skdzicombd/P_252_Documentation/Specifications/Datasheet Submitted to Client/252-0201-EMEL-CL00-0001 CABLE SCHEDULE/CABLE SCHEDULE P-252-J/P-252-J CABLE SCHEDULE 10.11.15.xlsx

Sheet: COVER
 |  |  |  |  |  | CONSORTIUM OF
 |  |  |  |  |  | SINOPEC PETROLEUM ENGINEERING CORPORATION.
 |  |  |  |  |  | AND
 |  |  |  |  |  | ZICOM EQUIPMENT PTE. LTD.
BANGLADESH GAS FIELDS COMPANY LIMITED
 |  |  |  |  |  | 29 Tuas Avenue 3 Singapore 639420 |  |  |  | Tel | : +65 6865 1765
 |  |  |  |  |  | E-mail | : zepl@zicomgroup.com |  |  | Fax | : +65 6865 1764
POWER CABLE SCHEDULE
 |  |  |  |  |  |  |  | Doc. No: | 252-0201-EMEL-CL00-0001
 |  | Job No. |  | : | 252 - J
 |  | Client |  | : | BANGLADESH GAS FIELDS COMPANY LIMITED
 |  | Location |  | : | TITAS GAS FIELD, BRAHMANBARIA, BANGLADESH
 |  | Item No. |  | :
 |  | Description |  | :
 |  | Project Title. |  | : | 2 X 75 MMSCFD GLYCOL DEHYDRATION TYPE GAS PROCESS PLANT
 |  | Year Built |  | : | 2015
A | 2015.10.28 |  |  | ISSUED FOR APPROVAL |  |  |  |  |  | AS | MH | VG
Rev. | Date |  | Page | Description |  |  |  |  |  | Prepared | Checked | Approved

Sheet: Power Cable Schedule
 |  |  |  |  | Power Cable Schedule
USER |  |  | BANGLADESH GAS FIELDS COMPANY LIMITED |  |  |  | DOC NO. : | 252-0201-EMEL-CL00-0001 |  |  |  | Rev : A
LOCATION |  |  | TITAS GAS FIELD, BRAHMANBARIA, BANGLADESH |  |  |  | SERVICE :
PROJECT |  |  | 2 X 75 MMSCFD GLYCOL DEHYDRATION TYPE GAS PROCESS PLANT |  |  |  | TAG NO. : | N/A
JOB NO. |  |  | 252 - J |  |  |  | QUANTITY: | N/A
Sl.No | TAG NO. | DISCRIPTION |  |  | SOURCE | DESTINATION | CABLE SIZE (sqmm) | CABLE LENGTH (Meter) | CABLE VOLTAGE | Power Factor (p.f) | CABLE TYPE | CONDUCTOR | LOAD
1 | G-01 | GENERATOR 01 |  |  | G1 | MCC | 8 (1C X 150mm2) | 220 | 600V | 0.85 | PVC ARMOURED | COPPER | 276 KW
2 | G-02 | GENERATOR 02 |  |  | G2 | MCC | 8 (1C X 150mm2) | 300 | 600V | 0.85 | PVC ARMOURED | COPPER | 276 KW
3 |  | NATIONAL GRID LINE |  |  | GRID LINE | MCC | 4C X 95mm2 | 90 | 600V | 0.85 | PVC ARMOURED | COPPER
4 | P-300A-J | CONDENSATE TRANSFER PUMP |  |  | MCC | P-300A-J | 4C X 4mm2 | 200 | 600V | 0.85 | PVC ARMOURED | COPPER | 11 KW
5 | P-300B-J | CONDENSATE TRANSFER PUMP |  |  | MCC | P-300B-J | 4C X 4mm2 | 200 | 600V | 0.85 | PVC ARMOURED | COPPER
6 | P-300A-J-LCS | CONDENSATE TRANSFER PUMP-LCS |  |  | MCC | P-300A-J-LCS | 12CX1.5mm2 | 200 | 600V | 0.85 | PVC ARMOURED | COPPER
7 | P-300B-J-LCS | CONDENSATE TRANSFER PUMP-LCS |  |  | MCC | P-300B-J-LCS | 12CX1.5mm2 | 200 | 600V | 0.85 | PVC ARMOURED | COPPER
8 | P-200A-J | CONDENSATE RECYCLE PUMP |  |  | MCC | P-200A-J | 4CX 2.5mm2 | 220 | 600V | 0.85 | PVC ARMOURED | COPPER | 1.5 KW
9 | P-200B-J | CONDENSATE RECYCLE PUMP |  |  | MCC | P-200B-J | 4CX 2.5mm2 | 220 | 600V | 0.85 | PVC ARMOURED | COPPER
10 | P-200A-J-LCS | CONDENSATE RECYCLE PUMP-LCS |  |  | MCC | P-200A-J | 12CX1.5mm2 | 220 | 600V | 0.85 | PVC ARMOURED | COPPER
11 | P-200B-J-LCS | CONDENSATE RECYCLE PUMP-LCS |  |  | MCC | P-200B-J | 12CX1.5mm2 | 220 | 600V | 0.85 | PVC ARMOURED | COPPER
12 | AC-100A-J | INLET AIR COOLER |  |  | MCC | AC-100A-J | 4C X10mm2 | 120 | 600V | 0.85 | PVC ARMOURED | COPPER | 15 KW
13 | AC-100B-J | INLET AIR COOLER |  |  | MCC | AC-100B-J | 4C X10mm2 | 120 | 600V | 0.85 | PVC ARMOURED | COPPER
14 | AC-100A-J-LCS | INLET AIR COOLER-LCS |  |  | MCC | AC-100A-J-LCS | 12CX1.5mm2 | 120 | 600V | 0.85 | PVC ARMOURED | COPPER
15 | AC-100B-J-LCS | INLET AIR COOLER-LCS |  |  | MCC | AC-100B-J-LCS | 12CX1.5mm2 | 120 | 600V | 0.85 | PVC ARMOURED | COPPER
16 | E-300-J | OVERHEAD GAS COOLER |  |  | MCC | E-300-J | 4CX 2.5mm2 | 120 | 600V | 0.85 | PVC ARMOURED | COPPER | 3 KW
17 | E-300-J-LCS | OVERHEAD GAS COOLER-LCS |  |  | MCC | E-300-J-LCS | 12CX1.5mm2 | 120 | 600V | 0.85 | PVC ARMOURED | COPPER
18 | P-400-J | KOD PUMP |  |  | MCC | P-400-J | 4CX 2.5mm2 | 320 | 600V | 0.85 | PVC ARMOURED | COPPER | 1.1 KW
19 | P-400-J-LCS | KOD PUMP-LCS |  |  | MCC | P-400-J-LCS | 12CX1.5mm2 | 320 | 600V | 0.85 | PVC ARMOURED | COPPER
20 | P-700-J | DEEP WELL PUMP |  |  | MCC | P-700-J | 4C X 4mm2 | 240 | 600V | 0.85 | PVC ARMOURED | COPPER | 7.5 KW
21 | P-700-J-LCS | DEEP WELL PUMP -LCS |  |  | MCC | P-700-J-LCS | 12CX1.5mm2 | 240 | 600V | 0.85 | PVC ARMOURED | COPPER
22 | P-700-J | PUMP TO CONTROL PANEL(Flat Cable) |  |  | PUMP CONTROL PANEL | PUMP | 2 (3C x 4 mm2) | 500 | 600V | 0.85 | PVC ARMOURED | COPPER
23 | P-800-J | DEEP WELL PUMP |  |  | MCC | P-800-J | 4C X 4mm2 | 240 | 600V | 0.85 | PVC ARMOURED | COPPER | 7.5 KW
24 | P-800-J-LCS | DEEP WELL PUMP -LCS |  |  | MCC | P-800-J-LCS | 12CX1.5mm2 | 240 | 600V | 0.85 | PVC ARMOURED | COPPER
25 | P-800-J | PUMP TO CONTROL PANEL(Flat Cable) |  |  | PUMP CONTROL PANEL | PUMP | 2 (3C x 4 mm2) | 500 | 600V | 0.85 | PVC ARMOURED | COPPER
26 | P-500A-J | ELECTRIC FIRE WATER PUMP |  |  | MCC | P-500A-J | 4C X 185mm2 | 220 | 600V | 0.85 | PVC ARMOURED | COPPER | 134 KW
27 | P-500A-J-LCS | ELECTRIC FIRE WATER PUMP-LCS |  |  | MCC | P-500A-J-LCS | 12CX1.5mm2 | 220 | 600V | 0.85 | PVC ARMOURED | COPPER
28 | P-500B-J | CONTROL PANEL DIESEL FIRE PUMP |  |  | MCC | P-500B-J | 4CX 2.5mm2 | 220 | 600V | 0.85 | PVC ARMOURED | COPPER | 0.5 KW
29 | P-600-J | JOCKEY PUMP CONTROL PANEL |  |  | MCC | P-600-J | 4CX 6mm2 | 220 | 600V | 0.85 | PVC ARMOURED | COPPER | 11 KW
30 | G-1201-P-J | GENERATOR-1 COOLING TOWER PUMP |  |  | MCC | G-1201-P-J | 4CX 4mm2 | 30 | 600V | 0.85 | PVC ARMOURED | COPPER | 5.5 KW
31 | G-1201-P-J-LCS | GENERATOR-1 COOLING TOWER PUMP-LCS |  |  | MCC | G-1201-P-J-LCS | 12CX1.5mm2 | 20 | 600V | 0.85 | PVC ARMOURED | COPPER
32 | G-1201-F-J | GENERATOR-1 COOLING TOWER FAN |  |  | MCC | G-1201-F-J | 4CX 4mm2 | 35 | 600V | 0.85 | PVC ARMOURED | COPPER | 5.5 KW
33 | G-1201-F-J-LCS | GENERATOR-1 COOLING TOWER FAN-LCS |  |  | MCC | G-1201-F-J-LCS | 12CX1.5mm2 | 20 | 600V | 0.85 | PVC ARMOURED | COPPER
34 | G-1202-P-J | GENERATOR-2 COOLING TOWER PUMP |  |  | MCC | G-1202-P-J | 4CX 4mm2 | 30 | 600V | 0.85 | PVC ARMOURED | COPPER | 5.5 KW
35 | G-1202-P-J-LCS | GENERATOR-2 COOLING TOWER PUMP-LCS |  |  | MCC | G-1202-P-J-LCS | 12CX1.5mm2 | 20 | 600V | 0.85 | PVC ARMOURED | COPPER
36 | G-1202-F-J | GENERATOR-2 COOLING TOWER FAN |  |  | MCC | G-1202-F-J | 4CX 4mm2 | 35 | 600V | 0.85 | PVC ARMOURED | COPPER | 5.5 KW
37 | G-1202-F-J-LCS | GENERATOR-2 COOLING TOWER FAN-LCS |  |  | MCC | G-1202-F-J-LCS | 12CX1.5mm2 | 20 | 600V | 0.85 | PVC ARMOURED | COPPER
38 |  | GENERATOR BATTERY CHARGER |  |  | MCC | BATT CHARGER | 3CX 2.5mm2 | 30 | 600V | 0.85 | PVC ARMOURED | COPPER
39 |  | UTILITY POWER OPERATION BUILDING |  |  | MCC | UTILITY POWER OPERATION BUILDING | 4CX 16mm2 | 90 | 600V | 0.85 | PVC ARMOURED | COPPER | 22 KW
40 |  | UTILITY POWER WORKSHOP BUILDING |  |  | MCC | UTILITY POWER WORKSHOP BUILDING | 4CX 6mm2 | 90 | 600V | 0.85 | PVC ARMOURED | COPPER | 10 KW
41 |  | UTILITY POWER GENERATOR BUILDING |  |  | MCC | UTILITY POWER GENERATOR BUILDING | 4CX 10mm2 | 30 | 600V | 0.85 | PVC ARMOURED | COPPER | 15 KW
42 | LCP-0701-J | FLARE & BURN PIT CONTROL PANEL |  |  | MCC | CONTROL PANEL | 4CX 2.5mm2 | 300 | 600V | 0.85 | PVC ARMOURED | COPPER | 3 KW
43 |  | FLARE PANEL |  |  | CONTROL PANEL | FLARE PANEL | 3CX 2.5mm2 | 40 | 600V | 0.85 | PVC ARMOURED | COPPER
44 |  | BURN PIT PANEL |  |  | CONTROL PANEL | BURN PIT PANEL | 3CX 2.5mm2 | 60 | 600V | 0.85 | PVC ARMOURED | COPPER
45 | LDP-1401-J | LIGHTING DISTRIBUTION PANEL |  |  | MCC | LIGHT PANEL | 5CX 10mm2 | 20 | 600V | 0.85 | PVC ARMOURED | COPPER | 15 KW
46 |  | TOWER LIGHT-1 (3 No. 200W light each pole) |  |  | LIGHT PANEL | TOWER LIGHT-1 | 3CX 2.5mm2 | 140 | 600V | 0.85 | PVC ARMOURED | COPPER | 0.6KW
47 |  | TOWER LIGHT-2 (3 No. 200W light each pole) |  |  | LIGHT PANEL | TOWER LIGHT-2 | 3CX 2.5mm2 | 90 | 600V | 0.85 | PVC ARMOURED | COPPER | 0.6KW
48 |  | TOWER LIGHT-3 (3 No. 200W light each pole) |  |  | LIGHT PANEL | TOWER LIGHT-3 | 3CX 2.5mm2 | 30 | 600V | 0.85 | PVC ARMOURED | COPPER | 0.6KW
49 |  | TOWER LIGHT-4 (3 No. 200W light each pole) |  |  | LIGHT PANEL | TOWER LIGHT-4 | 3CX 2.5mm2 | 120 | 600V | 0.85 | PVC ARMOURED | COPPER | 0.6KW
50 |  | TOWER LIGHT-5 (3 No. 200W light each pole) |  |  | LIGHT PANEL | TOWER LIGHT-5 | 3CX 2.5mm2 | 300 | 600V | 0.85 | PVC ARMOURED | COPPER | 0.6KW
51 |  | TOWER LIGHT-6 (3 No. 200W light each pole) |  |  | LIGHT PANEL | TOWER LIGHT-6 | 3CX 2.5mm2 | 260 | 600V | 0.85 | PVC ARMOURED | COPPER | 0.6KW
52 |  | PIPE RACK LIGHT-1 (8 No. 100W light) |  |  | LIGHT PANEL | PIPE RACK LIGHT-1 | 3CX 2.5mm2 | 280 | 600V | 0.85 | PVC ARMOURED | COPPER | 0.8KW
53 |  | PIPE RACK LIGHT-2 (8 No. 100W light) |  |  | LIGHT PANEL | PIPE RACK LIGHT-2 | 3CX 2.5mm2 | 280 | 600V | 0.85 | PVC ARMOURED | COPPER | 0.8KW
54 |  | TRANSFER PUMP SHED LIGHT (36W) |  |  | LIGHT PANEL | TRANSFER PUMP SHED LIGHT | 3CX 2.5mm2 | 240 | 600V | 0.85 | PVC ARMOURED | COPPER | 0.036 KW
55 |  | DELUGE VALVE & FOAM TANK (2 No.36W each light) |  |  | LIGHT PANEL | DELUGE VALVE & FOAM TANK | 3CX 2.5mm2 | 260 | 600V | 0.85 | PVC ARMOURED | COPPER | 0.072 KW
56 |  | TEG TOWER LIGHT (2 No. 100W light) |  |  | PIPE RACK LIGHT-2 | TEG TOWER | 3CX 2.5mm2 | 20 | 600V | 0.85 | PVC ARMOURED | COPPER | 0.2 KW
57 |  | AIR-CRAFT WARNING LIGHT(50W) |  |  | LIGHT PANEL | AIR-CRAFT WARNING LIGHT | 3CX 2.5mm2 | 420 | 600V | 0.85 | PVC ARMOURED | COPPER | 0.05 KW
58 |  | LOADING AREA SHED LIGHT (2 No. 200W each light) |  |  | LIGHT PANEL | LOADING AREA SHED LIGHT | 3CX 2.5mm2 | 70 | 600V | 0.85 | PVC ARMOURED | COPPER | 0.4KW
59 | R-100-J | GLYCOL REBOILER |  |  | MCC | GLYCOL REBOILER | 4CX 2.5mm2 | 140 | 600V | 0.85 | PVC ARMOURED | COPPER | 5 KW
60 | H-100-J | WATER BATH HEATER |  |  | MCC | WBH PANEL | 4CX 2.5mm2 | 140 | 600V | 0.85 | PVC ARMOURED | COPPER | 6 KW
61 | 02-UPS-1201-J | UPS SYSTEM 1 |  |  | MCC | UPS-1 | 3CX 4mm2 | 70 | 600V | 0.85 | PVC ARMOURED | COPPER | 6 KVA
62 | 02-UPS-1202-J | UPS SYSTEM 2 |  |  | MCC | UPS-2 | 3CX 4mm2 | 70 | 600V | 0.85 | PVC ARMOURED | COPPER | 6 KVA
63 | 02-UPS-1201 & 2-J | UPS-1&2-DB |  |  | UPS-1&2 | UPS-1&2-DB | 3CX 4mm2 | 10 | 600V | 0.85 | PVC ARMOURED | COPPER
64 |  | DCS PANEL |  |  | UPS-1&2-DB | DCS PANEL | 3CX 2.5mm2 | 30 | 600V | 0.85 | PVC ARMOURED | COPPER | 0.4KW
65 |  | ENGINEERING STATION |  |  | UPS-1&2-DB | ENG STATION | 3CX 2.5mm2 | 40 | 600V | 0.85 | PVC ARMOURED | COPPER | 0.4KW
66 |  | OPERATOR STATION |  |  | UPS-1&2-DB | OP STATION | 3CX 2.5mm2 | 40 | 600V | 0.85 | PVC ARMOURED | COPPER | 0.4KW
67 |  | MCC I/O RIO-001 |  |  | UPS-1&2-DB | MCC ROOM, | 3CX 2.5mm2 | 70 | 600V | 0.85 | PVC ARMOURED | COPPER | 0.25KW
68 |  | PLANT MIMIC PANEL |  |  | UPS-1&2-DB | PLANT MIMIC BOARD | 3CX 2.5mm2 | 50 | 600V | 0.85 | PVC ARMOURED | COPPER | 0.2KW
69 |  | INTERCOM SYSTEM |  |  | UPS-1&2-DB | INTERCOM SYSTEM | 3CX 2.5mm2 | 50 | 600V | 0.85 | PVC ARMOURED | COPPER | 0.05 KW
70 |  | WBH |  |  | UPS-1&2-DB | WBH | 3CX 2.5mm2 | 40 | 600V | 0.85 | PVC ARMOURED | COPPER | 0.2 KW
71 |  | REBOILER |  |  | UPS-1&2-DB | REBOILER | 3CX 2.5mm2 | 140 | 600V | 0.85 | PVC ARMOURED | COPPER | 0.2 KW
72 |  | FLARE CONTROL PANEL |  |  | UPS-1&2-DB | FLARE CONTROL | 3CX 2.5mm2 | 300 | 600V | 0.85 | PVC ARMOURED | COPPER | 0.2 KW
73 |  | PRINTER |  |  | UPS-1&2-DB | PRINTER | 3CX 2.5mm2 | 50 | 600V | 0.85 | PVC ARMOURED | COPPER | 0.05 KW
74 |  | LASER PRINTER |  |  | UPS-1&2-DB | LASER PRINTER | 3CX 2.5mm2 | 50 | 600V | 0.85 | PVC ARMOURED | COPPER | 0.1 KW
75 |  | UPS-3 |  |  | UPS-1&2-DB | UPS-3 | 3CX 2.5mm2 | 10 | 600V | 0.85 | PVC ARMOURED | COPPER | 1 KVA
76 |  | FLOW COMPUTER |  |  | UPS-1&2-DB | FLOW COMPUTER | 3CX 2.5mm2 | 40 | 600V | 0.85 | PVC ARMOURED | COPPER | 0.052 KW
77 | 02-UPS-1203-J | UPS (FIRE & GAS) |  |  | UPS-2 | UPS-3 | 3CX 2.5mm2 | 10 | 600V | 0.85 | PVC ARMOURED | COPPER | 1 KVA
78 |  | UPS-3-DB |  |  | UPS-3 | UPS-3-DB | 3CX 2.5mm2 | 10 | 600V | 0.85 | PVC ARMOURED | COPPER
79 |  | FIRE PANEL |  |  | UPS-3-DB | FIRE PANEL | 3CX 2.5mm2 | 30 | 600V | 0.85 | PVC ARMOURED | COPPER | 0.1 KW
80 |  | FIRE MIMIC PANEL |  |  | UPS-3-DB | FIRE MIMIC PANEL | 3CX 2.5mm2 | 30 | 600V | 0.85 | PVC ARMOURED | COPPER | 0.05 KW
81 |  | ALARM SYSTEM |  |  | UPS-3-DB | ALARM SYSTEM | 3CX 2.5mm2 | 30 | 600V | 0.85 | PVC ARMOURED | COPPER | 0.2 KW
82 |  | POWER SUPPLY |  |  | UPS-3-DB | POWER SUPPLY | 3CX 2.5mm2 | 30 | 600V | 0.85 | PVC ARMOURED | COPPER | 0.14 KW
83 | 02-UPS-1204-J | UPS (EMERGENCY LIGHTING) |  |  | MCC | UPS-4 | 3CX 2.5mm2 | 60 | 600V | 0.85 | PVC ARMOURED | COPPER | 2 KVA
84 |  | FIRE WATER PUMP SHED LIGHT (2set.72W each light) |  |  | LIGHT PANEL | FIRE WATER PUMP SHED LIGHT | 3CX 2.5mm2 | 160 | 600V | 0.85 | PVC ARMOURED | COPPER | 0.072 KW
85 |  | UPS-4-DB |  |  | UPS-4 | UPS-4-DB | 3CX 2.5mm2 | 10 | 600V | 0.85 | PVC ARMOURED | COPPER
86 |  | CONTROL ROOM |  |  | UPS-4-DB | CONTROL ROOM | 3CX 2.5mm2 | 50 | 600V | 0.85 | PVC ARMOURED | COPPER | 0.4 KW
87 |  | GENERATOR ROOM |  |  | UPS-4-DB | GENERATOR ROOM | 3CX 2.5mm2 | 60 | 600V | 0.85 | PVC ARMOURED | COPPER | 0.24 KW
88 |  | MCC ROOM |  |  | UPS-4-DB | MCC ROOM | 3CX 2.5mm2 | 60 | 600V | 0.85 | PVC ARMOURED | COPPER | 0.16 KW
89 |  | WORKSHOP BUILDING LIGHT |  |  | UPS-4-DB | WORKSHOP BUILDING | 3CX 2.5mm2 | 80 | 600V | 0.85 | PVC ARMOURED | COPPER | 0.24 KW
A | 2015.10.28 |  |  | ISSUED FOR APPROVAL |  |  |  |  |  |  | AS | MH | VG
REV | DATE |  |  | DESCRIPTION |  |  |  |  |  |  | PREPARED | CHECKED | APPROVED
