skdzicombd/P_252_Documentation/Specifications/P252 building fire system/P252 -BOQ.xlsx

P252 Location I & J
SL .No | Description | Quantity | Unit | Unit Price | Total Price
 |  |  |  | (SGD) | (SGD)
 | Fire detection system
1 | Fire Alarm Master Panel | 2 | Set
 | Model:
2 | Intelligent Photoelectric Smoke Detector with Base | 34 | Nos
 | Model:
3 | Addressable Manual Call Point | 14 | Nos
 | Model:
4 | Horn & Strobe (wall mounted) | 22 | Nos
 | Model:
5 | Supervised Output Module : | 6 | Sets
 | Model:
6 | Power Supply | 2 | Sets
 | Model:
7 | Commissioning of the whole system |  | Man day
 | 1 Hochiki And 1 Zicom Engineer
 | App 3 days per panel
 | Service Charges (Optional)
8 | Supervision of cable laying charges | TBA |  | 4000 Taka
9 | Installation of sensors and panels charges |  |  | 3000 Taka
Locally
SL .No | Description | Quantity | Unit | Unit Price | Total Price | Remarks | Brand
 |  |  |  | (BDT) | (BDT)
10 | Flame Retardant Signal Cable for initiating circuit and notification appliance |  | Meter | 23.42 |  | Red & Black | Paradise Cable Ltd
 | 1C X 1.5mm2 |  |  |  |  |  | BYA 1X1.5RM(FR)
11 | Power Cable for Fire & Annunciator Panel |  | Meter | 184.57 |  |  | Paradise Cable Ltd
 | 3CX2.5mm2 (Non-Armored) |  |  |  |  |  | NYY 3X2.5RM
12 | 20A MCB |  | No | 2000.00
13 | Accessories for Cable Laying
14 | 3/4 inch PVC Pipe |  | Meter | 20.00 |  |  | Electric pipe
15 | 3/4 inch hose pipe |  | Meter | 30.00
16 | Socket |  | Nos | 25.00
17 | Elbow |  | Nos | 30.00
18 | Sedel |  | Nos | 12.00
19 | 1” Screw |  | Dozen | 17.00
20 | Royal Plug |  | Packet | 14.00
21 | Transportation Cost
