skdzicombd/P_252_Documentation/Specifications/Documents Submitted To Romel Bhai/Cable P-252 I&J Electrical BOQ.xlsx

Sheet: P-252-I Power Cable
Power Cable BOQ 2 x 75 MMSCFD TEG DEHYDRATION TYPE NATURAL GAS PROCESS PLANT BGFCL
Sl.No | Category | Description of Materials | Quantity | Unit | Updated Length | Spec. | Remarks
24.0 | Power Cable
 |  | 3CX 2.5mm2 | 6260 |  |  | XLPE insulated, Multiwire stranded round conductor, Armoured.IEC Standard.
 |  | 3CX 4mm2 | 570
 |  | 4CX 2.5mm2 | 2630
 |  | 4CX 4mm2 | 600
 |  | 4CX 6mm2 | 1090
 |  | 4CX 10mm2 | 740
 |  | 4CX 16mm2 | 300
 |  | 12CX1.5mm2 | 3530
 |  | 3C x 4 mm2(Flat) | 1100 |  |  |  | BD for deep well pump
 |  | 1C X 150 mm2 | 700
 |  | 4C X 95 mm2 | 100
 |  | 4C x 185 mm2 | 240
 |  | 24C x 1.5 mm2 | 200

Sheet: P-252-J Power Cable
Power Cable BOQ 2 x 75 MMSCFD TEG DEHYDRATION TYPE NATURAL GAS PROCESS PLANT BGFCL
Sl.No | Category | Description of Materials | Quantity | Unit | Updated Length | Spec. | Remarks
24.0 | Power Cable
 |  | 3CX 2.5mm2 | 6100 |  |  | XLPE insulated, Multiwire stranded round conductor, Armoured.IEC Standard.
 |  | 3CX 4mm2 | 250
 |  | 4CX 2.5mm2 | 2330
 |  | 4CX 4mm2 | 840
 |  | 4CX 6mm2 | 970
 |  | 4CX 10mm2 | 410
 |  | 4CX 16mm2 | 220
 |  | 12CX1.5mm2 | 3360
 |  | 3C x 4 mm2(Flat) | 1100 |  |  |  | BD for deep well pump
 |  | 1C X 150 mm2 | 680
 |  | 4C X 95 mm2 | 110
 |  | 4C x 185 mm2 | 290
