skdzicombd/P_252_Documentation/Specifications/Datasheet Submitted to Client/252-0214-EMEL-CS00-0001 GENERATOR SIZING/252-0314-EMEL-CS00-0001 GENERATOR SIZING_LOCATION J.xlsx

Sheet: COVER
 |  |  |  |  |  | CONSORTIUM OF
 |  |  |  |  |  | SINOPEC PETROLEUM ENGINEERING CORPORATION.
 |  |  |  |  |  | AND
 |  |  |  |  |  | ZICOM EQUIPMENT PTE. LTD.
BANGLADESH GAS FIELDS COMPANY LIMITED.
 |  |  |  |  |  | 29 Tuas Avenue 3 Singapore 639420 |  |  |  | Tel | : +65 6865 1765
 |  |  |  |  |  | E-mail | : zepl@zicomgroup.com |  |  | Fax | : +65 6865 1764
ELECTRICAL CALCULATION SHEET
 |  |  |  |  |  |  |  | Doc. No: | 252-07-CCS-001
 |  | Job No. |  | : | 252
 |  | Client |  | : | BANGLADESH GAS FIELDS COMPANY LIMITED
 |  | Location |  | : | TITAS GAS FIELD, BRAHMANBARIA,BANGLADESH
 |  | Item No. |  | : | -
 |  | Description |  | : | ELECTRICAL LOAD CALCULATION
 |  | Project Title. |  | : | 2 x 75 MMSCFD GLYCOL DEHYDRATION TYPE GAS PROCESS PLANT
 |  | Year Built |  | : | 2014
A | 2015.10.28 |  | 2 | ISSUED FOR BIDDING |  |  |  |  |  | AS | MH | VG
Rev. | Date |  | Page | Description of Revision |  |  |  |  |  | Prepared | Checked | Approved

Sheet: Generator Sizing
 |  |  |  |  | GENERATOR SIZING
USER |  |  | BANGLADESH GAS FIELDS COMPANY LIMITED |  |  |  | DOC NO. | 240-07-CCS-001 |  | REV : A
LOCATION |  |  | TITAS GAS FIELD, BRAHMANBARIA, BANGLADESH |  |  |  | SERVICE | LOAD CALCULATION
PROJECT |  |  | 2 x 75 MMSCFD GLYCOL DEHYDRATION TYPE GAS PROCESS PLANT |  |  |  | TAG NO. | N/A
JOB NO. |  |  | 252 | LOCATION J |  |  | QUANTITY | N/A
S/L | EQUIPMENT |  | EQUIPMENT |  | VOLTAGE RATING | DESCRIPTION | QTY | CONNECTED LOAD | OPERATING LOAD | REMARKS
 | TAG No.
 | PLANT STARTER RACK :
1 | P-300A-J |  | CONDENSATE TRANSFER PUMP |  | 400 VAC |  | 1 | 5500 W | 5500 W
2 | P-300B-J |  |  |  | 400 VAC |  | 1 | 5500 W
3 | P-200A-J |  | CONDENSATE RECYCLE PUMP |  | 400 VAC |  | 1 | 1500 W | 1500 W
4 | P-200B-J |  |  |  | 400 VAC |  | 1 | 1500 W
5 | AC-100A-J |  | INLET AIR COOLER |  | 400 VAC |  | 1 | 15000 W | 15000 W
6 | AC-100B-J |  |  |  | 400 VAC |  | 1 | 15000 W
7 | E-300-J |  | OVERHEAD GAS COOLER |  | 400 VAC |  | 1 | 3000 W | 3000 W
8 | P-400-J |  | KOD PUMP |  | 400 VAC |  | 1 | 1100 W | 1100 W
9 | P-700-J |  | DEEP WELL PUMP |  | 400 VAC |  | 1 | 7500 W | 7500 W
10 | P-800-J |  | DEEP WELL PUMP |  | 400 VAC |  | 1 | 7500 W | 7500 W
11 | P-500A-J |  | ELECTRIC FIRE WATER PUMP |  | 400 VAC |  | 1 | 134000 W | 134000 W
12 | P-500B-J |  | CONTROL PANEL DIESEL FIRE PUMP |  | 230 VAC |  | 1 | 500 W | 500 W
13 | P-600-J |  | JOCKEY PUMP CONTROL PANEL |  | 400 VAC |  | 1 | 11000 W | 11000 W
14 | LCP-0701-J |  | FLARE & BURN PIT CONTROL PANEL |  | 230 VAC |  | 1 | 3000 W | 500 W
15 | LDP-1401-J |  | LIGHTING DISTRIBUTION PANEL |  | 400 VAC |  | 1 | 15000 W | 6000 W
16 | R-100-J |  | GLYCOL REBOILER |  | 400 VAC |  | 1 | 5000 W | 5000 W
17 | H-100-J |  | WATER BATH HEATER |  | 400 VAC |  | 1 | 6000 W | 200 W
18 | UPS-1-J |  | UPS SYSTEM-1 |  | 230 VAC |  | 1 | 4800 W | 2500 W
19 | UPS-2-J |  | UPS SYSTEM-2 |  | 230 VAC |  | 1 | 4800 W
20 | UPS-3-J |  | UPS FOR FIRE & GAS SYSTEM |  | 230 VAC |  | 1 | 800 W | 100 W
21 | UPS-4-J |  | UPS FOR EMERGENCY LIGHTING |  | 230 VAC |  | 1 | 1600 W | 1200 W
22 | UPOB-J |  | UTILITY POWER OPERATION BUILDING |  | 400 VAC |  | 1 | 22000 W | 18000 W
23 | UPWB-J |  | UTILITY POWER WORKSHOP BUILDING |  | 400 VAC |  | 1 | 10000 W | 8000 W
24 | UPGB-J |  | UTILITY POWER GENERATOR BUILDING |  | 400 VAC |  | 1 | 15000 W | 12000 W
 |  |  |  |  |  |  |  | Total: | 240100 W
 |  |  |  |  |  |  |  |  | 240.1 kW
 |  | Total Load in Kw= |  |  | 240.1 kW
 |  | Base load =70% of Load= |  |  | 168.07 kW
 |  | Considering 100kW Plus Power Required= |  |  | 268.07 kW
 |  | Next Available Selected Generator Size= |  |  | 276 kW
A | 2015.10.28 |  |  | ISSUED FOR APPROVAL |  |  |  | AS | MH | VG
REV | DATE |  |  | DESCRIPTION OF REVISION |  |  |  | PREPARED | CHECKED | APPROVED
