skdzicombd/P_252_Documentation/Location I/BOQ/P-252-I CABLE SIZING & BOQ 17.11.15.xlsx

Sheet: COVER
 |  |  |  |  |  | CONSORTIUM OF
 |  |  |  |  |  | SINOPEC PETROLEUM ENGINEERING CORPORATION.
 |  |  |  |  |  | AND
 |  |  |  |  |  | ZICOM EQUIPMENT PTE. LTD.
BANGLADESH GAS FIELDS COMPANY LIMITED
 |  |  |  |  |  | 29 Tuas Avenue 3 Singapore 639420 |  |  | Tel | : +65 6865 1765
 |  |  |  |  |  | E-mail | : zepl@zicomgroup.com |  | Fax | : +65 6865 1764
ELECTRICAL CALCULATION SHEET
 |  |  |  |  |  |  |  | Doc. No:
 |  | Job No. |  | : | 252-I
 |  | Client |  | : | BANGLADESH GAS FIELDS COMPANY LIMITED
 |  | Location |  | : | TITAS GAS FIELD, BRAHMANBARIA, BANGLADESH
 |  | Item No. |  | : | -
 |  | Description |  | : | ELECTRICAL LOAD CALCULATION
 |  | Project Title. |  | : | 2 X 75 MMSCFD GLYCOL DEHYDRATION TYPE GAS PROCESS PLANT
 |  | Year Built |  | : | 2015
Rev. | Date |  | Page | Description of Revision |  |  |  |  | Prepared | Checked | Approved

Sheet: Cable Sizing
 |  |  |  |  | CABLE SIZING
USER |  |  | BANGLADESH GAS FIELDS COMPANY LIMITED |  |  |  | DOC NO. |  |  | REV :
LOCATION |  |  | TITAS GAS FIELD, BRAHMANBARIA, BANGLADESH |  |  |  | SERVICE
PROJECT |  |  | 2 X 75 MMSCFD GLYCOL DEHYDRATION TYPE GAS PROCESS PLANT |  |  |  | TAG NO. | N/A
JOB NO. |  |  | 252 | LOCATION: I |  |  | QUANTITY | N/A
Sl.No | TAG NO. | DISCRIPTION |  |  | CABLE SIZE (sqmm) | FROM | TO | CABLE LENGTH (METER) | KW | Cable type | REMARKS
 | G-01 | GENERATOR 01 |  |  | 1C X 150mm2 | G1 | MCC | 240 | 276 KW
 | G-02 | GENERATOR 02 |  |  | 1C X 150mm2 | G2 | MCC | 300 | 276 KW
 | MCC PANEL CONNECTION |  |  |  | 1C X 150mm2 | MCC 1 | MCC 2 | 100
 |  | NATIONAL GRID LINE |  |  | 4C X 95mm2 | GRID LINE | MCC | 90
 | P-300A-I | CONDENSATE TRANSFER PUMP |  |  | 4C X 6mm2 | MCC | P-300A-I | 280 | 11 KW
 | P-300B-I | CONDENSATE TRANSFER PUMP |  |  | 4C X 6mm2 | MCC | P-300B-I | 280
 | P-300A-I-LCS | CONDENSATE TRANSFER PUMP-LCS |  |  | 12CX1.5mm2 | MCC | P-300A-I-LCS | 280
 | P-300B-I-LCS | CONDENSATE TRANSFER PUMP-LCS |  |  | 12CX1.5mm2 | MCC | P-300B-I-LCS | 280
 | P-200A-I | CONDENSATE RECYCLE PUMP |  |  | 4CX 2.5mm2 | MCC | P-200A-I | 250 | 1.5 KW
 | P-200B-I | CONDENSATE RECYCLE PUMP |  |  | 4CX 2.5mm2 | MCC | P-200B-I | 250
 | P-200A-I-LCS | CONDENSATE RECYCLE PUMP-LCS |  |  | 12CX1.5mm2 | MCC | P-200A-I | 250
 | P-200B-I-LCS | CONDENSATE RECYCLE PUMP-LCS |  |  | 12CX1.5mm2 | MCC | P-200B-I | 250
 | AC-100A-I | INLET AIR COOLER |  |  | 4C X10mm2 | MCC | AC-100A-I | 320 | 15 KW
 | AC-100B-I | INLET AIR COOLER |  |  | 4C X10mm2 | MCC | AC-100B-I | 320
 | AC-100A-I-LCS | INLET AIR COOLER-LCS |  |  | 12CX1.5mm2 | MCC | AC-100A-I-LCS | 320
 | AC-100B-I-LCS | INLET AIR COOLER-LCS |  |  | 12CX1.5mm2 | MCC | AC-100B-I-LCS | 320
 | E-300-I | OVERHEAD GAS COOLER |  |  | 4CX 2.5mm2 | MCC | E-300-I | 340 | 3 KW
 | E-300-I-LCS | OVERHEAD GAS COOLER-LCS |  |  | 12CX1.5mm2 | MCC | E-300-I-LCS | 340
 | P-400-I | KOD PUMP |  |  | 4CX 2.5mm2 | MCC | P-400-I | 230 | 1.1 KW
 | P-400-I-LCS | KOD PUMP-LCS |  |  | 12CX1.5mm2 | MCC | P-400-I-LCS | 230
 | P-700-I | DEEP WELL PUMP |  |  | 4C X 4mm2 | MCC | P-700-I | 170 | 7.5 KW
 | P-700-I-LCS | DEEP WELL PUMP -LCS |  |  | 12CX1.5mm2 | MCC | P-700-I-LCS | 170
 | P-700-I | PUMP TO CONTROL PANEL(Flat Cable) |  |  | 2 (3C x 4 mm2) | PUMP CONTROL PANEL | PUMP | 500
 | P-800-I | DEEP WELL PUMP |  |  | 4C X 4mm2 | MCC | P-800-I | 180 | 7.5 KW
 | P-800-I-LCS | DEEP WELL PUMP -LCS |  |  | 12CX1.5mm2 | MCC | P-800-I-LCS | 180
 | P-800-I | PUMP TO CONTROL PANEL(Flat Cable) |  |  | 2 (3C x 4 mm2) | PUMP CONTROL PANEL | PUMP | 500
 | P-500A-I | ELECTRIC FIRE WATER PUMP |  |  | 4C X 185mm2 | MCC | P-500A-I | 210 | 134 KW
 | P-500A-I-LCS | ELECTRIC FIRE WATER PUMP-LCS |  |  | 12CX1.5mm2 | MCC | P-500A-I-LCS | 210
 | P-500B-I | CONTROL PANEL DIESEL FIRE PUMP |  |  | 4CX 2.5mm2 | MCC | P-500B-I | 210 | 0.5 KW
 | P-600-I | JOCKEY PUMP CONTROL PANEL |  |  | 4CX 6mm2 | MCC | P-600-I | 210 | 11 KW
 | G-1201-P-I | GENERATOR-1 COOLING TOWER PUMP |  |  | 4CX 4mm2 | MCC | G-1201-P-I | 50 | 5.5 KW
 | G-1201-P-I-LCS | GENERATOR-1 COOLING TOWER PUMP-LCS |  |  | 12CX1.5mm2 | MCC | G-1201-P-I-LCS | 50
 | G-1201-F-I | GENERATOR-1 COOLING TOWER FAN |  |  | 4CX 4mm2 | MCC | G-1201-F-I | 50 | 5.5 KW
 | G-1201-F-I-LCS | GENERATOR-1 COOLING TOWER FAN-LCS |  |  | 12CX1.5mm2 | MCC | G-1201-F-I-LCS | 50
 | G-1202-P-I | GENERATOR-2 COOLING TOWER PUMP |  |  | 4CX 4mm2 | MCC | G-1202-P-I | 50 | 5.5 KW
 | G-1202-P-I-LCS | GENERATOR-2 COOLING TOWER PUMP-LCS |  |  | 12CX1.5mm2 | MCC | G-1202-P-I-LCS | 50
 | G-1202-F-I | GENERATOR-2 COOLING TOWER FAN |  |  | 4CX 4mm2 | MCC | G-1202-F-I | 50 | 5.5 KW
 | G-1202-F-I-LCS | GENERATOR-2 COOLING TOWER FAN-LCS |  |  | 12CX1.5mm2 | MCC | G-1202-F-I-LCS | 50
 |  | GENERATOR BATTERY CHARGER |  |  | 3CX 2.5mm2 | MCC | BATT CHARGER | 30
 |  | UTILITY POWER OPERATION BULDING |  |  | 4CX 16mm2 | MCC | UTILITY POWER OPERATION BULDING | 250 | 22 KW
 |  | UTILITY POWER WORKSHOP BULDING |  |  | 4CX 6mm2 | MCC | UTILITY POWER WORKSHOP BULDING | 220 | 10KW
 |  | UTILITY POWER GENERATOR BULDING |  |  | 4CX 10mm2 | MCC | UTILITY POWER GENERATOR BULDING | 30 | 15 KW
 | LCP-0701-I | FLARE & BURN PIT CONTROL PANEL |  |  | 4CX 2.5mm2 | MCC | CONTROL PANEL | 200 | 3 KW
 |  | FLARE PANEL |  |  | 3CX 2.5mm2 | CONTROL PANEL | FLARE PANEL | 50
 |  | BURN PIT PANEL |  |  | 3CX 2.5mm2 | CONTROL PANEL | BURN PIT PANEL | 60
 | LDP-1401-I | LIGHTING DISTRIBUTION PANEL |  |  | 4CX 16mm2 | MCC | LIGHT PANEL | 20 | 15 KW
 |  | TOWER LIGHT-1 (3 No. 200W light each pole) |  |  | 3CX 2.5mm2 | LIGHT PANEL | TOWER LIGHT-1 | 340 | 0.6KW
 |  | TOWER LIGHT-2 (3 No. 200W light each pole) |  |  | 3CX 2.5mm2 | LIGHT PANEL | TOWER LIGHT-2 | 290 | 0.6KW
 |  | TOWER LIGHT-3 (3 No. 200W light each pole) |  |  | 3CX 2.5mm2 | LIGHT PANEL | TOWER LIGHT-3 | 250 | 0.6KW
 |  | TOWER LIGHT-4 (3 No. 200W light each pole) |  |  | 3CX 2.5mm2 | LIGHT PANEL | TOWER LIGHT-4 | 190 | 0.6KW
 |  | TOWER LIGHT-5 (3 No. 200W light each pole) |  |  | 3CX 2.5mm2 | LIGHT PANEL | TOWER LIGHT-5 | 230 | 0.6KW
 |  | TOWER LIGHT-6 (3 No. 200W light each pole) |  |  | 3CX 2.5mm2 | LIGHT PANEL | TOWER LIGHT-6 | 70 | 0.6KW
 |  | TOWER LIGHT INTERNAL WIRING |  |  | 3CX 2.5mm2 | LIGHT | TOWER JB | 200
 |  | PIPE RACK LIGHT-1 (8 No. 100W light) |  |  | 3CX 2.5mm2 | LIGHT PANEL | PIPE RACK LIGHT-1 | 280 | 0.8KW
 |  | PIPE RACK LIGHT-2(8 No. 100W light) |  |  | 3CX 2.5mm2 | LIGHT PANEL | PIPE RACK LIGHT-2 | 280 | 0.8KW
 |  | TRANSFER PUMP SHED LIGHT (2 No.36W each light) |  |  | 3CX 2.5mm2 | LIGHT PANEL | TRANSFER PUMP SHED LIGHT | 250 | 72 W
 |  | RECYCLE PUMP SHED LIGHT (2 No.36W each light) |  |  | 3CX 2.5mm2 | LIGHT PANEL | RECYCLE PUMP SHED LIGHT | 220 | 72 W
 |  | TEG TOWER LIGHT (2 No. 100W light) |  |  | 3CX 2.5mm2 | PIPE RACK LIGHT-2 | TEG TOWER | 20 | 200 W
 |  | AIR-CRAFT WARNING LIGHT(50W) |  |  | 3CX 2.5mm2 | LIGHT PANEL | AIR-CRAFT WARNING LIGHT | 260 | 50 W
 |  | LOADING AREA SHED LIGHT (2 No. 200W each light) |  |  | 3CX 2.5mm2 | LIGHT PANEL | LOADING AREA SHED LIGHT | 120 | 0.6KW
 | R-100-I | GLYCOL REBOILER (5kw) |  |  | 4CX 2.5mm2 | MCC | GLYCOL REBOILER | 260 | 5 KW
 | H-100-I | WATER BATH HEATER |  |  | 4CX 2.5mm2 | MCC | WBH PANEL | 250 | 6 KW
 |  | INSTRUMENT CABLE |  |  | 24CX 1.5mm2 | WBH PANEL | WATER BATH HEATER | 180
 |  | INSTRUMENT CABLE |  |  | 12CX 1.5mm2 | WBH PANEL | WATER BATH HEATER | 180
 |  | BLOWER FOR WBH |  |  | 4CX 2.5mm2 | WBH PANEL | WATER BATH HEATER | 400
 | 02-UPS-1201-I | UPS SYSTEM 1 |  |  | 3CX 4mm2 | MCC | UPS-1 | 250 | 6 KVA
 | 02-UPS-1202-I | UPS SYSTEM 2 |  |  | 3CX 4mm2 | MCC | UPS-2 | 250 | 6 KVA
 | 02-UPS-1201 & 2-I | UPS-1&2-DB |  |  | 3CX 4mm2 | UPS-1&2 | UPS-1&2-DB | 20
 |  | DCS PANEL |  |  | 3CX 2.5mm2 | UPS-1&2-DB | DCS PANEL | 50 | 0.4KW
 |  | ENGINEERING STATION |  |  | 3CX 2.5mm2 | UPS-1&2-DB | ENG STATION | 50 | 0.4KW
 |  | OPERATOR STATION |  |  | 3CX 2.5mm2 | UPS-1&2-DB | OP STATION | 50 | 0.4KW
 |  | MCC I/O RIO-001 |  |  | 3CX 2.5mm2 | UPS-1&2-DB | MCC ROOM, | 100 | 0.25KW
 |  | PLANT MIMIC PANEL |  |  | 3CX 2.5mm2 | UPS-1&2-DB | PLANT MIMIC BOARD | 50 | 0.2KW
 |  | INTERCOM SYSTEM |  |  | 3CX 2.5mm2 | UPS-1&2-DB | INTERCOM SYSTEM | 50 | 0.05 KW
 |  | WBH |  |  | 3CX 2.5mm2 | UPS-1&2-DB | WBH | 40 | 0.2 KW
 |  | REBOILER |  |  | 3CX 2.5mm2 | UPS-1&2-DB | REBOILER | 160 | 0.2 KW
 |  | FLARE CONTROL PANEL |  |  | 3CX 2.5mm2 | UPS-1&2-DB | FLARE CONTROL | 370 | 0.2 KW
 |  | PRINTER |  |  | 3CX 2.5mm2 | UPS-1&2-DB | PRINTER | 50 | 0.05 KW
 |  | LASER PRINTER |  |  | 3CX 2.5mm2 | UPS-1&2-DB | LASER PRINTER | 50 | 0.1 KW
 |  | UPS-3 |  |  | 3CX 2.5mm2 | UPS-1&2-DB | UPS-3 | 10 | 1 KVA
 |  | FLOW COMPUTER |  |  | 3CX 2.5mm2 | UPS-1&2-DB | FLOW COMPUTER | 40 | 0.052 KW
 | 02-UPS-1203-J | UPS (FIRE & GAS) |  |  | 3CX 2.5mm2 | UPS-2 | UPS-3 | 10 | 1 KVA
 | 02-UPS-1203-J | UPS-3-DB |  |  | 3CX 2.5mm2 | UPS-3 | UPS-3-DB | 10
 |  | FIRE PANEL |  |  | 3CX 2.5mm2 | UPS-3-DB | FIRE PANEL | 50 | 0.1 KW
 |  | FIRE MIMIC PANEL |  |  | 3CX 2.5mm2 | UPS-3-DB | FIRE MIMIC PANEL | 50 | 0.05 KW
 |  | ALARM SYSTEM |  |  | 3CX 2.5mm2 | UPS-3-DB | ALARM SYSTEM | 50 | 0.2 KW
 |  | POWER SUPPLY |  |  | 3CX 2.5mm2 | UPS-3-DB | POWER SUPPLY | 50 | 0.14 KW
 | 02-UPS-1204-J | UPS (EMERGENCY LIGHTING) |  |  | 3CX 2.5mm2 | MCC | UPS-4 | 180 | 2 KVA
 |  | FIRE WATER PUMP SHED LIGHT (2set.72W each light) |  |  | 3CX 2.5mm2 | LIGHT PANEL | FIRE WATER PUMP SHED LIGHT | 250 | 0.072 KW
 |  | UPS-4-DB |  |  | 3CX 2.5mm2 | UPS-4 | UPS-4-DB | 10
 |  | CONTROL ROOM |  |  | 3CX 2.5mm2 | UPS-4-DB | CONTROL ROOM | 50 | 0.4 KW
 |  | GENERATOR ROOM |  |  | 3CX 2.5mm2 | UPS-4-DB | GEN ROOM | 250 | 0.24 KW
 |  | MCC ROOM |  |  | 3CX 2.5mm2 | UPS-4-DB | MCC ROOM | 250 | 0.16 KW
 |  | WORKSHOP BUILDING LIGHT |  |  | 3CX 2.5mm2 | UPS-4-DB | WORKSHOP BUILD. | 100 | 0.24 KW
 |  | FIRE WATER PUMP SHED |  |  | 3CX 2.5mm2 | UPS-4-DB | FIRE PUMP SHED | 200 | 0.072 KW
 | E-300 | COOLER COOLING FAN MOTOR POWER |  |  | 3C X 2.5mm2 | MCC | E-300 | 340 | 0.25 KW
REV | DATE |  |  | DESCRIPTION OF REVISION |  |  |  | PREPARED | CHECKED | APPROVED

Sheet: Cable length details
 |  |  |  |  | CABLE LENGTH DETAILS
USER |  |  | BANGLADESH GAS FIELDS COMPANY LIMITED |  |  |  | DOC NO. |  |  | REV :
LOCATION |  |  | TITAS GAS FIELD, BRAHMANBARIA, BANGLADESH |  |  |  | SERVICE
PROJECT |  |  | 2 X 75 MMSCFD GLYCOL DEHYDRATION TYPE GAS PROCESS PLANT |  |  |  | TAG NO. | N/A
JOB NO. |  |  | 252 | LOCATION: I |  |  | QUANTITY | N/A
Sl.No | TAG NO. | DISCRIPTION |  |  | CABLE SIZE (sqmm) | FROM | TO | CABLE LENGTH (METER) |  | Cable type | REMARKS
 | G-01 | GENERATOR 01 |  |  | 1C X 150mm2 | G1 | MCC | 240
 | G-02 | GENERATOR 02 |  |  | 1C X 150mm2 | G2 | MCC | 300
 | MCC PANEL CONNECTION |  |  |  | 1C X 150mm2 | MCC 1 | MCC 2 | 100
 |  | TOTAL |  |  | 1C X 150mm2 |  |  | 640
 | GRID | NATIONAL GRID LINE |  |  | 4C X 95mm2 | GRID LINE | MCC | 90
 | AC-100A-I | INLET AIR COOLER |  |  | 4C X10mm2 | MCC | AC-100A-I | 320
 | AC-100B-I | INLET AIR COOLER |  |  | 4C X10mm2 | MCC | AC-100B-I | 320
 |  | UTILITY POWER GENERATOR BUILDING |  |  | 4CX 10mm2 | MCC | UTILITY POWER GENERATOR BULDING | 30
 |  | TOTAL |  |  | 4C X10mm2 |  |  | 670
 |  | UTILITY POWER OPERATION BULDING |  |  | 4CX 16mm2 | MCC | UTILITY POWER OPERATION BULDING | 250
 |  | LIGHTING DISTRIBUTION PANEL |  |  | 4CX 16mm2 | MCC | LIGHT PANEL | 20
 |  | TOTAL |  |  | 4C X 16mm2 |  |  | 270
 | P-300A-I | CONDENSATE TRANSFER PUMP |  |  | 4C X 6mm2 | MCC | P-300A-I | 280
 | P-300B-I | CONDENSATE TRANSFER PUMP |  |  | 4C X 6mm2 | MCC | P-300B-I | 280
 | P-600-I | JOCKEY PUMP CONTROL PANEL |  |  | 4CX 6mm2 | MCC | P-600-I | 210
 |  | UTILITY POWER WORKSHOP BULDING |  |  | 4CX 6mm2 | MCC | UTILITY POWER WORKSHOP BULDING | 220
 |  | TOTAL |  |  | 4C X 6mm2 |  |  | 990
 | P-700-I | DEEP WELL PUMP |  |  | 4C X 4mm2 | MCC | P-700-I | 170
 | G-1201-P-I | GENERATOR-1 COOLING TOWER PUMP |  |  | 4CX 4mm2 | MCC | G-1201-P-I | 50
 | G-1201-F-I | GENERATOR-1 COOLING TOWER FAN |  |  | 4CX 4mm2 | MCC | G-1201-F-I | 50
 | G-1202-P-I | GENERATOR-2 COOLING TOWER PUMP |  |  | 4CX 4mm2 | MCC | G-1202-P-I | 50
 | G-1202-F-I | GENERATOR-2 COOLING TOWER FAN |  |  | 4CX 4mm2 | MCC | G-1202-F-I | 50
 | P-800-I | DEEP WELL PUMP |  |  | 4C X 4mm2 | MCC | P-800-I | 180
 |  | TOTAL |  |  | 4C X 4mm2 |  |  | 550
 | P-200A-I | CONDENSATE RECYCLE PUMP |  |  | 4CX 2.5mm2 | MCC | P-200A-I | 250
 | P-200B-I | CONDENSATE RECYCLE PUMP |  |  | 4CX 2.5mm2 | MCC | P-200B-I | 250
 | E-300-I | OVERHEAD GAS COOLER |  |  | 4CX 2.5mm2 | MCC | E-300-I | 340
 | P-400-I | KOD PUMP |  |  | 4CX 2.5mm2 | MCC | P-400-I | 230
 | P-500B-I | CONTROL PANEL DIESEL FIRE PUMP |  |  | 4CX 2.5mm2 | MCC | P-500B-I | 210
 | LCP-0701-I | FLARE & BURN PIT CONTROL PANEL |  |  | 4CX 2.5mm2 | MCC | CONTROL PANEL | 200
 | R-100-I | GLYCOL REBOILER (5kw) |  |  | 4CX 2.5mm2 | MCC | GLYCOL REBOILER | 260
 | H-100-I | WATER BATH HEATER (6 KW) X 2.5 |  |  | 4CX 2.5mm2 | MCC | WBH PANEL | 250
 |  | BLOWER FOR WBH |  |  | 4CX 2.5mm2 | WBH PANEL | WATER BATH HEATER | 400
 |  | TOTAL |  |  | 4CX 2.5mm2 |  |  | 2390
 | P-300A-I-LCS | CONDENSATE TRANSFER PUMP-LCS |  |  | 12CX1.5mm2 | MCC | P-300A-I-LCS | 280
 | P-300B-I-LCS | CONDENSATE TRANSFER PUMP-LCS |  |  | 12CX1.5mm2 | MCC | P-300B-I-LCS | 280
 | P-200A-I-LCS | CONDENSATE RECYCLE PUMP-LCS |  |  | 12CX1.5mm2 | MCC | P-200A-I | 250
 | P-200B-I-LCS | CONDENSATE RECYCLE PUMP-LCS |  |  | 12CX1.5mm2 | MCC | P-200B-I | 250
 | AC-100A-I-LCS | INLET AIR COOLER-LCS |  |  | 12CX1.5mm2 | MCC | AC-100A-I-LCS | 320
 | AC-100B-I-LCS | INLET AIR COOLER-LCS |  |  | 12CX1.5mm2 | MCC | AC-100B-I-LCS | 320
 | E-300-I-LCS | OVERHEAD GAS COOLER-LCS |  |  | 12CX1.5mm2 | MCC | E-300-I-LCS | 340
 | P-400-I-LCS | KOD PUMP-LCS |  |  | 12CX1.5mm2 | MCC | P-400-I-LCS | 230
 | P-700-I-LCS | DEEP WELL PUMP -LCS |  |  | 12CX1.5mm2 | MCC | P-700-I-LCS | 170
 | P-800-I-LCS | DEEP WELL PUMP -LCS |  |  | 12CX1.5mm2 | MCC | P-800-I-LCS | 180
 | P-500A-I-LCS | ELECTRIC FIRE WATER PUMP-LCS |  |  | 12CX1.5mm2 | MCC | P-500A-I-LCS | 210
 | G-1201-P-I-LCS | GENERATOR-1 COOLING TOWER PUMP-LCS |  |  | 12CX1.5mm2 | MCC | G-1201-P-I-LCS | 50
 | G-1201-F-I-LCS | GENERATOR-1 COOLING TOWER FAN-LCS |  |  | 12CX1.5mm2 | MCC | G-1201-F-I-LCS | 50
 | G-1202-P-I-LCS | GENERATOR-2 COOLING TOWER PUMP-LCS |  |  | 12CX1.5mm2 | MCC | G-1202-P-I-LCS | 50
 | G-1202-F-I-LCS | GENERATOR-2 COOLING TOWER FAN-LCS |  |  | 12CX1.5mm2 | MCC | G-1202-F-I-LCS | 50
 |  | INSTRUMENT CABLE |  |  | 12CX 1.5mm2 | WBH PANEL | WATER BATH HEATER | 180
 |  | TOTAL |  |  | 12C X 1.5mm2 |  |  | 3210
 | P-700-I | PUMP TO CONTROL PANEL(Flat Cable) |  |  | 2 (3C x 4 mm2) | PUMP CONTROL PANEL | PUMP | 500
 | P-800-I | PUMP TO CONTROL PANEL(Flat Cable) |  |  | 2 (3C x 4 mm2) | PUMP CONTROL PANEL | PUMP | 500
 |  | TOTAL |  |  | 2 (3C x 4 mm2) |  |  | 1000
 | 02-UPS-1201-I | UPS SYSTEM 1 |  |  | 3CX 4mm2 | MCC | UPS-1 | 250
 | 02-UPS-1202-I | UPS SYSTEM 2 |  |  | 3CX 4mm2 | MCC | UPS-2 | 250
 | 02-UPS-1201 & 2-I | UPS-1&2-DB |  |  | 3CX 4mm2 | UPS-1&2 | UPS-1&2-DB | 20
 |  | TOTAL |  |  | 3CX 4mm2 |  |  | 520
 |  | E-300 |  |  | 3CX 2.5mm2 | MCC | E-300 | 340
 |  | FLARE PANEL |  |  | 3CX 2.5mm2 | CONTROL PANEL | FLARE PANEL | 50
 |  | BURN PIT PANEL |  |  | 3CX 2.5mm2 | CONTROL PANEL | BURN PIT PANEL | 60
 |  | TOWER LIGHT-1 (3 No. 200W light each pole) |  |  | 3CX 2.5mm2 | LIGHT PANEL | TOWER LIGHT-1 | 340
 |  | TOWER LIGHT-2 (3 No. 200W light each pole) |  |  | 3CX 2.5mm2 | LIGHT PANEL | TOWER LIGHT-2 | 290
 |  | TOWER LIGHT-3 (3 No. 200W light each pole) |  |  | 3CX 2.5mm2 | LIGHT PANEL | TOWER LIGHT-3 | 250
 |  | TOWER LIGHT-4 (3 No. 200W light each pole) |  |  | 3CX 2.5mm2 | LIGHT PANEL | TOWER LIGHT-4 | 190
 |  | TOWER LIGHT-5 (3 No. 200W light each pole) |  |  | 3CX 2.5mm2 | LIGHT PANEL | TOWER LIGHT-5 | 230
 |  | TOWER LIGHT-6 (3 No. 200W light each pole) |  |  | 3CX 2.5mm2 | LIGHT PANEL | TOWER LIGHT-6 | 70
 |  | TOWER LIGHT INTERNAL WIRING |  |  | 3CX 2.5mm2 | LIGHT | TOWER JB | 200
 |  | PIPE RACK LIGHT-1 (8 No. 100W light) |  |  | 3CX 2.5mm2 | LIGHT PANEL | PIPE RACK LIGHT-1 | 280
 |  | PIPE RACK LIGHT-2(8 No. 100W light) |  |  | 3CX 2.5mm2 | LIGHT PANEL | PIPE RACK LIGHT-2 | 280
 |  | TRANSFER PUMP SHED LIGHT (2 No.36W each light) |  |  | 3CX 2.5mm2 | LIGHT PANEL | TRANSFER PUMP SHED LIGHT | 250
 |  | RECYCLE PUMP SHED LIGHT (2 No.36W each light) |  |  | 3CX 2.5mm2 | LIGHT PANEL | RECYCLE PUMP SHED LIGHT | 220
 |  | TEG TOWER LIGHT (2 No. 100W light) |  |  | 3CX 2.5mm2 | PIPE RACK LIGHT-2 | TEG TOWER | 20
 |  | AIR-CRAFT WARNING LIGHT(50W) |  |  | 3CX 2.5mm2 | LIGHT PANEL | AIR-CRAFT WARNING LIGHT | 260
 |  | LOADING AREA SHED LIGHT (3 No. 200W each light) |  |  | 3CX 2.5mm2 | LIGHT PANEL | LOADING AREA SHED LIGHT | 120
 |  | DCS PANEL |  |  | 3CX 2.5mm2 | UPS-1&2-DB | DCS PANEL | 50
 |  | ENGINEERING STATION |  |  | 3CX 2.5mm2 | UPS-1&2-DB | ENG STATION | 50
 |  | OPERATOR STATION |  |  | 3CX 2.5mm2 | UPS-1&2-DB | OP STATION | 50
 |  | MCC I/O RIO-001 |  |  | 3CX 2.5mm2 | UPS-1&2-DB | MCC ROOM, | 100
 |  | PLANT MIMIC PANEL |  |  | 3CX 2.5mm2 | UPS-1&2-DB | PLANT MIMIC BOARD | 50
 |  | INTERCOM SYSTEM |  |  | 3CX 2.5mm2 | UPS-1&2-DB | INTERCOM SYSTEM | 50
 |  | WBH |  |  | 3CX 2.5mm2 | UPS-1&2-DB | WBH | 40
 |  | REBOILER |  |  | 3CX 2.5mm2 | UPS-1&2-DB | REBOILER | 160
 |  | FLARE CONTROL PANEL |  |  | 3CX 2.5mm2 | UPS-1&2-DB | FLARE CONTROL | 370
 |  | PRINTER |  |  | 3CX 2.5mm2 | UPS-1&2-DB | PRINTER | 50
 |  | LASER PRINTER |  |  | 3CX 2.5mm2 | UPS-1&2-DB | LASER PRINTER | 50
 |  | UPS-3 |  |  | 3CX 2.5mm2 | UPS-1&2-DB | UPS-3 | 10
 |  | FLOW COMPUTER |  |  | 3CX 2.5mm2 | UPS-1&2-DB | FLOW COMPUTER | 40
 |  | UPS (FIRE & GAS) |  |  | 3CX 2.5mm2 | UPS-2 | UPS-3 | 10
 |  | UPS-3-DB |  |  | 3CX 2.5mm2 | UPS-3 | UPS-3-DB | 10
 |  | FIRE PANEL |  |  | 3CX 2.5mm2 | UPS-3-DB | FIRE PANEL | 50
 |  | FIRE MIMIC PANEL |  |  | 3CX 2.5mm2 | UPS-3-DB | FIRE MIMIC PANEL | 50
 |  | ALARM SYSTEM |  |  | 3CX 2.5mm2 | UPS-3-DB | ALARM SYSTEM | 50
 |  | POWER SUPPLY |  |  | 3CX 2.5mm2 | UPS-3-DB | POWER SUPPLY | 50
 |  | UPS (EMERGENCY LIGHTING) |  |  | 3CX 2.5mm2 | MCC | UPS-4 | 180
 |  | FIRE WATER PUMP SHED LIGHT (2set.72W each light) |  |  | 3CX 2.5mm2 | LIGHT PANEL | FIRE WATER PUMP SHED LIGHT | 250
 |  | UPS-4-DB |  |  | 3CX 2.5mm2 | UPS-4 | UPS-4-DB | 10
 |  | CONTROL ROOM |  |  | 3CX 2.5mm2 | UPS-4-DB | CONTROL ROOM | 50
 |  | GENERATOR ROOM |  |  | 3CX 2.5mm2 | UPS-4-DB | GEN ROOM | 250
 |  | MCC ROOM |  |  | 3CX 2.5mm2 | UPS-4-DB | MCC ROOM | 250
 |  | WORKSHOP BUILDING LIGHT |  |  | 3CX 2.5mm2 | UPS-4-DB | WORKSHOP BUILD. | 100
 |  | FIRE WATER PUMP SHED |  |  | 3CX 2.5mm2 | UPS-4-DB | FIRE PUMP SHED | 200
 |  | TOTAL |  |  | 3C X 2.5mm2 |  |  | 6030
 | P-500A-I | ELECTRIC FIRE WATER PUMP |  |  | 4C X 185mm2 | MCC | P-500A-I | 210
 |  | TOTAL |  |  | 4C X 185mm2 |  |  | 210
 |  | INSTRUMENT CABLE |  |  | 24CX 1.5mm2 | WBH PANEL | WATER BATH HEATER | 180
REV | DATE |  |  | DESCRIPTION OF REVISION |  |  |  | PREPARED | CHECKED | APPROVED

Sheet: Cable Length Summary
 |  |  |  |  | CABLE LENGTH SUMMARY
USER |  |  | BANGLADESH GAS FIELDS COMPANY LIMITED |  |  |  | DOC NO. |  |  |  |  | REV :
LOCATION |  |  | TITAS GAS FIELD, BRAHMANBARIA, BANGLADESH |  |  |  | SERVICE
PROJECT |  |  | 2 X 75 MMSCFD GLYCOL DEHYDRATION TYPE GAS PROCESS PLANT |  |  |  | TAG NO. | N/A
JOB NO. |  |  | 252 |  |  |  | QUANTITY | N/A
Sl.No | TAG NO. | DISCRIPTION |  |  | CABLE SIZE (sqmm) | FROM | TO | CABLE LENGTH (METER) | AFTER ADD 10% | PO | KW | REMARKS
1 |  | Armoured Power cable |  |  | 3CX 2.5mm2 |  |  | 6030 |  | 6600
2 |  | Armoured Power cable |  |  | 3CX 4mm2 |  |  | 520 |  | 570
3 |  | Armoured Power cable |  |  | 4CX 2.5mm2 |  |  | 2390 |  | 2630
4 |  | Armoured Power cable |  |  | 4CX 4mm2 |  |  | 550 |  | 600
5 |  | Armoured Power cable |  |  | 4CX 6mm2 |  |  | 990 |  | 1090
6 |  | Armoured Power cable |  |  | 4CX 10mm2 |  |  | 670 |  | 740
7 |  | Armoured Power cable |  |  | 4CX 16mm2 |  |  | 270 |  | 300
9 |  | Armoured Power cable |  |  | 12CX1.5mm2 |  |  | 3210 |  | 3530
11 |  | Armoured Power cable |  |  | 3C x 4 mm2(Flat) |  |  | 1000 |  | 1000
12 |  | Armoured Power cable |  |  | 1C X 150 mm2 |  |  | 640 |  | 700
 |  | Armoured Power cable |  |  | 4C X 95 mm2 |  |  | 90 |  | 100 |  | As per plot plan
 |  | Armoured Power cable |  |  | 4C x 185 mm2 |  |  | 210 |  | 240
 |  | Armoured Power cable |  |  | 24C x 1.5 mm2 |  |  | 180 |  | 200
A
REV | DATE |  |  | DESCRIPTION OF REVISION |  |  |  | PREPARED |  |  | CHECKED | APPROVED

Sheet: OLD BOQ
USER |  | BANGLADESH GAS FIELDS COMPANY LIMITED |  |  |  | DOC NO. |  |  | REV :
LOCATION |  | TITAS GAS FIELD, BRAHMANBARIA, BANGLADESH |  |  |  | SERVICE
PROJECT |  | 2 x 75 MMSCFD GLYCOL DEHYDRATION TYPE GAS PROCESS PLANT |  |  |  | TAG NO. | N/A
JOB NO. |  | 252 | I LOCATION |  |  | QUANTITY | N/A
Sl.No | Category | Description of Materials |  |  | Quantity | Unit |  | Remarks
 | Generators | 276KW, 400/230 VAC, 3 phase 4 wire, 50Hz |  |  | 2 | Sets
 |  | 0.8PF, 1500RPM
 |  | Model No: PG345B3
 |  | Complete with all accessories
 |  | Generator Silenscer Pipe,Albo,& Others
 |  | Equipment
 | MCC Room | Incoming Panel | Feeder (Incoming Panel) | Feeder (Incoming Panel) | 1 | No
 |  | MCC Panel | MCC Panel | MCC Panel | 1 | Set
 |  | PFI Panel | PFI Panel | PFI Panel | 1 | No
 |  | Light Distribution Panel | Light Distribution Panel | Light Distribution Panel | 1 | No
 |  | Battery Charger 12 volt & 24 Volt, 20Amp |  |  | 1 | No
 |  | Distribution Panel for Operation Building | Distribution Panel for Operation Building | Distribution Panel for Operation Building | 1 | No |  |  | At Dhaka. (PSI not needed)
 |  | Distribution Panel for Workshop Building | Distribution Panel for Workshop Building | Distribution Panel for Workshop Building | 1 | No |  |  | At Dhaka. (PSI not needed)
 |  | Distribution Panel for generation Building | Distribution Panel for generation Building | Distribution Panel for generation Building | 1 | No |  |  | At Dhaka. (PSI not needed)
 |  | Star Delta motor starter panel for P700 | Star Delta motor starter panel for P700 | Star Delta motor starter panel for P700 | 1 | No |  |  | At Dhaka. (PSI not needed)
 |  | Star Delta motor starter panel for P800 | Star Delta motor starter panel for P800 | Star Delta motor starter panel for P800 | 1 | No |  |  | At Dhaka. (PSI not needed)
 |  | UPS(6kVA) | UPS(6kVA) | UPS(6kVA) | 2 | Nos
 |  | UPS(2kVA) | UPS(2kVA) | UPS(2kVA) | 1 | No
 |  | UPS(1kVA) | UPS(1kVA) | UPS(1kVA) | 1 | No
 |  | UPS Power Distribution Box |  |  | 3 | Nos |  |  | At Dhaka. (PSI not needed)
 |  | Plant Light Poles with fitting fixing accessories. (3 No. 400 W light in Each Pole) | TOWER LIGHT(200W light | TOWER LIGHT(200W light | 6 | Sets
 |  | Pipe Rack Light (100W light) | PIPE RACK LIGHT (100W light) | PIPE RACK LIGHT (100W light) | 15 | Nos
 |  | TEG Tower Light Short Pole Mounted (100W light) | TEG TOWER LIGHT (100W light) | TEG TOWER LIGHT (100W light) | 2 | Nos
 |  | Air-Craft Warning Light for Flare (50W light) | AIR-CRAFT WARNING LIGHT (50W light) | AIR-CRAFT WARNING LIGHT (50W light) | 1 | No
 |  | Shed Light (2 No.18W Each light) Explosion Proof | SHED LIGHT (2 No.36W each light) | SHED LIGHT (2 No.36W each light) | 8 | Nos
 |  | Loading Area Shed Light (200W Each light) Explosion Proof | LOADING AREA SHED LIGHT (200W each light) | LOADING AREA SHED LIGHT (200W each light) | 3 | Nos
 |  | Exit Light |  |  | 18 | Nos
 |  | Surge protection Device Three Phase (Type 1 SPD) | Surge protection Device | Surge protection Device | 2 | Nos
 |  | Surge protection Device Single Phase (Type 1 SPD) | Surge protection Device | Surge protection Device | 3 | Nos
 |  | Cathodic Protection for condensate tank | Cathodic Protection | Cathodic Protection | 1 | lot |  |  | Details BOQ Required
 |  | Cathodic Protection for underground pipe | Cathodic Protection | Cathodic Protection | 1 | lot |  |  | Details BOQ Required
 |  | Water Softener Plant for Cooling Tower | Cathodic Protection | Cathodic Protection |  |  |  |  | Dhaka
 |  | HVAC Distibution Box (For Blower DB) |  |  | 1 | Nos |  |  | At Dhaka. (PSI not needed)
 | LCS | LCS (Local Control Station) | LCS without selector switch | LCS without selector switch | 6 | pcs |  |  | Datasheet needed
 |  | LCS (Local Control Station) with Three Position selector switch. | LCS with selector switch | LCS with selector switch | 9 | pcs |  |  | Datasheet needed
 | Grounding Cable | Bare Grounding Copper Cable (95 sqmm/RM) |  |  | 1317 | meter
 |  | PVC Insulated Cable for Skid inter-connection (16 sqmm/RM) |  |  | 500 | meter
 |  | Solid Copper Rod (8 mm Dia) |  |  | 385 | meter
 |  | Grounding Rod, Each two meter length, Dia. 25mm | Grounding Rod, Each two meter length | Grounding Rod, Each two meter length | 45 | Nos
 | Accessories | 8mm Solid Copper Cable Joint connector | Joint Nut & Bolt 8mm Dia ( Short Length ) | Joint Nut & Bolt 8mm Dia ( Short Length ) | 30 | Nos
 |  | Joint connector (25mm dia to 95sqmm cable) | Joint Nut & Bolt 8mm Dia ( Short Length ) | Joint Nut & Bolt 8mm Dia ( Short Length ) | 45 | Nos
 |  | Copper Nut Bolt with washer L=40mm, OD=12mm, |  |  | 100 | Nos
 |  | Earthing cable termination Busbar with hole(14mm). Busbar Size: L=250mm, W=75mm, T=8mm |  |  | 20 | Nos
 |  | Busbar mounting Isolator with threaded bolt. Size: H=60mm, D1=40mm, M8, A=20mm |  |  | 40 | Nos
 |  | Copper Nut Bolt with washer. Size: L=40mm, OD=10mm, |  |  | 100 | Nos
 |  | 5m Static Grounding Clamp 40mm Jaw Opening. (For Loading Station) | 5m Static Grounding Clamp 40mm Jaw Opening. | 5m Static Grounding Clamp 40mm Jaw Opening. | 2 | Nos |  |  | RS Component
 | Cable Tray | Cable Tray With Cover Size 400(W) X 200(H) for Power Cable (Each 3 meter length) |  |  | 25 | Nos
 |  | Cable Tray With Cover Size 400(W) X 150(H) for Instrumentation Cable (Each 3 meter length) | Cable tray 400x150 | Cable tray 400x150 | 25 | Nos
 |  | Horizontal Elbow 400(W) x 200(H) X 400(W) for Cable Tray Size 400(W) X 200(H) | Cable tray 400x150 | Cable tray 400x150 | 2 | Nos
 |  | Horizontal Elbow 400(W) x 150(H) X 400(W) for Cable Tray Size 400(W) X 150(H) | Cable tray 400x150 | Cable tray 400x150 | 2 | Nos
 |  | Flexible Riser (90deg Vertical Outside bend ) 400(W) x 200(H) X 400(W) for Cable Tray Size 400(W) X 200(H) | Cable tray 400x150 | Cable tray 400x150 | 4 | Nos
 |  | Flexible Riser (90deg Vertical Inside bend) 400(W) x 200(H) X 400(W) for Cable Tray Size 400(W) X 200(H) | Cable tray 400x150 | Cable tray 400x150 | 4 | Nos
 |  | Flexible Riser (90deg Vertical Outside bend ) 400(W) x 150(H) X 400(W) for Cable Tray Size 400(W) X 150(H) | Cable tray 400x150 | Cable tray 400x150 | 4 | Nos
 |  | Flexible Riser (90deg Vertical Inside bend) 400(W) x 150(H) X 400(W) for Cable Tray Size 400(W) X 150(H) | Cable tray 400x150 | Cable tray 400x150 | 4 | Nos
 |  | Equal Tee 400(W) X 400(W) X 400(W) for Cable Tray Size 400(W) X 200(H) | EqualTee 400x400x400 | EqualTee 400x400x400 | 4 | Nos
 |  | Equal Tee 400(W) X 400(W) X 400(W) for Cable Tray Size 400(W) X 150(H) | EqualTee 400x400x400 | EqualTee 400x400x400 | 4 | Nos
 |  | End Cape For Cable Tray Size 400(W) X 200(H) |  |  | 8 | Nos
 |  | End Cape For Cable Tray Size 400(W) X 150(H) |  |  | 8 | Nos
 |  | Cable Tray Joint Plate For Cable Tray Size 400(W) X 200(H) | Cable tray 400x150 | Cable tray 400x150 | 80 | Nos
 |  | Cable Tray Joint Plate For Cable Tray Size 400(W) X 150(H) | Cable tray 400x150 | Cable tray 400x150 | 80 | Nos
 |  | Cable Tray Joint Nut & Bolt With Washer For Cable Tray Size 400(W) X 200(H) | Cable tray 400x150 | Cable tray 400x150 | 800 | Nos
 |  | Cable Tray Joint Nut & Bolt With Washer For Cable Tray Size 400(W) X 150(H) | Cable tray 400x150 | Cable tray 400x150 | 800 | Nos
 |  | Flex Strap Thief Hatch Bonding Kit, Tin Coted, Size 200 mm [L] X 20 mm [W] with 10 mm Hole at Both End | Cable tray 400x150 | Cable tray 400x150 | 100 | Nos
 | GI Pipe | GI Pipe, Size 1'' For Tower Light-1 |  |  | 20 | meter
 |  | GI Pipe, Size 1'' For Tower Light-2 | TOWER LIGHT-2 (3 No. 200W light each pole), Size : 1'' | TOWER LIGHT-2 (3 No. 200W light each pole), Size : 1'' | 20 | meter
 |  | GI Pipe, Size 1'' For Tower Light-3 | TOWER LIGHT-3 (3 No. 200W light each pole), Size : 1'' | TOWER LIGHT-3 (3 No. 200W light each pole), Size : 1'' | 15 | meter
 |  | GI Pipe, Size 1'' For Tower Light-4 | TOWER LIGHT-4 (3 No. 200W light each pole), Size : 1'' | TOWER LIGHT-4 (3 No. 200W light each pole), Size : 1'' | 20 | meter
 |  | GI Pipe, Size 1'' For Tower Light-5 | TOWER LIGHT-5 (3 No. 200W light each pole), Size : 1'' | TOWER LIGHT-5 (3 No. 200W light each pole), Size : 1'' | 20 | meter
 |  | GI Pipe, Size 1'' For Tower Light-6 | TOWER LIGHT-6 (3 No. 200W light each pole), Size : 1'' | TOWER LIGHT-6 (3 No. 200W light each pole), Size : 1'' | 15 | meter
 |  | GI Pipe, Size 1'' For Transfer Pump Shed light | TRANSFER PUMP SHED LIGHT (2 No.36W each light), Size : 1'' | TRANSFER PUMP SHED LIGHT (2 No.36W each light), Size : 1'' | 20 | meter
 |  | GI Pipe, Size 1'' For Recycle Pump Shed light | RECYCLE PUMP SHED LIGHT, Size : 1'' | RECYCLE PUMP SHED LIGHT, Size : 1'' | 20 | meter
 |  | GI Pipe, Size 1'' For Fire Water Pump Shed Light | FIRE WATER PUMP SHED LIGHT (2set.72W each light), Size : 1'' | FIRE WATER PUMP SHED LIGHT (2set.72W each light), Size : 1'' | 20 | meter
 |  | GI Pipe, Size 1'' For TEG Tower Light | TEG TOWER LIGHT (2 No. 100W light), Size : 1'' | TEG TOWER LIGHT (2 No. 100W light), Size : 1'' | 20 | meter
 |  | GI Pipe, Size 1'' For Air-Craft Shed Light | AIR-CRAFT WARNING LIGHT, Size : 1'' | AIR-CRAFT WARNING LIGHT, Size : 1'' | 250 | meter
 |  | GI Pipe, Size 1'' For Loading area Shed Light | LOADING AREA SHED LIGHT (3 No. 200W each light), Size : 1'' | LOADING AREA SHED LIGHT (3 No. 200W each light), Size : 1'' | 60 | meter
 |  | GI Pipe, Size 1'' For Inlet Air Cooler | INLET AIR COOLER, Size : 1'' | INLET AIR COOLER, Size : 1'' | 110 | meter
 |  | GI Pipe, Size 1'' For WBH | WBH, Size : 1'' | WBH, Size : 1'' | 20 | meter
 |  | GI Pipe ,Size 1'' For WBH,(Power) |  |  | 20 | meter
 |  | GI Pipe ,Size 2'' For WBH,(JB) |  |  | 20 | meter
 |  | GI Pipe ,Size 1'' For Regeneration Gas Heater(Power) |  |  | 20 | meter
 |  | GI Pipe ,Size 2'' For Regeneration Gas Heater(JB) |  |  | 20 | meter
 |  | GI Pipe ,Size 1 '' For Flare Panel Power ( 1CP800 To 1CP803 ) |  |  | 180 | meter
 |  | GI Pipe ,Size 1 '' For Flare Panel Power ( 1CP800 To 1CP803 ) |  |  | 180 | meter
 |  | GI Pipe ,Size 1 '' For Burn Pit Panel Power ( 1CP800 To 1CP807 ) |  |  | 160 | meter
 |  | GI Pipe ,Size 1 '' For Thermocouple ( Flare ) |  |  | 180 | meter
 |  | GI Pipe ,Size 1 '' For Thermocouple ( Burn Pit ) |  |  | 160 | meter
 |  | GI Pipe, Size 1-1/2'' For Pipe Rack Light-1 & 2 |  |  | 160 | meter
 |  | GI Pipe ,Size 1-1/2" For F&G, Power Cable Installation |  |  | 200 | meter
 |  | GI Pipe ,Size 2" For F&G Stand |  |  | 180 | meter
 |  | GI Pipe ,Size 2" For Skid To Cable Tray |  |  | 150 | meter
 |  | GI Pipe ,Size 4'' For Loading Arm, National Grid Line,Compressor Station Road Crossing Area |  |  | 100 | meter
 | GI Fittings | GI Elbow ,Size 1'' |  |  | 60 | Nos
 |  | GI Socket ,Size 1'' |  |  | 300 | Nos
 |  | GI Tee ,Size 1'' |  |  | 40 | Nos
 |  | GI Union ,Size 1'' |  |  | 30 | Nos
 |  | GI Reducer ,Size 1'' to 3/4'' |  |  | 20 | Nos
 |  | GI Elbow ,Size 1-1/2'' |  |  | 30 | Nos
 |  | GI Socket ,Size 1-1/2'' |  |  | 30 | Nos
 |  | GI Tee ,Size 1-1/2'' |  |  | 30 | Nos
 |  | GI Union ,Size1-1/2'' |  |  | 30 | Nos
 |  | GI Elbow ,Size 2'' |  |  | 20 | Nos
 |  | GI Socket ,Size 2'' |  |  | 30 | Nos
 |  | GI Tee ,Size 2'' |  |  | 10 | Nos
 |  | GI Union ,Size 2'' |  |  | 10 | Nos
 |  | GI Socket ,Size 4'' |  |  | 8 | Nos
 | Cable Lugs | Insulated Ring lugs 1.5mm2 |  |  | 200 | pcs
 |  | Insulated Ring lugs 2.5mm2 |  |  | 400 | pcs
 |  | Insulated Ring lugs 4mm2 |  |  | 200 | pcs
 |  | Insulated Ring lugs 6mm2 |  |  | 200 | pcs
 |  | Ring lugs 10mm2 ( Nickel Coated ) |  |  | 50 | pcs
 |  | Ring lugs 16mm2 ( Nickel Coated ) |  |  | 50 | pcs
 |  | Ring lugs 95mm2 for National Grid Line ( Nickel Coated ) |  |  | 20 | pcs
 |  | Ring lugs 185mm2 ( Nickel Coated ) |  |  | 20 | pcs
 |  | Ring lugs 150mm2 for Generator( Nickel Coated ) |  |  | 35 | pcs
 |  | Insulated I lugs 1.5 mm2 for others use |  |  | 10000 | pcs
 |  | Insulated I lugs 2 mm2 for others use |  |  | 1000 | pcs
 |  | Insulated I lugs 2.5 mm2 for others use |  |  | 1000 | pcs
 |  | Insulated I lugs 4 mm2 for others use |  |  | 400 | pcs
 |  | Insulated I lugs 6 mm2 for others use |  |  | 400 | pcs
 |  | Insulated Y lugs 1.5 mm2 for others use |  |  | 200 | pcs
 |  | Insulated Y lugs 2.5 mm2 for others use |  |  | 400 | pcs
 |  | Insulated Y lugs 4 mm2 for others use |  |  | 400 | pcs
 |  | Insulated Y lugs 6 mm2 for others use |  |  | 300 | pcs
 | PVC Tape | PVC Tape,size:3/4''(RED) | PVC Tape,size:3/4''(RED) | PVC Tape,size:3/4''(RED) | 100 | pcs
 |  | PVC Tape,size:3/4''(YELLOW) | PVC Tape,size:3/4''(YELLOW) | PVC Tape,size:3/4''(YELLOW) | 100 | pcs
 |  | PVC Tape,size:3/4''(BLUE) | PVC Tape,size:3/4''(BLUE) | PVC Tape,size:3/4''(BLUE) | 100 | pcs
 |  | PVC Tape,size:3/4''(BLACK) | PVC Tape,size:3/4''(BLACK) | PVC Tape,size:3/4''(BLACK) | 100 | pcs
 |  | PIB Tape | PIB Tape | PIB Tape | 20 | pcs
 | Shrink Tube | 1.5 inch Red color | 1.5 inch Red color | 1.5 inch Red color | 5 | meter
 |  | 1.5 inch Yellow color | 1.5 inch Yellow color | 1.5 inch Yellow color | 5 | meter
 |  | 1.5 inch Blue color | 1.5 inch Blue color | 1.5 inch Blue color | 5 | meter
 |  | 1.5 inch Black color | 1.5 inch Black color | 1.5 inch Black color | 5 | meter
 |  | 1 inch Red color | 1 inch Red color | 1 inch Red color | 5 | meter
 |  | 1 inch Yellow color | 1 inch Yellow color | 1 inch Yellow color | 3 | meter
 |  | 1 inch Blue color | 1 inch Blue color | 1 inch Blue color | 3 | meter
 |  | 1 inch Black color | 1 inch Black color | 1 inch Black color | 3 | meter
 |  | 1/2 inch Red color | 1/2 inch Red color | 1/2 inch Red color | 3 | meter
 |  | 1/2 inch Yellow color | 1/2 inch Yellow color | 1/2 inch Yellow color | 3 | meter
 |  | 1/2 inch Blue color | 1/2 inch Blue color | 1/2 inch Blue color | 3 | meter
 |  | 1/2 inch Black color | 1/2 inch Black color | 1/2 inch Black color | 3 | meter
 |  | 3/4 inch Red color | 3/4 inch Red color | 3/4 inch Red color | 3 | meter
 |  | 3/4 inch Yellow color | 3/4 inch Yellow color | 3/4 inch Yellow color | 3 | meter
 |  | 3/4 inch Blue color | 3/4 inch Blue color | 3/4 inch Blue color | 3 | meter
 |  | 3/4 inch Black color | 3/4 inch Black color | 3/4 inch Black color | 3 | meter
 |  | 1/4 inch Red color | 1/4 inch Red color | 1/4 inch Red color | 3 | meter
 |  | 1/4 inch Yellow color | 1/4 inch Yellow color | 1/4 inch Yellow color | 3 | meter
 |  | 1/4 inch Blue color | 1/4 inch Blue color | 1/4 inch Blue color | 3 | meter
 |  | 1/4 inch Black color | 1/4 inch Black color | 1/4 inch Black color | 3 | meter
 |  | Metal Gland for Field Side |  |  |  |  | Gland Model No. | Range
 | Cable Gland | 3/4'' NPT for Generator-1 Cooling Tower Pump (4C X 4mm2), OD:16.8mm |  |  | 1 | pcs | RAD 2 | 15mm to 24mm | Information
 |  | 3/4'' NPT for Generator-1 Cooling Tower Fan (4C X 4mm2), OD:16.8mm |  |  | 1 | pcs | RAD 2 | 15mm to 24mm | Information
 |  | 1'' NPT for Generator-2 Cooling Tower Pump (4C X 16mm2) OD:24.3mm |  |  | 1 | pcs | RAD 3 | 21mm to 31mm | Information
 |  | 1'' NPT for Generator-2 Cooling Tower Fan (4C X 16mm2) OD:24.3mm |  |  | 1 | pcs | RAD 3 | 21mm to 31mm | Information
 |  | 2 1/2'' NPT Control Panel Electric Fire Water Pump(4C X 185mm2), OD:57.2mm |  |  | 1 | pcs | RAD 7 | 51mm to 64mm | Information
 |  | 3/4'' NPT for Condensate Transfer Pump P-300A/B(4C X 6mm2), OD:18.8mm |  |  | 2 | pcs | RAD 2 | 15mm to 24mm | Information
 |  | 3/4'' NPT for Condensate Recycle Pump P-200A/B(4C X 2.5mm2) OD:15.4mm |  |  | 2 | pcs | RAD 2 | 15mm to 24mm | Information
 |  | 1'' NPT for Inlet Air Cooler AC-100A/B(4C X 10mm2), OD:21mm |  |  | 2 | pcs | RAD 2 | 15mm to 24mm | Information
 |  | 3/4'' NPT for Overhead Gas Cooler E-300(4C X 2.5mm2), OD:15.4mm |  |  | 1 | pcs | RAD 2 | 15mm to 24mm | Information
 |  | 3/4'' NPT for KOD Pump P-400(4C X 2.5mm2), OD:15.4mm |  |  | 1 | pcs | RAD 2 | 15mm to 24mm | Information
 |  | 3/4'' NPT for Deep Well Pump P-700 (4C X 4mm2), OD:16.8mm |  |  | 1 | pcs | RAD 2 | 15mm to 24mm | Information
 |  | 3/4'' NPT for Deep Well Pump P-800 (4C X 4mm2), OD:16.8mm |  |  | 1 | pcs | RAD 2 | 15mm to 24mm | Information
 |  | 3/4'' NPT for star-delta starter for P-700 & P-800 (3C X 4mm2), OD:16.8mm |  |  | 8 | pcs | RAD 2 | 15mm to 24mm | Information
 |  | PG Gland for MCC Side
 |  | Incoming Panel (1C X 150mm2) for Generator-1 & 2 |  |  | 20 | Nos |  |  | No Information for PG size
 |  | For National Grid (4C X 95mm2), OD:38.5mm |  |  | 1 | No. |  |  | No Information for PG size
 |  | Outlet for Location Use 100kW(4C X 120mm2), OD:47.1mm |  |  | 1 | No. |  |  | No Information for PG size
 |  | Spare Outlet for a similar future plant 100kW(4C X 120mm2), OD:47.1mm |  |  | 1 | No. |  |  | No Information for PG size
 |  | PG-29 for Spare Outlet-1 (25A)(4C X 6mm2), OD:18.8mm |  |  | 1 | No. |  |  | PG-29 for 18mm to25mm Overall Dia Cable
 |  | PG-36 for Spare Outlet-2 (50A)(4C X 16mm2), OD:24.3mm |  |  | 1 | No. |  |  | PG-36 for 22mm to32mm Overall Dia Cable
 |  | PG-21 for Glycol Reboiler (4C X 2.5mm2), OD:15.4mm |  |  | 1 | No. |  |  | PG-21 for 13mm to18mm Overall Dia Cable
 |  | PG-21 for Water Bath Heater Panel (4C X 2.5mm2), OD:15.4mm |  |  | 1 | No. |  |  | PG-21 for 13mm to18mm Overall Dia Cable
 |  | PG-21 for UPS System-1 (3C X 4mm2), OD:15.8mm |  |  | 1 | No. |  |  | PG-21 for 13mm to18mm Overall Dia Cable
 |  | PG-21 for UPS System-2 (3C X 4mm2), OD:15.8mm |  |  | 1 | No. |  |  | PG-21 for 13mm to18mm Overall Dia Cable
 |  | PG-21 for UPS System-3 (3C X 2.5mm2), OD:14.6mm |  |  | 1 | No. |  |  | PG-21 for 13mm to18mm Overall Dia Cable
 |  | PG-21 for UPS System-4 (3C X 4mm2), OD:15.8mm |  |  | 1 | No. |  |  | PG-21 for 13mm to18mm Overall Dia Cable
 |  | PG-36 for Utility Power Operation Building (4C X 16mm2) OD:24.3mm |  |  | 1 | No. |  |  | PG-36 for 22mm to32mm Overall Dia Cable
 |  | PG-29 for Utility Power Workshop Building (4C X 6mm2), OD:18.8mm |  |  | 1 | No. |  |  | PG-29 for 18mm to25mm Overall Dia Cable
 |  | PG-29 for Utility Power Generator Building (4C X 10mm2), OD:21mm |  |  | 1 | No. |  |  | PG-29 for 18mm to25mm Overall Dia Cable
 |  | PG-21 for Control Panel Diesel Fire Water Pump (4C X 2.5mm2) OD:15.4mm |  |  | 1 | No. |  |  | PG-21 for 13mm to18mm Overall Dia Cable
 |  | PG-29 for Control Panel Jockey Pump (4C X 6mm2) OD:18.8mm |  |  | 1 | No. |  |  | PG-29 for 18mm to25mm Overall Dia Cable
 |  | PG-63 for Control Panel Electric Fire Water Pump (4C X 185mm2), OD:57.2mm |  |  | 1 | No. |  |  | PG-21 for 13mm to18mm Overall Dia Cable
 |  | PG-21 for Generator-1 Cooling Tower Pump (4C X 4mm2), OD:16.8mm |  |  | 1 | No. |  |  | PG-21 for 13mm to18mm Overall Dia Cable
 |  | PG-21 for Generator-1 Cooling Tower Fan (4C X 4mm2), OD:16.8mm |  |  | 1 | No. |  |  | PG-36 for 22mm to32mm Overall Dia Cable
 |  | PG-36 for Generator-2 Cooling Tower Pump (4C X 16mm2) OD:24.3mm |  |  | 1 | No. |  |  | PG-36 for 22mm to32mm Overall Dia Cable
 |  | PG-36 for Generator-2 Cooling Tower Fan (4C X 16mm2) OD:24.3mm |  |  | 1 | No. |  |  | PG-21 for 13mm to18mm Overall Dia Cable
 |  | PG-21 for Flare and Burn Pit Control Panel (4C X 2.5mm2) OD:15.4mm |  |  | 1 | No. |  |  | PG-29 for 18mm to25mm Overall Dia Cable
 |  | PG-29 for Condensate Transfer Pump P-300A/B (4C X 6mm2), OD:18.8mm |  |  | 2 | Nos |  |  | PG-21 for 13mm to18mm Overall Dia Cable
 |  | PG-21 for Condensate Recycle Pump P-200A/B (4C X 2.5mm2) OD:15.4mm |  |  | 2 | Nos |  |  | PG-29 for 18mm to25mm Overall Dia Cable
 |  | PG-29 for Inlet Air Cooler AC-100A/B (4C X 10mm2), OD:21mm |  |  | 2 | Nos |  |  | PG-21 for 13mm to18mm Overall Dia Cable
 |  | PG-21 for Overhead Gas Cooler E-300 (4C X 2.5mm2), OD:15.4mm |  |  | 1 | No. |  |  | PG-21 for 13mm to18mm Overall Dia Cable
 |  | PG-21 for KOD Pump P-400 (4C X 2.5mm2), OD:15.4mm |  |  | 1 | No. |  |  | PG-21 for 13mm to18mm Overall Dia Cable
 |  | PG-21 for Deep Well Pump P-700 (4C X 4mm2), OD:16.8mm |  |  | 1 | No. |  |  | PG-21 for 13mm to18mm Overall Dia Cable
 |  | PG-21 for Deep Well Pump P-800 (4C X 4mm2), OD:16.8mm |  |  | 1 | No. |  |  | PG-29 for 18mm to25mm Overall Dia Cable
 |  | PG-29 for Light Distribution Panel Power (5C X 10mm2) OD:18.8mm |  |  | 1 | No.
 |  | Light Distribution panel
 |  | PG-21 for Tower Light-1,2,3,4,5,6(3C X 2.5mm2), OD:14.6mm |  |  | 6 | Nos |  |  | PG-21 for 13mm to18mm Overall Dia Cable
 |  | PG-21 for Pipe rack Light-1 (3C X 2.5mm2), OD:14.6mm |  |  | 1 | No. |  |  | PG-21 for 13mm to18mm Overall Dia Cable
 |  | PG-21 for Pipe rack Light-2 (3C X 2.5mm2), OD:14.6mm |  |  | 1 | No. |  |  | PG-21 for 13mm to18mm Overall Dia Cable
 |  | PG-21 for Air Craft Warning Light(3C X 2.5mm2), OD:14.6mm |  |  | 1 | No. |  |  | PG-21 for 13mm to18mm Overall Dia Cable
 |  | PG-21 for Loading Arm Shed Light(3C X 2.5mm2), OD:14.6mm |  |  | 1 | No. |  |  | PG-21 for 13mm to18mm Overall Dia Cable
 |  | PG-21 for Transfer Pump Shed Light(3C X 2.5mm2), OD:14.6mm |  |  | 1 | No. |  |  | PG-21 for 13mm to18mm Overall Dia Cable
 |  | PG-21 for Recycle Pump Shed light(3C X 2.5mm2), OD:14.6mm |  |  | 1 | No. |  |  | PG-21 for 13mm to18mm Overall Dia Cable
 |  | PG-21 for Fire Water Pump Shed Light(3C X 2.5mm2), OD:14.6mm |  |  | 1 | No. |  |  | PG-21 for 13mm to18mm Overall Dia Cable
 | Lightning Protection | Lightning Arrestor For Generator Building (Height:1 meter; Dia: 25mm) | Lightning Protection For Generator Building | Lightning Protection For Generator Building | 4 | Nos.
 |  | Lightning Arrestor For Operator Building (Height:1 meter; Dia: 25mm) | Lightning Protection For Control Building | Lightning Protection For Control Building | 4 | Nos.
 |  | Lightning Arrestor For Tank (Height:1 meter; Dia: 25mm) | Lightning Protection For TANK | Lightning Protection For TANK | 2 | Nos
18.0 | Angle Bar | Angle bar (Cable Tray support) 1''x1'' |  |  | 300 | meter |  |  | Thickness 3 mm
18.1 |  | Angle bar (Cable Tray support) 1.5''x1.5'' |  |  | 300 | meter |  |  | Thickness 3 mm
 |  | C-channel for Panel Installation (base) Size: D=100mm, B=50mm, t=5mm, T=7.7mm |  |  | 80 | meter
 | PVC Conduit | PVC Conduit Size 2'' | PVC Conduit Size 2'' | PVC Conduit Size 2'' | 50 | meter |  |  | Bangladesh
 |  | PVC Conduit Size 1.5'' | PVC Conduit Size 1.5'' | PVC Conduit Size 1.5'' | 100 | meter |  |  | Bangladesh
 |  | PVC Conduit Size 3/4'' | PVC Conduit Size 3/4'' | PVC Conduit Size 3/4'' | 50 | meter |  |  | Bangladesh
 |  | PVC Coated Alluminium Flexible Hose pipe 1 inch | Hose pipe | Hose pipe | 50 | meter |  |  | Bangladesh
 |  | PVC Coated Alluminium Flexible Hose pipe 1.5 inch | Hose pipe | Hose pipe | 50 | meter |  |  | Bangladesh
 |  | Fittings for 1 inch PVC Coated Alluminium Flexible Hose pipe 1 inch | Hose pipe | Hose pipe | 1 | lot |  |  | SG
 |  | Fittings for 1 inch PVC Coated Alluminium Flexible Hose pipe 1.5 inch | Hose pipe | Hose pipe | 1 | lot |  |  | SG
 | Royal Bolt | Royal Bolt(6mm) | Royal Bolt(6mm) | Royal Bolt(6mm) | 100 | pcs |  |  | BD
 |  | Royal Bolt(8mm) | Royal Bolt(8mm) | Royal Bolt(8mm) | 100 | pcs |  |  | BD
 |  | Royal Bolt(10mm) | Royal Bolt(10mm) | Royal Bolt(10mm) | 100 | pcs |  |  | BD
 |  | Royal Bolt(12mm) | Royal Bolt(10mm) | Royal Bolt(10mm) | 100 | pcs |  |  | BD
20.2 |  | Royal Bolt(10mm) FOR CABLE TRENCH ANGLE SUPPORT |  |  | 500 | pcs |  |  | BD
 | Cable Tie | Cable Tie , Size 24'' | Cable Tie , Size 12'' | Cable Tie , Size 12'' | 30 | Packet
 |  | Cable Tie , Size 12'' | Cable Tie , Size 12'' | Cable Tie , Size 12'' | 30 | Packet
 |  | Cable Tie , Size 8 '' | Cable Tie , Size 8 '' | Cable Tie , Size 8 '' | 30 | Packet
 |  | Cable Tie , Size 6'' | Cable Tie , Size 6'' | Cable Tie , Size 6'' | 30 | Packet
 | U-Bolt | U-bolt, Size 2'' (As per GI pipe size) | U-bolt, Size 2'' | U-bolt, Size 2'' | 100 | Nos
 |  | U-bolt, Size 1.5'' (As per GI pipe size) | U-bolt, Size 1.5'' | U-bolt, Size 1.5'' | 100 | Nos
 |  | U-bolt, Size 1'' (As per GI pipe size) | U-bolt, Size 1'' | U-bolt, Size 1'' | 50 | Nos
22.1 |  | U-bolt, Size 1.5'' (As per GI pipe size) |  |  | 150 | Nos
22.2 |  | U-bolt, Size 1'' (As per GI pipe size) |  |  | 200 | Nos
 | Cable tagging | Cable tagging & marking |  |  | 1 | lot
 |  | Ferrule 4 mm |  |  | 1 | Roll
 |  | Ferrule 6 mm |  |  | 1 | Roll
 |  | Sampling System |  |  | 1 | Set
 |  | Electric Pole |  |  | 1 | Nos
 |  | Intercom System |  |  | 1 | Nos
 |  | Handset |  |  | 13 | Nos
 | Accessories |  |  |  | 1 | lot
 | Instrumentation
REV | DATE |  | DESCRIPTION OF REVISION |  |  |  | PREPARED | CHECKED | APPROVED

Sheet: NEW BOQ
MASTER BOQ 2 x 75 MMSCFD GLYCOL DEHYDRATION TYPE GAS PROCESS PLANTT BANGLADESH GAS FIELDS COMPANY LIMITED. LOCATION : I
Sl.No | Category | Description of Materials |  |  | Quantity | Unit | PO Issued | Remarks
1 | Generators | 276KW, 400/230 VAC, 3 phase 4 wire, 50Hz |  |  | 2 | Sets
 |  | 0.8PF, 1500RPM
 |  | Model No: PG345B3
 |  | Complete with all accessories & without Radiator
2 | Cooling Towers | Ocean Cooling tower |  |  | 2 | Sets | POL000284-1
 |  | Model YC150H Cells:01, Cooling capacity RT:150
 |  | Heat Rejection: Kcal/hr:585000
3
3.1 | MCC ROOM | Incoming Panel | Feeder (Incoming Panel) | Feeder (Incoming Panel) | 1 | Nos
3.2 |  | MCC Panel | MCC Panel | MCC Panel | 1 | Set
3.3 |  | PFI Panel | PFI Panel | PFI Panel | 1 | Nos
3.4 |  | Light Distribution Panel | Light Distribution Panel | Light Distribution Panel | 1 | Nos
3.5 |  | Battery Charger 12 volt & 24 Volt, 20Amp |  |  | 1 | Nos
3.6 |  | Distribution Panel for Operation Building | Distribution Panel for Operation Building | Distribution Panel for Operation Building | 1 | Nos |  | At Dhaka. (PSI not needed)
3.7 |  | Distribution Panel for Workshop Building | Distribution Panel for Workshop Building | Distribution Panel for Workshop Building | 1 | Nos |  | At Dhaka. (PSI not needed)
3.8 |  | Distribution Panel for generation Building | Distribution Panel for generation Building | Distribution Panel for generation Building | 1 | Nos |  | At Dhaka. (PSI not needed)
3.9 |  | Star Delta motor starter panel for P700 | Star Delta motor starter panel for P700 | Star Delta motor starter panel for P700 | 1 | Nos |  | At Dhaka. (PSI not needed)
3.10 |  | Star Delta motor starter panel for P800 | Star Delta motor starter panel for P800 | Star Delta motor starter panel for P800 | 1 | Nos |  | At Dhaka. (PSI not needed)
 |  | Control Panel Electric Fire Water Pump |  |  | 1 | Nos
 |  | Side Wall Exhaust Fan for Generator Room (Model:WEX-750D6-1.1) |  |  | 3 | Nos
 |  | Exhaust Fan Control Panel |  |  | 1 | Nos
 |  | Electric Pole |  |  | 1 | Nos |  | At Dhaka. (PSI not needed)
4.0 | UPS
4.1 |  | UPS (6kVA) | UPS(6kVA) | UPS(6kVA) | 2 | Nos
4.2 |  | UPS (2kVA) | UPS(2kVA) | UPS(2kVA) | 1 | Nos
4.3 |  | UPS (1kVA) | UPS(1kVA) | UPS(1kVA) | 1 | Nos
5.0 | Area Lighting | UPS Power Distribution Box |  |  | 3 | Nos |  | At Dhaka. (PSI not needed)
5.1 |  | High Mast Light (Circular) Height 15m, with 3 ex-proof sodium vapor lamp | TOWER LIGHT(200W light | TOWER LIGHT(200W light | 3 | Sets
5.2 |  | High Mast Light (Sectoral) Height 15m, with 3 ex-proof sodium vapor lamp |  |  | 3 | Sets
5.3 |  | Pipe Rack Light (100W light) | PIPE RACK LIGHT (100W light) | PIPE RACK LIGHT (100W light) | 16 | Nos
5.4 |  | EXIT Light | TEG TOWER LIGHT (100W light) | TEG TOWER LIGHT (100W light) | 18 | Nos
5.5 |  | Shed Light (2 No.18W each light) explosion proof |  |  | 10 | Nos
5.6 |  | Shed Light for Loading Arm with 200W Sodium Vapor lamp |  |  | 2 | Nos
5.7 |  | Air-Craft Warning Light for flare (50W light) | AIR-CRAFT WARNING LIGHT (50W light) | AIR-CRAFT WARNING LIGHT (50W light) | 1 | Nos
5.8 |  | Shed Light (2 No.36W each light) explosion proof | SHED LIGHT (2 No.36W each light) | SHED LIGHT (2 No.36W each light) | 8 | Nos
5.9 |  | Loading Area Shed Light (200W each light) explosion proof | LOADING AREA SHED LIGHT (200W each light) | LOADING AREA SHED LIGHT (200W each light) | 3 | Nos
6.1 | Cathodic Protection | Cathodic Protection for condensate tank | Cathodic Protection | Cathodic Protection | 1 | lot |  | Details BOQ Required
6.2 |  | Cathodic Protection for underground pipe | Cathodic Protection | Cathodic Protection | 1 | lot |  | Details BOQ Required
7.0 | Generator Installation | Water Softener Plant for Cooling Tower | Cathodic Protection | Cathodic Protection | 1 | Set |  | Dhaka
7.1 |  | Generator Installation materials (List will be provided by Genset Vendor) | Cathodic Protection | Cathodic Protection | 1 | lot |  | Procurment to be done in Dhaka
8.0 | LCS | LCS (Local Control Station) | LCS without selector switch | LCS without selector switch | 6 | pcs
8.1 |  | LCS (Local Control Station) with Three Position selector switch. | LCS with selector switch | LCS with selector switch | 9 | pcs
9.0 | Grounding Systems
9.1 |  | Bare Grounding Copper Cable (95 sqmm/RM) |  |  | 1317 | meter
9.2 |  | PVC Insulated Cable for Skid inter-connection (16 sqmm/RM) |  |  | 500 | meter
9.3 |  | Solid Copper Rod (8 mm Dia) |  |  | 385 | meter
9.4 |  | Grounding Rod, Each two meter length, Dia. 25mm | Grounding Rod, Each two meter length | Grounding Rod, Each two meter length | 45 | Nos
9.5 |  | 8mm Solid Copper Cable Joint connector | Joint Nut & Bolt 8mm Dia ( Short Length ) | Joint Nut & Bolt 8mm Dia ( Short Length ) | 30 | Nos
9.6 |  | Joint connector (25mm dia to 95sqmm cable) | Joint Nut & Bolt 8mm Dia ( Short Length ) | Joint Nut & Bolt 8mm Dia ( Short Length ) | 45 | Nos
9.7 |  | Copper Nut Bolt with washer L=40mm, OD=12mm, |  |  | 100 | Nos
9.8 |  | Earthing cable termination Busbar with hole(14mm). Busbar Size: L=250mm, W=75mm, T=8mm |  |  | 20 | Nos
9.9 |  | Busbar mounting Isolator with threaded bolt. Size: H=60mm, D1=40mm, M8, A=20mm |  |  | 40 | Nos
9.10 |  | Copper Nut Bolt with washer. Size: L=40mm, OD=10mm, |  |  | 100 | Nos
9.11 |  | 5m Static Grounding Clamp 40mm Jaw Opening. (For Loading Station) | 5m Static Grounding Clamp 40mm Jaw Opening. | 5m Static Grounding Clamp 40mm Jaw Opening. | 2 | Nos |  |  | RS Component
10.0 | Cable Tray
10.1 |  | Cable Tray With Cover Size 400 X 200 for Power Cable (Each 3 meter length) |  |  | 25 | Nos
10.2 |  | Cable Tray With Cover Size 400 X 150 for Instrumentation Cable (Each 3 meter length) | Cable tray 400x150 | Cable tray 400x150 | 25 | Nos
10.3 |  | Elbow 90deg for Cable Tray Size 400 X 200 | Cable tray 400x150 | Cable tray 400x150 | 2 | Nos
10.4 |  | Elbow 90 deg for Cable Tray Size 400 X 150 | Cable tray 400x150 | Cable tray 400x150 | 2 | Nos
10.5 |  | Flexible adjustable outside Riser 90 deg for Cable Tray Size 400 X 200 | Cable tray 400x150 | Cable tray 400x150 | 4 | Nos
10.6 |  | Flexible adjustable inside Riser 90 deg for Cable Tray Size 400 X 200 |  |  | 4 | Nos
10.7 |  | Flexible adjustable outside Riser 90 deg for Cable Tray Size 400 X 150 | Cable tray 400x150 | Cable tray 400x150 | 4 | Nos
10.8 |  | Flexible adjustable inside Riser 90 deg for Cable Tray Size 400 X 150 |  |  | 4 | Nos
10.9 |  | Equal Tee for Cable Tray Size 400 X 200 |  |  | 4 | Nos
10.10 |  | Equal Tee for Cable Tray Size 400 X 150 |  |  | 4 | Nos
10.11 |  | Cable Tray Joint Plate For Cable Tray Size 400 X 200 | Cable tray 400x150 | Cable tray 400x150 | 80 | Nos
10.12 |  | Cable Tray Joint Plate For Cable Tray Size 400 X 150 | Cable tray 400x150 | Cable tray 400x150 | 80 | Nos
10.13 |  | Cable Tray Joint Plate For Cable Tray Size 400 X 150 | Cable tray 400x150 | Cable tray 400x150 | 200 | Nos
10.14 |  | Cable Tray Joint Nut & Bolt With Washer For Cable Tray Size 400 X 200 | Cable tray 400x150 | Cable tray 400x150 | 800 | Nos
10.15 |  | Cable Tray Joint Nut & Bolt With Washer For Cable Tray Size 400 X 150 | Cable tray 400x150 | Cable tray 400x150 | 800 | Nos
10.16 |  | Earth ground joint for cable tray |  |  | 100 | Nos
10.17 |  | End cap for 400X200 cable tray |  |  | 8 | Nos
10.18 |  | End cap for 400X150 cable tray |  |  | 8 | Nos
 | GI Pipe | GI Pipe, Size 1'' For Tower Light-1 |  |  | 20 | meter
 |  | GI Pipe, Size 1'' For Tower Light-2 | TOWER LIGHT-2 (3 No. 200W light each pole), Size : 1'' | TOWER LIGHT-2 (3 No. 200W light each pole), Size : 1'' | 20 | meter
 |  | GI Pipe, Size 1'' For Tower Light-3 | TOWER LIGHT-3 (3 No. 200W light each pole), Size : 1'' | TOWER LIGHT-3 (3 No. 200W light each pole), Size : 1'' | 15 | meter
 |  | GI Pipe, Size 1'' For Tower Light-4 | TOWER LIGHT-4 (3 No. 200W light each pole), Size : 1'' | TOWER LIGHT-4 (3 No. 200W light each pole), Size : 1'' | 20 | meter
 |  | GI Pipe, Size 1'' For Tower Light-5 | TOWER LIGHT-5 (3 No. 200W light each pole), Size : 1'' | TOWER LIGHT-5 (3 No. 200W light each pole), Size : 1'' | 20 | meter
 |  | GI Pipe, Size 1'' For Tower Light-6 | TOWER LIGHT-6 (3 No. 200W light each pole), Size : 1'' | TOWER LIGHT-6 (3 No. 200W light each pole), Size : 1'' | 15 | meter
 |  | GI Pipe, Size 1'' For Transfer Pump Shed light | TRANSFER PUMP SHED LIGHT (2 No.36W each light), Size : 1'' | TRANSFER PUMP SHED LIGHT (2 No.36W each light), Size : 1'' | 20 | meter
 |  | GI Pipe, Size 1'' For Recycle Pump Shed light | RECYCLE PUMP SHED LIGHT, Size : 1'' | RECYCLE PUMP SHED LIGHT, Size : 1'' | 20 | meter
 |  | GI Pipe, Size 1'' For Fire Water Pump Shed Light | FIRE WATER PUMP SHED LIGHT (2set.72W each light), Size : 1'' | FIRE WATER PUMP SHED LIGHT (2set.72W each light), Size : 1'' | 20 | meter
 |  | GI Pipe, Size 1'' For TEG Tower Light | TEG TOWER LIGHT (2 No. 100W light), Size : 1'' | TEG TOWER LIGHT (2 No. 100W light), Size : 1'' | 20 | meter
 |  | GI Pipe, Size 1'' For Air-Craft Shed Light | AIR-CRAFT WARNING LIGHT, Size : 1'' | AIR-CRAFT WARNING LIGHT, Size : 1'' | 250 | meter
 |  | GI Pipe, Size 1'' For Loading area Shed Light | LOADING AREA SHED LIGHT (3 No. 200W each light), Size : 1'' | LOADING AREA SHED LIGHT (3 No. 200W each light), Size : 1'' | 60 | meter
 |  | GI Pipe, Size 1'' For Inlet Air Cooler | INLET AIR COOLER, Size : 1'' | INLET AIR COOLER, Size : 1'' | 110 | meter
 |  | GI Pipe, Size 1'' For WBH | WBH, Size : 1'' | WBH, Size : 1'' | 20 | meter
 |  | GI Pipe ,Size 1'' For WBH,(Power) |  |  | 20 | meter
 |  | GI Pipe ,Size 2'' For WBH,(JB) |  |  | 20 | meter
 |  | GI Pipe ,Size 1'' For Regeneration Gas Heater(Power) |  |  | 20 | meter
 |  | GI Pipe ,Size 2'' For Regeneration Gas Heater(JB) |  |  | 20 | meter
 |  | GI Pipe ,Size 1 '' For Flare Panel Power ( 1CP800 To 1CP803 ) |  |  | 180 | meter
 |  | GI Pipe ,Size 1 '' For Flare Panel Power ( 1CP800 To 1CP803 ) |  |  | 180 | meter
 |  | GI Pipe ,Size 1 '' For Burn Pit Panel Power ( 1CP800 To 1CP807 ) |  |  | 160 | meter
 |  | GI Pipe ,Size 1 '' For Thermocouple ( Flare ) |  |  | 180 | meter
 |  | GI Pipe ,Size 1 '' For Thermocouple ( Burn Pit ) |  |  | 160 | meter
 |  | GI Pipe, Size 1-1/2'' For Pipe Rack Light-1 & 2 |  |  | 160 | meter
 |  | GI Pipe ,Size 1-1/2" For F&G, Power Cable Installation |  |  | 200 | meter
 |  | GI Pipe ,Size 2" For F&G Stand |  |  | 180 | meter
 |  | GI Pipe ,Size 2" For Skid To Cable Tray |  |  | 150 | meter
 |  | GI Pipe ,Size 4'' For Loading Arm, National Grid Line,Compressor Station Road Crossing Area |  |  | 100 | meter
 | GI Fittings | GI Elbow ,Size 1'' |  |  | 80 | Nos
 |  | GI Socket ,Size 1'' |  |  | 300 | Nos
 |  | GI Tee ,Size 1'' |  |  | 40 | Nos
 |  | GI Union ,Size 1'' |  |  | 30 | Nos
 |  | GI Reducer ,Size 1'' to 3/4'' |  |  | 20 | Nos
 |  | GI Elbow ,Size 1-1/2'' |  |  | 30 | Nos
 |  | GI Socket ,Size 1-1/2'' |  |  | 30 | Nos
 |  | GI Tee ,Size 1-1/2'' |  |  | 30 | Nos
 |  | GI Union ,Size1-1/2'' |  |  | 30 | Nos
 |  | GI Elbow ,Size 2'' |  |  | 20 | Nos
 |  | GI Socket ,Size 2'' |  |  | 30 | Nos
 |  | GI Tee ,Size 2'' |  |  | 10 | Nos
 |  | GI Union ,Size 2'' |  |  | 10 | Nos
 |  | GI Socket ,Size 4'' |  |  | 8 | Nos
 | Cable Lugs | Insulated Ring lugs 1.5mm2 |  |  | 200 | pcs
 |  | Insulated Ring lugs 2.5mm2 |  |  | 400 | pcs
 |  | Insulated Ring lugs 4mm2 |  |  | 200 | pcs
 |  | Insulated Ring lugs 6mm2 |  |  | 200 | pcs
 |  | Ring lugs 10mm2 ( Nickel Coated ) |  |  | 50 | pcs
 |  | Ring lugs 16mm2 ( Nickel Coated ) |  |  | 50 | pcs
 |  | Ring lugs 95mm2 for National Grid Line ( Nickel Coated ) |  |  | 20 | pcs
 |  | Ring lugs 185mm2 ( Nickel Coated ) |  |  | 20 | pcs
 |  | Ring lugs 150mm2 for Generator( Nickel Coated ) |  |  | 35 | pcs
 |  | Insulated I lugs 1.5 mm2 for others use |  |  | 10000 | pcs
 |  | Insulated I lugs 2 mm2 for others use |  |  | 1000 | pcs
 |  | Insulated I lugs 2.5 mm2 for others use |  |  | 1000 | pcs
 |  | Insulated I lugs 4 mm2 for others use |  |  | 400 | pcs
 |  | Insulated I lugs 6 mm2 for others use |  |  | 400 | pcs
 |  | Insulated Y lugs 1.5 mm2 for others use |  |  | 200 | pcs
 |  | Insulated Y lugs 2.5 mm2 for others use |  |  | 400 | pcs
 |  | Insulated Y lugs 4 mm2 for others use |  |  | 400 | pcs
 |  | Insulated Y lugs 6 mm2 for others use |  |  | 300 | pcs
 | Cable Lugs | Insulated Ring lugs 1.5mm2 |  |  | 200 | pcs
 |  | Insulated Ring lugs 2.5mm2 |  |  | 400 | pcs
 |  | Insulated Ring lugs 4mm2 |  |  | 200 | pcs
 |  | Insulated Ring lugs 6mm2 |  |  | 200 | pcs
 |  | Ring lugs 10mm2 ( Nickel Coated ) |  |  | 50 | pcs
 |  | Ring lugs 16mm2 ( Nickel Coated ) |  |  | 50 | pcs
 |  | Ring lugs 95mm2 for National Grid Line ( Nickel Coated ) |  |  | 20 | pcs
 |  | Ring lugs 185mm2 ( Nickel Coated ) |  |  | 20 | pcs
 |  | Ring lugs 150mm2 for Generator( Nickel Coated ) |  |  | 35 | pcs
 |  | Insulated I lugs 1.5 mm2 for others use |  |  | 10000 | pcs
 |  | Insulated I lugs 2 mm2 for others use |  |  | 1000 | pcs
 |  | Insulated I lugs 2.5 mm2 for others use |  |  | 1000 | pcs
 |  | Insulated I lugs 4 mm2 for others use |  |  | 400 | pcs
 |  | Insulated I lugs 6 mm2 for others use |  |  | 400 | pcs
 |  | Insulated Y lugs 1.5 mm2 for others use |  |  | 200 | pcs
 |  | Insulated Y lugs 2.5 mm2 for others use |  |  | 400 | pcs
 |  | Insulated Y lugs 4 mm2 for others use |  |  | 400 | pcs
 |  | Insulated Y lugs 6 mm2 for others use |  |  | 300 | pcs
14.0
14.1 | PVC Tape | PVC Tape,size:3/4''(RED) | PVC Tape,size:3/4''(RED) | PVC Tape,size:3/4''(RED) | 150 | pcs
14.2 |  | PVC Tape,size:3/4''(YELLOW) | PVC Tape,size:3/4''(YELLOW) | PVC Tape,size:3/4''(YELLOW) | 150 | pcs
14.3 |  | PVC Tape,size:3/4''(BLUE) | PVC Tape,size:3/4''(BLUE) | PVC Tape,size:3/4''(BLUE) | 150 | pcs
14.4 |  | PVC Tape,size:3/4''(BLACK) | PVC Tape,size:3/4''(BLACK) | PVC Tape,size:3/4''(BLACK) | 150 | pcs
14.5 |  | PIB Tape | PIB Tape | PIB Tape | 30 | pcs
15.0
15.1 | Shrink Tube | 1.5 inch Red color | 1.5 inch Red color | 1.5 inch Red color | 5 | meter
15.2 |  | 1.5 inch Yellow color | 1.5 inch Yellow color | 1.5 inch Yellow color | 5 | meter
15.3 |  | 1.5 inch Blue color | 1.5 inch Blue color | 1.5 inch Blue color | 5 | meter
15.4 |  | 1.5 inch Black color | 1.5 inch Black color | 1.5 inch Black color | 5 | meter
15.5 |  | 1 inch Red color | 1 inch Red color | 1 inch Red color | 5 | meter
15.6 |  | 1 inch Yellow color | 1 inch Yellow color | 1 inch Yellow color | 3 | meter
15.7 |  | 1 inch Blue color | 1 inch Blue color | 1 inch Blue color | 3 | meter
15.8 |  | 1 inch Black color | 1 inch Black color | 1 inch Black color | 3 | meter
15.9 |  | 1/2 inch Red color | 1/2 inch Red color | 1/2 inch Red color | 3 | meter
15.10 |  | 1/2 inch Yellow color | 1/2 inch Yellow color | 1/2 inch Yellow color | 3 | meter
15.11 |  | 1/2 inch Blue color | 1/2 inch Blue color | 1/2 inch Blue color | 3 | meter
15.12 |  | 1/2 inch Black color | 1/2 inch Black color | 1/2 inch Black color | 3 | meter
15.13 |  | 3/4 inch Red color | 3/4 inch Red color | 3/4 inch Red color | 3 | meter
15.14 |  | 3/4 inch Yellow color | 3/4 inch Yellow color | 3/4 inch Yellow color | 3 | meter
15.15 |  | 3/4 inch Blue color | 3/4 inch Blue color | 3/4 inch Blue color | 3 | meter
15.16 |  | 3/4 inch Black color | 3/4 inch Black color | 3/4 inch Black color | 3 | meter
15.17 |  | 1/4 inch Red color | 1/4 inch Red color | 1/4 inch Red color | 3 | meter
15.18 |  | 1/4 inch Yellow color | 1/4 inch Yellow color | 1/4 inch Yellow color | 3 | meter
15.19 |  | 1/4 inch Blue color | 1/4 inch Blue color | 1/4 inch Blue color | 3 | meter
15.20 |  | 1/4 inch Black color | 1/4 inch Black color | 1/4 inch Black color | 3 | meter
16.0 |  | Metal Gland for Field Side |  |  |  |  |  | Range | Gland Model No.
16.1 | Cable Gland | 3/4'' NPT for Generator-1 Cooling Tower Pump (4C X 4mm2), OD:16.8mm |  |  | 1 | pcs | Actual Cable OD required | 15mm to 24mm | RAD 2
16.2 |  | 3/4'' NPT for Generator-1 Cooling Tower Fan (4C X 4mm2), OD:16.8mm |  |  | 1 | pcs |  | 15mm to 24mm | RAD 2
16.3 |  | 1'' NPT for Generator-2 Cooling Tower Pump (4C X 16mm2) OD:24.3mm |  |  | 1 | pcs |  | 21mm to 31mm | RAD 3
16.4 |  | 1'' NPT for Generator-2 Cooling Tower Fan (4C X 16mm2) OD:24.3mm |  |  | 1 | pcs |  | 21mm to 31mm | RAD 3
16.5 |  | 2 1/2'' NPT Control Panel Electric Fire Water Pump(4C X 185mm2), OD:57.2mm |  |  | 1 | pcs |  | 51mm to 64mm | RAD 7
16.6 |  | 3/4'' NPT for Condensate Transfer Pump P-300A/B(4C X 6mm2), OD:18.8mm |  |  | 2 | pcs |  | 15mm to 24mm | RAD 2
16.7 |  | 3/4'' NPT for Condensate Recycle Pump P-200A/B(4C X 2.5mm2) OD:15.4mm |  |  | 2 | pcs |  | 15mm to 24mm | RAD 2
16.8 |  | 1'' NPT for Inlet Air Cooler AC-100A/B(4C X 10mm2), OD:21mm |  |  | 2 | pcs |  | 15mm to 24mm | RAD 2
16.9 |  | 3/4'' NPT for Overhead Gas Cooler E-300(4C X 2.5mm2), OD:15.4mm |  |  | 1 | pcs |  | 15mm to 24mm | RAD 2
16.10 |  | 3/4'' NPT for KOD Pump P-400(4C X 2.5mm2), OD:15.4mm |  |  | 1 | pcs |  | 15mm to 24mm | RAD 2
16.11 |  | 3/4'' NPT for Deep Well Pump P-700(4C X 4mm2), OD:16.8mm |  |  | 1 | pcs |  | 15mm to 24mm | RAD 2
16.12 |  | 3/4'' NPT for Deep Well Pump P-800(4C X 4mm2), OD:16.8mm |  |  | 1 | pcs |  | 15mm to 24mm | RAD 2
16.13 |  | 3/4'' NPT for star-delta starter for P-700 & P-800 (3C X 4mm2), OD:16.8mm |  |  | 8 | pcs |  | 15mm to 24mm | RAD 2
17.0 |  | PG Gland for MCC Side
17.1 |  | Incoming Panel (1C X 150mm2) for Generator-1 & 2 |  |  | 20 | Nos |  |  | No Information for PG size
17.2 |  | For National Grid (4C X 95mm2), OD:38.5mm |  |  | 1 | No. |  |  | No Information for PG size
17.3 |  | Outlet for Location Use 100kW(4C X 120mm2), OD:47.1mm |  |  | 1 | No. |  |  | No Information for PG size
17.4 |  | Spare Outlet for a similar future plant 100kW(4C X 120mm2), OD:47.1mm |  |  | 1 | No. |  |  | No Information for PG size
17.5 |  | PG-29 for Spare Outlet-1 (25A)(4C X 6mm2), OD:18.8mm |  |  | 1 | No. |  |  | PG-29 for 18mm to25mm Overall Dia Cable
17.6 |  | PG-36 for Spare Outlet-2 (50A)(4C X 16mm2), OD:24.3mm |  |  | 1 | No. |  |  | PG-36 for 22mm to32mm Overall Dia Cable
17.7 |  | PG-21 for Glycol Reboiler (4C X 2.5mm2), OD:15.4mm |  |  | 1 | No. |  |  | PG-21 for 13mm to18mm Overall Dia Cable
17.8 |  | PG-21 for Water Bath Heater Panel (4C X 2.5mm2), OD:15.4mm |  |  | 1 | No. |  |  | PG-21 for 13mm to18mm Overall Dia Cable
17.9 |  | PG-21 for UPS System-1 (3C X 4mm2), OD:15.8mm |  |  | 1 | No. |  |  | PG-21 for 13mm to18mm Overall Dia Cable
17.10 |  | PG-21 for UPS System-2 (3C X 4mm2), OD:15.8mm |  |  | 1 | No. |  |  | PG-21 for 13mm to18mm Overall Dia Cable
17.11 |  | PG-21 for UPS System-3 (3C X 2.5mm2), OD:14.6mm |  |  | 1 | No. |  |  | PG-21 for 13mm to18mm Overall Dia Cable
17.12 |  | PG-21 for UPS System-4 (3C X 4mm2), OD:15.8mm |  |  | 1 | No. |  |  | PG-21 for 13mm to18mm Overall Dia Cable
17.13 |  | PG-36 for Utility Power Operation Building(4C X 16mm2) OD:24.3mm |  |  | 1 | No. |  |  | PG-36 for 22mm to32mm Overall Dia Cable
17.14 |  | PG-29 for Utility Power Workshop Building(4C X 6mm2), OD:18.8mm |  |  | 1 | No. |  |  | PG-29 for 18mm to25mm Overall Dia Cable
17.15 |  | PG-29 for Utility Power Generator Building(4C X 10mm2), OD:21mm |  |  | 1 | No. |  |  | PG-29 for 18mm to25mm Overall Dia Cable
17.16 |  | PG-21 for Control Panel Diesel Fire Water Pump(4C X 2.5mm2) OD:15.4mm |  |  | 1 | No. |  |  | PG-21 for 13mm to18mm Overall Dia Cable
17.17 |  | PG-29 for Control Panel Jockey Pump(4C X 6mm2) OD:18.8mm |  |  | 1 | No. |  |  | PG-29 for 18mm to25mm Overall Dia Cable
17.18 |  | PG-63 for Control Panel Electric Fire Water Pump(4C X 185mm2), OD:57.2mm |  |  | 1 | No.
17.19 |  | PG-21 for Generator-1 Cooling Tower Pump (4C X 4mm2), OD:16.8mm |  |  | 1 | No. |  |  | PG-21 for 13mm to18mm Overall Dia Cable
17.20 |  | PG-21 for Generator-1 Cooling Tower Fan (4C X 4mm2), OD:16.8mm |  |  | 1 | No. |  |  | PG-21 for 13mm to18mm Overall Dia Cable
17.21 |  | PG-36 for Generator-2 Cooling Tower Pump (4C X 16mm2) OD:24.3mm |  |  | 1 | No. |  |  | PG-36 for 22mm to32mm Overall Dia Cable
17.22 |  | PG-36 for Generator-2 Cooling Tower Fan (4C X 16mm2) OD:24.3mm |  |  | 1 | No. |  |  | PG-36 for 22mm to32mm Overall Dia Cable
17.23 |  | PG-21 for Flare and Burn Pit Control Panel(4C X 2.5mm2) OD:15.4mm |  |  | 1 | No. |  |  | PG-21 for 13mm to18mm Overall Dia Cable
17.24 |  | PG-29 for Condensate Transfer Pump P-300A/B(4C X 6mm2), OD:18.8mm |  |  | 2 | Nos |  |  | PG-29 for 18mm to25mm Overall Dia Cable
17.25 |  | PG-21 for Condensate Recycle Pump P-200A/B(4C X 2.5mm2) OD:15.4mm |  |  | 2 | Nos |  |  | PG-21 for 13mm to18mm Overall Dia Cable
17.26 |  | PG-29 for Inlet Air Cooler AC-100A/B(4C X 10mm2), OD:21mm |  |  | 2 | Nos |  |  | PG-29 for 18mm to25mm Overall Dia Cable
17.27 |  | PG-21 for Overhead Gas Cooler E-300(4C X 2.5mm2), OD:15.4mm |  |  | 1 | No. |  |  | PG-21 for 13mm to18mm Overall Dia Cable
17.28 |  | PG-21 for KOD Pump P-400(4C X 2.5mm2), OD:15.4mm |  |  | 1 | No. |  |  | PG-21 for 13mm to18mm Overall Dia Cable
17.29 |  | PG-21 for Deep Well Pump P-700(4C X 4mm2), OD:16.8mm |  |  | 1 | No. |  |  | PG-21 for 13mm to18mm Overall Dia Cable
17.30 |  | PG-21 for Deep Well Pump P-800(4C X 4mm2), OD:16.8mm |  |  | 1 | No. |  |  | PG-21 for 13mm to18mm Overall Dia Cable
17.31 |  | PG-29 for Light Distribution Panel Power(5C X 10mm2) OD:18.8mm |  |  | 1 | No. |  |  | PG-29 for 18mm to25mm Overall Dia Cable
18.0 |  | Light Distribution panel |  |  |  | No.
18.1 |  | PG-21 for Tower Light-1,2,3,4,5,6(3C X 2.5mm2), OD:14.6mm |  |  | 6 | Nos |  |  | PG-21 for 13mm to18mm Overall Dia Cable
18.2 |  | PG-21 for Pipe rack Light-1 (3C X 2.5mm2), OD:14.6mm |  |  | 1 | No. |  |  | PG-21 for 13mm to18mm Overall Dia Cable
18.3 |  | PG-21 for Pipe rack Light-2 (3C X 2.5mm2), OD:14.6mm |  |  | 1 | No. |  |  | PG-21 for 13mm to18mm Overall Dia Cable
18.4 |  | PG-21 for Air Craft Warning Light(3C X 2.5mm2), OD:14.6mm |  |  | 1 | No. |  |  | PG-21 for 13mm to18mm Overall Dia Cable
18.5 |  | PG-21 for Loading Arm Shed Light(3C X 2.5mm2), OD:14.6mm |  |  | 1 | No. |  |  | PG-21 for 13mm to18mm Overall Dia Cable
18.6 |  | PG-21 for Transfer Pump Shed Light(3C X 2.5mm2), OD:14.6mm |  |  | 1 | No. |  |  | PG-21 for 13mm to18mm Overall Dia Cable
18.7 |  | PG-21 for Recycle Pump Shed light(3C X 2.5mm2), OD:14.6mm |  |  | 1 | No. |  |  | PG-21 for 13mm to18mm Overall Dia Cable
18.8 |  | PG-21 for Fire Water Pump Shed Light(3C X 2.5mm2), OD:14.6mm |  |  | 1 | No. |  |  | PG-21 for 13mm to18mm Overall Dia Cable
19.0
19.1 | Lightning Protection | Lightning Arrestor For Generator Building (Height:1 meter; Dia: 25mm) | Lightning Protection For Generator Building | Lightning Protection For Generator Building | 4 | Nos.
19.2 |  | Lightning Arrestor For Operator Building (Height:1 meter; Dia: 25mm) | Lightning Protection For Control Building | Lightning Protection For Control Building | 4 | Nos.
19.3 |  | Lightning Arrestor For Tank (Height:1 meter; Dia: 25mm) | Lightning Protection For TANK | Lightning Protection For TANK | 2 | Nos
20.0
20.1 | Angle Bar | Angle bar (Cable Support) 1''x1'' |  |  | 150 | meter |  |  | Thickness 3 mm
20.2 |  | Angle bar (Cable Support) 1.5''x1.5'' |  |  | 250 | meter |  |  | Thickness 3 mm
21.0 |  | Angle bar (Generator Silenser Support) 2'' x 2'' |  |  | 160 | meter |  |  | Thickness 3 mm
 |  | C-channel for Panel Installation (base) Size: D=100mm, B=50mm, t=5mm, T=7.7mm |  |  | 100 | meter
21.1 | PVC Conduit | PVC Conduit Size 2'' |  |  | 50 | meter |  |  | Dhaka
21.2 |  | PVC Conduit Size 1.5'' | PVC Conduit Size 1.5'' | PVC Conduit Size 1.5'' | 100 | meter |  |  | Dhaka
21.3 |  | PVC Conduit Size 3/4'' | PVC Conduit Size 3/4'' | PVC Conduit Size 3/4'' | 50 | meter |  |  | Dhaka
21.4 |  | PVC Coted Alluminium Flexible Hose pipe 1 Inch | Hose pipe | Hose pipe | 100 | meter
 |  | PVC Coted Alluminium Flexible Hose pipe 1.5 inch | Hose pipe | Hose pipe | 100 | meter
 |  | Fittings for 1 Inch PVC Coted Alluminium Flexible Hose pipe | Hose pipe | Hose pipe | 1 | lot
 |  | Fittings for 1.5 Inch PVC Coted Alluminium Flexible Hose pipe | Hose pipe | Hose pipe | 1 | lot
22.0
22.1 | Royal Bolt | Royal Bolt(6mm) | Royal Bolt(6mm) | Royal Bolt(6mm) | 100 | pcs |  |  | Dhaka
22.2 |  | Royal Bolt(8mm) | Royal Bolt(8mm) | Royal Bolt(8mm) | 100 | pcs |  |  | Dhaka
22.3 |  | Royal Bolt(10mm) | Royal Bolt(10mm) | Royal Bolt(10mm) | 100 | pcs |  |  | Dhaka
22.4 |  | Royal Bolt(12mm) FOR CABLE TRENCH ANGLE SUPPORT |  |  | 400 | pcs |  |  | Dhaka
23.0
23.1 | Cable Tie | Cable Tie , Size 24'' |  |  | 50 | Packet
23.2 |  | Cable Tie , Size 12'' |  |  | 100 | Packet
23.3 |  | Cable Tie , Size 8 '' |  |  | 100 | Packet
23.4 |  | Cable Tie , Size 6'' |  |  | 50 | Packet
24.0
24.1 | U-Bolt | U-bolt, Size 2'' (As per GI pipe size) |  |  | 100 | Nos
24.2 |  | U-bolt, Size 1.5'' (As per GI pipe size) |  |  | 100 | Nos
24.3 |  | U-bolt, Size 1'' (As per GI pipe size) |  |  | 650 | Nos
 |  | U-bolt, Size 3/4'' (As per GI pipe size) |  |  | 150 | Nos
25.0
25.1 | Cable tagging | Cable tagging & marking |  |  | 1 | lot
25.2 |  | Ferrule 4 mm |  |  | 1 | lot
25.3 |  | Ferrule 6 mm |  |  | 1 | lot
 | Power Cable | 3CX 2.5mm2 |  |  | 6600 | meter
 |  | 3CX 4mm2 |  |  | 570 | meter
 |  | 4CX 2.5mm2 |  |  | 2630 | meter
 |  | 4CX 4mm2 |  |  | 600 | meter
 |  | 4CX 6mm2 |  |  | 1090 | meter
 |  | 4CX 10mm2 |  |  | 740 | meter
 |  | 4CX 16mm2 |  |  | 300 | meter
 |  | 12CX1.5mm2 |  |  | 3530 | meter
 |  | 3C x 4 mm2(Flat) |  |  | 1000 | meter |  |  | Dhaka
 |  | 1C X 150 mm2 |  |  | 700 | meter
 |  | 4C X 95 mm2 |  |  | 100 | meter
 |  | 4C x 185 mm2 |  |  | 240 | meter
 |  | 24C x 1.5 mm2 |  |  | 200 | meter
26.0 | Field Fire & Gas Equipment
26.1 |  | IR Combustible Gas Detector (Model: IR4000S) |  |  | 11 | Nos
26.2 |  | 316 SS 2" Pipe Moutning Bracket |  |  | 8 | Nos
26.3 |  | UV/IR Flame Detector (Model No: FL3100H) |  |  | 9 | Nos
26.4 |  | 316 SS 2" Pipe Moutning Bracket |  |  | 9 | Nos
26.5 |  | Manual Alarm Call Point (Model No: BGE) |  |  | 6 | Nos
26.6 |  | 2" Pipe Moutning Bracker |  |  | 6 | Nos
26.7 |  | Beacon & Horn (Model No: DB3BDGD048T1BNR) |  |  | 4 | Nos
26.8 |  | 2" Pipe mounting bracket |  |  | 4 | Nos
26.9 |  | ESD Push Button (Model: PBE) |  |  | 2 | Nos
26.10 |  | 2" pipe mounting bracket |  |  | 2 | Nos
27.0 | Building Fire & Gas Equipment
27.1 |  | Adressable Fire Alarm Master Panel |  |  | 1 | Set
27.2 |  | Model: LD128E(Q)I64C
27.3 |  | Addressable Photoelectric Smoke Detector with Base (Model: LD300EN/A) |  |  | 20 | Nos
27.4 |  | Intelligent Heat Detector with Base (Model: LD3300EN) |  |  | 11 | Nos
27.5 |  | Addressable Manual Call Point (Model: LD2000EN) |  |  | 6 | Nos
27.6 |  | Horn & Strobe (Model No: LD8402) |  |  | 7 | Nos
27.7 |  | Supervisory Output Module (Model: LD6800EC-1) |  |  | 4 | Nos
27.8 |  | Power Supply (Model No: LD5801E) |  |  | 1 | Nos
27.9 |  | Battery (38Ah12V) |  |  | 2 | Nos
27.10 |  | Alarm Annunciator Panel (LD128E) |  |  | 1 | Nos
27.11 |  | Standard Cabinet (LD5900EL) |  |  | 1 | Nos
27.12 |  | Bus Device Programmer (LD128EN-100) |  |  | 1 | Nos
27.13 |  | Communication Conversion Card (LD6907EN) |  |  | 1 | Nos
27.14 |  | CRT Software |  |  | 1 | Nos
28.0
28.1 |  | Moisture Transmitter (Hygrpro 11R) |  |  | 1 | No
28.2 |  | Sample Cell 2830 |  |  | 1 | No
29.0 | Instrument Panels
29.1 |  | Process Mimic Panel |  |  | 1 | No
29.2 |  | F&G Mimic Panel |  |  | 1 | No
29.3 |  | ESD Hard Wire Console |  |  | 1 | No
29.4 |  | DCS Main Control Panel |  |  | 1 | No
29.5 |  | Control Panel for ESD and F&G |  |  | 1 | No
29.6 |  | Remote IO Control Panel at MCC Room |  |  | 1 | No
 |  | Engineering Station,Operator Station |  |  | 2 | Nos
 |  | Dextop Monitor |  |  | 4 | Nos
 |  | Color Laser Jet Printer |  |  | 1 | Nos
 |  | Dot Printer |  |  | 1 | Nos
 |  | Flow Computer |  |  | 1 | Nos
30.0 | Instrument Junction Boxes as per 252-I JB_14122015
30.1 |  | PCS Marshilling Junction Box |  |  | 5 | sets
30.2 |  | Tag Number: JB-01I, JB-02I, JB-03I, JB-04I, JB-05I
30.3 |  | ESD Junction Box |  |  | 2 | Sets
30.4 |  | Tag Number: JB-06I, JB-07I,
30.5 |  | F&G Junction Box |  |  | 5 | Sets
30.6 |  | Tag Number: JB-08I, JB-09I, JB-10I, JB-11I, JB-12I
30.7 |  | Flow Computer Junction Box |  |  | 1 | Set
30.8 |  | Tag Number : JB-013I
 | Telecommunication System
 |  | PABX |  |  | 1 | Nos
 |  | Master Dextop Telephone Hand Set |  |  | 1 | Nos
 |  | Dextop Telephone Hand Set |  |  | 12 | Nos
 |  | Walki-Talki |  |  | 8 | Nos
 | 4 Way Small JB | For Control valve, ZSC , ZSO signal |  |  | 25 | Sets
 | 3 Way Small JB | Others |  |  | 20 | Sets
 | Various Metal Glands |  |  |  | 1 | lot |  | Information
 | Various Metal Blinds |  |  |  | 1 | lot |  | Information
 | Instrument Cable | 18X2X1.5mm2 |  |  | 1450 | Meter
 |  | 10X2X1.5mm2 |  |  | 1030 | Meter
 |  | 5X2X1.5mm2 |  |  | 490 | Meter
 |  | 2X2X1.5mm2 |  |  | 720 | Meter
 |  | 1X2X1.5mm2 |  |  | 2820 | Meter
 | Instrument Cable For FGS System | 18X2X1.5mm2 |  |  | 680 | Meter
 |  | 10X2X1.5mm2 |  |  | 610 | Meter
 |  | 5X2X1.5mm2 |  |  | 500 | Meter
 |  | 1X2X1.5mm2 |  |  | 730 | Meter
 |  | 2X2X1.5mm2 |  |  | 160 | Meter
 | Fire Retardant Cable For FGS System | 4X2X1.5mm2 |  |  | 150 | Meter
 |  | 3X2X1.5mm2 |  |  | 810 | Meter
 |  | 1X3X1.5mm2 |  |  | 240 | Meter
 |  | 1X2X1.5mm2 |  |  | 450 | Meter
 | Optical Fiber Cable For REMOTE IO | OPTICAL FIBER CABLE |  |  | 350 | Meter
 | Ethernet cable | CAT - 6 |  |  | 400 | Meter
 | Telephone Cable | 4X2X1.5mm2 |  |  | 300 | Meter
 | Telephone Cable | 1X2X1.5mm2 |  |  | 300 | Meter
 |  | K- TypeThermo couple Cable |  |  | 520 | Meter
