skdzicombd/P_252_Documentation/Location J/BOQ/P-252-J CABLE SIZING & BOQ 17.11.15.xlsx

Sheet: COVER
 |  |  |  |  |  | CONSORTIUM OF
 |  |  |  |  |  | SINOPEC PETROLEUM ENGINEERING CORPORATION.
 |  |  |  |  |  | AND
 |  |  |  |  |  | ZICOM EQUIPMENT PTE. LTD.
BANGLADESH GAS FIELDS COMPANY LIMITED
 |  |  |  |  |  | 29 Tuas Avenue 3 Singapore 639420 |  |  | Tel | : +65 6865 1765
 |  |  |  |  |  | E-mail | : zepl@zicomgroup.com |  | Fax | : +65 6865 1764
ELECTRICAL CALCULATION SHEET
 |  |  |  |  |  |  |  | Doc. No:
 |  | Job No. |  | : | 252-J
 |  | Client |  | : | BANGLADESH GAS FIELDS COMPANY LIMITED
 |  | Location |  | : | TITAS GAS FIELD, BRAHMANBARIA, BANGLADESH
 |  | Item No. |  | : | -
 |  | Description |  | : | ELECTRICAL LOAD CALCULATION
 |  | Project Title. |  | : | 2 X 75 MMSCFD GLYCOL DEHYDRATION TYPE GAS PROCESS PLANT
 |  | Year Built |  | : | 2015
Rev. | Date |  | Page | Description of Revision |  |  |  |  | Prepared | Checked | Approved

Sheet: Cable Sizing
 |  |  |  |  | CABLE SIZING
USER |  |  | BANGLADESH GAS FIELDS COMPANY LIMITED |  |  |  | DOC NO. |  |  | REV :
LOCATION |  |  | TITAS GAS FIELD, BRAHMANBARIA, BANGLADESH |  |  |  | SERVICE
PROJECT |  |  | 2 X 75 MMSCFD GLYCOL DEHYDRATION TYPE GAS PROCESS PLANT |  |  |  | TAG NO. | N/A
JOB NO. |  |  | 252 | LOCATION: J |  |  | QUANTITY | N/A
Sl.No | TAG NO. | DISCRIPTION |  |  | CABLE SIZE (sqmm) | FROM | TO | CABLE LENGTH (METER) | KW | Cable type | REMARKS
 | G-01 | GENERATOR 01 |  |  | 1C X 150mm2 | G1 | MCC | 220 | 276 KW |  | 220
 | G-02 | GENERATOR 02 |  |  | 1C X 150mm2 | G2 | MCC | 300 | 276 KW |  | 300
 | MCC PANEL CONNECTION |  |  |  | 1C X 150mm2 | MCC 1 | MCC 2 | 100
 |  | NATIONAL GRID LINE |  |  | 4C X 95mm2 | GRID LINE | MCC | 90 |  |  | 130
 | P-300A-J | CONDENSATE TRANSFER PUMP |  |  | 4C X 6mm2 | MCC | P-300A-J | 250 | 11 KW |  | 200
 | P-300B-J | CONDENSATE TRANSFER PUMP |  |  | 4C X 6mm2 | MCC | P-300B-J | 250 |  |  | 200
 | P-300A-J-LCS | CONDENSATE TRANSFER PUMP-LCS |  |  | 12CX1.5mm2 | MCC | P-300A-J-LCS | 250 |  |  | 200
 | P-300B-J-LCS | CONDENSATE TRANSFER PUMP-LCS |  |  | 12CX1.5mm2 | MCC | P-300B-J-LCS | 250 |  |  | 200
 | P-200A-J | CONDENSATE RECYCLE PUMP |  |  | 4CX 2.5mm2 | MCC | P-200A-J | 260 | 1.5 KW |  | 220
 | P-200B-J | CONDENSATE RECYCLE PUMP |  |  | 4CX 2.5mm2 | MCC | P-200B-J | 260 |  |  | 220
 | P-200A-J-LCS | CONDENSATE RECYCLE PUMP-LCS |  |  | 12CX1.5mm2 | MCC | P-200A-J | 260 |  |  | 220
 | P-200B-J-LCS | CONDENSATE RECYCLE PUMP-LCS |  |  | 12CX1.5mm2 | MCC | P-200B-J | 260 |  |  | 220
 | AC-100A-J | INLET AIR COOLER |  |  | 4C X10mm2 | MCC | AC-100A-J | 170 | 15 KW |  | 120
 | AC-100B-J | INLET AIR COOLER |  |  | 4C X10mm2 | MCC | AC-100B-J | 170 |  |  | 120
 | AC-100A-J-LCS | INLET AIR COOLER-LCS |  |  | 12CX1.5mm2 | MCC | AC-100A-J-LCS | 170 |  |  | 120
 | AC-100B-J-LCS | INLET AIR COOLER-LCS |  |  | 12CX1.5mm2 | MCC | AC-100B-J-LCS | 170 |  |  | 120
 | E-300-J | OVERHEAD GAS COOLER |  |  | 4CX 2.5mm2 | MCC | E-300-J | 150 | 3 KW |  | 120
 | E-300-J-LCS | OVERHEAD GAS COOLER-LCS |  |  | 12CX1.5mm2 | MCC | E-300-J-LCS | 150 |  |  | 120
 | P-400-J | KOD PUMP |  |  | 4CX 2.5mm2 | MCC | P-400-J | 370 | 1.1 KW |  | 320
 | P-400-J-LCS | KOD PUMP-LCS |  |  | 12CX1.5mm2 | MCC | P-400-J-LCS | 370 |  |  | 320
 | P-700-J | DEEP WELL PUMP |  |  | 4C X 4mm2 | MCC | P-700-J | 260 | 7.5 KW |  | 240
 | P-700-J-LCS | DEEP WELL PUMP -LCS |  |  | 12CX1.5mm2 | MCC | P-700-J-LCS | 260 |  |  | 240
 | P-700-J | PUMP TO CONTROL PANEL(Flat Cable) |  |  | 2 (3C x 4 mm2) | PUMP CONTROL PANEL | PUMP | 500 |  |  | 500
 | P-800-J | DEEP WELL PUMP |  |  | 4C X 4mm2 | MCC | P-800-J | 300 | 7.5 KW |  | 240
 | P-800-J-LCS | DEEP WELL PUMP -LCS |  |  | 12CX1.5mm2 | MCC | P-800-J-LCS | 300 |  |  | 240
 | P-800-J | PUMP TO CONTROL PANEL(Flat Cable) |  |  | 2 (3C x 4 mm2) | PUMP CONTROL PANEL | PUMP | 500 |  |  | 500
 | P-500A-J | ELECTRIC FIRE WATER PUMP |  |  | 4C X 185mm2 | MCC | P-500A-J | 260 | 134 KW |  | 220
 | P-500A-J-LCS | ELECTRIC FIRE WATER PUMP-LCS |  |  | 12CX1.5mm2 | MCC | P-500A-J-LCS | 260 |  |  | 220
 | P-500B-J | CONTROL PANEL DIESEL FIRE PUMP |  |  | 4CX 2.5mm2 | MCC | P-500B-J | 260 | 0.5 KW |  | 220
 | P-600-J | JOCKEY PUMP CONTROL PANEL |  |  | 4CX 6mm2 | MCC | P-600-J | 260 | 11 KW |  | 220
 | G-1201-P-J | GENERATOR-1 COOLING TOWER PUMP |  |  | 4CX 4mm2 | MCC | G-1201-P-J | 50 | 5.5 KW |  | 30
 | G-1201-P-J-LCS | GENERATOR-1 COOLING TOWER PUMP-LCS |  |  | 12CX1.5mm2 | MCC | G-1201-P-J-LCS | 50 |  |  | 20
 | G-1201-F-J | GENERATOR-1 COOLING TOWER FAN |  |  | 4CX 4mm2 | MCC | G-1201-F-J | 50 | 5.5 KW |  | 35
 | G-1201-F-J-LCS | GENERATOR-1 COOLING TOWER FAN-LCS |  |  | 12CX1.5mm2 | MCC | G-1201-F-J-LCS | 50 |  |  | 20
 | G-1202-P-J | GENERATOR-2 COOLING TOWER PUMP |  |  | 4CX 4mm2 | MCC | G-1202-P-J | 50 | 5.5 KW |  | 30
 | G-1202-P-J-LCS | GENERATOR-2 COOLING TOWER PUMP-LCS |  |  | 12CX1.5mm2 | MCC | G-1202-P-J-LCS | 50 |  |  | 20
 | G-1202-F-J | GENERATOR-2 COOLING TOWER FAN |  |  | 4CX 4mm2 | MCC | G-1202-F-J | 50 | 5.5 KW |  | 35
 | G-1202-F-J-LCS | GENERATOR-2 COOLING TOWER FAN-LCS |  |  | 12CX1.5mm2 | MCC | G-1202-F-J-LCS | 50 |  |  | 20
 |  | GENERATOR BATTERY CHARGER |  |  | 3CX 2.5mm2 | MCC | BATT CHARGER | 30 |  |  | 30
 |  | UTILITY POWER OPERATION BUILDING |  |  | 4CX 16mm2 | MCC | UTILITY POWER OPERATION BUILDING | 160 | 22 KW |  | 90
 |  | UTILITY POWER WORKSHOP BUILDING |  |  | 4CX 6mm2 | MCC | UTILITY POWER WORKSHOP BUILDING | 120 | 10KW |  | 90
 |  | UTILITY POWER GENERATOR BUILDING |  |  | 4CX 10mm2 | MCC | UTILITY POWER GENERATOR BUILDING | 30 | 15 KW |  | 30
 | LCP-0701-J | FLARE & BURN PIT CONTROL PANEL |  |  | 4CX 2.5mm2 | MCC | CONTROL PANEL | 330 | 3 KW |  | 300
 |  | FLARE PANEL |  |  | 3CX 2.5mm2 | CONTROL PANEL | FLARE PANEL | 50 |  |  | 40
 |  | BURN PIT PANEL |  |  | 3CX 2.5mm2 | CONTROL PANEL | BURN PIT PANEL | 80 |  |  | 60
 | LDP-1401-J | LIGHTING DISTRIBUTION PANEL |  |  | 4CX 16mm2 | MCC | LIGHT PANEL | 20 | 15 KW |  | 20
 |  | TOWER LIGHT-1 (3 No. 200W light each pole) |  |  | 3CX 2.5mm2 | LIGHT PANEL | TOWER LIGHT-1 | 160 | 0.6KW |  | 140
 |  | TOWER LIGHT-2 (3 No. 200W light each pole) |  |  | 3CX 2.5mm2 | LIGHT PANEL | TOWER LIGHT-2 | 120 | 0.6KW |  | 90
 |  | TOWER LIGHT-3 (3 No. 200W light each pole) |  |  | 3CX 2.5mm2 | LIGHT PANEL | TOWER LIGHT-3 | 50 | 0.6KW |  | 30
 |  | TOWER LIGHT-4 (3 No. 200W light each pole) |  |  | 3CX 2.5mm2 | LIGHT PANEL | TOWER LIGHT-4 | 140 | 0.6KW |  | 120
 |  | TOWER LIGHT-5 (3 No. 200W light each pole) |  |  | 3CX 2.5mm2 | LIGHT PANEL | TOWER LIGHT-5 | 320 | 0.6KW |  | 300
 |  | TOWER LIGHT-6 (3 No. 200W light each pole) |  |  | 3CX 2.5mm2 | LIGHT PANEL | TOWER LIGHT-6 | 280 | 0.6KW |  | 260
 |  | TOWER LIGHT INTERNAL WIRING |  |  | 3CX 2.5mm2 | LIGHT | TOWER JB | 360 |  |  | 350
 |  | PIPE RACK LIGHT-1 (8 No. 100W light) |  |  | 3CX 2.5mm2 | LIGHT PANEL | PIPE RACK LIGHT-1 | 280 | 0.8KW |  | 280
 |  | PIPE RACK LIGHT-2 (8 No. 100W light) |  |  | 3CX 2.5mm2 | LIGHT PANEL | PIPE RACK LIGHT-2 | 280 | 0.8KW |  | 280
 |  | TRANSFER PUMP SHED LIGHT (2 No.36W each light) |  |  | 3CX 2.5mm2 | LIGHT PANEL | TRANSFER PUMP SHED LIGHT | 240 | 0.072KW |  | 240
 |  | RECYCLE PUMP SHED LIGHT (2 No.36W each light) |  |  | 3CX 2.5mm2 | LIGHT PANEL | RECYCLE PUMP SHED LIGHT | 270 | 36 W |  | 220
 |  | DELUGE VALVE & FOAM TANK SHED LIGHT (2 No.36W each light) |  |  | 3CX 2.5mm2 | LIGHT PANEL | FIRE WATER PUMP SHED LIGHT | 260 | 0.072KW |  | 260
 |  | FIRE WATER PUMP SHED LIGHT (2set.72W each light) |  |  | 3CX 2.5mm2 | LIGHT PANEL | FIRE WATER PUMP SHED LIGHT | 250 | 0.072KW |  | 160
 |  | TEG TOWER LIGHT (2 No. 100W light) |  |  | 3CX 2.5mm2 | PIPE RACK LIGHT-2 | TEG TOWER | 50 | 200 W |  | 30
 |  | AIR-CRAFT WARNING LIGHT(50W) |  |  | 3CX 2.5mm2 | LIGHT PANEL | AIR-CRAFT WARNING LIGHT | 420 | 50 W |  | 420
 |  | LOADING AREA SHED LIGHT (2 No. 200W each light) |  |  | 3CX 2.5mm2 | LIGHT PANEL | LOADING AREA SHED LIGHT | 80 | 0.4KW |  | 70
 | R-100-J | GLYCOL REBOILER (5kw) |  |  | 4CX 2.5mm2 | MCC | GLYCOL REBOILER | 160 | 5 KW |  | 140
 | H-100-J | WATER BATH HEATER (6 KW) X 2.5 |  |  | 4CX 2.5mm2 | MCC | WBH PANEL | 160 | 6 KW |  | 140
 |  | INSTRUMENT CABLE 24 CORE X 1.5 |  |  | 24CX 1.5mm2 | WBH PANEL | WATER BATH HEATER | 200
 |  | INSTRUMENT CABLE 12 CORE 1.5 |  |  | 12CX 1.5mm2 | WBH PANEL | WATER BATH HEATER | 160
 |  | BLOWER FOR WBH 4 x 2.5 |  |  | 4CX 2.5mm2 | WBH PANEL | WATER BATH HEATER | 160 |  |  | 140
 | 02-UPS-1201-J | UPS SYSTEM 1 |  |  | 3CX 4mm2 | MCC | UPS-1 | 100 | 6 KVA |  | 70
 | 02-UPS-1202-J | UPS SYSTEM 2 |  |  | 3CX 4mm2 | MCC | UPS-2 | 100 | 6 KVA |  | 70
 | 02-UPS-1201 & 2-J | UPS-1&2-DB |  |  | 3CX 4mm2 | UPS-1&2 | UPS-1&2-DB | 20 |  |  | 10
 |  | DCS PANEL |  |  | 3CX 2.5mm2 | UPS-1&2-DB | DCS PANEL | 50 | 0.4KW |  | 30
 |  | ENGINEERING STATION |  |  | 3CX 2.5mm2 | UPS-1&2-DB | ENG STATION | 50 | 0.4KW |  | 40
 |  | OPERATOR STATION |  |  | 3CX 2.5mm2 | UPS-1&2-DB | OP STATION | 50 | 0.4KW |  | 40
 |  | MCC I/O RIO-001 |  |  | 3CX 2.5mm2 | UPS-1&2-DB | MCC ROOM, | 100 | 0.25KW |  | 70
 |  | PLANT MIMIC PANEL |  |  | 3CX 2.5mm2 | UPS-1&2-DB | PLANT MIMIC BOARD | 50 | 0.2KW |  | 50
 |  | INTERCOM SYSTEM |  |  | 3CX 2.5mm2 | UPS-1&2-DB | INTERCOM SYSTEM | 50 | 0.05 KW |  | 50
 |  | WBH |  |  | 3CX 2.5mm2 | UPS-1&2-DB | WBH | 40 | 0.2 KW |  | 40
 |  | REBOILER |  |  | 3CX 2.5mm2 | UPS-1&2-DB | REBOILER | 140 | 0.2 KW |  | 140
 |  | FLARE CONTROL PANEL |  |  | 3CX 2.5mm2 | UPS-1&2-DB | FLARE CONTROL | 370 | 0.2 KW |  | 300
 |  | PRINTER |  |  | 3CX 2.5mm2 | UPS-1&2-DB | PRINTER | 50 | 0.05 KW |  | 50
 |  | LASER PRINTER |  |  | 3CX 2.5mm2 | UPS-1&2-DB | LASER PRINTER | 50 | 0.1 KW |  | 50
 |  | UPS-3 |  |  | 3CX 2.5mm2 | UPS-1&2-DB | UPS-3 | 10 | 1 KVA |  | 10
 |  | FLOW COMPUTER |  |  | 3CX 2.5mm2 | UPS-1&2-DB | FLOW COMPUTER | 40 | 0.052 KW |  | 40
 | 02-UPS-1203-J | UPS (FIRE & GAS) |  |  | 3CX 2.5mm2 | UPS-2 | UPS-3 | 10 | 1 KVA |  | 10
 | 02-UPS-1203-J | UPS-3-DB |  |  | 3CX 2.5mm2 | UPS-3 | UPS-3-DB | 10 |  |  | 10
 |  | FIRE PANEL |  |  | 3CX 2.5mm2 | UPS-3-DB | FIRE PANEL | 50 | 0.1 KW |  | 30
 |  | FIRE MIMIC PANEL |  |  | 3CX 2.5mm2 | UPS-3-DB | FIRE MIMIC PANEL | 50 | 0.05 KW |  | 30
 |  | ALARM SYSTEM |  |  | 3CX 2.5mm2 | UPS-3-DB | ALARM SYSTEM | 50 | 0.2 KW |  | 30
 |  | POWER SUPPLY |  |  | 3CX 2.5mm2 | UPS-3-DB | POWER SUPPLY | 50 | 0.14 KW |  | 30
 | 02-UPS-1204-J | UPS (EMERGENCY LIGHTING) |  |  | 3CX 2.5mm2 | MCC | UPS-4 | 180 | 2 KVA |  | 60
 |  | UPS-4-DB |  |  | 3CX 2.5mm2 | UPS-4 | UPS-4-DB | 10 |  |  | 10
 |  | CONTROL ROOM |  |  | 3CX 2.5mm2 | UPS-4-DB | CONTROL ROOM | 50 | 0.4 KW |  | 50
 |  | GENERATOR ROOM |  |  | 3CX 2.5mm2 | UPS-4-DB | GEN ROOM | 50 | 0.24 KW |  | 60
 |  | MCC ROOM |  |  | 3CX 2.5mm2 | UPS-4-DB | MCC ROOM | 50 | 0.16 KW |  | 60
 |  | WORKSHOP BUILDING LIGHT |  |  | 3CX 2.5mm2 | UPS-4-DB | WORKSHOP BUILD. | 50 | 0.24 KW |  | 80
 |  | FIRE WATER PUMP SHED |  |  | 3CX 2.5mm2 | UPS-4-DB | FIRE PUMP SHED | 200 | 0.072 KW |  | 200
 | E-300 | COOLER COOLING FAN MOTOR POWER |  |  | 3C X 2.5mm2 | MCC | E-300 | 150 | 0.25 KW
REV | DATE |  |  | DESCRIPTION OF REVISION |  |  |  | PREPARED | CHECKED | APPROVED

Sheet: Cable length details
 |  |  |  |  | CABLE LENGTH DETAILS
USER |  |  | BANGLADESH GAS FIELDS COMPANY LIMITED |  |  |  | DOC NO. |  |  | REV :
LOCATION |  |  | TITAS GAS FIELD, BRAHMANBARIA, BANGLADESH |  |  |  | SERVICE
PROJECT |  |  | 2 X 75 MMSCFD GLYCOL DEHYDRATION TYPE GAS PROCESS PLANT |  |  |  | TAG NO. | N/A
JOB NO. |  |  | 252 | LOCATION: J |  |  | QUANTITY | N/A
Sl.No | TAG NO. | DISCRIPTION |  |  | CABLE SIZE (sqmm) | FROM | TO | CABLE LENGTH (METER) |  | Cable type | REMARKS
 | G-01 | GENERATOR 01 |  |  | 1C X 150mm2 | G1 | MCC | 220
 | G-02 | GENERATOR 02 |  |  | 1C X 150mm2 | G2 | MCC | 300
 | MCC PANEL CONNECTION |  |  |  | 1C X 150mm2 | MCC 1 | MCC 2 | 100
 |  | TOTAL |  |  | 1C X 150mm2 |  |  | 620
 | GRID | NATIONAL GRID LINE |  |  | 4C X 95mm2 | GRID LINE | MCC | 90
 | AC-100A-I | INLET AIR COOLER |  |  | 4C X10mm2 | MCC | AC-100A-I | 170
 | AC-100B-I | INLET AIR COOLER |  |  | 4C X10mm2 | MCC | AC-100B-I | 170
 |  | UTILITY POWER GENERATOR BUILDING |  |  | 4CX 10mm2 | MCC | UTILITY POWER GENERATOR BULDING | 30
 |  | TOTAL |  |  | 4C X10mm2 |  |  | 370
 |  | UTILITY POWER OPERATION BULDING |  |  | 4CX 16mm2 | MCC | UTILITY POWER OPERATION BULDING | 160
 |  | LIGHTING DISTRIBUTION PANEL |  |  | 4CX 16mm2 | MCC | LIGHT PANEL | 20
 |  | TOTAL |  |  | 4C X 16mm2 |  |  | 180
 | P-300A-I | CONDENSATE TRANSFER PUMP |  |  | 4C X 6mm2 | MCC | P-300A-I | 250
 | P-300B-I | CONDENSATE TRANSFER PUMP |  |  | 4C X 6mm2 | MCC | P-300B-I | 250
 | P-600-I | JOCKEY PUMP CONTROL PANEL |  |  | 4CX 6mm2 | MCC | P-600-I | 260
 |  | UTILITY POWER WORKSHOP BULDING |  |  | 4CX 6mm2 | MCC | UTILITY POWER WORKSHOP BULDING | 120
 |  | TOTAL |  |  | 4C X 6mm2 |  |  | 880
 | P-700-I | DEEP WELL PUMP |  |  | 4C X 4mm2 | MCC | P-700-I | 260
 | G-1201-P-I | GENERATOR-1 COOLING TOWER PUMP |  |  | 4CX 4mm2 | MCC | G-1201-P-I | 50
 | G-1201-F-I | GENERATOR-1 COOLING TOWER FAN |  |  | 4CX 4mm2 | MCC | G-1201-F-I | 50
 | G-1202-P-I | GENERATOR-2 COOLING TOWER PUMP |  |  | 4CX 4mm2 | MCC | G-1202-P-I | 50
 | G-1202-F-I | GENERATOR-2 COOLING TOWER FAN |  |  | 4CX 4mm2 | MCC | G-1202-F-I | 50
 | P-800-I | DEEP WELL PUMP |  |  | 4C X 4mm2 | MCC | P-800-I | 300
 |  | TOTAL |  |  | 4C X 4mm2 |  |  | 760
 | P-200A-I | CONDENSATE RECYCLE PUMP |  |  | 4CX 2.5mm2 | MCC | P-200A-I | 260
 | P-200B-I | CONDENSATE RECYCLE PUMP |  |  | 4CX 2.5mm2 | MCC | P-200B-I | 260
 | E-300-I | OVERHEAD GAS COOLER |  |  | 4CX 2.5mm2 | MCC | E-300-I | 150
 | P-400-I | KOD PUMP |  |  | 4CX 2.5mm2 | MCC | P-400-I | 370
 | P-500B-I | CONTROL PANEL DIESEL FIRE PUMP |  |  | 4CX 2.5mm2 | MCC | P-500B-I | 260
 | LCP-0701-I | FLARE & BURN PIT CONTROL PANEL |  |  | 4CX 2.5mm2 | MCC | CONTROL PANEL | 330
 | R-100-I | GLYCOL REBOILER (5kw) |  |  | 4CX 2.5mm2 | MCC | GLYCOL REBOILER | 160
 | H-100-I | WATER BATH HEATER (6 KW) X 2.5 |  |  | 4CX 2.5mm2 | MCC | WBH PANEL | 160
 |  | BLOWER FOR WBH |  |  | 4CX 2.5mm2 | WBH PANEL | WATER BATH HEATER | 160
 |  | TOTAL |  |  | 4CX 2.5mm2 |  |  | 2110
 | P-300A-I-LCS | CONDENSATE TRANSFER PUMP-LCS |  |  | 12CX1.5mm2 | MCC | P-300A-I-LCS | 250
 | P-300B-I-LCS | CONDENSATE TRANSFER PUMP-LCS |  |  | 12CX1.5mm2 | MCC | P-300B-I-LCS | 250
 | P-200A-I-LCS | CONDENSATE RECYCLE PUMP-LCS |  |  | 12CX1.5mm2 | MCC | P-200A-I | 260
 | P-200B-I-LCS | CONDENSATE RECYCLE PUMP-LCS |  |  | 12CX1.5mm2 | MCC | P-200B-I | 260
 | AC-100A-I-LCS | INLET AIR COOLER-LCS |  |  | 12CX1.5mm2 | MCC | AC-100A-I-LCS | 170
 | AC-100B-I-LCS | INLET AIR COOLER-LCS |  |  | 12CX1.5mm2 | MCC | AC-100B-I-LCS | 170
 | E-300-I-LCS | OVERHEAD GAS COOLER-LCS |  |  | 12CX1.5mm2 | MCC | E-300-I-LCS | 150
 | P-400-I-LCS | KOD PUMP-LCS |  |  | 12CX1.5mm2 | MCC | P-400-I-LCS | 370
 | P-700-I-LCS | DEEP WELL PUMP -LCS |  |  | 12CX1.5mm2 | MCC | P-700-I-LCS | 260
 | P-800-I-LCS | DEEP WELL PUMP -LCS |  |  | 12CX1.5mm2 | MCC | P-800-I-LCS | 300
 | P-500A-I-LCS | ELECTRIC FIRE WATER PUMP-LCS |  |  | 12CX1.5mm2 | MCC | P-500A-I-LCS | 260
 | G-1201-P-I-LCS | GENERATOR-1 COOLING TOWER PUMP-LCS |  |  | 12CX1.5mm2 | MCC | G-1201-P-I-LCS | 50
 | G-1201-F-I-LCS | GENERATOR-1 COOLING TOWER FAN-LCS |  |  | 12CX1.5mm2 | MCC | G-1201-F-I-LCS | 50
 | G-1202-P-I-LCS | GENERATOR-2 COOLING TOWER PUMP-LCS |  |  | 12CX1.5mm2 | MCC | G-1202-P-I-LCS | 50
 | G-1202-F-I-LCS | GENERATOR-2 COOLING TOWER FAN-LCS |  |  | 12CX1.5mm2 | MCC | G-1202-F-I-LCS | 50
 |  | INSTRUMENT CABLE 12 CORE 1.5 |  |  | 12CX 1.5mm2 | WBH PANEL | WATER BATH HEATER | 160
 |  | TOTAL |  |  | 12C X 1.5mm2 |  |  | 3060
 | P-700-I | PUMP TO CONTROL PANEL(Flat Cable) |  |  | 2 (3C x 4 mm2) | PUMP CONTROL PANEL | PUMP | 500
 | P-800-I | PUMP TO CONTROL PANEL(Flat Cable) |  |  | 2 (3C x 4 mm2) | PUMP CONTROL PANEL | PUMP | 500
 |  | TOTAL |  |  | 2 (3C x 4 mm2) |  |  | 1000
 | 02-UPS-1201-I | UPS SYSTEM 1 |  |  | 3CX 4mm2 | MCC | UPS-1 | 100
 | 02-UPS-1202-I | UPS SYSTEM 2 |  |  | 3CX 4mm2 | MCC | UPS-2 | 100
 | 02-UPS-1201 & 2-I | UPS-1&2-DB |  |  | 3CX 4mm2 | UPS-1&2 | UPS-1&2-DB | 20
 |  | TOTAL |  |  | 3CX 4mm2 |  |  | 220
 |  | E-300 |  |  | 3CX 2.5mm2 | MCC | E-300 | 150
 |  | FLARE PANEL |  |  | 3CX 2.5mm2 | CONTROL PANEL | FLARE PANEL | 50
 |  | BURN PIT PANEL |  |  | 3CX 2.5mm2 | CONTROL PANEL | BURN PIT PANEL | 80
 |  | TOWER LIGHT-1 (3 No. 200W light each pole) |  |  | 3CX 2.5mm2 | LIGHT PANEL | TOWER LIGHT-1 | 160
 |  | TOWER LIGHT-2 (3 No. 200W light each pole) |  |  | 3CX 2.5mm2 | LIGHT PANEL | TOWER LIGHT-2 | 120
 |  | TOWER LIGHT-3 (3 No. 200W light each pole) |  |  | 3CX 2.5mm2 | LIGHT PANEL | TOWER LIGHT-3 | 50
 |  | TOWER LIGHT-4 (3 No. 200W light each pole) |  |  | 3CX 2.5mm2 | LIGHT PANEL | TOWER LIGHT-4 | 140
 |  | TOWER LIGHT-5 (3 No. 200W light each pole) |  |  | 3CX 2.5mm2 | LIGHT PANEL | TOWER LIGHT-5 | 320
 |  | TOWER LIGHT-6 (3 No. 200W light each pole) |  |  | 3CX 2.5mm2 | LIGHT PANEL | TOWER LIGHT-6 | 280
 |  | TOWER LIGHT INTERNAL WIRING |  |  | 3CX 2.5mm2 | LIGHT | TOWER JB | 360
 |  | PIPE RACK LIGHT-1 (8 No. 100W light) |  |  | 3CX 2.5mm2 | LIGHT PANEL | PIPE RACK LIGHT-1 | 280
 |  | PIPE RACK LIGHT-2(8 No. 100W light) |  |  | 3CX 2.5mm2 | LIGHT PANEL | PIPE RACK LIGHT-2 | 280
 |  | TRANSFER PUMP SHED LIGHT (2 No.36W each light) |  |  | 3CX 2.5mm2 | LIGHT PANEL | TRANSFER PUMP SHED LIGHT | 240
 |  | RECYCLE PUMP SHED LIGHT (2 No.36W each light) |  |  | 3CX 2.5mm2 | LIGHT PANEL | RECYCLE PUMP SHED LIGHT | 270
 |  | FIRE WATER PUMP SHED LIGHT (2set.72W each light) |  |  | 3CX 2.5mm2 | LIGHT PANEL | FIRE WATER PUMP SHED LIGHT | 250
 |  | DELUGE VALVE & FOAM TANK (2 No.36W each light) |  |  | 3CX 2.5mm2 | LIGHT PANEL | FIRE WATER PUMP SHED LIGHT | 260
 |  | TEG TOWER LIGHT (2 No. 100W light) |  |  | 3CX 2.5mm2 | PIPE RACK LIGHT-2 | TEG TOWER | 50
 |  | AIR-CRAFT WARNING LIGHT(50W) |  |  | 3CX 2.5mm2 | LIGHT PANEL | AIR-CRAFT WARNING LIGHT | 420
 |  | LOADING AREA SHED LIGHT (3 No. 200W each light) |  |  | 3CX 2.5mm2 | LIGHT PANEL | LOADING AREA SHED LIGHT | 80
 |  | DCS PANEL |  |  | 3CX 2.5mm2 | UPS-1&2-DB | DCS PANEL | 50
 |  | ENGINEERING STATION |  |  | 3CX 2.5mm2 | UPS-1&2-DB | ENG STATION | 50
 |  | OPERATOR STATION |  |  | 3CX 2.5mm2 | UPS-1&2-DB | OP STATION | 50
 |  | MCC I/O RIO-001 |  |  | 3CX 2.5mm2 | UPS-1&2-DB | MCC ROOM, | 100
 |  | PLANT MIMIC PANEL |  |  | 3CX 2.5mm2 | UPS-1&2-DB | PLANT MIMIC BOARD | 50
 |  | INTERCOM SYSTEM |  |  | 3CX 2.5mm2 | UPS-1&2-DB | INTERCOM SYSTEM | 50
 |  | WBH |  |  | 3CX 2.5mm2 | UPS-1&2-DB | WBH | 40
 |  | REBOILER |  |  | 3CX 2.5mm2 | UPS-1&2-DB | REBOILER | 140
 |  | FLARE CONTROL PANEL |  |  | 3CX 2.5mm2 | UPS-1&2-DB | FLARE CONTROL | 370
 |  | PRINTER |  |  | 3CX 2.5mm2 | UPS-1&2-DB | PRINTER | 50
 |  | LASER PRINTER |  |  | 3CX 2.5mm2 | UPS-1&2-DB | LASER PRINTER | 50
 |  | UPS-3 |  |  | 3CX 2.5mm2 | UPS-1&2-DB | UPS-3 | 10
 |  | FLOW COMPUTER |  |  | 3CX 2.5mm2 | UPS-1&2-DB | FLOW COMPUTER | 40
 |  | UPS (FIRE & GAS) |  |  | 3CX 2.5mm2 | UPS-2 | UPS-3 | 10
 |  | UPS-3-DB |  |  | 3CX 2.5mm2 | UPS-3 | UPS-3-DB | 10
 |  | FIRE PANEL |  |  | 3CX 2.5mm2 | UPS-3-DB | FIRE PANEL | 50
 |  | FIRE MIMIC PANEL |  |  | 3CX 2.5mm2 | UPS-3-DB | FIRE MIMIC PANEL | 50
 |  | ALARM SYSTEM |  |  | 3CX 2.5mm2 | UPS-3-DB | ALARM SYSTEM | 50
 |  | POWER SUPPLY |  |  | 3CX 2.5mm2 | UPS-3-DB | POWER SUPPLY | 50
 |  | UPS (EMERGENCY LIGHTING) |  |  | 3CX 2.5mm2 | MCC | UPS-4 | 180
 |  | UPS-4-DB |  |  | 3CX 2.5mm2 | UPS-4 | UPS-4-DB | 10
 |  | CONTROL ROOM |  |  | 3CX 2.5mm2 | UPS-4-DB | CONTROL ROOM | 50
 |  | GENERATOR ROOM |  |  | 3CX 2.5mm2 | UPS-4-DB | GEN ROOM | 50
 |  | MCC ROOM |  |  | 3CX 2.5mm2 | UPS-4-DB | MCC ROOM | 50
 |  | WORKSHOP BUILDING LIGHT |  |  | 3CX 2.5mm2 | UPS-4-DB | WORKSHOP BUILD. | 50
 |  | FIRE WATER PUMP SHED |  |  | 3CX 2.5mm2 | UPS-4-DB | FIRE PUMP SHED | 200
 |  | TOTAL |  |  | 3C X 2.5mm2 |  |  | 5700
 | P-500A-I | ELECTRIC FIRE WATER PUMP |  |  | 4C X 185mm2 | MCC | P-500A-I | 260
 |  | TOTAL |  |  | 4C X 185mm2 |  |  | 260
 |  | INSTRUMENT CABLE 24 CORE X 1.5 |  |  | 24CX 1.5mm2 | WBH PANEL | WATER BATH HEATER | 200
REV | DATE |  |  | DESCRIPTION OF REVISION |  |  |  | PREPARED | CHECKED | APPROVED

Sheet: Cable Length Summary
 |  |  |  |  | CABLE LENGTH SUMMARY
USER |  |  | BANGLADESH GAS FIELDS COMPANY LIMITED |  |  |  | DOC NO. |  |  |  | REV :
LOCATION |  |  | TITAS GAS FIELD, BRAHMANBARIA, BANGLADESH |  |  |  | SERVICE
PROJECT |  |  | 2 X 75 MMSCFD GLYCOL DEHYDRATION TYPE GAS PROCESS PLANT |  |  |  | TAG NO. | N/A
JOB NO. |  |  | 252 | LOCATION: J |  |  | QUANTITY | N/A
Sl.No | TAG NO. | DISCRIPTION |  |  | CABLE SIZE (sqmm) | FROM | TO | CABLE LENGTH (METER) | PO | KW | REMARKS
1 |  | Armoured Power cable |  |  | 3CX 2.5mm2 |  |  | 5700 | 6250
2 |  | Armoured Power cable |  |  | 3CX 4mm2 |  |  | 220 | 250
3 |  | Armoured Power cable |  |  | 4CX 2.5mm2 |  |  | 2110 | 2330
4 |  | Armoured Power cable |  |  | 4CX 4mm2 |  |  | 760 | 840
5 |  | Armoured Power cable |  |  | 4CX 6mm2 |  |  | 880 | 970
6 |  | Armoured Power cable |  |  | 4CX 10mm2 |  |  | 370 | 410
7 |  | Armoured Power cable |  |  | 4CX 16mm2 |  |  | 180 | 220
9 |  | Armoured Power cable |  |  | 12CX1.5mm2 |  |  | 3060 | 3360
11 |  | Armoured Power cable |  |  | 3C x 4 mm2(Flat) |  |  | 1000 | 1000
12 |  | Armoured Power cable |  |  | 1C X 150 mm2 |  |  | 620 | 680
 |  | Armoured Power cable |  |  | 4C X 95 mm2 |  |  | 90 | 110 |  | As per plot plan
 |  | Armoured Power cable |  |  | 4C x 185 mm2 |  |  | 260 | 290
 |  | Armoured Power cable |  |  | 24C x 1.5 mm2 |  |  | 200 | 160
REV | DATE |  |  | DESCRIPTION OF REVISION |  |  |  | PREPARED |  | CHECKED | APPROVED

Sheet: OLD BOQ
USER |  | BANGLADESH GAS FIELDS COMPANY LIMITED |  |  |  | DOC NO. |  |  | REV :
LOCATION |  | TITAS GAS FIELD, BRAHMANBARIA, BANGLADESH |  |  |  | SERVICE
PROJECT |  | 2 x 75 MMSCFD GLYCOL DEHYDRATION TYPE GAS PROCESS PLANT |  |  |  | TAG NO. | N/A
JOB NO. |  | 252 | J LOCATION |  |  | QUANTITY | N/A
Sl.No | Category | Description of Materials |  |  | Quantity | Unit |  | Remarks
 |  | Equipment
 | MCC Room | Incoming Panel | Feeder (Incoming Panel) | Feeder (Incoming Panel) | 1 | No
 |  | MCC Panel | MCC Panel | MCC Panel | 1 | Set
 |  | PFI Panel | PFI Panel | PFI Panel | 1 | No
 |  | Light Distribution Panel | Light Distribution Panel | Light Distribution Panel | 1 | No
 |  | Battery Charger 12 volt & 24 Volt, 20Amp |  |  | 1 | No
 |  | Distribution Panel for Operation Building | Distribution Panel for Operation Building | Distribution Panel for Operation Building | 1 | No |  |  | At Dhaka. (PSI not needed)
 |  | Distribution Panel for Workshop Building | Distribution Panel for Workshop Building | Distribution Panel for Workshop Building | 1 | No |  |  | At Dhaka. (PSI not needed)
 |  | Distribution Panel for generation Building | Distribution Panel for generation Building | Distribution Panel for generation Building | 1 | No |  |  | At Dhaka. (PSI not needed)
 |  | Star Delta motor starter panel for P700 | Star Delta motor starter panel for P700 | Star Delta motor starter panel for P700 | 1 | No |  |  | At Dhaka. (PSI not needed)
 |  | Star Delta motor starter panel for P800 | Star Delta motor starter panel for P800 | Star Delta motor starter panel for P800 | 1 | No |  |  | At Dhaka. (PSI not needed)
 |  | UPS(6kVA) | UPS(6kVA) | UPS(6kVA) | 2 | Nos
 |  | UPS(2kVA) | UPS(2kVA) | UPS(2kVA) | 1 | No
 |  | UPS(1kVA) | UPS(1kVA) | UPS(1kVA) | 1 | No
 |  | UPS Power Distribution Box |  |  | 3 | Nos |  |  | Newly Added
 |  | Plant Light Poles with fitting fixing accessories. (3 No. 200 W light in each pole) | TOWER LIGHT(200W light | TOWER LIGHT(200W light | 6 | Sets
 |  | Pipe Rack Light (100W light) | PIPE RACK LIGHT (100W light) | PIPE RACK LIGHT (100W light) | 15 | Nos
 |  | Deluge Valve & Foam Tank(36W) |  |  | 2 | Nos
 |  | TEG Tower Light (100W light) | TEG TOWER LIGHT (100W light) | TEG TOWER LIGHT (100W light) | 2 | Nos
 |  | Air-Craft Warning Light for Flare (50W light) | AIR-CRAFT WARNING LIGHT (50W light) | AIR-CRAFT WARNING LIGHT (50W light) | 1 | No
 |  | Shed Light (2 No.18W each light) Explosion Proof | SHED LIGHT (2 No.36W each light) | SHED LIGHT (2 No.36W each light) | 8 | Nos
 |  | Loading Area Shed Light (200W each light) Pxplosion proof | LOADING AREA SHED LIGHT (200W each light) | LOADING AREA SHED LIGHT (200W each light) | 2 | Nos
 |  | Surge Protection Device Three Phase (Type 1 SPD) | Surge protection Device | Surge protection Device | 2 | Nos
 |  | Surge Protection Device Single Phase (Type 1 SPD) | Surge protection Device | Surge protection Device | 3 | Nos
 |  | Cathodic Protection for Condensate Tank | Cathodic Protection | Cathodic Protection | 1 | lot |  |  | Details BOQ Required
 |  | Cathodic Protection for Underground Pipe | Cathodic Protection | Cathodic Protection | 1 | lot |  |  | Details BOQ Required
 |  | Water Softener Plant for Cooling Tower
 | LCS | LCS (Local Control Station) | LCS without selector switch | LCS without selector switch | 6 | pcs |  |  | Datasheet needed
 |  | LCS (Local Control Station) with Three Position Selector Switch. | LCS with selector switch | LCS with selector switch | 9 | pcs |  |  | Datasheet needed
 | Grounding Systems | Grounding Cable for Generator 1 ,Size 95 sqmm, RM ( two boring ) | Grounding Cable for Generator 1 ,Size 95 RM ( two boring ) | Grounding Cable for Generator 1 ,Size 95 RM ( two boring ) | 133 | meter
 |  | Grounding Cable for Generator 2 ,Size 95 sqmm, RM ( two boring ) | Grounding Cable for Generator 2 ,Size 95 RM ( two boring ) | Grounding Cable for Generator 2 ,Size 95 RM ( two boring ) | 133 | meter
 |  | Grounding Cable for MCC Room Size 95 sqmm, RM ( two boring ) | Grounding Cable for MCC Room Size 95 RM ( two boring ) | Grounding Cable for MCC Room Size 95 RM ( two boring ) | 133 | meter
 |  | Grounding Cable for Control Panel Size 95 sqmm, RM ( two boring ) | Grounding Cable for Control Panel Size 95 RM ( two boring ) | Grounding Cable for Control Panel Size 95 RM ( two boring ) | 133 | meter
 |  | Grounding Cable for Workshop Building Size 95 sqmm, RM ( One boring ) | Grounding Cable for Workshop Building Size 95 RM ( One boring ) | Grounding Cable for Workshop Building Size 95 RM ( One boring ) | 66 | meter
 |  | Grounding Cable for Flare Stack Size 95 sqmm RM ( Two boring ) | Grounding Cable for Flare Stack Size 95 RM ( Two boring ) | Grounding Cable for Flare Stack Size 95 RM ( Two boring ) | 133 | meter
 |  | Grounding Cable for Loading Station Size 95 sqmm, RM ( Two boring ) | Grounding Cable for Loading Station Size 95 RM ( Two boring ) | Grounding Cable for Loading Station Size 95 RM ( Two boring ) | 133 | meter
 |  | Grounding Cable for Tank Size 95 sqmm, RM ( Two boring ) | Grounding Cable for Tank Size 95 RM ( Two boring ) | Grounding Cable for Tank Size 95 RM ( Two boring ) | 133 | meter
 |  | Grounding Cable for Condenset Pump Size 95 sqmm, RM ( One boring ) | Grounding Cable for Condenset Pump Size 95 RM ( One boring ) | Grounding Cable for Condenset Pump Size 95 RM ( One boring ) | 10 | meter
 |  | Grounding Cable for Fire Water Pump Sheed Size 95 sqmm, RM ( One boring ) | Grounding Cable for Fire Water Pump Sheed Size 95 RM ( One boring ) | Grounding Cable for Fire Water Pump Sheed Size 95 RM ( One boring ) | 10 | meter
 |  | Skid inter-connection Cable, PVC Insulated Cable Size 16 sqmm, RM | Skid inter-connection Cable, PVC Insulated Cable Size 16 RM | Skid inter-connection Cable, PVC Insulated Cable Size 16 RM | 500 | meter
 |  | Grounding Cable for lightning protection Size 95 sqmm, RM ( Ten boring ) | Grounding Cable for Fire Water Pump Sheed Size 95 RM ( One boring ) | Grounding Cable for Fire Water Pump Sheed Size 95 RM ( One boring ) | 240 | meter
 |  | Solid Copper Rod (8mm Dia) for MCC & Generator Building Top | Solid Copper Rod (8mm Dia) for MCC & Generator Building Top | Solid Copper Rod (8mm Dia) for MCC & Generator Building Top | 50 | meter
 |  | Solid Copper Rod (8mm Dia) for Control Building Top | Solid Copper Rod (8mm Dia) for Control Building Top | Solid Copper Rod (8mm Dia) for Control Building Top | 50 | meter
 |  | Solid Copper Rod (8mm Dia) for Work Shoop Building Top | Solid Copper Rod (8mm Dia) for Work Shoop Building Top | Solid Copper Rod (8mm Dia) for Work Shoop Building Top | 50 | meter
 |  | Solid Copper Rod (8mm Dia) for Transfer Pump Shed Top | Solid Copper Rod (8mm Dia) for Transfer Pump Shed Top | Solid Copper Rod (8mm Dia) for Transfer Pump Shed Top | 15 | meter
 |  | Solid Copper Rod (8mm Dia) for Recycle Pump Shed Top | Solid Copper Rod (8mm Dia) for Recycle Pump Shed Top | Solid Copper Rod (8mm Dia) for Recycle Pump Shed Top | 40 | meter
 |  | Solid Copper Rod (8mm Dia) for Fire Water Pump Shed Top | Solid Copper Rod (8mm Dia) for Fire Water Pump Shed Top | Solid Copper Rod (8mm Dia) for Fire Water Pump Shed Top | 50 | meter
 |  | Solid Copper Rod (8mm Dia) for Loading Area Shed Top | Solid Copper Rod (8mm Dia) for Loading Area Shed Top | Solid Copper Rod (8mm Dia) for Loading Area Shed Top | 50 | meter
 |  | Grounding Rod, Each two meter length, Dia. 25mm | Grounding Rod, Each two meter length | Grounding Rod, Each two meter length | 45 | Nos
 |  | 5m Static Grounding Clamp 40mm Jaw Opening. (For Loading Station) | 5m Static Grounding Clamp 40mm Jaw Opening. | 5m Static Grounding Clamp 40mm Jaw Opening. | 2 | Nos |  |  | RS Component
 |  | Joint connector (25mm dia to 95sqmm cable) | Joint Nut & Bolt 8mm Dia ( Short Length ) | Joint Nut & Bolt 8mm Dia ( Short Length ) | 45 | Nos
 |  | Copper Nut Bolt With Washer |  |  | 100 | Nos
 | Cable Tray | Cable Tray With Cover Size 400 X 200 for Power Cable (Each 3 meter length) |  |  | 65 | Nos
 |  | Cable Tray With Cover Size 400 X 150 for Instrumentation Cable (Each 3 meter length) | Cable tray 400x150 | Cable tray 400x150 | 20 | Nos
 |  | Elbow 400 x 200 X 400 for Cable Tray Size 400 X 200 | Cable tray 400x150 | Cable tray 400x150 | 8 | Nos
 |  | Elbow 400 x 150 X 400 for Cable Tray Size 400 X 150 | Cable tray 400x150 | Cable tray 400x150 | 8 | Nos
 |  | Flexible Riser 400 x 200 X 400 for Cable Tray Size 400 X 200 | Cable tray 400x150 | Cable tray 400x150 | 4 | Nos |  |  | 90deg Vertical Outside bend
 |  | Flexible Riser 400 x 200 X 400 for Cable Tray Size 400 X 200 | Cable tray 400x150 | Cable tray 400x150 | 4 | Nos |  |  | 90deg Vertical Inside bend
 |  | Flexible Riser 400 x 150 X 400 for Cable Tray Size 400 X 150 | Cable tray 400x150 | Cable tray 400x150 | 4 | Nos |  |  | 90deg Vertical Outside bend
 |  | Flexible Riser 400 x 150 X 400 for Cable Tray Size 400 X 150 | Cable tray 400x150 | Cable tray 400x150 | 4 | Nos |  |  | 90deg Vertical Inside bend
 |  | Equal Tee 400 X 400 X 400 for Cable Tray Size 400 X 200 | EqualTee 400x400x400 | EqualTee 400x400x400 | 8 | Nos
 |  | Equal Tee 400 X 400 X 400 for Cable Tray Size 400 X 150 | EqualTee 400x400x400 | EqualTee 400x400x400 | 8 | Nos
 |  | Cable Tray Joint Plate For Cable Tray Size 400 X 200 | Cable tray 400x150 | Cable tray 400x150 | 150 | Nos
 |  | Cable Tray Joint Plate For Cable Tray Size 400 X 150 | Cable tray 400x150 | Cable tray 400x150 | 60 | Nos
 |  | Cable Tray Joint Nut & Bolt With Washer For Cable Tray Size 400 X 200 | Cable tray 400x150 | Cable tray 400x150 | 1400 | Nos
 |  | Cable Tray Joint Nut & Bolt With Washer For Cable Tray Size 400 X 150 | Cable tray 400x150 | Cable tray 400x150 | 600 | Nos
 |  | Flex Strap Thief Hatch Bonding Kit, Tin Coted, Size 200 mm [L] X 20 mm [W] with 10 mm Hole at Both End | Cable tray 400x150 | Cable tray 400x150 | 200 | Nos
 | GI Pipe | GI Pipe ,Size 1'' For Tower Light-1 |  |  | 20 | meter
 |  | GI Pipe ,Size 1'' For Tower Light-5 |  |  | 20 | meter
 |  | GI Pipe ,Size 1'' For Tower Light-6 |  |  | 15 | meter
 |  | GI Pipe ,Size 2'' For Pipe Rack Light-1 & 2 | PIPE RACK LIGHT-1 (15 No. 100W light), Size : 1'' | PIPE RACK LIGHT-1 (15 No. 100W light), Size : 1'' | 200 | meter
 |  | GI Pipe ,Size 1'' For Transfer Pump shed light | TRANSFER PUMP SHED LIGHT (2 No.36W each light), Size : 1'' | TRANSFER PUMP SHED LIGHT (2 No.36W each light), Size : 1'' | 20 | meter
 |  | GI Pipe ,Size 1'' For Recycle Pump Shed light, | RECYCLE PUMP SHED LIGHT, Size : 1'' | RECYCLE PUMP SHED LIGHT, Size : 1'' | 20 | meter
 |  | GI Pipe ,Size 1'' For Fire Water Pump Shed Light | FIRE WATER PUMP SHED LIGHT (2set.72W each light), Size : 1'' | FIRE WATER PUMP SHED LIGHT (2set.72W each light), Size : 1'' | 20 | meter
 |  | GI Pipe ,Size 1'' For TEG Tower Light | TEG TOWER LIGHT (2 No. 100W light), Size : 1'' | TEG TOWER LIGHT (2 No. 100W light), Size : 1'' | 20 | meter
 |  | GI Pipe ,Size 1'' For Loading Area Shed Light |  |  | 250 | meter
 |  | GI Pipe ,Size 1'' For Inlet Air Cooler | INLET AIR COOLER, Size : 1'' | INLET AIR COOLER, Size : 1'' | 110 | meter
 |  | GI Pipe ,Size 1'' For WBH,(Power) |  |  | 20 | meter
 |  | GI Pipe ,Size 2'' For WBH,(JB) |  |  | 30 | meter
 |  | GI Pipe ,Size 1'' For Regeneration Gas Heater(Power) |  |  | 60 | meter
 |  | GI Pipe ,Size 2'' For Regeneration Gas Heater(JB) |  |  | 30 | meter
 | GI fittings | GI Elbow ,Size 2'' | GI elbow ,Size 1'' | GI elbow ,Size 1'' | 50 | Nos
 |  | GI Union ,Size 2'' | GI union ,Size 1'' | GI union ,Size 1'' | 30 | Nos
 |  | GI Tee, Size 2'' | GI tee, Size 1'' | GI tee, Size 1'' | 30 | Nos
 |  | GI Socket, Size 2'' | GI Socket, Size 1'' | GI Socket, Size 1'' | 30 | Nos
 |  | GI Elbow ,Size 1'' | GI elbow ,Size 1'' | GI elbow ,Size 1'' | 70 | Nos
 |  | GI Union ,Size 1'' | GI union ,Size 1'' | GI union ,Size 1'' | 30 | Nos
 |  | GI Tee, Size 1'' | GI tee, Size 1'' | GI tee, Size 1'' | 80 | Nos
 |  | GI Socket, Size 1'' | GI Socket, Size 1'' | GI Socket, Size 1'' | 30 | Nos
 | Cable Lugs | Ring lugs 2.5mm2 | Ring lugs 2.5mm2 | Ring lugs 2.5mm2 | 480 | pcs
 |  | Ring lugs 4mm2 | Ring lugs 4mm2 | Ring lugs 4mm2 | 200 | pcs
 |  | Ring lugs 6mm2 | Ring lugs 6mm2 | Ring lugs 6mm2 | 65 | pcs
 |  | Ring lugs 10mm2 | Ring lugs 10mm2 | Ring lugs 10mm2 | 110 | pcs
 |  | Ring lugs 16mm2 | Ring lugs 16mm2 | Ring lugs 16mm2 | 150 | pcs
 |  | Ring lugs 1.5mm2 | Ring lugs 1.5mm2 for LCS | Ring lugs 1.5mm2 for LCS | 200 | pcs
 |  | Ring lugs 150mm2 for Generator 1 & 2 | Ring lugs 150mm2 for Generator | Ring lugs 150mm2 for Generator | 50 | pcs
 |  | Ring lugs 300mm2 for National Grid Line | Ring lugs 300mm2 for National Grid Line | Ring lugs 300mm2 for National Grid Line | 12 | pcs
 |  | I lugs 1.5 mm2 for others use | I lugs 1.5 mm2 for others use | I lugs 1.5 mm2 for others use | 500 | pcs
 |  | I lugs 2 mm2 for others use | I lugs 2 mm2 for others use | I lugs 2 mm2 for others use | 300 | pcs
 |  | I lugs 2.5 mm2 for others use | I lugs 2.5 mm2 for others use | I lugs 2.5 mm2 for others use | 300 | pcs
 |  | I lugs 4 mm2 for others use | I lugs 4 mm2 for others use | I lugs 4 mm2 for others use | 100 | pcs
 |  | I lugs 6 mm2 for others use | I lugs 6 mm2 for others use | I lugs 6 mm2 for others use | 300 | pcs
 |  | Y lugs 2.5 mm2 for others use | Y lugs 2.5 mm2 for others use | Y lugs 2.5 mm2 for others use | 300 | pcs
 |  | Y lugs 4 mm2 for others use | Y lugs 4 mm2 for others use | Y lugs 4 mm2 for others use | 200 | pcs
 |  | Y lugs 6 mm2 for others use | Y lugs 6 mm2 for others use | Y lugs 6 mm2 for others use | 200 | pcs
 | PVC Tape | PVC Tape,size:3/4''(RED) | PVC Tape,size:3/4''(RED) | PVC Tape,size:3/4''(RED) | 100 | pcs
 |  | PVC Tape,size:3/4''(YELLOW) | PVC Tape,size:3/4''(YELLOW) | PVC Tape,size:3/4''(YELLOW) | 100 | pcs
 |  | PVC Tape,size:3/4''(BLUE) | PVC Tape,size:3/4''(BLUE) | PVC Tape,size:3/4''(BLUE) | 100 | pcs
 |  | PVC Tape,size:3/4''(BLACK) | PVC Tape,size:3/4''(BLACK) | PVC Tape,size:3/4''(BLACK) | 100 | pcs
 |  | PIB Tape | PIB Tape | PIB Tape | 20 | pcs
 | Shrink Tube | 1.5 inch Red color | 1.5 inch Red color | 1.5 inch Red color | 5 | meter
 |  | 1.5 inch Yellow color | 1.5 inch Yellow color | 1.5 inch Yellow color | 5 | meter
 |  | 1.5 inch Blue color | 1.5 inch Blue color | 1.5 inch Blue color | 5 | meter
 |  | 1.5 inch Black color | 1.5 inch Black color | 1.5 inch Black color | 5 | meter
 |  | 1 inch Red color | 1 inch Red color | 1 inch Red color | 5 | meter
 |  | 1 inch Yellow color | 1 inch Yellow color | 1 inch Yellow color | 3 | meter
 |  | 1 inch Blue color | 1 inch Blue color | 1 inch Blue color | 3 | meter
 |  | 1 inch Black color | 1 inch Black color | 1 inch Black color | 3 | meter
 |  | 1/2 inch Red color | 1/2 inch Red color | 1/2 inch Red color | 3 | meter
 |  | 1/2 inch Yellow color | 1/2 inch Yellow color | 1/2 inch Yellow color | 3 | meter
 |  | 1/2 inch Blue color | 1/2 inch Blue color | 1/2 inch Blue color | 3 | meter
 |  | 1/2 inch Black color | 1/2 inch Black color | 1/2 inch Black color | 3 | meter
 |  | 3/4 inch Red color | 3/4 inch Red color | 3/4 inch Red color | 3 | meter
 |  | 3/4 inch Yellow color | 3/4 inch Yellow color | 3/4 inch Yellow color | 3 | meter
 |  | 3/4 inch Blue color | 3/4 inch Blue color | 3/4 inch Blue color | 3 | meter
 |  | 3/4 inch Black color | 3/4 inch Black color | 3/4 inch Black color | 3 | meter
 |  | 1/4 inch Red color | 1/4 inch Red color | 1/4 inch Red color | 3 | meter
 |  | 1/4 inch Yellow color | 1/4 inch Yellow color | 1/4 inch Yellow color | 3 | meter
 |  | 1/4 inch Blue color | 1/4 inch Blue color | 1/4 inch Blue color | 3 | meter
 |  | 1/4 inch Black color | 1/4 inch Black color | 1/4 inch Black color | 3 | meter
 |  | Metal Gland for Field Side |  |  |  |  | Gland Model No. | Range
 | Cable Gland | 3/4'' NPT for Generator-1 Cooling Tower Pump (4C X 4mm2), OD:16.8mm |  |  | 1 | pcs | RAD 2 | 15mm to 24mm | Information
 |  | 3/4'' NPT for Generator-1 Cooling Tower Fan (4C X 4mm2), OD:16.8mm |  |  | 1 | pcs | RAD 2 | 15mm to 24mm | Information
 |  | 1'' NPT for Generator-2 Cooling Tower Pump (4C X 16mm2) OD:24.3mm |  |  | 1 | pcs | RAD 3 | 21mm to 31mm | Information
 |  | 1'' NPT for Generator-2 Cooling Tower Fan (4C X 16mm2) OD:24.3mm |  |  | 1 | pcs | RAD 3 | 21mm to 31mm | Information
 |  | 2 1/2'' NPT Control Panel Electric Fire Water Pump(4C X 185mm2), OD:57.2mm |  |  | 1 | pcs | RAD 7 | 51mm to 64mm | Information
 |  | 3/4'' NPT for Condensate Transfer Pump P-300A/B(4C X 6mm2), OD:18.8mm |  |  | 2 | pcs | RAD 2 | 15mm to 24mm | Information
 |  | 3/4'' NPT for Condensate Recycle Pump P-200A/B(4C X 2.5mm2) OD:15.4mm |  |  | 2 | pcs | RAD 2 | 15mm to 24mm | Information
 |  | 3/4'' NPT for Inlet Air Cooler AC-100A/B(4C X 10mm2), OD:21mm |  |  | 2 | pcs | RAD 2 | 15mm to 24mm | Information
 |  | 3/4'' NPT for Overhead Gas Cooler E-300(4C X 2.5mm2), OD:15.4mm |  |  | 1 | pcs | RAD 2 | 15mm to 24mm | Information
 |  | 3/4'' NPT for KOD Pump P-400(4C X 2.5mm2), OD:15.4mm |  |  | 1 | pcs | RAD 2 | 15mm to 24mm | Information
 |  | 3/4'' NPT for Deep Well Pump P-700(4C X 4mm2), OD:16.8mm |  |  | 1 | pcs | RAD 2 | 15mm to 24mm | Information
 |  | 3/4'' NPT for Deep Well Pump P-800(4C X 4mm2), OD:16.8mm |  |  | 1 | pcs | RAD 2 | 15mm to 24mm | Information
 |  | 3/4'' NPT for star-delta starter for P-700 & P-800 (3C X 4mm2), OD:16.8mm |  |  | 8 | pcs | RAD 2 | 15mm to 24mm
 |  | PG Gland for MCC Side
 |  | Incoming Panel (1C X 150mm2) for Generator-1 & 2 |  |  | 20 | Nos |  |  | No Information for PG size
 |  | For National Grid (4C X 300mm2), OD:70.4mm |  |  | 4 | Nos. |  |  | No Information for PG size
 |  | Outlet for Location Use 100kW(4C X 120mm2), OD:47.1mm |  |  | 1 | No. |  |  | No Information for PG size
 |  | Spare Outlet for a similar future plant 100kW(4C X 120mm2), OD:47.1mm |  |  | 1 | No. |  |  | No Information for PG size
 |  | PG-29 for Spare Outlet-1 (25A)(4C X 6mm2), OD:18.8mm |  |  | 1 | No. |  |  | PG-29 for 18mm to25mm Overall Dia Cable
 |  | PG-36 for Spare Outlet-2 (50A)(4C X 16mm2), OD:24.3mm |  |  | 1 | No. |  |  | PG-36 for 22mm to32mm Overall Dia Cable
 |  | PG-21 for Glycol Reboiler (4C X 2.5mm2), OD:15.4mm |  |  | 1 | No. |  |  | PG-21 for 13mm to18mm Overall Dia Cable
 |  | PG-21 for Water Bath Heater Panel (4C X 2.5mm2), OD:15.4mm |  |  | 1 | No. |  |  | PG-21 for 13mm to18mm Overall Dia Cable
 |  | PG-21 for UPS System-1 (3C X 4mm2), OD:15.8mm |  |  | 1 | No. |  |  | PG-21 for 13mm to18mm Overall Dia Cable
 |  | PG-21 for UPS System-2 (3C X 4mm2), OD:15.8mm |  |  | 1 | No. |  |  | PG-21 for 13mm to18mm Overall Dia Cable
 |  | PG-21 for UPS System-3 (3C X 2.5mm2), OD:14.6mm |  |  | 1 | No. |  |  | PG-21 for 13mm to18mm Overall Dia Cable
 |  | PG-21 for UPS System-4 (3C X 4mm2), OD:15.8mm |  |  | 1 | No. |  |  | PG-21 for 13mm to18mm Overall Dia Cable
 |  | PG-36 for Utility Power Operation Building(4C X 16mm2) OD:24.3mm |  |  | 1 | No. |  |  | PG-36 for 22mm to32mm Overall Dia Cable
 |  | PG-29 for Utility Power Workshop Building(4C X 6mm2), OD:18.8mm |  |  | 1 | No. |  |  | PG-29 for 18mm to25mm Overall Dia Cable
 |  | PG-29 for Utility Power Generator Building(4C X 10mm2), OD:21mm |  |  | 1 | No. |  |  | PG-29 for 18mm to25mm Overall Dia Cable
 |  | PG-21 for Control Panel Diesel Fire Water Pump(4C X 2.5mm2) OD:15.4mm |  |  | 1 | No. |  |  | PG-21 for 13mm to18mm Overall Dia Cable
 |  | PG-29 for Control Panel Jockey Pump(4C X 6mm2) OD:18.8mm |  |  | 1 | No. |  |  | PG-29 for 18mm to25mm Overall Dia Cable
 |  | PG-63 for Control Panel Electric Fire Water Pump(4C X 185mm2), OD:57.2mm |  |  | 1 | No.
 |  | PG-21 for Generator-1 Cooling Tower Pump (4C X 4mm2), OD:16.8mm |  |  | 1 | No. |  |  | PG-21 for 13mm to18mm Overall Dia Cable
 |  | PG-21 for Generator-1 Cooling Tower Fan (4C X 4mm2), OD:16.8mm |  |  | 1 | No. |  |  | PG-21 for 13mm to18mm Overall Dia Cable
 |  | PG-36 for Generator-2 Cooling Tower Pump (4C X 16mm2) OD:24.3mm |  |  | 1 | No. |  |  | PG-36 for 22mm to32mm Overall Dia Cable
 |  | PG-36 for Generator-2 Cooling Tower Fan (4C X 16mm2) OD:24.3mm |  |  | 1 | No. |  |  | PG-36 for 22mm to32mm Overall Dia Cable
 |  | PG-21 for Flare and Burn Pit Control Panel(4C X 2.5mm2) OD:15.4mm |  |  | 1 | No. |  |  | PG-21 for 13mm to18mm Overall Dia Cable
 |  | PG-29 for Condensate Transfer Pump P-300A/B(4C X 6mm2), OD:18.8mm |  |  | 2 | Nos |  |  | PG-29 for 18mm to25mm Overall Dia Cable
 |  | PG-21 for Condensate Recycle Pump P-200A/B(4C X 2.5mm2) OD:15.4mm |  |  | 2 | Nos |  |  | PG-21 for 13mm to18mm Overall Dia Cable
 |  | PG-29 for Inlet Air Cooler AC-100A/B(4C X 10mm2), OD:21mm |  |  | 2 | Nos |  |  | PG-29 for 18mm to25mm Overall Dia Cable
 |  | PG-21 for Overhead Gas Cooler E-300(4C X 2.5mm2), OD:15.4mm |  |  | 1 | No. |  |  | PG-21 for 13mm to18mm Overall Dia Cable
 |  | PG-21 for KOD Pump P-400(4C X 2.5mm2), OD:15.4mm |  |  | 1 | No. |  |  | PG-21 for 13mm to18mm Overall Dia Cable
 |  | PG-21 for Deep Well Pump P-700(4C X 4mm2), OD:16.8mm |  |  | 1 | No. |  |  | PG-21 for 13mm to18mm Overall Dia Cable
 |  | PG-21 for Deep Well Pump P-800(4C X 4mm2), OD:16.8mm |  |  | 1 | No. |  |  | PG-21 for 13mm to18mm Overall Dia Cable
 |  | PG-29 for Light Distribution Panel Power(5C X 10mm2) OD:18.8mm |  |  | 1 | No. |  |  | PG-29 for 18mm to25mm Overall Dia Cable
 |  | Light Distribution panel
 |  | PG-21 for Tower Light-1,2,3,4,5,6(3C X 2.5mm2), OD:14.6mm |  |  | 6 | Nos |  |  | PG-21 for 13mm to18mm Overall Dia Cable
 |  | PG-21 for Pipe rack Light-1 (3C X 2.5mm2), OD:14.6mm |  |  | 1 | No. |  |  | PG-21 for 13mm to18mm Overall Dia Cable
 |  | PG-21 for Pipe rack Light-2 (3C X 2.5mm2), OD:14.6mm |  |  | 1 | No. |  |  | PG-21 for 13mm to18mm Overall Dia Cable
 |  | PG-21 for Air Craft Warning Light(3C X 2.5mm2), OD:14.6mm |  |  | 1 | No. |  |  | PG-21 for 13mm to18mm Overall Dia Cable
 |  | PG-21 for Loading Arm Shed Light(3C X 2.5mm2), OD:14.6mm |  |  | 1 | No. |  |  | PG-21 for 13mm to18mm Overall Dia Cable
 |  | PG-21 for Transfer Pump Shed Light(3C X 2.5mm2), OD:14.6mm |  |  | 1 | No. |  |  | PG-21 for 13mm to18mm Overall Dia Cable
 |  | PG-21 for Recycle Pump Shed light(3C X 2.5mm2), OD:14.6mm |  |  | 1 | No. |  |  | PG-21 for 13mm to18mm Overall Dia Cable
 |  | PG-21 for Fire Water Pump Shed Light(3C X 2.5mm2), OD:14.6mm |  |  | 1 | No. |  |  | PG-21 for 13mm to18mm Overall Dia Cable
 | Lightning Protection | Lightning Arrestor For Generator Building 1 meter each | Lightning Protection For Generator Building | Lightning Protection For Generator Building | 4 | Nos.
 |  | Lightning Arrestor For Operator Building 1 meter each | Lightning Protection For Control Building | Lightning Protection For Control Building | 4 | Nos.
 |  | Lightning Arrestor For TANK 1 meter each | Lightning Protection For TANK | Lightning Protection For TANK | 2 | Nos
 | Angle Bar | Angle bar (Cable Tray support) 1''x1'' | Angle bar (Cable Tray support) 1''x1'' | Angle bar (Cable Tray support) 1''x1'' | 150 | meter |  |  | Thickness 3 mm
 |  | Angle bar (Cable Tray support) 1.5''x1.5'' | Angle bar (Cable Tray support) 1.5''x1.5'' | Angle bar (Cable Tray support) 1.5''x1.5'' | 200 | meter |  |  | Thickness 3 mm
 | PVC Conduit | PVC Conduit Size 2'' | PVC Conduit Size 2'' | PVC Conduit Size 2'' | 50 | meter |  |  | Bangladesh
 |  | PVC Conduit Size 1.5'' | PVC Conduit Size 1.5'' | PVC Conduit Size 1.5'' | 100 | meter |  |  | Bangladesh
 |  | PVC Conduit Size 3/4'' | PVC Conduit Size 3/4'' | PVC Conduit Size 3/4'' | 50 | meter |  |  | Bangladesh
 |  | PVC Coted Alluminium Flexible Hose pipe 1 Inch | Hose pipe | Hose pipe | 50 | meter |  |  | Bangladesh
 |  | PVC Coted Alluminium Flexible Hose pipe 1.5 inch | Hose pipe | Hose pipe | 50 | meter
 |  | Fittings for 1 Inch PVC Coted Alluminium Flexible Hose pipe | Hose pipe | Hose pipe | 1 | lot
 |  | Fittings for 1.5 Inch PVC Coted Alluminium Flexible Hose pipe | Hose pipe | Hose pipe | 1 | lot
 | Royal Bolt | Royal Bolt(6mm) | Royal Bolt(6mm) | Royal Bolt(6mm) | 100 | pcs |  |  | BD
 |  | Royal Bolt(8mm) | Royal Bolt(8mm) | Royal Bolt(8mm) | 100 | pcs |  |  | BD
 |  | Royal Bolt(10mm) | Royal Bolt(10mm) | Royal Bolt(10mm) | 100 | pcs |  |  | BD
 |  | Royal Bolt(12mm) | Royal Bolt(10mm) | Royal Bolt(10mm) | 100 | pcs |  |  | BD
 | Cable Tie | Cable Tie , Size 24'' | Cable Tie , Size 12'' | Cable Tie , Size 12'' | 30 | Packet
 |  | Cable Tie , Size 12'' | Cable Tie , Size 12'' | Cable Tie , Size 12'' | 30 | Packet
 |  | Cable Tie , Size 8 '' | Cable Tie , Size 8 '' | Cable Tie , Size 8 '' | 30 | Packet
 |  | Cable Tie , Size 6'' | Cable Tie , Size 6'' | Cable Tie , Size 6'' | 30 | Packet
 | U-Bolt | U-bolt, Size 2'' (As per GI pipe size) |  |  | 100 | Nos
 |  | U-bolt, Size 1.5'' (As per GI pipe size) |  |  | 100 | Nos
 |  | U-bolt, Size 1'' (As per GI pipe size) |  |  | 50 | Nos
 | Cable tagging | Cable Tagging & Marking |  |  | 1 | lot
 |  | Ferrule 4 mm |  |  | 1 | Roll
 |  | Ferrule 6 mm |  |  | 1 | Roll
 | Accessories |  |  |  | 1 | lot
REV | DATE |  | DESCRIPTION OF REVISION |  |  |  | PREPARED | CHECKED | APPROVED

Sheet: NEW BOQ
MASTER BOQ 2 x 75 MMSCFD GLYCOL DEHYDRATION TYPE GAS PROCESS PLANTT BANGLADESH GAS FIELDS COMPANY LIMITED. LOCATION : J
Sl.No | Category | Description of Materials |  |  | Quantity | Unit | PO Issued | Remarks
1 | Generators | 276KW, 400/230 VAC, 3 phase 4 wire, 50Hz |  |  | 2 | Sets
 |  | 0.8PF, 1500RPM
 |  | Model No: PG345B3
 |  | Complete with all accessories & without Radiator
2 | Cooling Towers | Ocean Cooling tower |  |  | 2 | Sets | POL000284-1
 |  | Model YC150H Cells:01, Cooling capacity RT:150
 |  | Heat Rejection: Kcal/hr:585000
3
3.1 | MCC ROOM | Incoming Panel | Feeder (Incoming Panel) | Feeder (Incoming Panel) | 1 | Nos
3.2 |  | MCC Panel | MCC Panel | MCC Panel | 1 | Set
3.3 |  | PFI Panel | PFI Panel | PFI Panel | 1 | Nos
3.4 |  | Light Distribution Panel | Light Distribution Panel | Light Distribution Panel | 1 | Nos
3.5 |  | Battery Charger 12 volt & 24 Volt, 20Amp |  |  | 1 | Nos
3.6 |  | Distribution Panel for Operation Building | Distribution Panel for Operation Building | Distribution Panel for Operation Building | 1 | Nos |  | At Dhaka. (PSI not needed)
3.7 |  | Distribution Panel for Workshop Building | Distribution Panel for Workshop Building | Distribution Panel for Workshop Building | 1 | Nos |  | At Dhaka. (PSI not needed)
3.8 |  | Distribution Panel for generation Building | Distribution Panel for generation Building | Distribution Panel for generation Building | 1 | Nos |  | At Dhaka. (PSI not needed)
3.9 |  | Star Delta motor starter panel for P700 | Star Delta motor starter panel for P700 | Star Delta motor starter panel for P700 | 1 | Nos |  | At Dhaka. (PSI not needed)
3.10 |  | Star Delta motor starter panel for P800 | Star Delta motor starter panel for P800 | Star Delta motor starter panel for P800 | 1 | Nos |  | At Dhaka. (PSI not needed)
 |  | Control Panel Electric Fire Water Pump |  |  | 1 | Nos
 |  | Side Wall Exhaust Fan for Generator Room (Model:WEX-750D6-1.1) |  |  | 3 | Nos
 |  | Control Panel for Generator Exhaust Fan (Generator Room) |  |  | 1 | Nos
 |  | Electric Pole |  |  | 2 | Nos |  | At Dhaka. (PSI not needed)
4.0 | UPS
4.1 |  | UPS (6kVA) | UPS(6kVA) | UPS(6kVA) | 2 | Nos
4.2 |  | UPS (2kVA) | UPS(2kVA) | UPS(2kVA) | 1 | Nos
4.3 |  | UPS (1kVA) | UPS(1kVA) | UPS(1kVA) | 1 | Nos
5.0 | Area Lighting | UPS Power Distribution Box |  |  | 3 | Nos |  | At Dhaka. (PSI not needed)
5.1 |  | High Mast Light (Circular) Height 15m, with 3 ex-proof sodium vapor lamp 400W each | TOWER LIGHT(200W light | TOWER LIGHT(200W light | 5 | Sets
5.2 |  | High Mast Light (Sectoral) Height 15m, with 3 ex-proof sodium vapor lamp 400W each |  |  | 1 | Sets
5.3 |  | Pipe Rack Light (100W light) | PIPE RACK LIGHT (100W light) | PIPE RACK LIGHT (100W light) | 16 | Nos
5.4 |  | EXIT Light | TEG TOWER LIGHT (100W light) | TEG TOWER LIGHT (100W light) | 18 | Nos
5.5 |  | Shed Light (2 No.28W each light) explosion proof (T5 Fluorescent Light) |  |  | 10 | Nos
5.6 |  | Shed Light for Loading Arm with 200W Sodium Vapor lamp |  |  | 2 | Nos
5.7 |  | Air-Craft Warning Light for flare (50W light) | AIR-CRAFT WARNING LIGHT (50W light) | AIR-CRAFT WARNING LIGHT (50W light) | 1 | Nos
5.8 |  | Shed Light (2 No.36W each light) explosion proof | SHED LIGHT (2 No.36W each light) | SHED LIGHT (2 No.36W each light) | 8 | Nos
5.9 |  | Loading Area Shed Light (200W each light) explosion proof | LOADING AREA SHED LIGHT (200W each light) | LOADING AREA SHED LIGHT (200W each light) | 3 | Nos
 | Cathodic Protection | As per material list provided by SPE Doc No. 252-0201-EMCC-BM00-0003
6.1 |  | Cathodic Protection for condensate tank | Cathodic Protection | Cathodic Protection | 1 | lot |  | Details BOQ Required
6.2 |  | Cathodic Protection for underground pipe | Cathodic Protection | Cathodic Protection | 1 | lot |  | Details BOQ Required
7.0 | Generator Installation | Water Softener Plant for Cooling Tower | Cathodic Protection | Cathodic Protection | 1 | Set |  | Dhaka
7.1 |  | Generator Installation materials (As per list provided by Genset Vendor) | Cathodic Protection | Cathodic Protection | 1 | lot |  | Procurment to be done in Dhaka
8.0 | LCS | LCS (Local Control Station) | LCS without selector switch | LCS without selector switch | 6 | pcs
8.1 |  | LCS (Local Control Station) with Three Position selector switch. | LCS with selector switch | LCS with selector switch | 9 | pcs
9.0
9.1 | Grounding Systems | Bare Grounding Copper Cable (95 sqmm/RM) |  |  | 1317 | meter
9.2 |  | PVC Insulated Cable for Skid inter-connection (16 sqmm/RM) |  |  | 500 | meter
9.3 |  | Solid Copper Rod (8 mm Dia) |  |  | 385 | meter
9.4 |  | Grounding Rod, Each two meter length, Dia. 25mm | Grounding Rod, Each two meter length | Grounding Rod, Each two meter length | 45 | Nos
9.5 |  | 8mm Solid Copper Cable Joint connector | Joint Nut & Bolt 8mm Dia ( Short Length ) | Joint Nut & Bolt 8mm Dia ( Short Length ) | 30 | Nos
9.6 |  | Joint connector (25mm dia to 95sqmm cable) | Joint Nut & Bolt 8mm Dia ( Short Length ) | Joint Nut & Bolt 8mm Dia ( Short Length ) | 45 | Nos
9.7 |  | Copper Nut Bolt with washer L=40mm, OD=12mm, |  |  | 100 | Nos
9.8 |  | Earthing cable termination Busbar with hole(14mm). Busbar Size: L=250mm, W=75mm, T=8mm |  |  | 20 | Nos
9.9 |  | Busbar mounting Isolator with threaded bolt. Size: H=60mm, D1=40mm, M8, A=20mm |  |  | 40 | Nos
9.10 |  | Copper Nut Bolt with washer. Size: L=40mm, OD=10mm, |  |  | 100 | Nos
9.11 |  | 5m Static Grounding Clamp 40mm Jaw Opening. (For Loading Station) | 5m Static Grounding Clamp 40mm Jaw Opening. | 5m Static Grounding Clamp 40mm Jaw Opening. | 2 | Nos |  |  | RS Component
10.0
10.1 | Cable Tray | Cable Tray With Cover Size 400(W) X 200(H) for Power Cable (Each 3 meter length) |  |  | 65 | Nos
10.2 |  | Cable Tray With Cover Size 400(W) X 150(H) for Instrumentation Cable (Each 3 meter length) | Cable tray 400x150 | Cable tray 400x150 | 20 | Nos
10.3 |  | Horizontal Elbow 400(W) x 200 X 400(W) for Cable Tray Size 400(W) X 200(H) | Cable tray 400x150 | Cable tray 400x150 | 8 | Nos
10.4 |  | Horizontal Elbow 400(W) x 150 X 400(W) for Cable Tray Size 400(W) X 150(H) | Cable tray 400x150 | Cable tray 400x150 | 8 | Nos
10.5 |  | Flexible Riser (90deg Vertical Outside bend) 400(W) x 200 X 400(W) for Cable Tray Size 400(W) X 200(H) | Cable tray 400x150 | Cable tray 400x150 | 4 | Nos
10.6 |  | Flexible Riser (90deg Vertical Inside bend) 400(W) x 200 X 400(W) for Cable Tray Size 400(W) X 200(H) | Cable tray 400x150 | Cable tray 400x150 | 4 | Nos
10.7 |  | Flexible Riser (90deg Vertical Outside bend) 400(W) x 150 X 400(W) for Cable Tray Size 400(W) X 150(H) | Cable tray 400x150 | Cable tray 400x150 | 4 | Nos
10.8 |  | Flexible Riser (90deg Vertical Inside bend) 400(W) x 150 X 400(W) for Cable Tray Size 400(W) X 150(H) | Cable tray 400x150 | Cable tray 400x150 | 4 | Nos
10.9 |  | Equal Tee 400(W) X 400(W) X 400(W) for Cable Tray Size 400(W) X 200(H) | EqualTee 400x400x400 | EqualTee 400x400x400 | 8 | Nos
10.10 |  | Equal Tee 400(W) X 400(W) X 400(W) for Cable Tray Size 400 X 150(H) | EqualTee 400x400x400 | EqualTee 400x400x400 | 8 | Nos
10.11 |  | End Cape For Cable Tray Size 400(W) X 200(H) |  |  | 8 | Nos
10.12 |  | End Cape For Cable Tray Size 400(W) X 150(H) |  |  | 8 | Nos
10.13 |  | Cable Tray Joint Plate For Cable Tray Size 400(W) X 200(H) | Cable tray 400x150 | Cable tray 400x150 | 150 | Nos
10.14 |  | Cable Tray Joint Plate For Cable Tray Size 400(W) X 150(H) | Cable tray 400x150 | Cable tray 400x150 | 60 | Nos
10.15 |  | Cable Tray Joint Nut & Bolt With Washer For Cable Tray Size 400(W) X 200(H) | Cable tray 400x150 | Cable tray 400x150 | 1400 | Nos
10.16 |  | Cable Tray Joint Nut & Bolt With Washer For Cable Tray Size 400(W) X 150(H) | Cable tray 400x150 | Cable tray 400x150 | 800 | Nos
10.17 |  | Flex Strap Thief Hatch Bonding Kit, Tin Coted, Size 200 mm [L] X 20 mm [W] with 10 mm Hole at Both End | Cable tray 400x150 | Cable tray 400x150 | 100 | Nos
10.18
 | GI Pipe | GI Pipe, Size 1'' For Tower Light-1 |  |  | 20 | meter
 |  | GI Pipe, Size 1'' For Tower Light-2 | TOWER LIGHT-2 (3 No. 200W light each pole), Size : 1'' | TOWER LIGHT-2 (3 No. 200W light each pole), Size : 1'' | 20 | meter
 |  | GI Pipe, Size 1'' For Tower Light-3 | TOWER LIGHT-3 (3 No. 200W light each pole), Size : 1'' | TOWER LIGHT-3 (3 No. 200W light each pole), Size : 1'' | 15 | meter
 |  | GI Pipe, Size 1'' For Tower Light-4 | TOWER LIGHT-4 (3 No. 200W light each pole), Size : 1'' | TOWER LIGHT-4 (3 No. 200W light each pole), Size : 1'' | 20 | meter
 |  | GI Pipe, Size 1'' For Tower Light-5 | TOWER LIGHT-5 (3 No. 200W light each pole), Size : 1'' | TOWER LIGHT-5 (3 No. 200W light each pole), Size : 1'' | 20 | meter
 |  | GI Pipe, Size 1'' For Tower Light-6 | TOWER LIGHT-6 (3 No. 200W light each pole), Size : 1'' | TOWER LIGHT-6 (3 No. 200W light each pole), Size : 1'' | 15 | meter
 |  | GI Pipe, Size 1'' For Transfer Pump Shed light | TRANSFER PUMP SHED LIGHT (2 No.36W each light), Size : 1'' | TRANSFER PUMP SHED LIGHT (2 No.36W each light), Size : 1'' | 20 | meter
 |  | GI Pipe, Size 1'' For Recycle Pump Shed light | RECYCLE PUMP SHED LIGHT, Size : 1'' | RECYCLE PUMP SHED LIGHT, Size : 1'' | 20 | meter
 |  | GI Pipe, Size 1'' For Fire Water Pump Shed Light | FIRE WATER PUMP SHED LIGHT (2set.72W each light), Size : 1'' | FIRE WATER PUMP SHED LIGHT (2set.72W each light), Size : 1'' | 20 | meter
 |  | GI Pipe, Size 1'' For TEG Tower Light | TEG TOWER LIGHT (2 No. 100W light), Size : 1'' | TEG TOWER LIGHT (2 No. 100W light), Size : 1'' | 20 | meter
 |  | GI Pipe, Size 1'' For Air-Craft Light | AIR-CRAFT WARNING LIGHT, Size : 1'' | AIR-CRAFT WARNING LIGHT, Size : 1'' | 250 | meter
 |  | GI Pipe, Size 1'' For Loading area Shed Light | LOADING AREA SHED LIGHT (3 No. 200W each light), Size : 1'' | LOADING AREA SHED LIGHT (3 No. 200W each light), Size : 1'' | 60 | meter
 |  | GI Pipe, Size 1'' For Inlet Air Cooler | INLET AIR COOLER, Size : 1'' | INLET AIR COOLER, Size : 1'' | 110 | meter
 |  | GI Pipe, Size 1'' For WBH | WBH, Size : 1'' | WBH, Size : 1'' | 20 | meter
 |  | GI Pipe ,Size 1'' For WBH,(Power) |  |  | 20 | meter
 |  | GI Pipe ,Size 2'' For WBH,(JB) |  |  | 20 | meter
 |  | GI Pipe ,Size 1'' For Regeneration Gas Heater(Power) |  |  | 20 | meter
 |  | GI Pipe ,Size 2'' For Regeneration Gas Heater(JB) |  |  | 20 | meter
 |  | GI Pipe ,Size 3/4 '' For Building Fire Detection System |  |  | 200 | meter
 |  | GI Pipe ,Size 1 '' For Flare Panel Power ( 1CP800 To 1CP803 ) |  |  | 200 | meter
 |  | GI Pipe ,Size 1 '' For Flare Panel Power ( 1CP800 To 1CP803 ) |  |  | 200 | meter
 |  | GI Pipe ,Size 1 '' For Burn Pit Panel Power ( 1CP800 To 1CP807 ) |  |  | 250 | meter
 |  | GI Pipe ,Size 1 '' For Thermocouple ( Flare ) |  |  | 200 | meter
 |  | GI Pipe ,Size 1 '' For Thermocouple ( Burn Pit ) |  |  | 250 | meter
 |  | GI Pipe, Size 1-1/2'' For Pipe Rack Light-1 & 2 |  |  | 160 | meter
 |  | GI Pipe ,Size 1-1/2" For F&G, Power Cable Installation |  |  | 200 | meter
 |  | GI Pipe ,Size 2" For F&G Stand |  |  | 180 | meter
 |  | GI Pipe ,Size 2" For Skid To Cable Tray |  |  | 150 | meter
 |  | GI Pipe ,Size 4'' For Loading Arm, National Grid Line,Compressor Station Road Crossing Area |  |  | 100 | meter
 | GI Fittings | GI Socket ,Size 3/4 '' |  |  | 100 | Nos
 |  | GI Elbow ,Size 3/4 '' |  |  | 60 | Nos
 |  | GI Union ,Size 3/4 '' |  |  | 30 | Nos
 |  | GI Pipe Mounting Clamp ,Size 3/4 '' |  |  | 700 | Nos
 |  | GI Elbow ,Size 1'' |  |  | 80 | Nos
 |  | GI Socket ,Size 1'' |  |  | 350 | Nos
 |  | GI Tee ,Size 1'' |  |  | 40 | Nos
 |  | GI Union ,Size 1'' |  |  | 30 | Nos
 |  | GI Reducer ,Size 1'' to 3/4'' |  |  | 20 | Nos
 |  | GI Elbow ,Size 1-1/2'' |  |  | 30 | Nos
 |  | GI Socket ,Size 1-1/2'' |  |  | 30 | Nos
 |  | GI Tee ,Size 1-1/2'' |  |  | 30 | Nos
 |  | GI Union ,Size1-1/2'' |  |  | 30 | Nos
 |  | GI Elbow ,Size 2'' |  |  | 20 | Nos
 |  | GI Socket ,Size 2'' |  |  | 30 | Nos
 |  | GI Tee ,Size 2'' |  |  | 10 | Nos
 |  | GI Union ,Size 2'' |  |  | 10 | Nos
 |  | GI Socket ,Size 4'' |  |  | 8 | Nos
 | Cable Lugs | Insulated Ring lugs 1.5mm2 |  |  | 200 | pcs
 |  | Insulated Ring lugs 2.5mm2 |  |  | 400 | pcs
 |  | Insulated Ring lugs 4mm2 |  |  | 200 | pcs
 |  | Insulated Ring lugs 6mm2 |  |  | 200 | pcs
 |  | Ring lugs 10mm2 ( Nickel Coated ) |  |  | 50 | pcs
 |  | Ring lugs 16mm2 ( Nickel Coated ) |  |  | 50 | pcs
 |  | Ring lugs 95mm2 for National Grid Line ( Nickel Coated ) |  |  | 20 | pcs
 |  | Ring lugs 185mm2 ( Nickel Coated ) |  |  | 20 | pcs
 |  | Ring lugs 150mm2 for Generator( Nickel Coated ) |  |  | 35 | pcs
 |  | Insulated I lugs 1.5 mm2 for others use |  |  | 10000 | pcs
 |  | Insulated I lugs 2 mm2 for others use |  |  | 1000 | pcs
 |  | Insulated I lugs 2.5 mm2 for others use |  |  | 1000 | pcs
 |  | Insulated I lugs 4 mm2 for others use |  |  | 400 | pcs
 |  | Insulated I lugs 6 mm2 for others use |  |  | 400 | pcs
 |  | Insulated Y lugs 1.5 mm2 for others use |  |  | 200 | pcs
 |  | Insulated Y lugs 2.5 mm2 for others use |  |  | 400 | pcs
 |  | Insulated Y lugs 4 mm2 for others use |  |  | 400 | pcs
 |  | Insulated Y lugs 6 mm2 for others use |  |  | 300 | pcs
 | Cable Lugs | Insulated Ring lugs 1.5mm2 |  |  | 500 | pcs
 |  | Insulated Ring lugs 2.5mm2 |  |  | 500 | pcs
 |  | Insulated Ring lugs 4mm2 |  |  | 500 | pcs
 |  | Insulated Ring lugs 6mm2 |  |  | 500 | pcs
 |  | Ring lugs 10mm2 ( Nickel Coated ) |  |  | 50 | pcs
 |  | Ring lugs 16mm2 ( Nickel Coated ) |  |  | 50 | pcs
 |  | Ring lugs 95mm2 for National Grid Line ( Nickel Coated ) |  |  | 32 | pcs
 |  | Ring lugs 185mm2 ( Nickel Coated ) |  |  | 20 | pcs
 |  | Ring lugs 150mm2 for Generator( Nickel Coated ) |  |  | 50 | pcs
 |  | Insulated I lugs 1.5 mm2 for others use |  |  | 12000 | pcs
 |  | Insulated I lugs 2 mm2 for others use |  |  | 1000 | pcs
 |  | Insulated I lugs 2.5 mm2 for others use |  |  | 1000 | pcs
 |  | Insulated I lugs 4 mm2 for others use |  |  | 500 | pcs
 |  | Insulated I lugs 6 mm2 for others use |  |  | 500 | pcs
 |  | Insulated Y lugs 1.5 mm2 for others use |  |  | 500 | pcs
 |  | Insulated Y lugs 2.5 mm2 for others use |  |  | 500 | pcs
 |  | Insulated Y lugs 4 mm2 for others use |  |  | 500 | pcs
 |  | Insulated Y lugs 6 mm2 for others use |  |  | 500 | pcs
14.0
14.1 | PVC Tape | PVC Tape,size:3/4''(RED) | PVC Tape,size:3/4''(RED) | PVC Tape,size:3/4''(RED) | 150 | pcs
14.2 |  | PVC Tape,size:3/4''(YELLOW) | PVC Tape,size:3/4''(YELLOW) | PVC Tape,size:3/4''(YELLOW) | 150 | pcs
14.3 |  | PVC Tape,size:3/4''(BLUE) | PVC Tape,size:3/4''(BLUE) | PVC Tape,size:3/4''(BLUE) | 150 | pcs
14.4 |  | PVC Tape,size:3/4''(BLACK) | PVC Tape,size:3/4''(BLACK) | PVC Tape,size:3/4''(BLACK) | 150 | pcs
 |  | PVC Tape,size:3/4''(GREEN) | PVC Tape,size:3/4''(BLACK) | PVC Tape,size:3/4''(BLACK) | 50 | pcs
14.5 |  | PIB Tape | PIB Tape | PIB Tape | 30 | pcs
15.0
15.1 | Shrink Tube | 1.5 inch Red color | 1.5 inch Red color | 1.5 inch Red color | 5 | meter
15.2 |  | 1.5 inch Yellow color | 1.5 inch Yellow color | 1.5 inch Yellow color | 5 | meter
15.3 |  | 1.5 inch Blue color | 1.5 inch Blue color | 1.5 inch Blue color | 5 | meter
15.4 |  | 1.5 inch Black color | 1.5 inch Black color | 1.5 inch Black color | 5 | meter
15.5 |  | 1 inch Red color | 1 inch Red color | 1 inch Red color | 5 | meter
15.6 |  | 1 inch Yellow color | 1 inch Yellow color | 1 inch Yellow color | 3 | meter
15.7 |  | 1 inch Blue color | 1 inch Blue color | 1 inch Blue color | 3 | meter
15.8 |  | 1 inch Black color | 1 inch Black color | 1 inch Black color | 3 | meter
15.9 |  | 1/2 inch Red color | 1/2 inch Red color | 1/2 inch Red color | 3 | meter
15.10 |  | 1/2 inch Yellow color | 1/2 inch Yellow color | 1/2 inch Yellow color | 3 | meter
15.11 |  | 1/2 inch Blue color | 1/2 inch Blue color | 1/2 inch Blue color | 3 | meter
15.12 |  | 1/2 inch Black color | 1/2 inch Black color | 1/2 inch Black color | 3 | meter
15.13 |  | 3/4 inch Red color | 3/4 inch Red color | 3/4 inch Red color | 3 | meter
15.14 |  | 3/4 inch Yellow color | 3/4 inch Yellow color | 3/4 inch Yellow color | 3 | meter
15.15 |  | 3/4 inch Blue color | 3/4 inch Blue color | 3/4 inch Blue color | 3 | meter
15.16 |  | 3/4 inch Black color | 3/4 inch Black color | 3/4 inch Black color | 3 | meter
15.17 |  | 1/4 inch Red color | 1/4 inch Red color | 1/4 inch Red color | 3 | meter
15.18 |  | 1/4 inch Yellow color | 1/4 inch Yellow color | 1/4 inch Yellow color | 3 | meter
15.19 |  | 1/4 inch Blue color | 1/4 inch Blue color | 1/4 inch Blue color | 3 | meter
15.20 |  | 1/4 inch Black color | 1/4 inch Black color | 1/4 inch Black color | 3 | meter
 |  | Metal Gland for Field Side
 | Cable Gland | For Generator-1 Cooling Tower Pump |  |  | 1 | pcs |  |  | Information Required
 |  | For Generator-1 Cooling Tower Fan |  |  | 1 | pcs |  |  | Information Required
 |  | For Generator-2 Cooling Tower Pump |  |  | 1 | pcs |  |  | Information Required
 |  | For Generator-2 Cooling Tower Fan |  |  | 1 | pcs |  |  | Information Required
 |  | For Control Panel Electric Fire Water Pump |  |  | 1 | pcs |  |  | Information Required
 |  | For Condensate Transfer Pump P-300A/B |  |  | 2 | pcs |  |  | Information Required
 |  | For Condensate Recycle Pump P-200A/B |  |  | 2 | pcs |  |  | Information Required
 |  | For Inlet Air Cooler AC-100A/B |  |  | 2 | pcs |  |  | Information Required
 |  | For Overhead Gas Cooler E-300 |  |  | 1 | pcs |  |  | Information Required
 |  | For KOD Pump P-400 |  |  | 1 | pcs |  |  | Information Required
 |  | For Deep Well Pump P-700 |  |  | 1 | pcs |  |  | Information Required
 |  | For Deep Well Pump P-800 |  |  | 1 | pcs |  |  | Information Required
 |  | For star-delta starter for P-700 & P-800 |  |  | 8 | pcs |  |  | Information Required
 |  | Gland for Instrument Connection(TIT) |  |  | 20 | Nos |  |  | Information Required
 |  | Gland for Instrument Connection(PIT) |  |  | 21 | Nos |  |  | Information Required
 |  | Gland for Instrument Connection(PDIT) |  |  | 1 | Nos |  |  | Information Required
 |  | Gland for Instrument Connection(LILIT) |  |  | 15 | Nos |  |  | Information Required
 |  | Gland for Instrument Connection(LDIT) |  |  | 3 | Nos |  |  | Information Required
 |  | Gland for Instrument Connection(FIT) |  |  | 7 | Nos |  |  | Information Required
 |  | Gland for Instrument Connection(AT) |  |  | 1 | Nos |  |  | Information Required
 |  | Gland for Instrument Connection Position Switch (ZSC, ZSO) |  |  | 12 | Nos |  |  | Information Required
 |  | Gland for Instrument Connection Solenoid Valve (SDY,LY,FY,TY, PY,XY) |  |  | 27 | Nos |  |  | Information Required
 |  | Gland for Instrument Connection(GD) |  |  | 11 | Nos |  |  | Information Required
 |  | Gland for Instrument Connection(FD) |  |  | 9 | Nos |  |  | Information Required
 |  | Gland for Instrument Connection(MAC) |  |  | 6 | Nos |  |  | Information Required
 |  | Gland for Instrument Connection(BL) |  |  | 4 | Nos |  |  | Information Required
 |  | Gland for Instrument Connection(ESD switch) |  |  | 2 | Nos |  |  | Information Required
 |  | Gland for Vibration Switch |  |  | 3 | Nos
 |  | Spare Metal Cable Gland
 |  | 1/2''NPT Cable Gland |  |  | 50 | Nos
 |  | 3/4''NPT Cable Gland |  |  | 30 | Nos
 |  | 1''NPT Cable Gland |  |  | 20 | Nos
 |  | 1-1/4''NPT Cable Gland |  |  | 10 | Nos
 |  | 1-1/2''NPT Cable Gland |  |  | 10 | Nos
 |  | M12 Cable Gland |  |  | 30 | Nos
 |  | M20 Cable Gland |  |  | 30 | Nos
 |  | Blind Plug with locknut , size 1/2'' |  |  | 100 | Nos
 |  | Blind Plug with locknut , size 3/4'' |  |  | 100 | Nos
 |  | Blind Plug with locknut , size 1'' |  |  | 50 | Nos
 |  | Blind Plug with locknut , size 1-1/4'' |  |  | 50 | Nos
 |  | Blind Plug with locknut , size 1-1/2'' |  |  | 50 | Nos
 |  | Blind Plug with locknut , size M12 |  |  | 30 | Nos
 |  | Blind Plug with locknut , size M20 |  |  | 30 | Nos
 |  | CW PVC Shroud for 1/2''NPT Gland |  |  | 450 | Nos
 |  | CW PVC Shroud for 3/4''NPT Gland |  |  | 100 | Nos
 |  | CW PVC Shroud for 1''NPT Gland |  |  | 50 | Nos
 |  | CW PVC Shroud for 1-1/4''NPT Gland |  |  | 50 | Nos
 |  | CW PVC Shroud for 1-1/2''NPT Gland |  |  | 50 | Nos
 |  | PG Gland
 |  | PG-10 with Lock Nut |  |  | 50 | Nos
 |  | PG-13 with Lock Nut |  |  | 50 | Nos
 |  | PG-21 with Lock Nut |  |  | 50 | Nos
 |  | PG-29 with Lock Nut |  |  | 50 | Nos
 |  | PG-36 with Lock Nut |  |  | 50 | Nos
 |  | PG-42 with Lock Nut |  |  | 20 | Nos
 |  | PG-48 with Lock Nut |  |  | 20 | Nos
19.0
19.1 | Lightning Protection | Lightning Arrestor For Generator Building (Height:1 meter; Dia: 25mm) | Lightning Protection For Generator Building | Lightning Protection For Generator Building | 4 | Nos.
19.2 |  | Lightning Arrestor For Operator Building (Height:1 meter; Dia: 25mm) | Lightning Protection For Control Building | Lightning Protection For Control Building | 4 | Nos.
19.3 |  | Lightning Arrestor For Tank (Height:1 meter; Dia: 25mm) | Lightning Protection For TANK | Lightning Protection For TANK | 2 | Nos
20.0
20.1 | Angle Bar | Angle bar (Cable Support) 1''x1'' |  |  | 150 | meter |  |  | Thickness 3 mm
20.2 |  | Angle bar (Cable Support) 1.5''x1.5'' |  |  | 150 | meter |  |  | Thickness 3 mm
21.0 |  | Angle bar (Generator Silenser Support) 2'' x 2'' |  |  | 160 | meter |  |  | Thickness 3 mm
 |  | C-channel for Panel Installation (base) Size: D=100mm, B=50mm, t=5mm, T=7.7mm |  |  | 100 | meter
21.1 | PVC Conduit | PVC Conduit Size 2'' |  |  | 50 | meter |  |  | Dhaka
21.2 |  | PVC Conduit Size 1.5'' | PVC Conduit Size 1.5'' | PVC Conduit Size 1.5'' | 100 | meter |  |  | Dhaka
21.3 |  | PVC Conduit Size 3/4'' | PVC Conduit Size 3/4'' | PVC Conduit Size 3/4'' | 50 | meter |  |  | Dhaka
21.4 |  | PVC Coted Alluminium Flexible Hose pipe 1 Inch | Hose pipe | Hose pipe | 100 | meter
 |  | PVC Coted Alluminium Flexible Hose pipe 1.5 inch | Hose pipe | Hose pipe | 100 | meter
 |  | Fittings for 1 Inch PVC Coted Alluminium Flexible Hose pipe | Hose pipe | Hose pipe | 1 | lot
 |  | Fittings for 1.5 Inch PVC Coted Alluminium Flexible Hose pipe | Hose pipe | Hose pipe | 1 | lot
22.0
22.1 | Royal Bolt | Royal Bolt(6mm) | Royal Bolt(6mm) | Royal Bolt(6mm) | 100 | pcs |  |  | Dhaka
22.2 |  | Royal Bolt(8mm) | Royal Bolt(8mm) | Royal Bolt(8mm) | 100 | pcs |  |  | Dhaka
22.3 |  | Royal Bolt(10mm) | Royal Bolt(10mm) | Royal Bolt(10mm) | 100 | pcs |  |  | Dhaka
22.4 |  | Royal Bolt(12mm) FOR CABLE TRENCH ANGLE SUPPORT |  |  | 350 | pcs |  |  | Dhaka
23.0
23.1 | Cable Tie | Cable Tie , Size 24'' |  |  | 50 | Packet
23.2 |  | Cable Tie , Size 12'' |  |  | 100 | Packet
23.3 |  | Cable Tie , Size 8 '' |  |  | 100 | Packet
23.4 |  | Cable Tie , Size 6'' |  |  | 50 | Packet
24.0
24.1 | U-Bolt | U-bolt, Size 2'' (As per GI pipe size) |  |  | 100 | Nos
24.2 |  | U-bolt, Size 1.5'' (As per GI pipe size) |  |  | 100 | Nos
24.3 |  | U-bolt, Size 1'' (As per GI pipe size) |  |  | 650 | Nos
 |  | U-bolt, Size 3/4'' (As per GI pipe size) |  |  | 150 | Nos
25.0
25.1 | Cable tagging | Cable tagging & marking |  |  | 1 | lot
25.2 |  | Ferrule 4 mm |  |  | 1 | lot
25.3 |  | Ferrule 6 mm |  |  | 1 | lot
 | Power Cable | 3CX 2.5mm2 |  |  | 6250 | meter
 |  | 3CX 4mm2 |  |  | 250 | meter
 |  | 4CX 2.5mm2 |  |  | 2330 | meter
 |  | 4CX 4mm2 |  |  | 840 | meter
 |  | 4CX 6mm2 |  |  | 970 | meter
 |  | 4CX 10mm2 |  |  | 410 | meter
 |  | 4CX 16mm2 |  |  | 220 | meter
 |  | 12CX1.5mm2 |  |  | 3360 | meter
 |  | 3C x 4 mm2(Flat) |  |  | 1100 | meter |  |  | Dhaka
 |  | 1C X 150 mm2 |  |  | 680 | meter
 |  | 4C X 95 mm2 |  |  | 110 | meter
 |  | 4C x 185 mm2 |  |  | 290 | meter
 |  | 24C x 1.5 mm2 |  |  | 200 | meter
 |  | UTILITY POWER WORKSHOP BUILDING (CABLE SIZE 4CX 10mm2) |  |  | 250 | meter |  |  | Here considered double cable for welding generator
 |  | For Aircraft warning light (3CX 2.5mm2) |  |  | 60 | meter |  |  | Spec. required from Aircraft warning light vendor
26.0 | Field Fire & Gas Equipment
26.1 |  | IR Combustible Gas Detector (Model: IR4000S) |  |  | 11 | Nos
26.2 |  | 316 SS 2" Pipe Moutning Bracket |  |  | 8 | Nos
26.3 |  | UV/IR Flame Detector (Model No: FL3100H) |  |  | 9 | Nos
26.4 |  | 316 SS 2" Pipe Moutning Bracket |  |  | 9 | Nos
26.5 |  | Manual Alarm Call Point (Model No: BGE) |  |  | 6 | Nos
26.6 |  | 2" Pipe Moutning Bracker |  |  | 6 | Nos
26.7 |  | Beacon & Horn (Model No: DB3BDGD048T1BNR) |  |  | 4 | Nos
26.8 |  | 2" Pipe mounting bracket |  |  | 4 | Nos
26.9 |  | ESD Push Button (Model: PBE) |  |  | 2 | Nos
26.10 |  | 2" pipe mounting bracket |  |  | 2 | Nos
27.0 | Building Fire & Gas Equipment
27.1 |  | Adressable Fire Alarm Master Panel |  |  | 1 | Set
27.2 |  | Model: LD128E(Q)I64C
27.3 |  | Addressable Photoelectric Smoke Detector with Base (Model: LD300EN/A) |  |  | 20 | Nos
27.4 |  | Intelligent Heat Detector with Base (Model: LD3300EN) |  |  | 11 | Nos
27.5 |  | Addressable Manual Call Point (Model: LD2000EN) |  |  | 6 | Nos
27.6 |  | Horn & Strobe (Model No: LD8402) |  |  | 7 | Nos
27.7 |  | Supervisory Output Module (Model: LD6800EC-1) |  |  | 4 | Nos
27.8 |  | Power Supply (Model No: LD5801E) |  |  | 1 | Nos
27.9 |  | Battery (38Ah12V) |  |  | 2 | Nos
27.10 |  | Alarm Annunciator Panel (LD128E) |  |  | 1 | Nos
27.11 |  | Standard Cabinet (LD5900EL) |  |  | 1 | Nos
27.12 |  | Bus Device Programmer (LD128EN-100) |  |  | 1 | Nos
27.13 |  | Communication Conversion Card (LD6907EN) |  |  | 1 | Nos
27.14 |  | CRT Software |  |  | 1 | Nos
28.0
28.1 |  | Moisture Transmitter (Hygrpro 11R) |  |  | 1 | No
28.2 |  | Sample Cell 2830 |  |  | 1 | No
29.0 | Instrument Panels
29.1 |  | Process Mimic Panel |  |  | 1 | No
29.2 |  | F&G Mimic Panel |  |  | 1 | No
 |  | Mimic Panel For Building F&G |  |  | 1 | No
29.3 |  | ESD Hard Wire Console |  |  | 1 | No
29.4 |  | DCS Main Control Panel |  |  | 1 | No
29.5 |  | Control Panel for ESD and F&G |  |  | 1 | No
29.6 |  | Remote IO Control Panel at MCC Room |  |  | 1 | No
 |  | Engineering Station,Operator Station |  |  | 2 | Nos
 |  | Dextop Monitor |  |  | 4 | Nos
 |  | Color Laser Jet Printer |  |  | 1 | Nos
 |  | Dot Printer |  |  | 1 | Nos
 |  | Flow Computer |  |  | 1 | Nos
30.0 | Instrument Junction Boxes as per 252-I JB_14122015
30.1 |  | PCS Marshilling Junction Box |  |  | 5 | sets
30.2 |  | Tag Number: JB-01I, JB-02I, JB-03I, JB-04I, JB-05I
30.3 |  | ESD Junction Box |  |  | 2 | Sets
30.4 |  | Tag Number: JB-06I, JB-07I,
30.5 |  | F&G Junction Box |  |  | 5 | Sets
30.6 |  | Tag Number: JB-08I, JB-09I, JB-10I, JB-11I, JB-12I
30.7 |  | Flow Computer Junction Box |  |  | 1 | Set
30.8 |  | Tag Number : JB-013I
 | Telecommunication System
 |  | PABX |  |  | 1 | Nos
 |  | Master Dextop Telephone Hand Set |  |  | 1 | Nos
 |  | Dextop Telephone Hand Set |  |  | 12 | Nos
 |  | Walki-Talki |  |  | 8 | Nos
 |  | 4 Way Small JB(Hole Size 1/2'' NPT) |  |  | 25 | Sets
 |  | 3 Way Small JB(Hole Size 1/2'' NPT) |  |  | 40 | Sets
 |  | 4 Way Small JB(Hole Size 3/4'' NPT) |  |  | 15 | Sets
 |  | 3 Way Small JB(Hole Size 3/4'' NPT) |  |  | 20 | Sets
 | Instrument Cable | 18X2X1.5mm2 |  |  | 1420 | Meter
 |  | 10X2X1.5mm2 |  |  | 1150 | Meter
 |  | 5X2X1.5mm2 |  |  | 535 | Meter
 |  | 2X2X1.5mm2 |  |  | 770 | Meter
 |  | 1X2X1.5mm2 |  |  | 2430 | Meter
 |  | 1X24X1.5mm2 |  |  | 160 | Meter
 | Instrument Cable For FGS System | 18X2X1.5mm2 |  |  | 1420 | Meter
 |  | 10X2X1.5mm2 |  |  | 930 | Meter
 |  | 5X2X1.5mm2 |  |  | 520 | Meter
 |  | 1X2X1.5mm2 |  |  | 680 | Meter
 |  | 2X2X1.5mm2 |  |  | 160 | Meter
 | Fire Retardant Cable For FGS System | 4X2X1.5mm2 |  |  | 100 | Meter
 |  | 3X2X1.5mm2 |  |  | 870 | Meter
 |  | 1X3X1.5mm2 |  |  | 230 | Meter
 |  | 1X2X1.5mm2 |  |  | 400 | Meter
 | Optical Fiber Cable For REMOTE IO | OPTICAL FIBER CABLE |  |  | 200 | Meter
 | Ethernet cable | CAT - 6 |  |  | 400 | Meter
 | Telephone Cable | 4X2X1.5mm2 |  |  | 300 | Meter
 | Telephone Cable | 1X2X1mm2 |  |  | 300 | Meter
 |  | K- TypeThermo couple Cable |  |  | 650 | Meter

Sheet: Gland Information
GLAND INFORMATION 2 x 75 MMSCFD GLYCOL DEHYDRATION TYPE GAS PROCESS PLANTT BANGLADESH GAS FIELDS COMPANY LIMITED. LOCATION : J
 | Category | Description of Materials | Gland Material | Cable Diameter | Thread Type | Thread Size | Qty | Unit | Remarks
16.0 |  | Metal Gland for Field Side
16.1 | Cable Gland | For Generator-1 Cooling Tower Pump | Brass Nickel | 16.8mm | Info Required | Info Required | 1 | pcs
16.2 |  | For Generator-1 Cooling Tower Fan | Brass Nickel | 16.8mm | Info Required | Info Required | 1 | pcs
16.3 |  | For Generator-2 Cooling Tower Pump | Brass Nickel | 24.3mm | Info Required | Info Required | 1 | pcs
16.4 |  | For Generator-2 Cooling Tower Fan | Brass Nickel | 24.3mm | Info Required | Info Required | 1 | pcs
16.5 |  | For Control Panel Electric Fire Water Pump | Brass Nickel | 57.2mm | Info Required | Info Required | 1 | pcs
16.6 |  | For Condensate Transfer Pump P-300A/B | Brass Nickel | 18.8mm | Info Required | Info Required | 2 | pcs
16.7 |  | For Condensate Recycle Pump P-200A/B | Brass Nickel | 15.4mm | Info Required | Info Required | 2 | pcs
16.8 |  | For Inlet Air Cooler AC-100A/B | Brass Nickel | 21mm | Info Required | Info Required | 2 | pcs
16.9 |  | For Overhead Gas Cooler E-300 | Brass Nickel | 15.4mm | Info Required | Info Required | 1 | pcs
16.10 |  | For KOD Pump P-400 | Brass Nickel | 15.4mm | Info Required | Info Required | 1 | pcs
16.11 |  | For Deep Well Pump P-700 | Brass Nickel | 16.8mm | Info Required | Info Required | 1 | pcs
16.12 |  | For Deep Well Pump P-800 | Brass Nickel | 16.8mm | Info Required | Info Required | 1 | pcs
16.13 |  | For star-delta starter for P-700 & P-800 | Brass Nickel | 16.8mm | Info Required | Info Required | 8 | pcs
 |  | Gland for Instrument Connection(TIT) | Brass Nickel | 10mm | NPT | 1/2'' | 20 | Nos
 |  | Gland for Instrument Connection(PIT) | Brass Nickel | 10mm | NPT | 1/2'' | 21 | Nos
 |  | Gland for Instrument Connection(PDIT) | Brass Nickel | 10mm | NPT | 1/2'' | 1 | Nos
 |  | Gland for Instrument Connection(LILIT) | Brass Nickel | 10mm | NPT | 1/2'' | 15 | Nos
 |  | Gland for Instrument Connection(LDIT) | Brass Nickel | 10mm | NPT | 1/2'' | 3 | Nos
 |  | Gland for Instrument Connection(FIT) | Brass Nickel | 10mm | NPT | 1/2'' | 7 | Nos
 |  | Gland for Instrument Connection(AT) | Brass Nickel | 10mm | NPT | 1/2'' | 2 | Nos
 |  | Gland for Instrument Connection Position Switch (ZSC, ZSO) | Brass Nickel | 10mm | Info Required | Info Required | 12 | Nos
 |  | Gland for Instrument Connection Solenoid Valve (SDY,LY,FY,TY, PY,XY) | Brass Nickel | 10mm | Info Required | Info Required | 27 | Nos
 |  | Gland for Instrument Connection(GD) | Brass Nickel | 16mm | NPT | 3/4'' | 11 | Nos
 |  | Gland for Instrument Connection(FD) | Brass Nickel | 16mm | NPT | 3/4'' | 9 | Nos
 |  | Gland for Instrument Connection(MAC) | Brass Nickel | 11mm | Info Required | Info Required | 6 | Nos
 |  | Gland for Instrument Connection(BL) | Brass Nickel | 18mm | Info Required | Info Required | 4 | Nos
 |  | Gland for Instrument Connection(ESD switch) | Brass Nickel | 10mm | Metric | M20 | 2 | Nos
 |  | Gland for Vibration Switch | Brass Nickel | 10mm | NPT | 3/4'' | 3 | Nos
 |  | Blind Plug with locknut , size 1/2'' | Brass Nickel/SS | N/A | NPT | 1/2'' | 100 | Nos
 |  | Blind Plug with locknut , size 3/4'' | Brass Nickel/SS | N/A | NPT | 3/4'' | 100 | Nos
 |  | Blind Plug with locknut , size 1'' | Brass Nickel/SS | N/A | NPT | 1'' | 50 | Nos
 |  | Blind Plug with locknut , size 1-1/4'' | Brass Nickel/SS | N/A | NPT | 1-1/4'' | 50 | Nos
 |  | Blind Plug with locknut , size 1-1/2'' | Brass Nickel/SS | N/A | NPT | 1-1/2'' | 50 | Nos
 |  | Blind Plug with locknut , size M12 | Brass Nickel/SS | N/A | Metric | M12 | 30 | Nos
 |  | Blind Plug with locknut , size M20 | Brass Nickel/SS | N/A | Metric | M20 | 30 | Nos
 |  | CW PVC Shroud for 1/2''NPT Gland | PVC |  |  | 1/2'' | 450 | Nos
 |  | CW PVC Shroud for 3/4''NPT Gland | PVC |  |  | 3/4'' | 100 | Nos
 |  | CW PVC Shroud for 1''NPT Gland | PVC |  |  | 1'' | 50 | Nos
 |  | CW PVC Shroud for 1-1/4''NPT Gland | PVC |  |  | 1-1/4'' | 50 | Nos
 |  | CW PVC Shroud for 1-1/2''NPT Gland | PVC |  |  | 1-1/2'' | 50 | Nos
 |  | Spare Metal Cable Gland
 |  | 1/2''NPT Cable Gland | Brass Nickel/SS |  | NPT | 1/2'' | 50 | Nos
 |  | 3/4''NPT Cable Gland | Brass Nickel/SS |  | NPT | 3/4'' | 30 | Nos
 |  | 1''NPT Cable Gland | Brass Nickel/SS |  | NPT | 1'' | 20 | Nos
 |  | 1-1/4''NPT Cable Gland | Brass Nickel/SS |  | NPT | 1-1/4'' | 10 | Nos
 |  | 1-1/2''NPT Cable Gland | Brass Nickel/SS |  | NPT | 1-1/2'' | 10 | Nos
 |  | M12 Cable Gland | Brass Nickel/SS |  | Metric | M12 | 30 | Nos
 |  | M20 Cable Gland | Brass Nickel/SS |  | Metric | M20 | 30 | Nos
 |  | PG Gland
 |  | PG-10 with Lock Nut | PVC |  |  |  | 50 | Nos
 |  | PG-13 with Lock Nut | PVC |  |  |  | 50 | Nos
 |  | PG-21 with Lock Nut | PVC |  |  |  | 50 | Nos
 |  | PG-29 with Lock Nut | PVC |  |  |  | 50 | Nos
 |  | PG-36 with Lock Nut | PVC |  |  |  | 50 | Nos
 |  | PG-42 with Lock Nut | PVC |  |  |  | 20 | Nos
 |  | PG-48 with Lock Nut | PVC |  |  |  | 20 | Nos
