skdzicombd/P_252_Documentation/(list of files, cad)

Other CAD files:
Location I/Cable Route Layout/252-0201-EMEL-DW00-0002_RevA - Electrical Cable Route Layout for Location I.dwg
Location I/Cable Tray Layout/252-0201-EMEL-DW00-0001_RevA - Electrical Cable Tray Layout for Location I.dwg
Location I/Design of Building Electrical System/Generator Building/252-0212-EMEL-DW00-0009_RevA - Design of Building Electrical Systems for Generator Building, Location I.dwg
Location I/Design of Building Electrical System/Operator Building/252-0212-EMEL-DW00-0009_RevA - Design of Building Electrical Systems for Operator Building, Location I.dwg
Location I/Design of Building Electrical System/Workshop Building/252-0212-EMEL-DW00-0009_RevA - Design of Building Electrical Systems for Workshop Building, Location I.dwg
Location I/Earthing Diagram/252-0201-EMEL-DW00-0006_RevA - Electrical Earting Layout for Location I.DWG
Location I/Electrical Equipment Layout for Generator Room/252-0212-EMEL-DW00-0005_RevA - Electrical Equipment Layout for Generator Room for Location I.dwg
Location I/Electrical Equipment Layout for UPS Room/252-0212-EMEL-DW00-0006_RevA - Electrical Equipment Layout for UPS Room for Location I.dwg
Location I/Lighting System Layout/252-0201-EMEL-DW00-0004_RevA - Electrical Equipment Layout for Lighting System, Location I.dwg
Location I/Single Line Diagrams (SLD)/252-0212-EMEL-DW00-0004_RevA - Single Line Diagram for UPS System, Location I.dwg
Location J/Cable Route Layout/252-0301-EMEL-DW00-0002_RevA - Electrical Cable Route Layout for Location J.dwg
Location J/Cable Tray Layout/252-0301-EMEL-DW00-0001_RevA - Electrical Cable Tray Layout for Location J.dwg
Location J/Design of Building Electrical System/Generator Building/252-0312-EMEL-DW00-0009_RevA - Design of Building Electrical Systems for Generator Building, Location J.dwg
Location J/Design of Building Electrical System/Operator Building/252-0312-EMEL-DW00-0009_RevA - Design of Building Electrical Systems for Operator Building, Location J.dwg
Location J/Design of Building Electrical System/Workshop Building/252-0312-EMEL-DW00-0009_RevA - Design of Building Electrical Systems for Workshop Building, Location J.dwg
Location J/Earthing Layout/252-0301-EMEL-DW00-0006_RevA - Electrical Earthing Layout for Location J.dwg
Location J/Electrical Equipment Layout for Generator Room/252-0312-EMEL-DW00-0005_RevA - Electrical Equipment Layout for Generator Room for Location J.dwg
Location J/Electrical Equipment Layout for UPS Room/252-0312-EMEL-DW00-0006_RevA - Electrical Equipment Layout for UPS Room for Location J.dwg
Location J/Lighting System Layout/252-0301-EMEL-DW00-0004_RevA Electrical Equipment Layout for Lighting System Location J.dwg
Location J/Single Line Diagrams (SLD)/252-0312-EMEL-DW00-0003_RevA - Single Line Diagram for Plant Lighting, Location J.dwg
Specifications/P252 building fire system/P-252 Fire Detection and Alarm System.dwg
Location I/Single Line Diagrams (SLD)/252-0212-EMEL-DW00-0001 & 252-0212-EMEL-DW00-0002_RevA - Single Line Diagram for MCC, Location I.dwg
Location J/Single Line Diagrams (SLD)/252-0312-EMEL-DW00-0001 & 252-0312-EMEL-DW00-0002_RevA - Single Line Diagram for MCC, Location J.dwg
Location I/Single Line Diagrams (SLD)/252-0212-EMEL-DW00-0003_RevA - Single Line Diagram for Plant Lighting, Location I.dwg
Location J/Single Line Diagrams (SLD)/252-0312-EMEL-DW00-0004_RevA - Single Line Diagram for UPS System for Location J.dwg
