skdzicombd/P_252_Documentation/Location I/Design of Building Electrical System/Generator Building/252-0212-EMEL-DW00-0009_RevA - Design of Building Electrical Systems for Generator Building, Location I.pdf

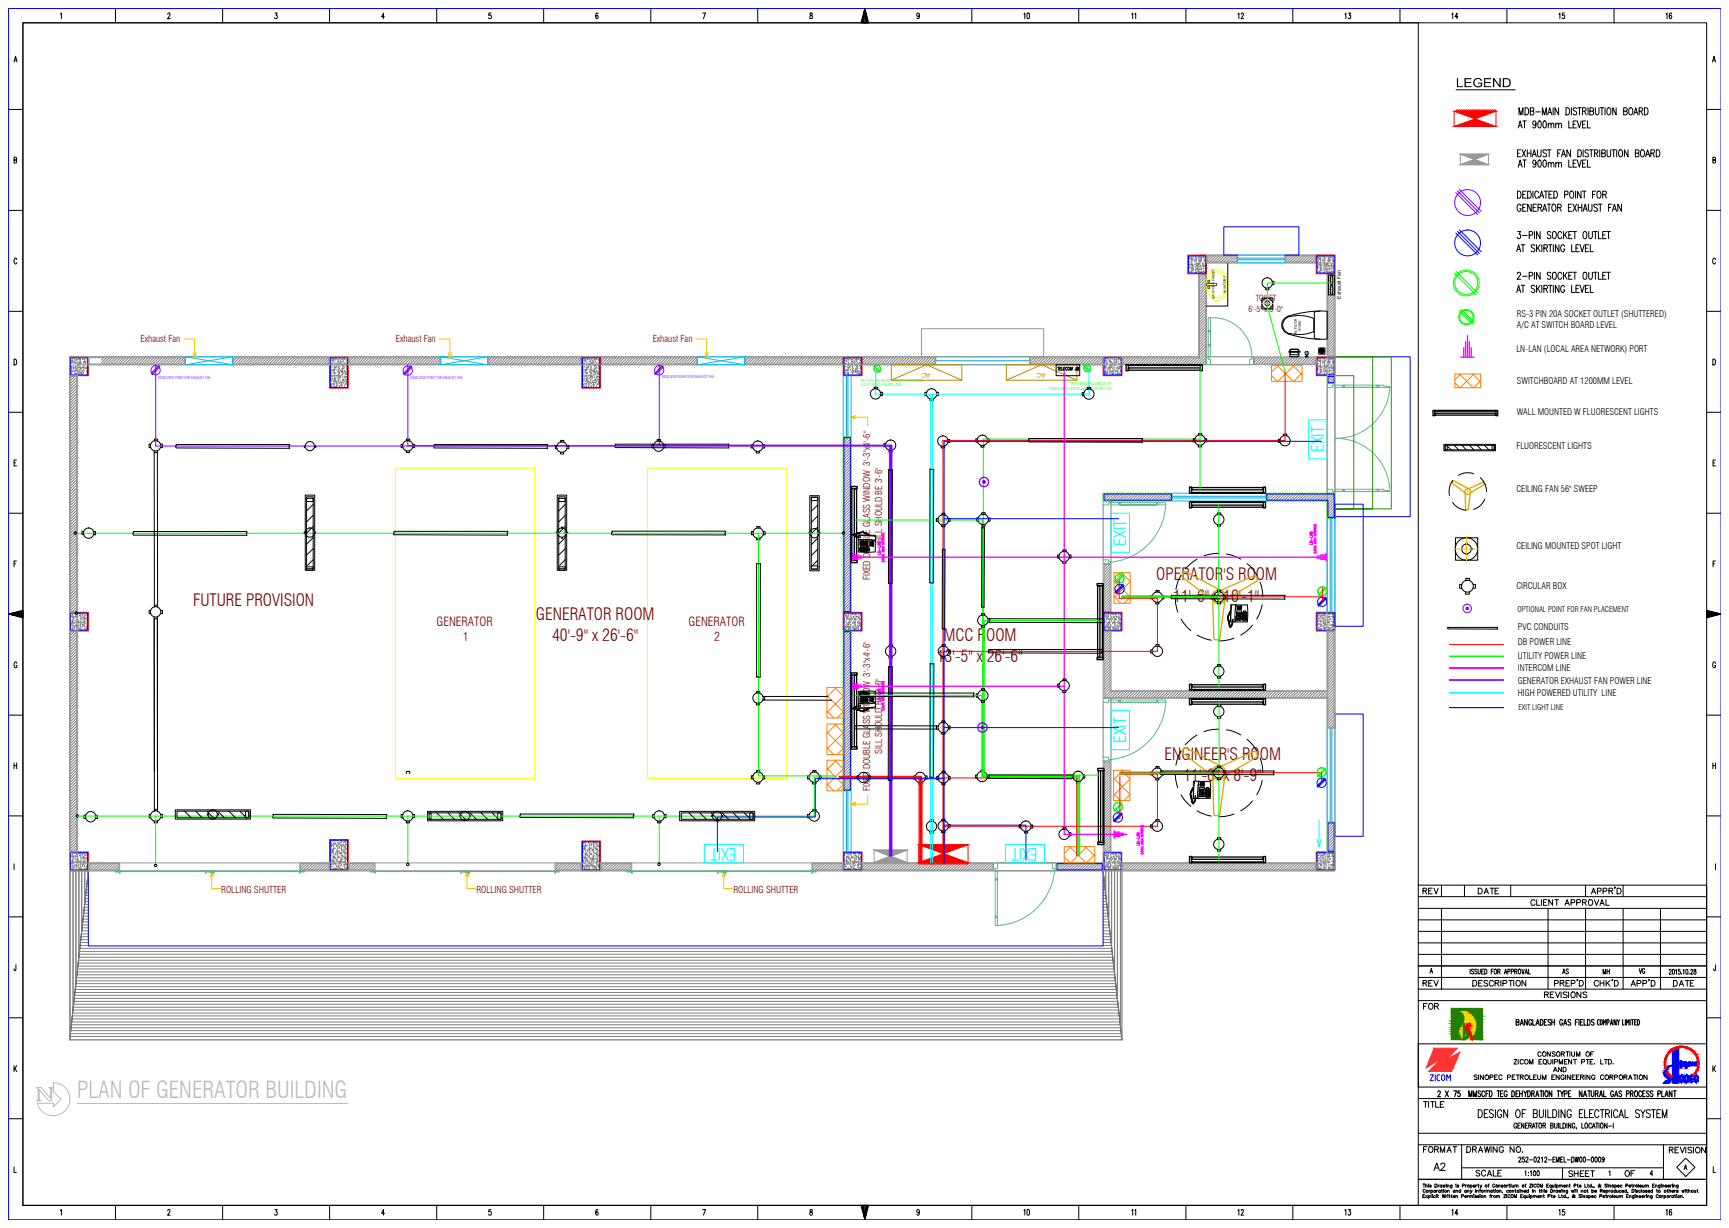
[picture p1: page 1]
MCC ROOM 13'-5" x 26'-6"; FUTURE PROVISION; ROLLING SHUTTER; GENERATOR ROOM 40'-9" x 26'-6"; LAVATORY FAUCET; WC FLOOR -; Exhaust Fan; OPERATOR'S ROOM 11'-6" x 10'-1"; ENGINEER'S ROOM 11'-6" x 8'-9"; FLUORESCENT LIGHTS; CIRCULAR BOX; DEDICATED POINT FOR EXHAUST FAN; EXIT EXIT

RS-3 PIN 20A SOCKET OUTLET (SHUTTERED)
A/C AT SWITCH BOARD LEVEL

LN-LAN (LOCAL AREA NETWORK) PORT

SWITCHBOARD AT 1200MM LEVEL

WALL MOUNTED W FLUORESCENT LIGHTS

FIXED DOUBLE GLASS WINDOW 3'-3"x4'-6"

SILL SHOULD BE 3'-6"

CEILING FAN 56" SWEEP

CEILING MOUNTED SPOT LIGHT

OPTIONAL POINT FOR FAN PLACEMENT
PVC CONDUITS
DB POWER LINE
UTILITY POWER LINE
INTERCOM LINE
GENERATOR EXHAUST FAN POWER LINE
HIGH POWERED UTILITY LINE
EXIT LIGHT LINE

PLAN OF GENERATOR BUILDING
