skdzicombd/P_252_Documentation/Location I/Design of Building Electrical System/Operator Building/252-0212-EMEL-DW00-0009_RevA - Design of Building Electrical Systems for Operator Building, Location I.pdf

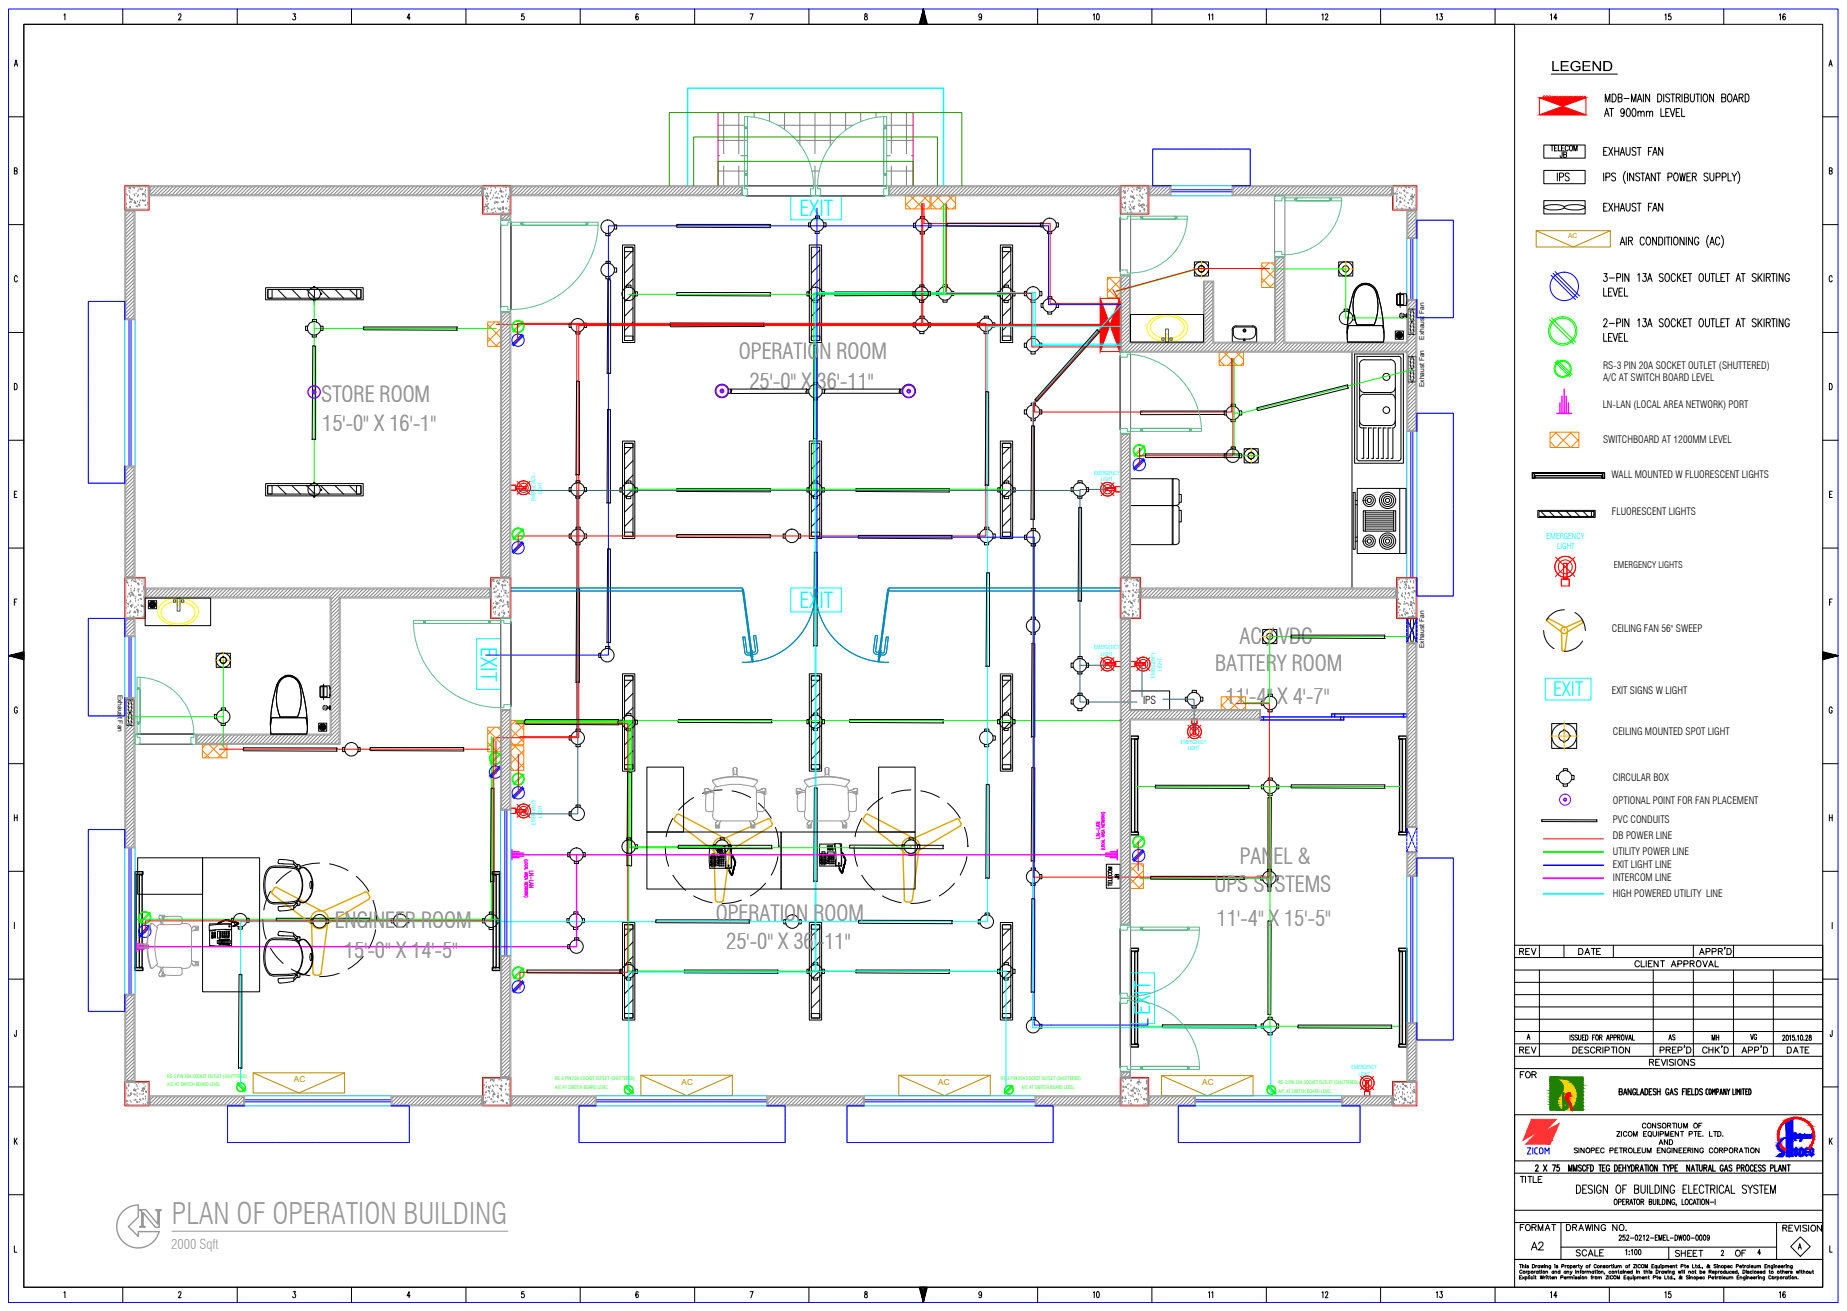
[picture p2: page 1]
2000 Sqft; STORE ROOM 15'-0" X 16'-1"; OPERATION ROOM 25'-0" X 36'-11"; ENGINEER ROOM 15'-0" X 14'-5"; BATTERY ROOM; AC / VDC; UPS SYSTEMS; PANEL &; Exhaust Fan; RS-3 PIN 20A SOCKET OUTLET (SHUTTERED); FLUORESCENT LIGHTS; CIRCULAR BOX; EXIT; EXIT SIGNS W LIGHT; EMERGENCY LIGHTS

RS-3 PIN 20A SOCKET OUTLET (SHUTTERED)
A/C AT SWITCH BOARD LEVEL

LN-LAN (LOCAL AREA NETWORK) PORT

SWITCHBOARD AT 1200MM LEVEL

WALL MOUNTED W FLUORESCENT LIGHTS

CEILING FAN 56" SWEEP

CEILING MOUNTED SPOT LIGHT

OPTIONAL POINT FOR FAN PLACEMENT
PVC CONDUITS
DB POWER LINE
UTILITY POWER LINE
EXIT LIGHT LINE
INTERCOM LINE
HIGH POWERED UTILITY LINE

AC RS-3 PIN 20A SOCKET OUTLET (SHUTTERED)

PLAN OF OPERATION BUILDING
