skdzicombd/P_252_Documentation/Location I/Design of Building Electrical System/Workshop Building/252-0212-EMEL-DW00-0009_RevA - Design of Building Electrical Systems for Workshop Building, Location I.pdf

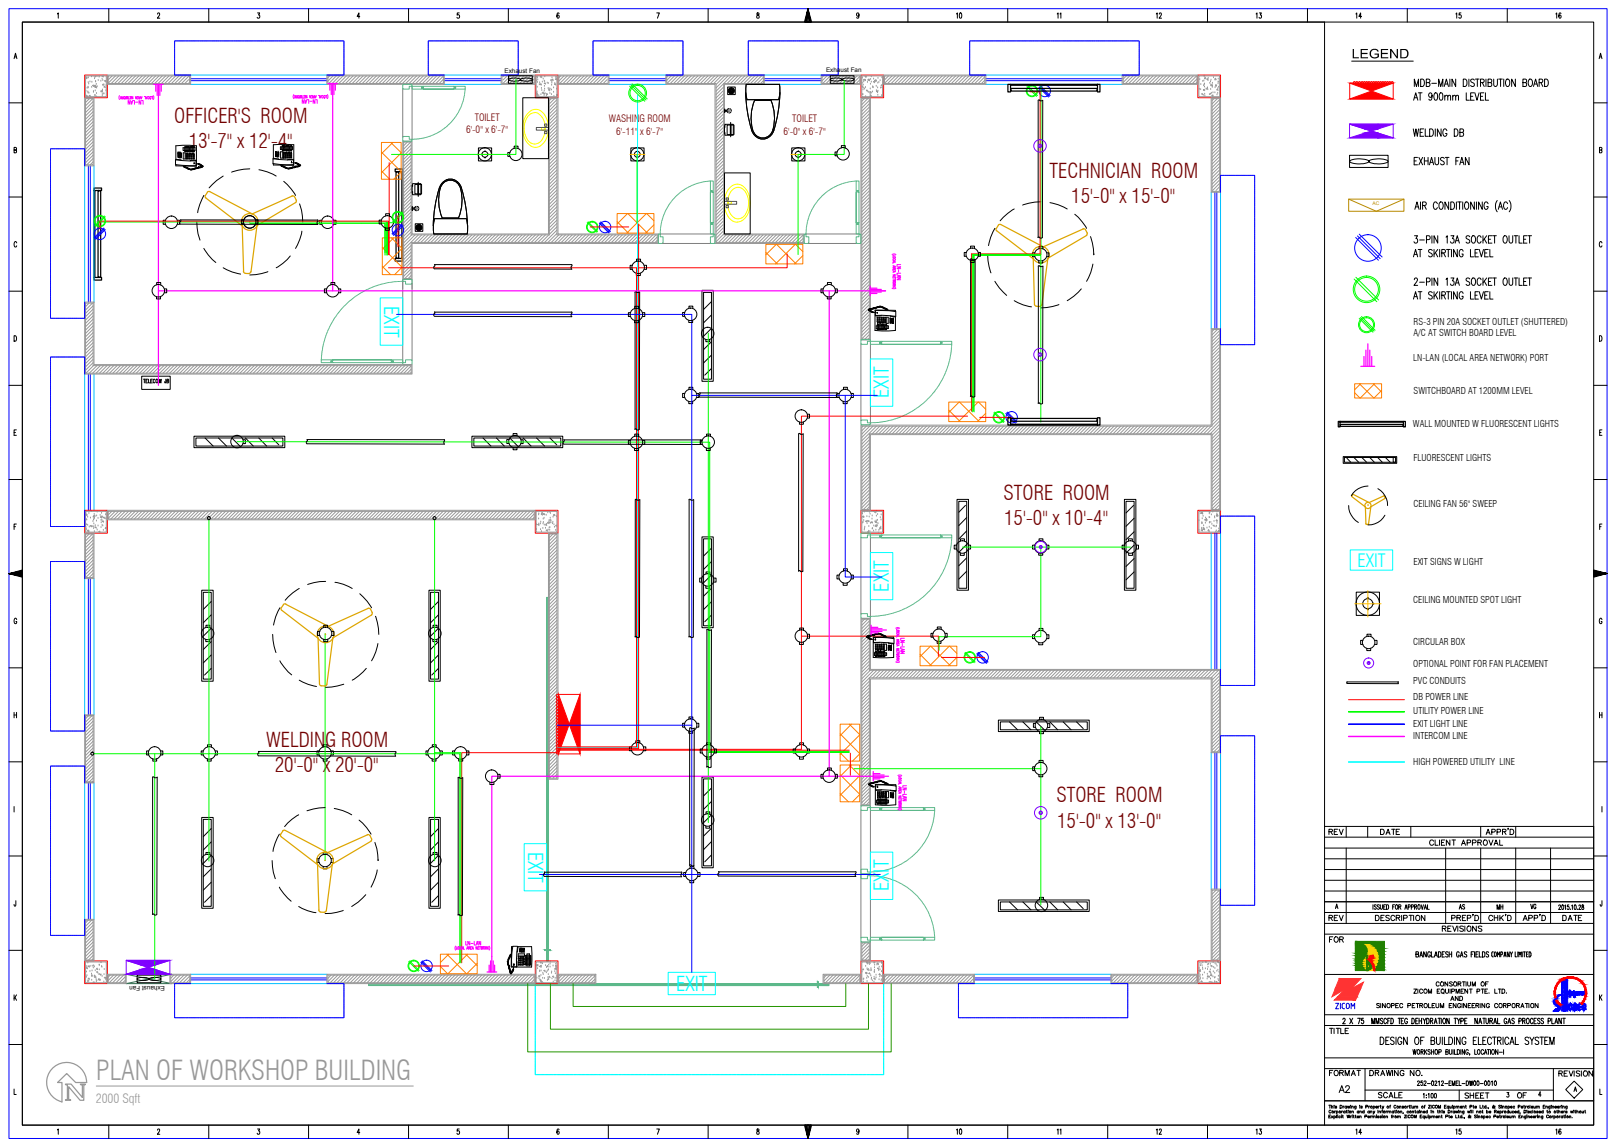
[picture p3: page 1]
STORE ROOM 15'-0" x 13'-0"; STORE ROOM 15'-0" x 10'-4"; OFFICER'S ROOM 13'-7" x 12'-4"; 2000 Sqft; WELDING ROOM 20'-0" x 20'-0"; TECHNICIAN ROOM 15'-0" x 15'-0"; WASHING ROOM 6'-11" x 6'-7"; Exhaust Fan; FLUORESCENT LIGHTS; CIRCULAR BOX; EXIT EXIT; EXIT; EXIT SIGNS W LIGHT

RS-3 PIN 20A SOCKET OUTLET (SHUTTERED)
A/C AT SWITCH BOARD LEVEL

LN-LAN (LOCAL AREA NETWORK) PORT

SWITCHBOARD AT 1200MM LEVEL

WALL MOUNTED W FLUORESCENT LIGHTS

CEILING FAN 56" SWEEP

CEILING MOUNTED SPOT LIGHT

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

HIGH POWERED UTILITY LINE

PLAN OF WORKSHOP BUILDING
