skdzicombd/P_252_Documentation/Location J/Design of Building Electrical System/Operator Building/252-0312-EMEL-DW00-0009_RevA - Design of Building Electrical Systems for Operator Building, Location J.pdf

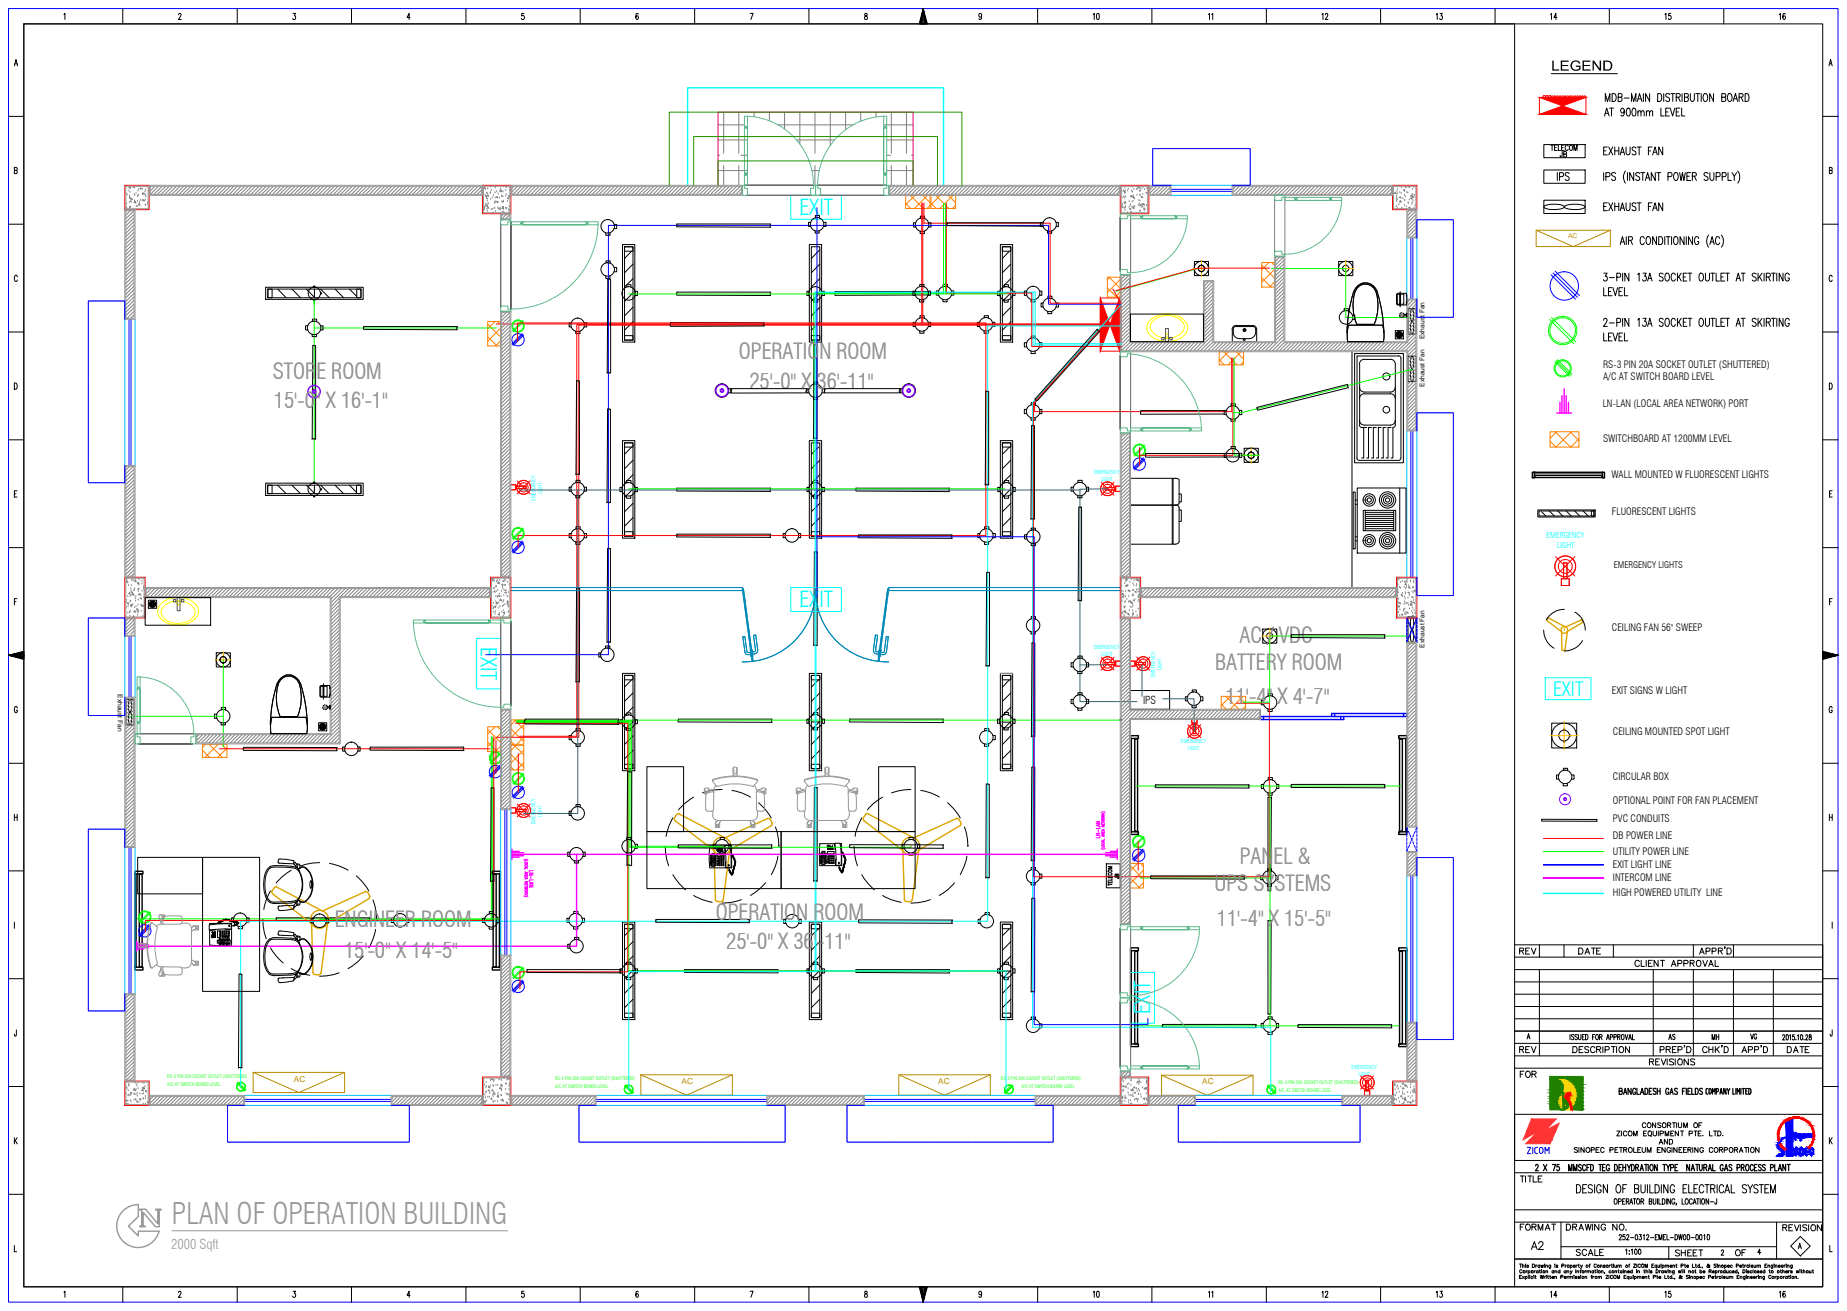
[picture p4: page 1]
PLAN OF OPERATION BUILDING 2000 Sqft; STORE ROOM 15'-0" X 16'-1"; OPERATION ROOM 25'-0" X 36'-11" ENGINEER ROOM 15'-0" X 14'-5"; 11'-4" X 15'-5" BATTERY ROOM AC / VDC 11'-4" X 4'-7" UPS SYSTEMS PANEL & OPERATION ROOM 25'-0" X 36'-11" AC RS-3 PIN 20A SOCKET OUTLET (SHUTTERED) A/C AT SWITCH BOARD LEVEL AC RS-3 PIN 20A SOCKET OUTLET (SHUTTERED) A/C AT SWITCH BOARD LEVEL; Exhaust Fan; A/C AT SWITCH BOARD LEVEL AC; RS-3 PIN 20A SOCKET OUTLET (SHUTTERED) A/C AT SWITCH BOARD LEVEL; LIGHT EMERGENCY

Exhaust Fan EXIT

EXIT EXIT EMERGENCY LIGHT EMERGENCY LIGHT RS-3 PIN 20A SOCKET OUTLET (SHUTTERED) A/C AT SWITCH BOARD LEVEL SWITCHBOARD AT 1200MM LEVEL FLUORESCENT LIGHTS CEILING MOUNTED SPOT LIGHT CIRCULAR BOX PVC CONDUITS DB POWER LINE UTILITY POWER LINE INTERCOM LINE HIGH POWERED UTILITY LINE CEILING FAN 56" SWEEP WALL MOUNTED W FLUORESCENT LIGHTS LN-LAN (LOCAL AREA NETWORK) PORT AC OPTIONAL POINT FOR FAN PLACEMENT EXIT LIGHT LINE EXIT EXIT SIGNS W LIGHT EMERGENCY LIGHT EMERGENCY LIGHTS IPS

LIGHT STORE ROOM 15'-0" X 16'-1" OPERATION ROOM 25'-0" X 36'-11" ENGINEER ROOM 15'-0" X 14'-5" 11'-4" X 15'-5" BATTERY ROOM AC / VDC 11'-4" X 4'-7" UPS SYSTEMS PANEL & OPERATION ROOM 25'-0" X 36'-11"

Exhaust Fan AC RS-3 PIN 20A SOCKET OUTLET (SHUTTERED)

LIGHT EMERGENCY LIGHT EMERGENCY LIGHT
