skdzicombd/P_252_Documentation/Location J/Design of Building Electrical System/Workshop Building/252-0312-EMEL-DW00-0009_RevA - Design of Building Electrical Systems for Workshop Building, Location J.pdf

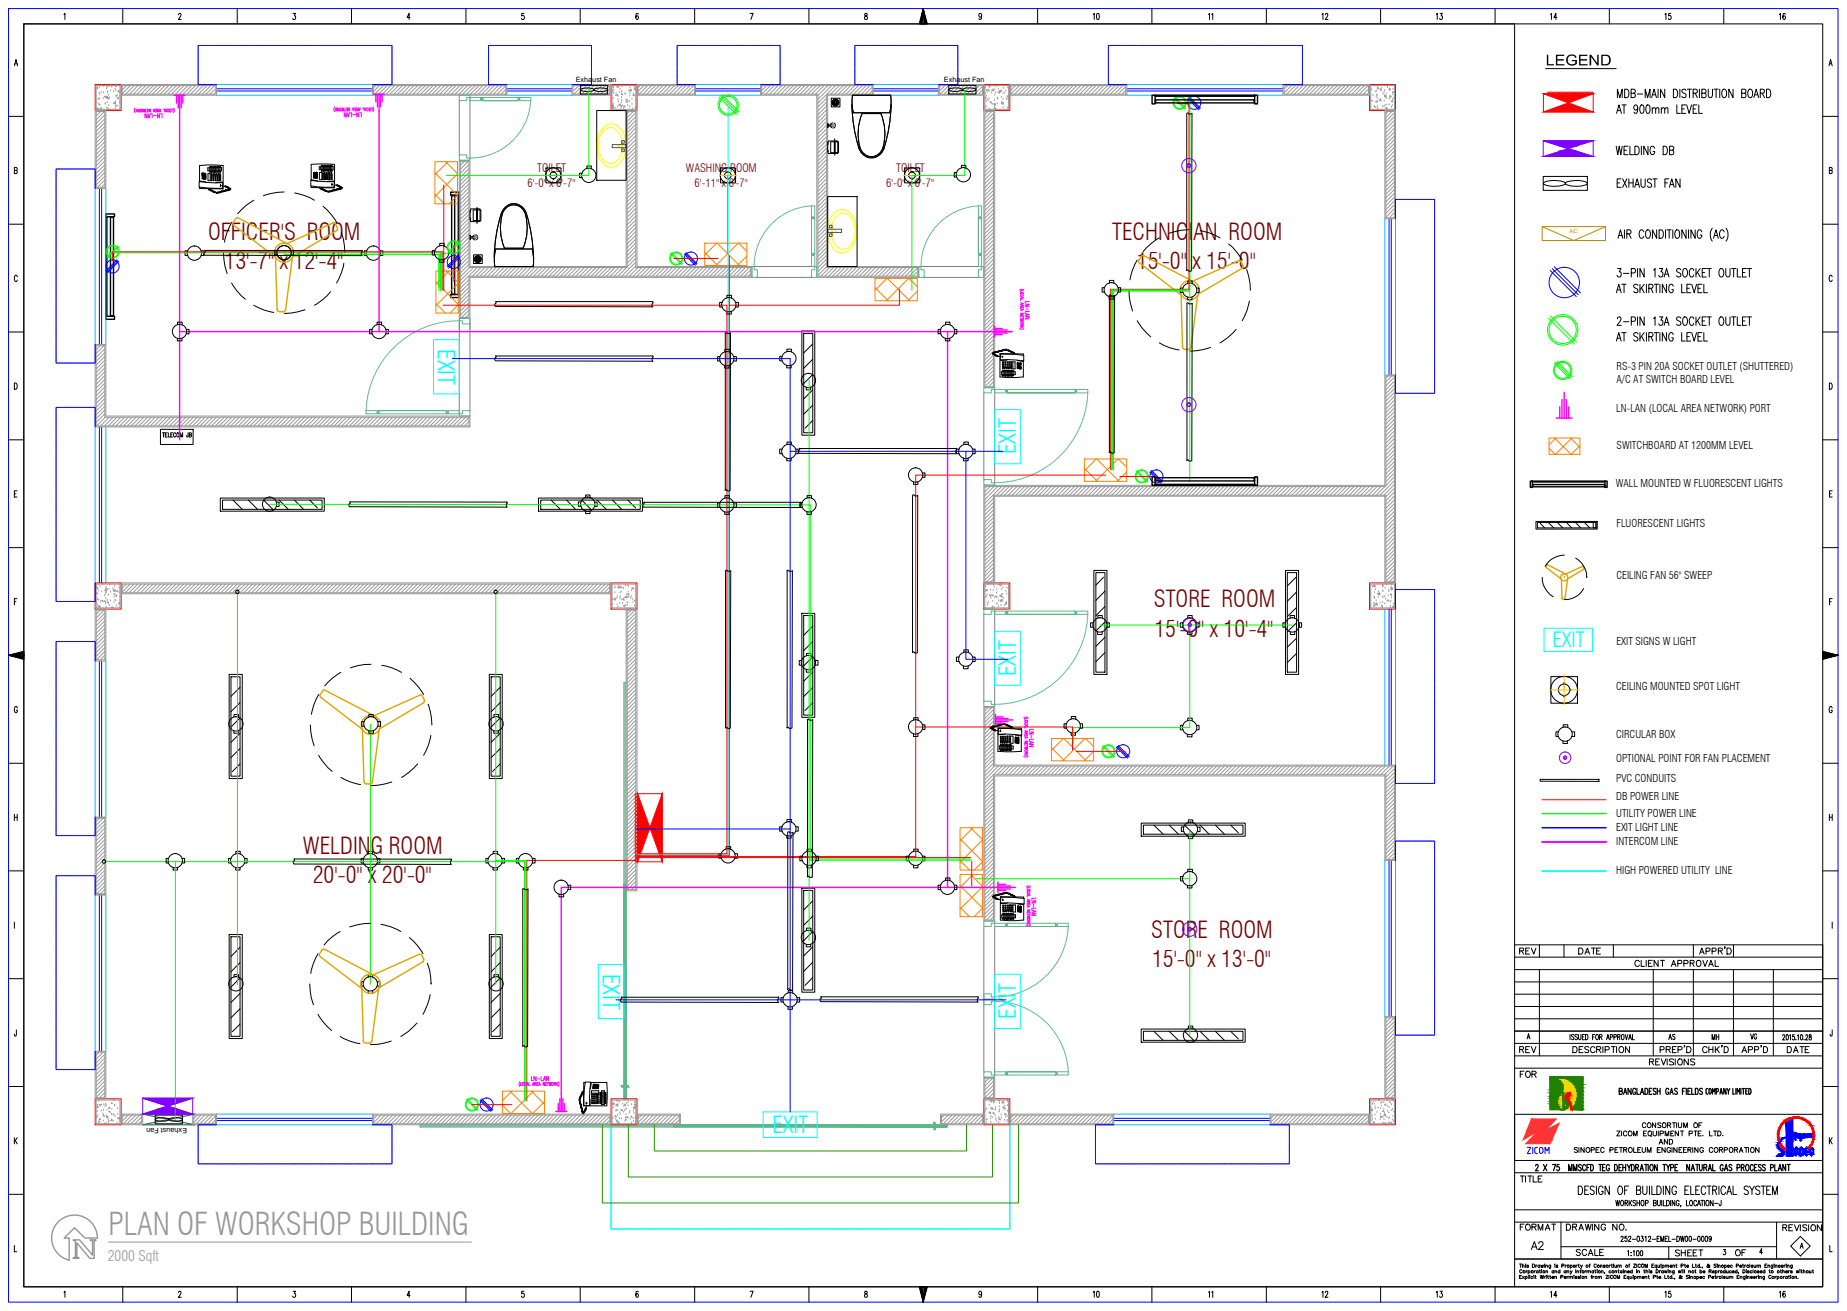
[picture p5: page 1]
STORE ROOM 15'-0" x 13'-0" STORE ROOM 15'-0" x 10'-4" OFFICER'S ROOM 13'-7" x 12'-4" PLAN OF WORKSHOP BUILDING 2000 Sqft; WELDING ROOM 20'-0" x 20'-0"; TECHNICIAN ROOM 15'-0" x 15'-0" TOILET 6'-0" x 6'-7"; WASHING ROOM 6'-11" x 6'-7"; TOILET 6'-0" x 6'-7" Exhaust Fan; Exhaust Fan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

EXIT EXIT EXIT LIGHT LINE EXIT EXIT SIGNS W LIGHT Exhaust Fan
