skdzicombd/P_252_Documentation/Location I/Electrical Equipment Layout for Generator Room/252-0212-EMEL-DW00-0005_RevA - Electrical Equipment Layout for Generator Room for Location I.pdf

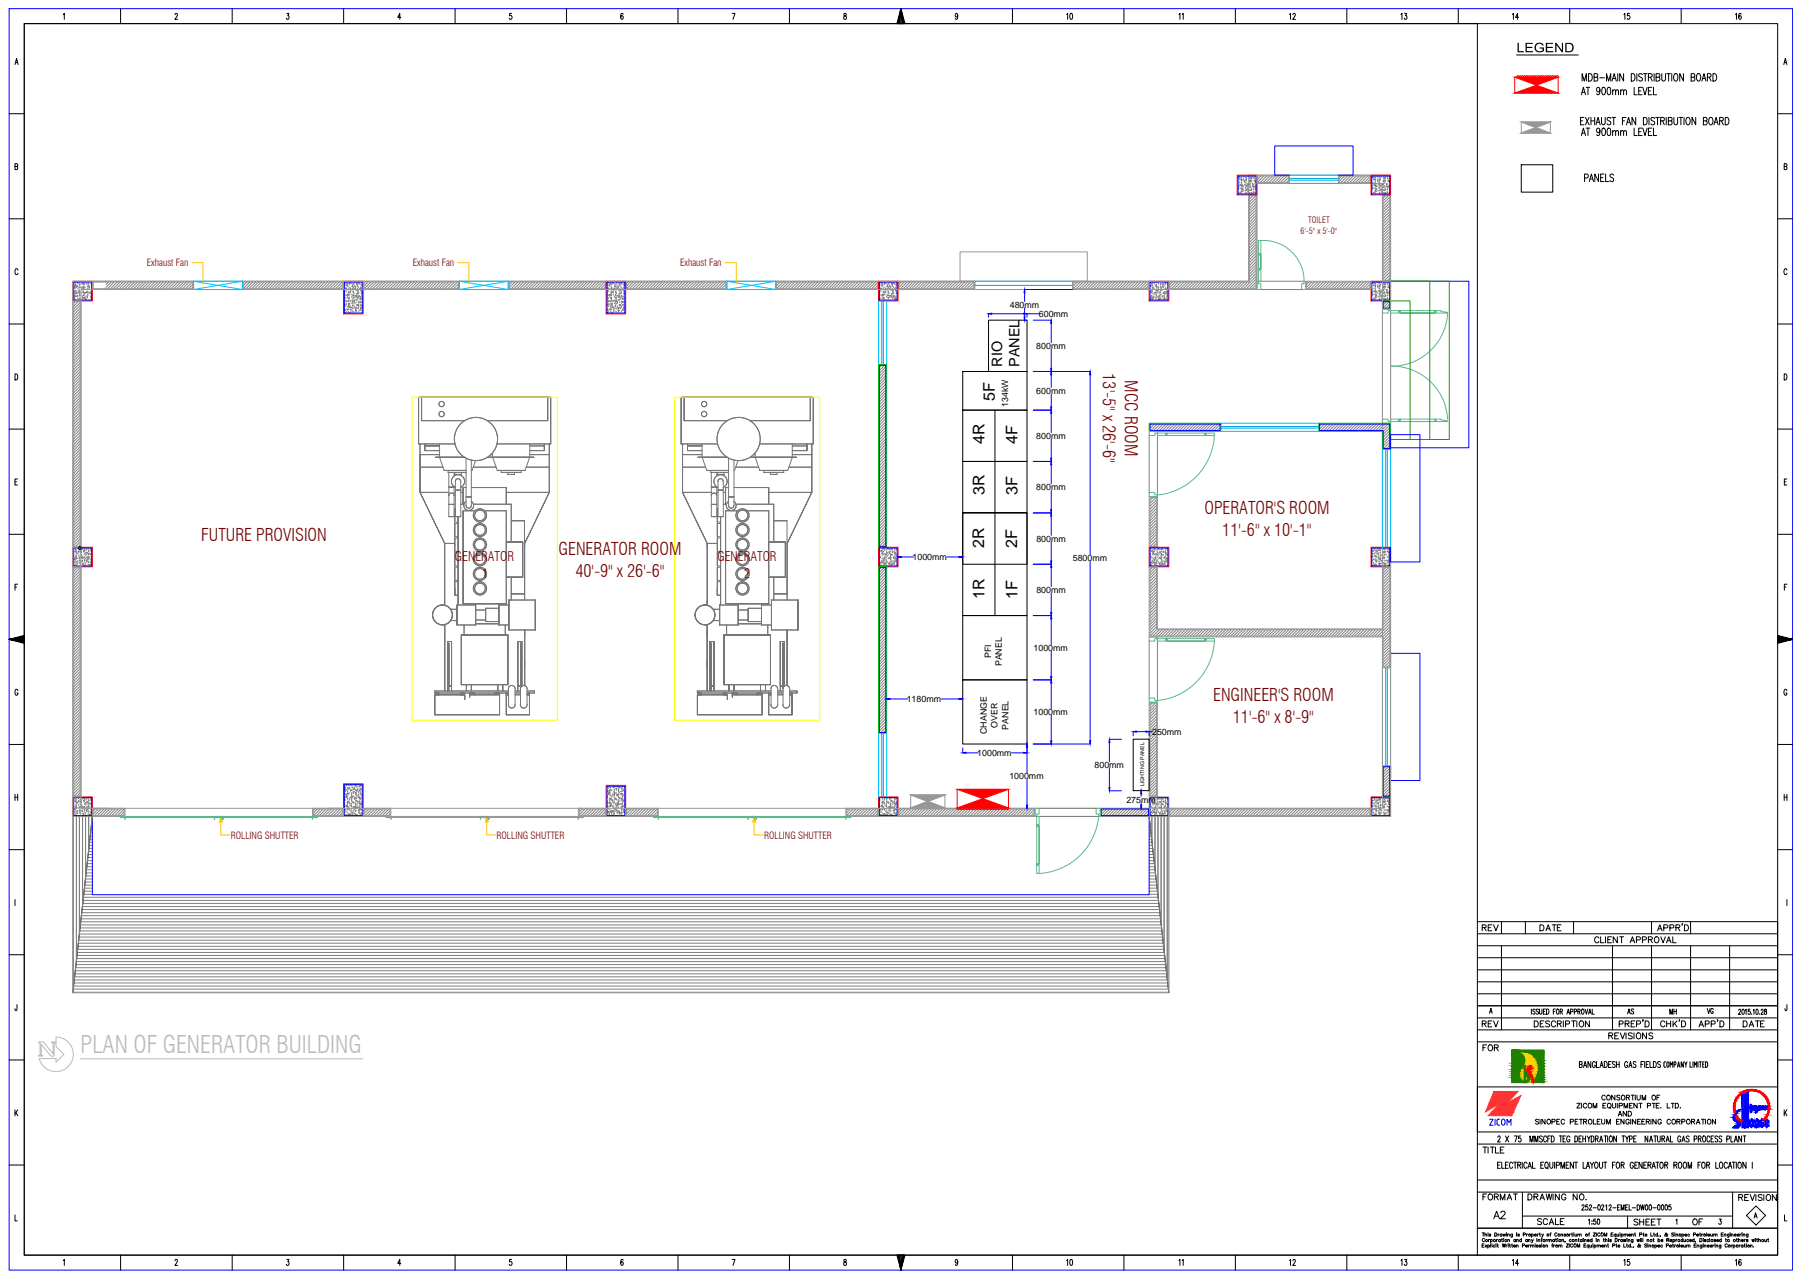
[picture p6: page 1]
MCC ROOM; LIGHTING PANEL; 1R 2R 3R 4R CHANGE; OVER; PANEL; PFI; PANEL 5800mm 600mm 800mm 800mm 800mm 800mm 1000mm 1000mm 1180mm 1000mm 800mm 250mm 1000mm 275mm; RIO

13'-5" x 26'-6" FUTURE PROVISION ROLLING SHUTTERGENERATOR ROOM 40'-9" x 26'-6" Exhaust Fan Exhaust Fan Exhaust Fan OPERATOR'S ROOM 11'-6" x 10'-1" ENGINEER'S ROOM 11'-6" x 8'-9"TOILET 6'-5" x 5'-0" ROLLING SHUTTER ROLLING SHUTTER PLAN OF GENERATOR BUILDING

PANEL 480mm600mm 800mm 1000mm GENERATOR 1 GENERATOR 2

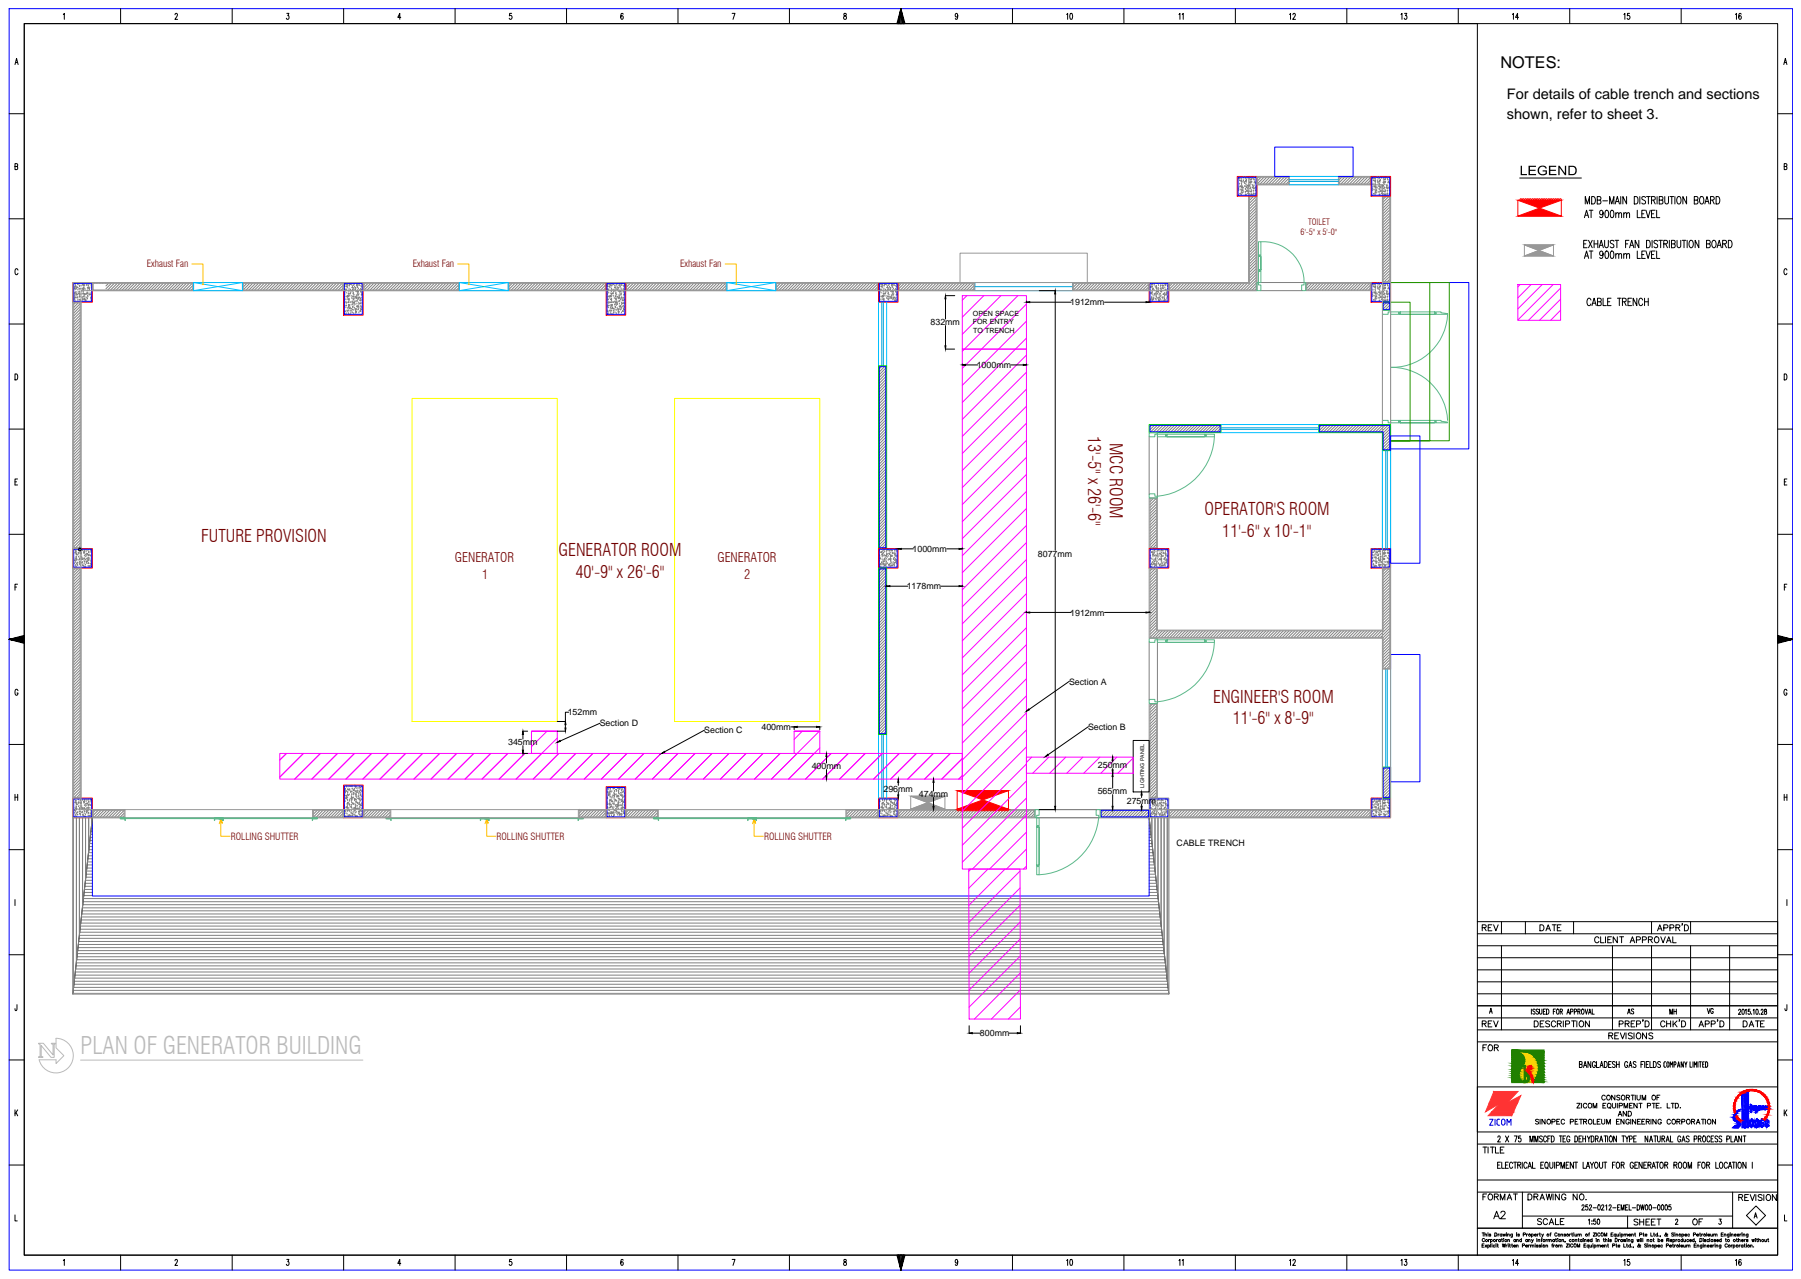
[picture p7: page 2]
MCC ROOM

LIGHTING PANEL 800mm NOTES: For details of cable trench and sections shown, refer to sheet 3.

13'-5" x 26'-6" FUTURE PROVISION GENERATOR 1 GENERATOR 2 ROLLING SHUTTERGENERATOR ROOM 40'-9" x 26'-6" Exhaust Fan Exhaust Fan Exhaust Fan OPERATOR'S ROOM 11'-6" x 10'-1" ENGINEER'S ROOM 11'-6" x 8'-9"TOILET 6'-5" x 5'-0" ROLLING SHUTTER ROLLING SHUTTER PLAN OF GENERATOR BUILDING CABLE TRENCH OPEN SPACE FOR ENTRY TO TRENCH 1912mm 1000mm 832mm 8077mm 1000mm 1178mm 1912mm 296mm 474mm 400mm 400mm 152mm 250mm Section A Section C Section D Section B 345mm 565mm275mm

SECTION A | SECTION B SECTION C | SECTION D ¹⁰⁰⁰mm | 1000mm | 300mm | 250mm 1000mm | 400mm | 345mm | 450mm 550mm 1000mm | 400mm

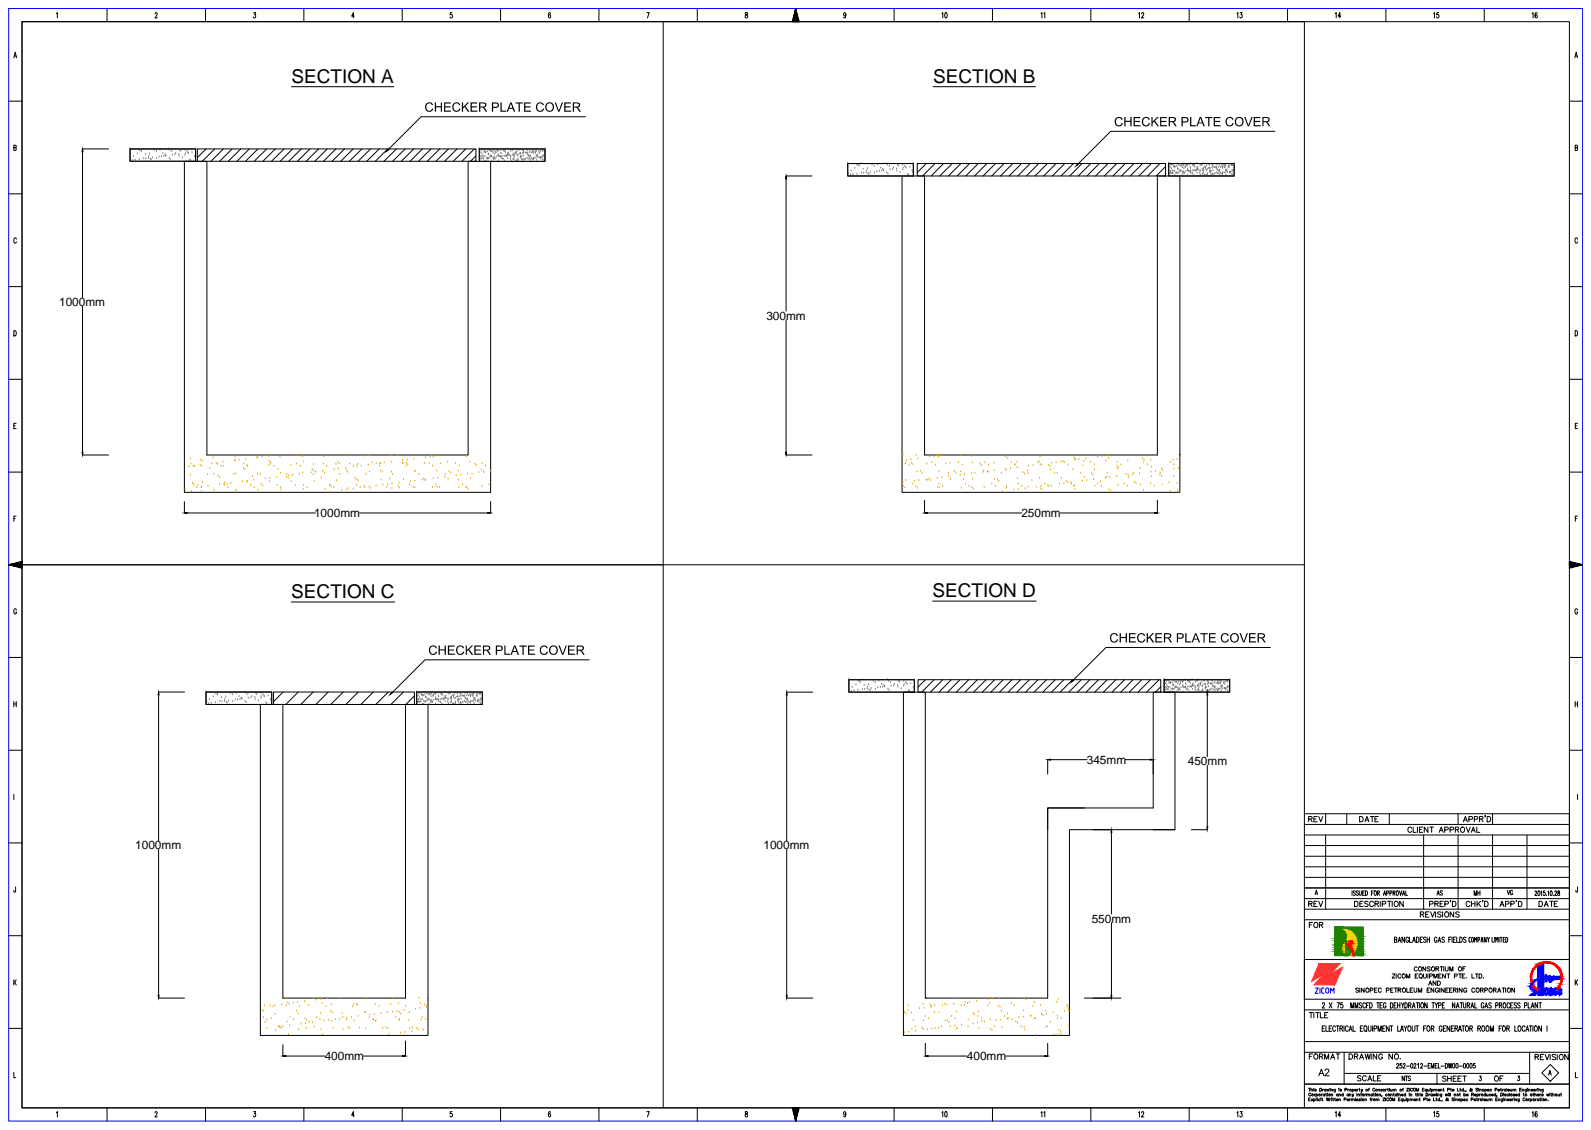
[picture p8: page 3]
