skdzicombd/P_252_Documentation/Location I/Electrical Equipment Layout for UPS Room/252-0212-EMEL-DW00-0006_RevA - Electrical Equipment Layout for UPS Room for Location I.pdf

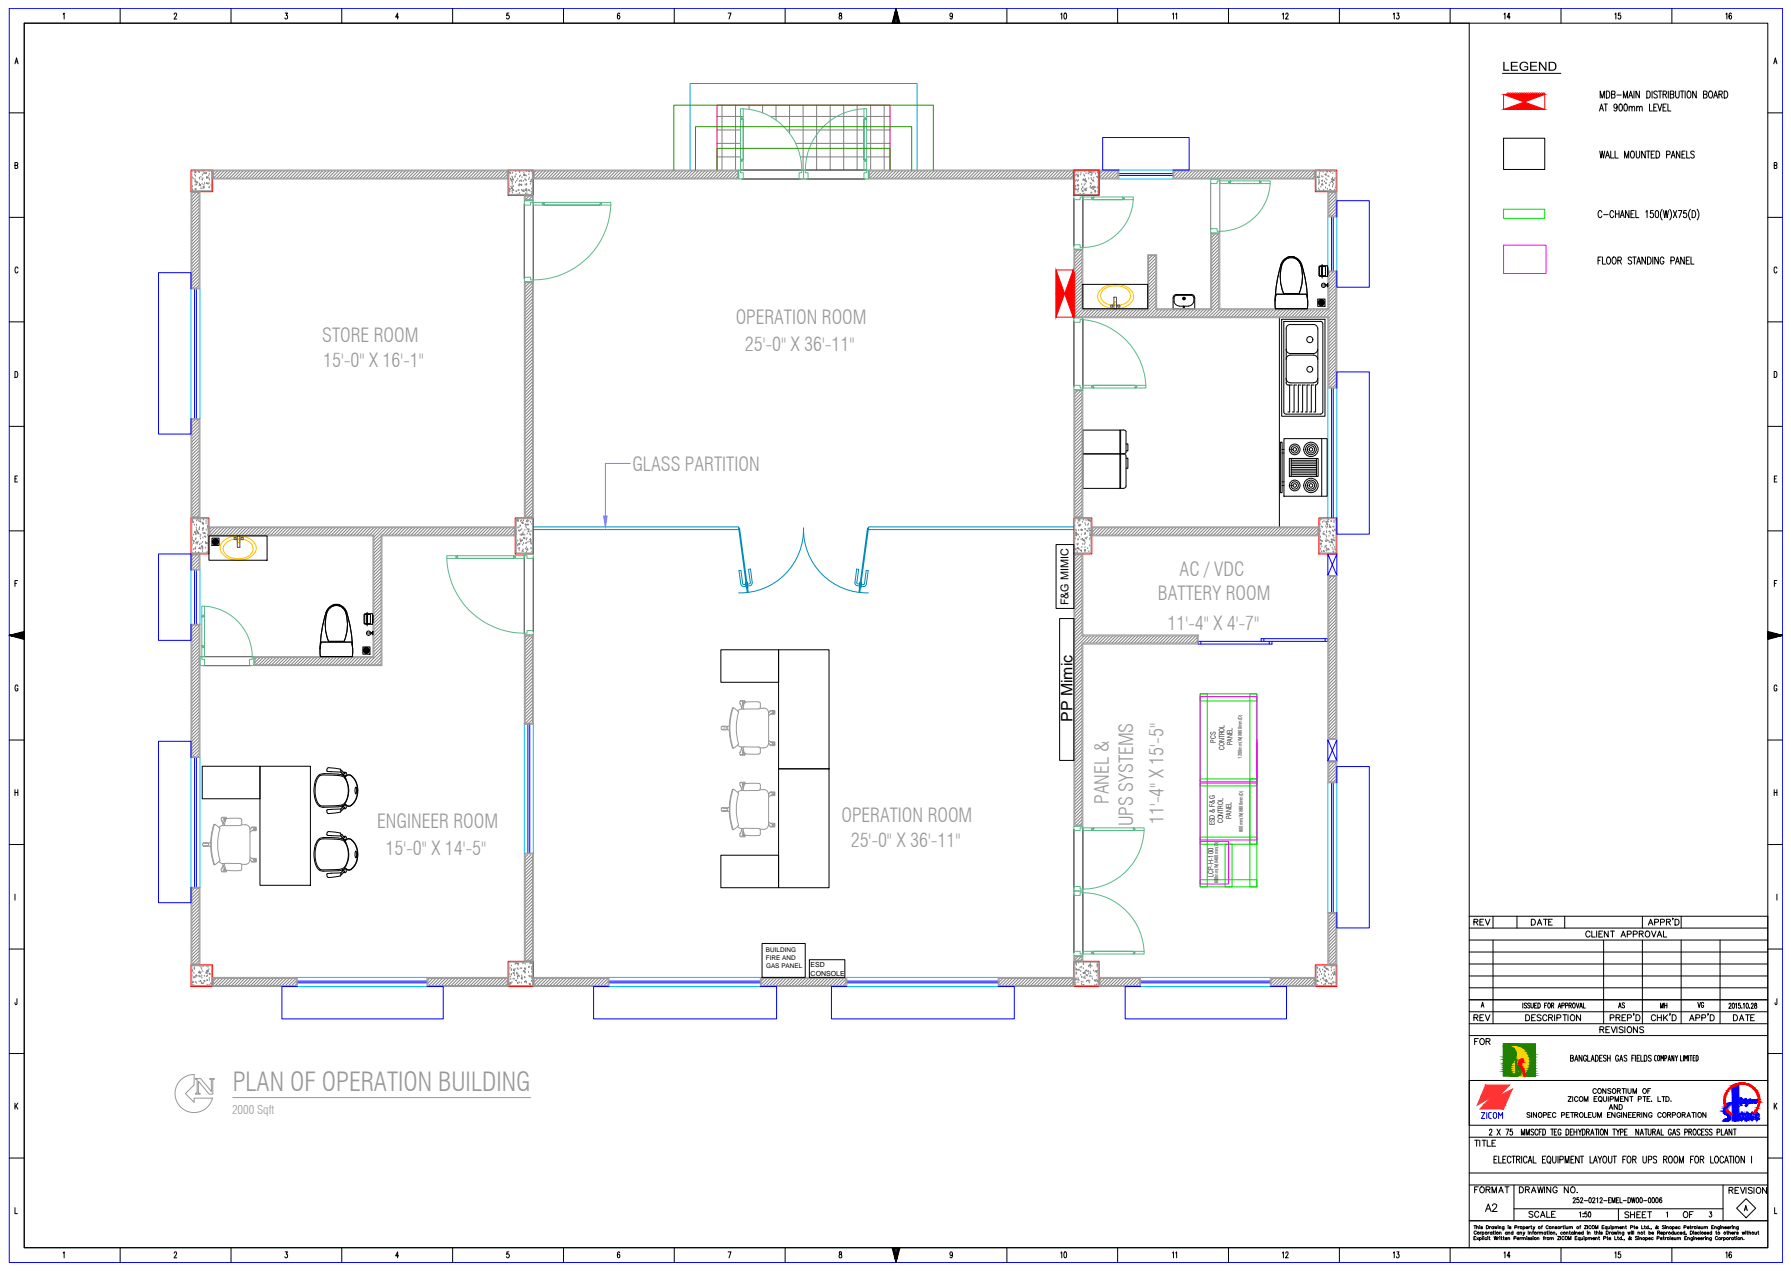
[picture p9: page 1]
PLAN OF OPERATION BUILDING 2000 Sqft; STORE ROOM 15'-0" X 16'-1" ENGINEER ROOM 15'-0" X 14'-5"; UPS SYSTEMS; PCS; CONTROL; PANEL; ESD & F&G; CONTROL PANEL; 800mm(W)X800mm(D) 1200mm(W)X800mm(D) OPERATION ROOM 25'-0" X 36'-11"; LCP-H-100

PANEL & OPERATION ROOM 25'-0" X 36'-11"

11'-4" X 15'-5" GLASS PARTITION BATTERY ROOM AC / VDC 11'-4" X 4'-7"

PP Mimic F&G MIMIC ESD CONSOLE BUILDING FIRE AND GAS PANEL

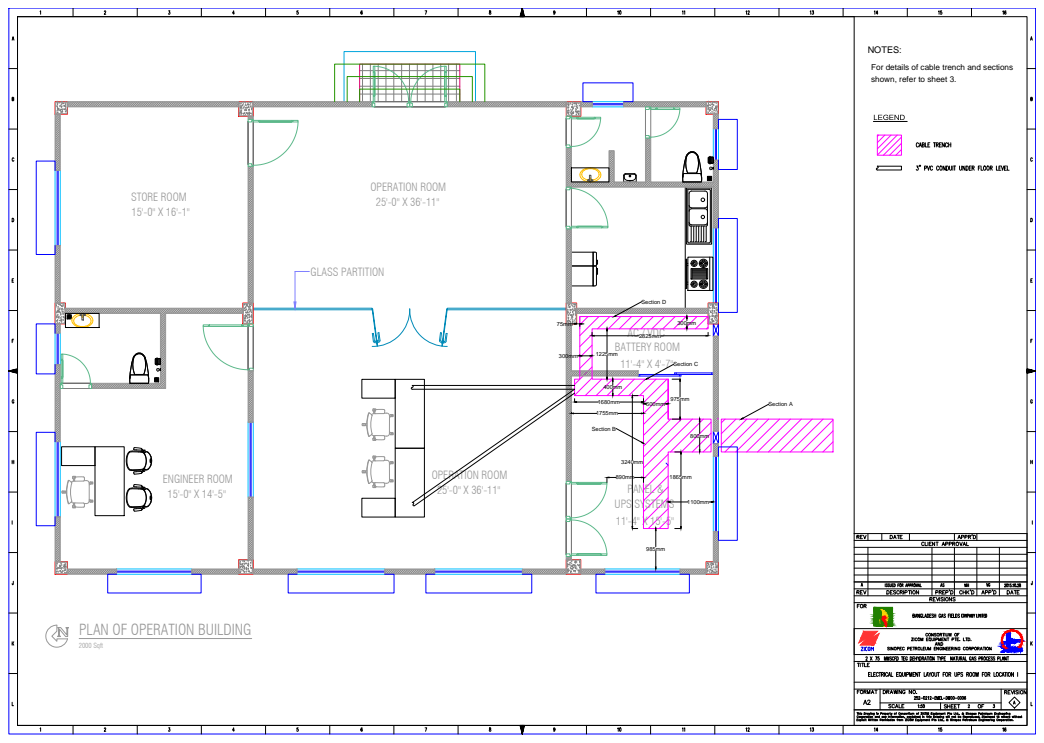
[picture p10: page 2]
11'-4" X 15'-5" UPS SYSTEMS PANEL & PLAN OF OPERATION BUILDING 2000 Sqft; STORE ROOM 15'-0" X 16'-1"; OPERATION ROOM 25'-0" X 36'-11" ENGINEER ROOM 15'-0" X 14'-5"; GLASS PARTITION; BATTERY ROOM AC / VDC 11'-4" X 4'-7" OPERATION ROOM 25'-0" X 36'-11"; Section C Section D; Section A Section B; NOTES: For details of cable trench and sections shown, refer to sheet 3.

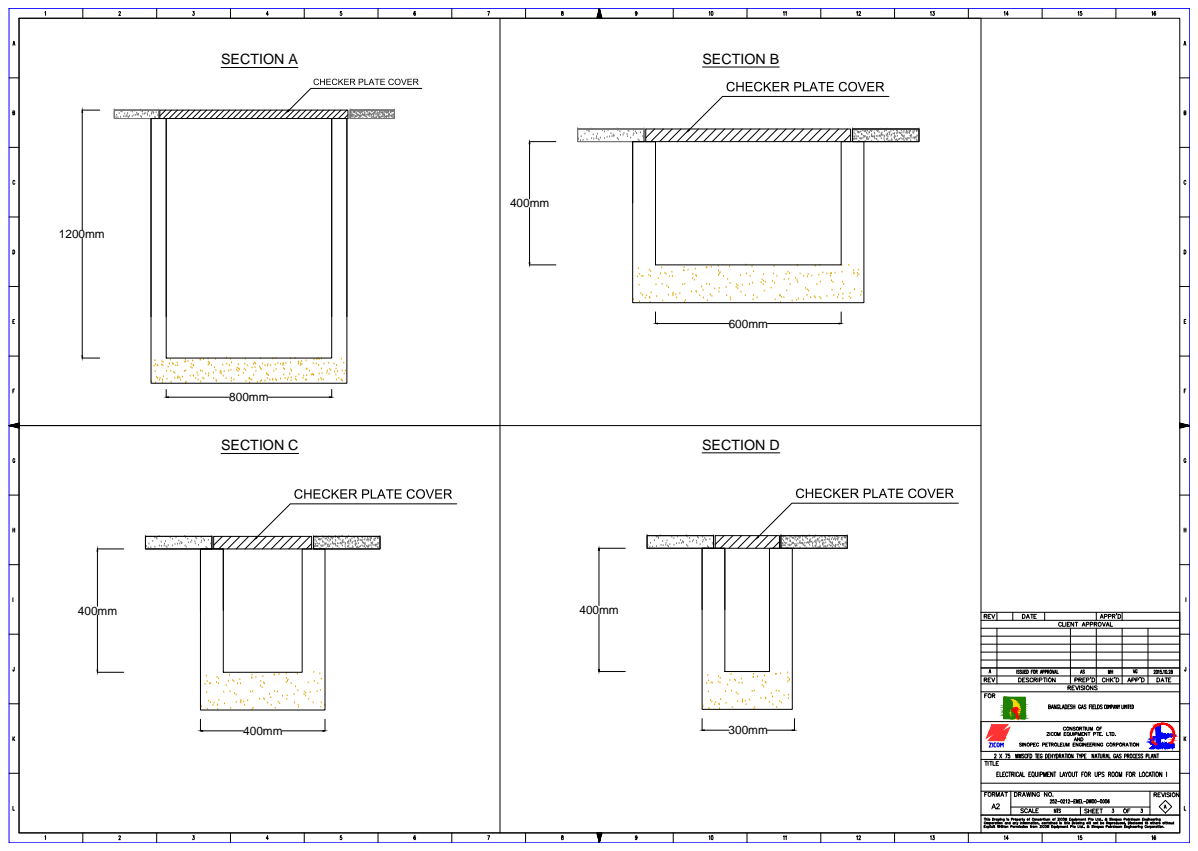
[picture p11: page 3]
SECTION A; SECTION B SECTION C; SECTION D ¹²⁰⁰mm
