skdzicombd/P_252_Documentation/Location J/Electrical Equipment Layout for Generator Room/252-0312-EMEL-DW00-0005_RevA - Electrical Equipment Layout for Generator Room for Location J.pdf

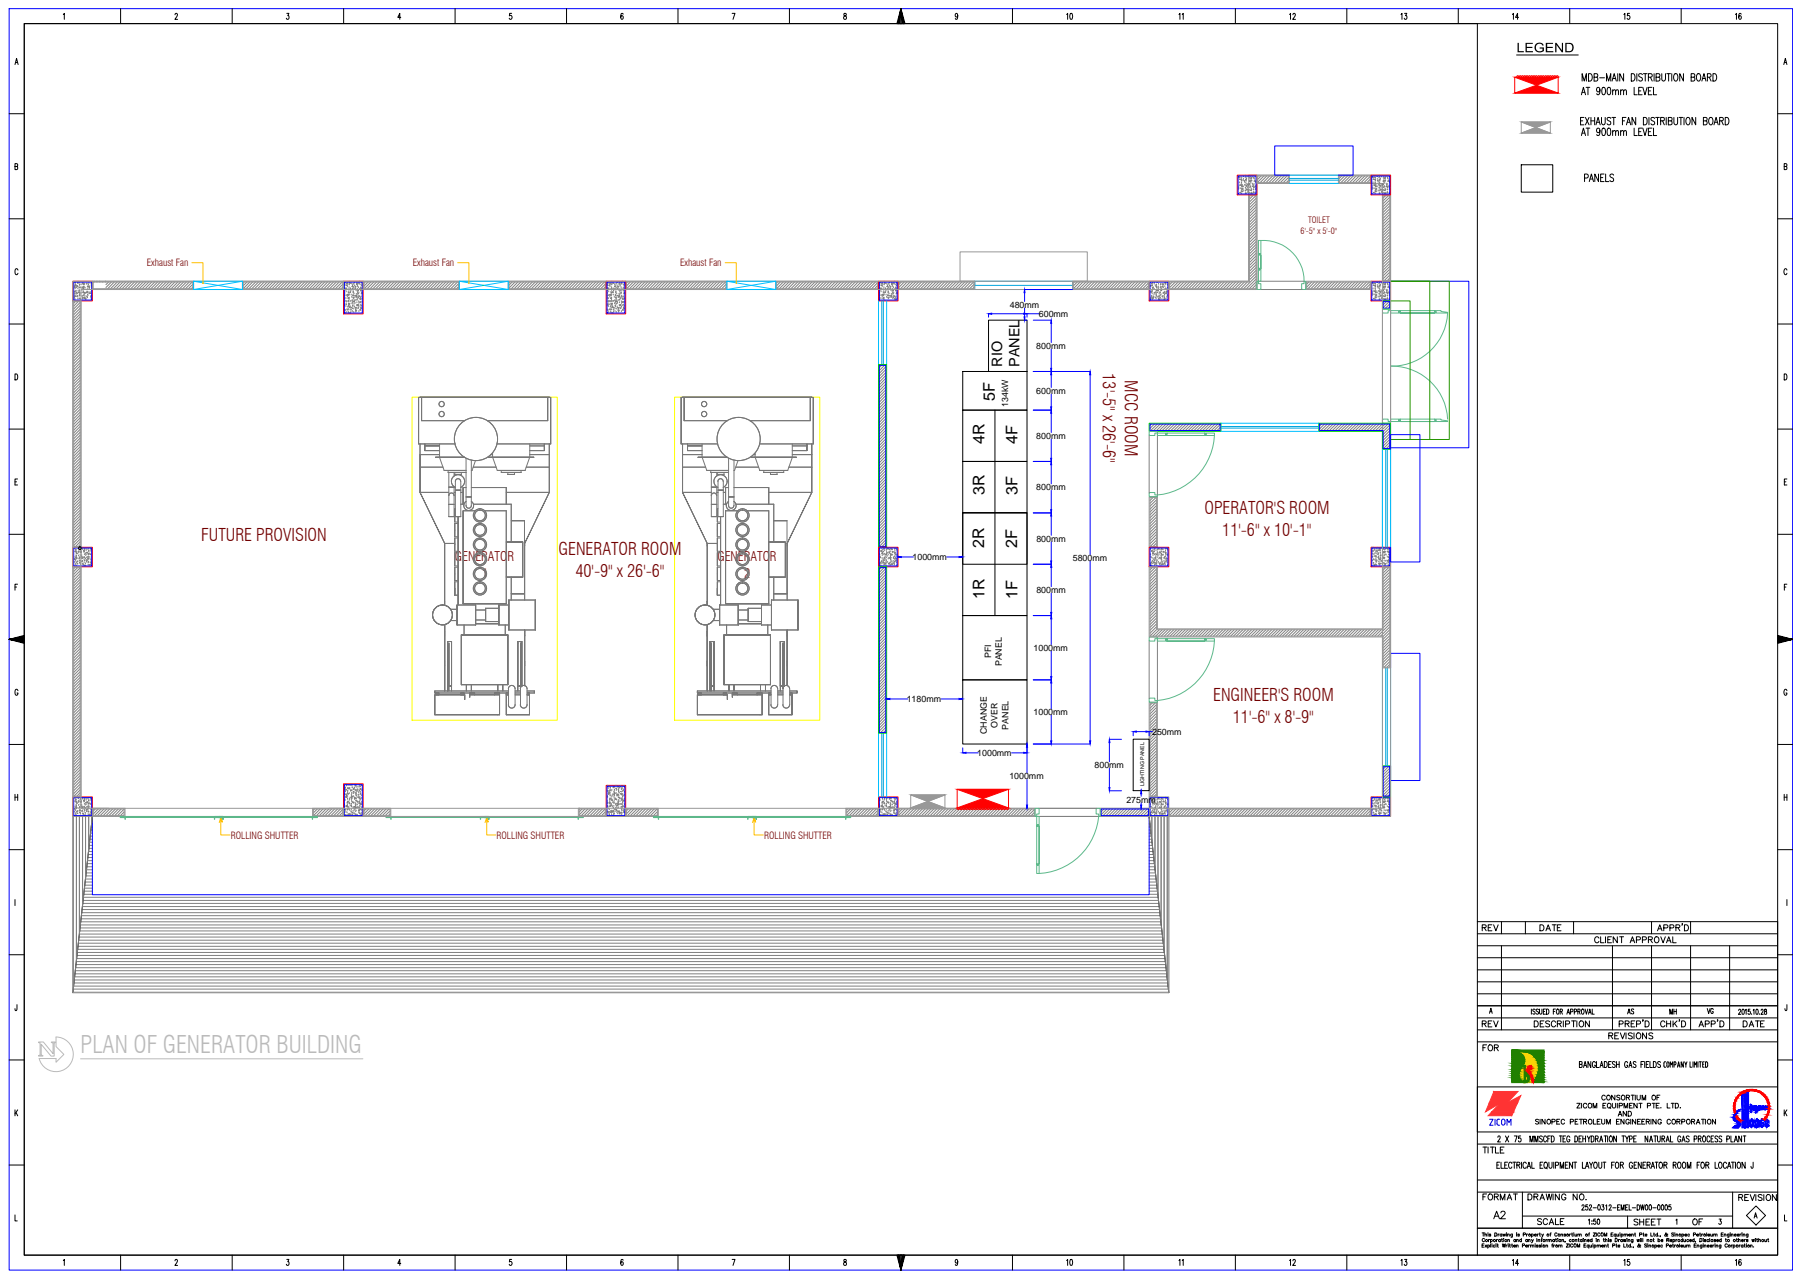
[picture p12: page 1]
MCC ROOM; LIGHTING PANEL; 1R 2R 3R 4R CHANGE; OVER; PANEL; PFI; PANEL 5800mm 600mm 800mm 800mm 800mm 800mm 1000mm 1000mm 1180mm 1000mm 800mm 250mm 1000mm 275mm; RIO; PANEL 480mm600mm 800mm 1000mm

13'-5" x 26'-6" FUTURE PROVISION GENERATOR 1 GENERATOR 2 ROLLING SHUTTERGENERATOR ROOM 40'-9" x 26'-6" Exhaust Fan Exhaust Fan Exhaust Fan OPERATOR'S ROOM 11'-6" x 10'-1" ENGINEER'S ROOM 11'-6" x 8'-9"TOILET 6'-5" x 5'-0" ROLLING SHUTTER ROLLING SHUTTER PLAN OF GENERATOR BUILDING

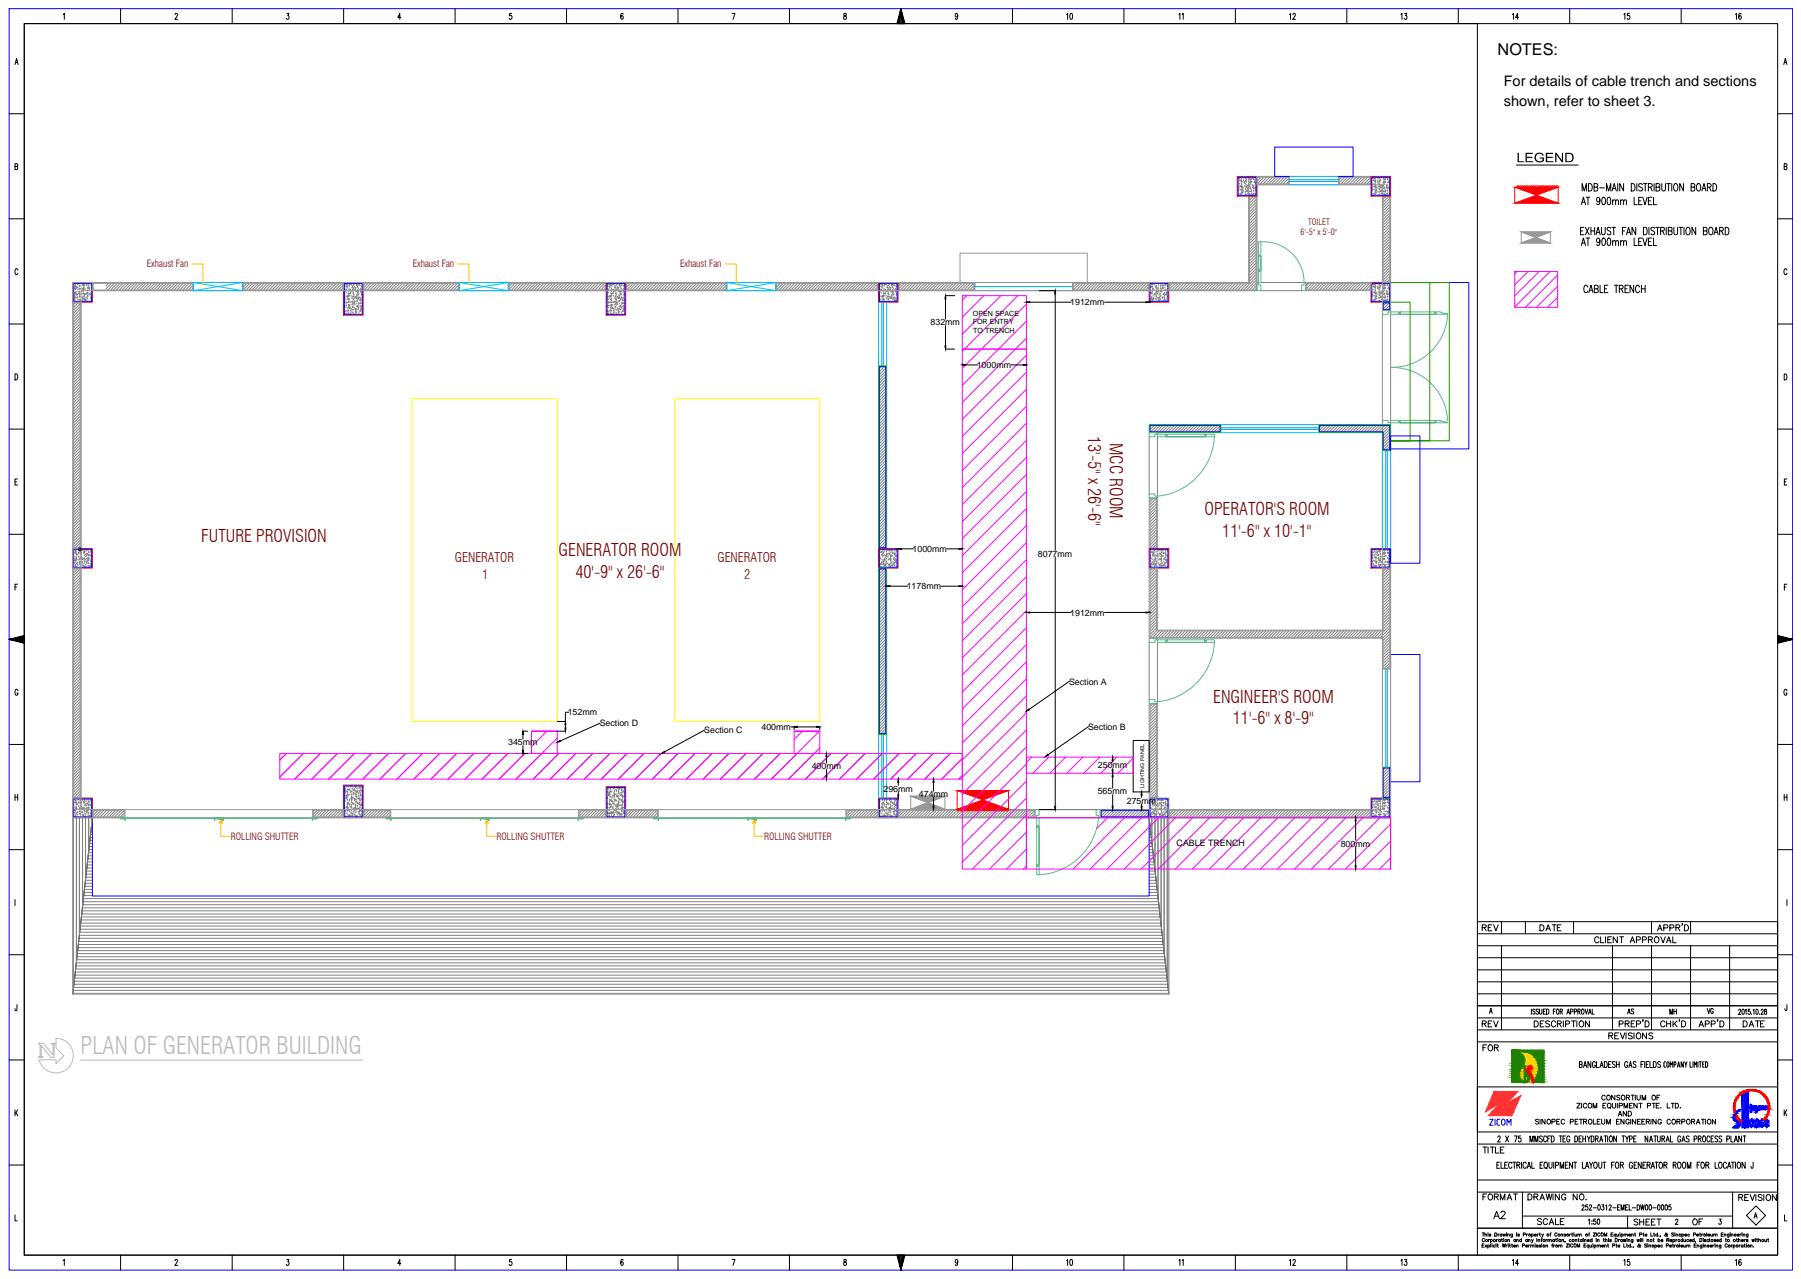
[picture p13: page 2]
MCC ROOM

LIGHTING PANEL NOTES: For details of cable trench and sections shown, refer to sheet 3.

13'-5" x 26'-6" FUTURE PROVISION GENERATOR 1 GENERATOR 2 ROLLING SHUTTERGENERATOR ROOM 40'-9" x 26'-6" Exhaust Fan Exhaust Fan Exhaust Fan OPERATOR'S ROOM 11'-6" x 10'-1" ENGINEER'S ROOM 11'-6" x 8'-9"TOILET 6'-5" x 5'-0" ROLLING SHUTTER ROLLING SHUTTER PLAN OF GENERATOR BUILDING CABLE TRENCH OPEN SPACE FOR ENTRY TO TRENCH 1912mm 1000mm 832mm 8077mm 1000mm 1178mm 1912mm 296mm 474mm 400mm 400mm 152mm 250mm 800mm Section A Section C Section D Section B 345mm 565mm275mm

SECTION A | SECTION B SECTION C | SECTION D ¹⁰⁰⁰mm | 1000mm | 300mm | 250mm 1000mm | 400mm | 345mm | 450mm 550mm 1000mm | 400mm

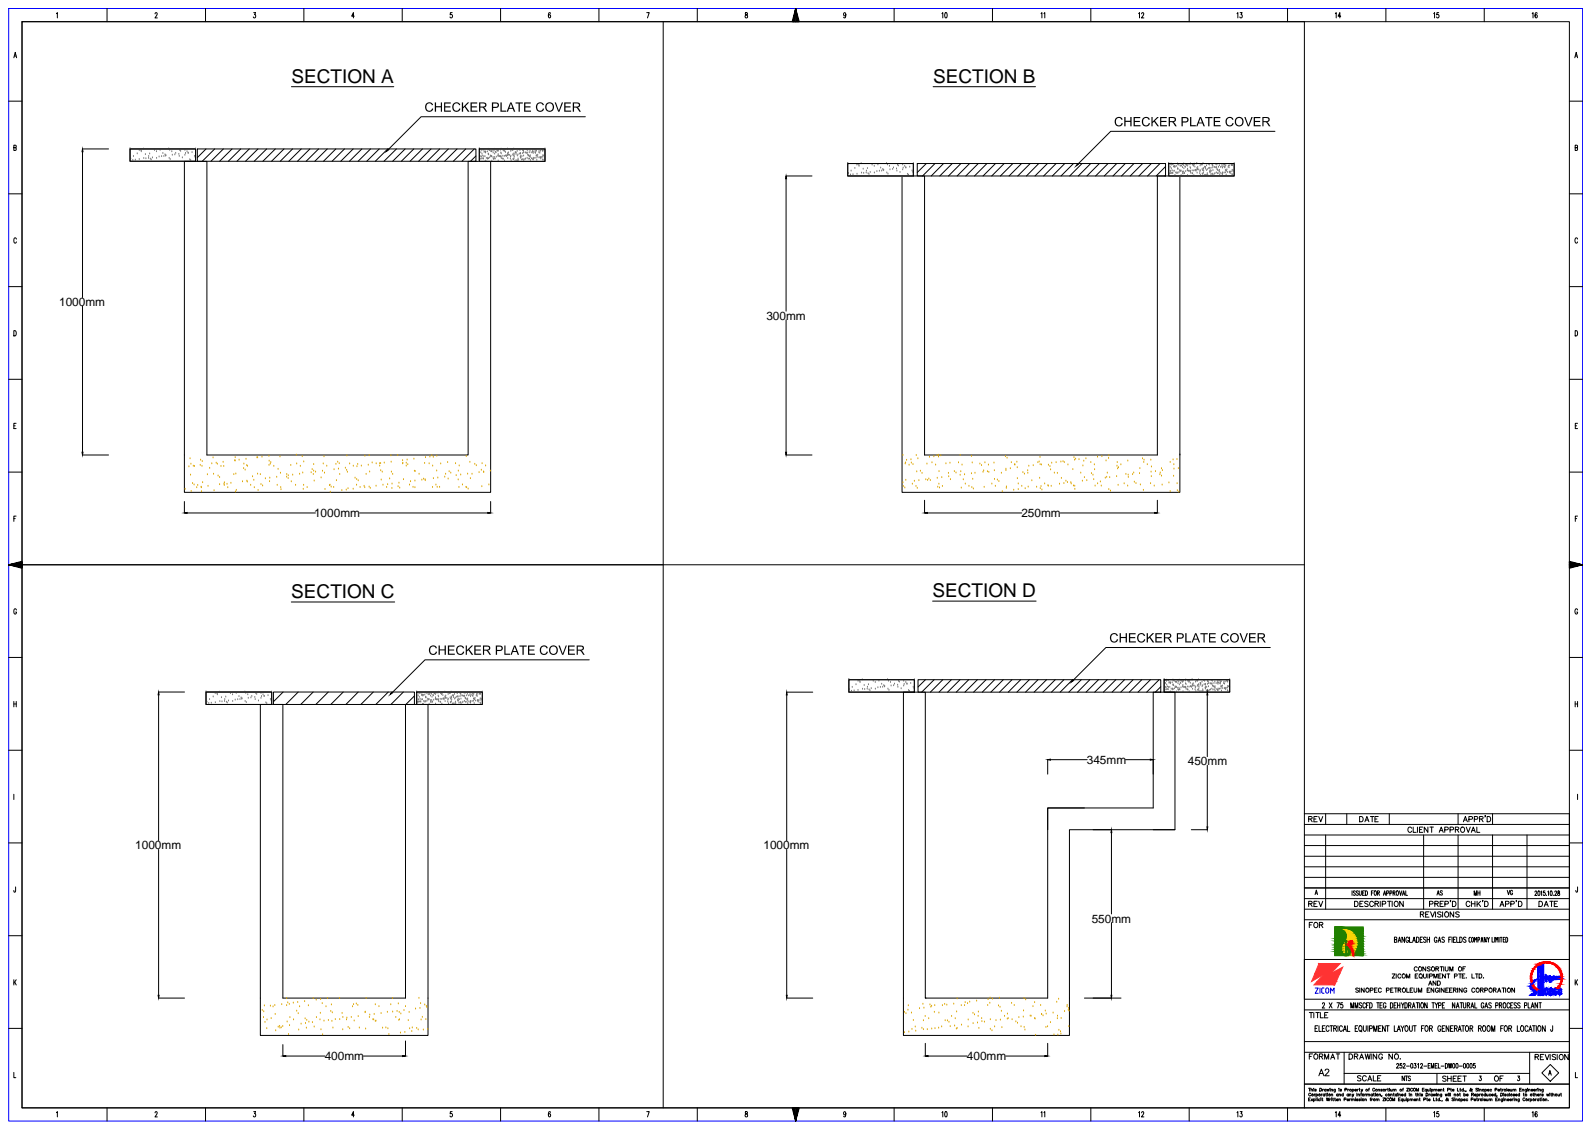
[picture p14: page 3]
