skdzicombd/P_252_Documentation/Location I/P-252 Drawings Binder Location I.pdf

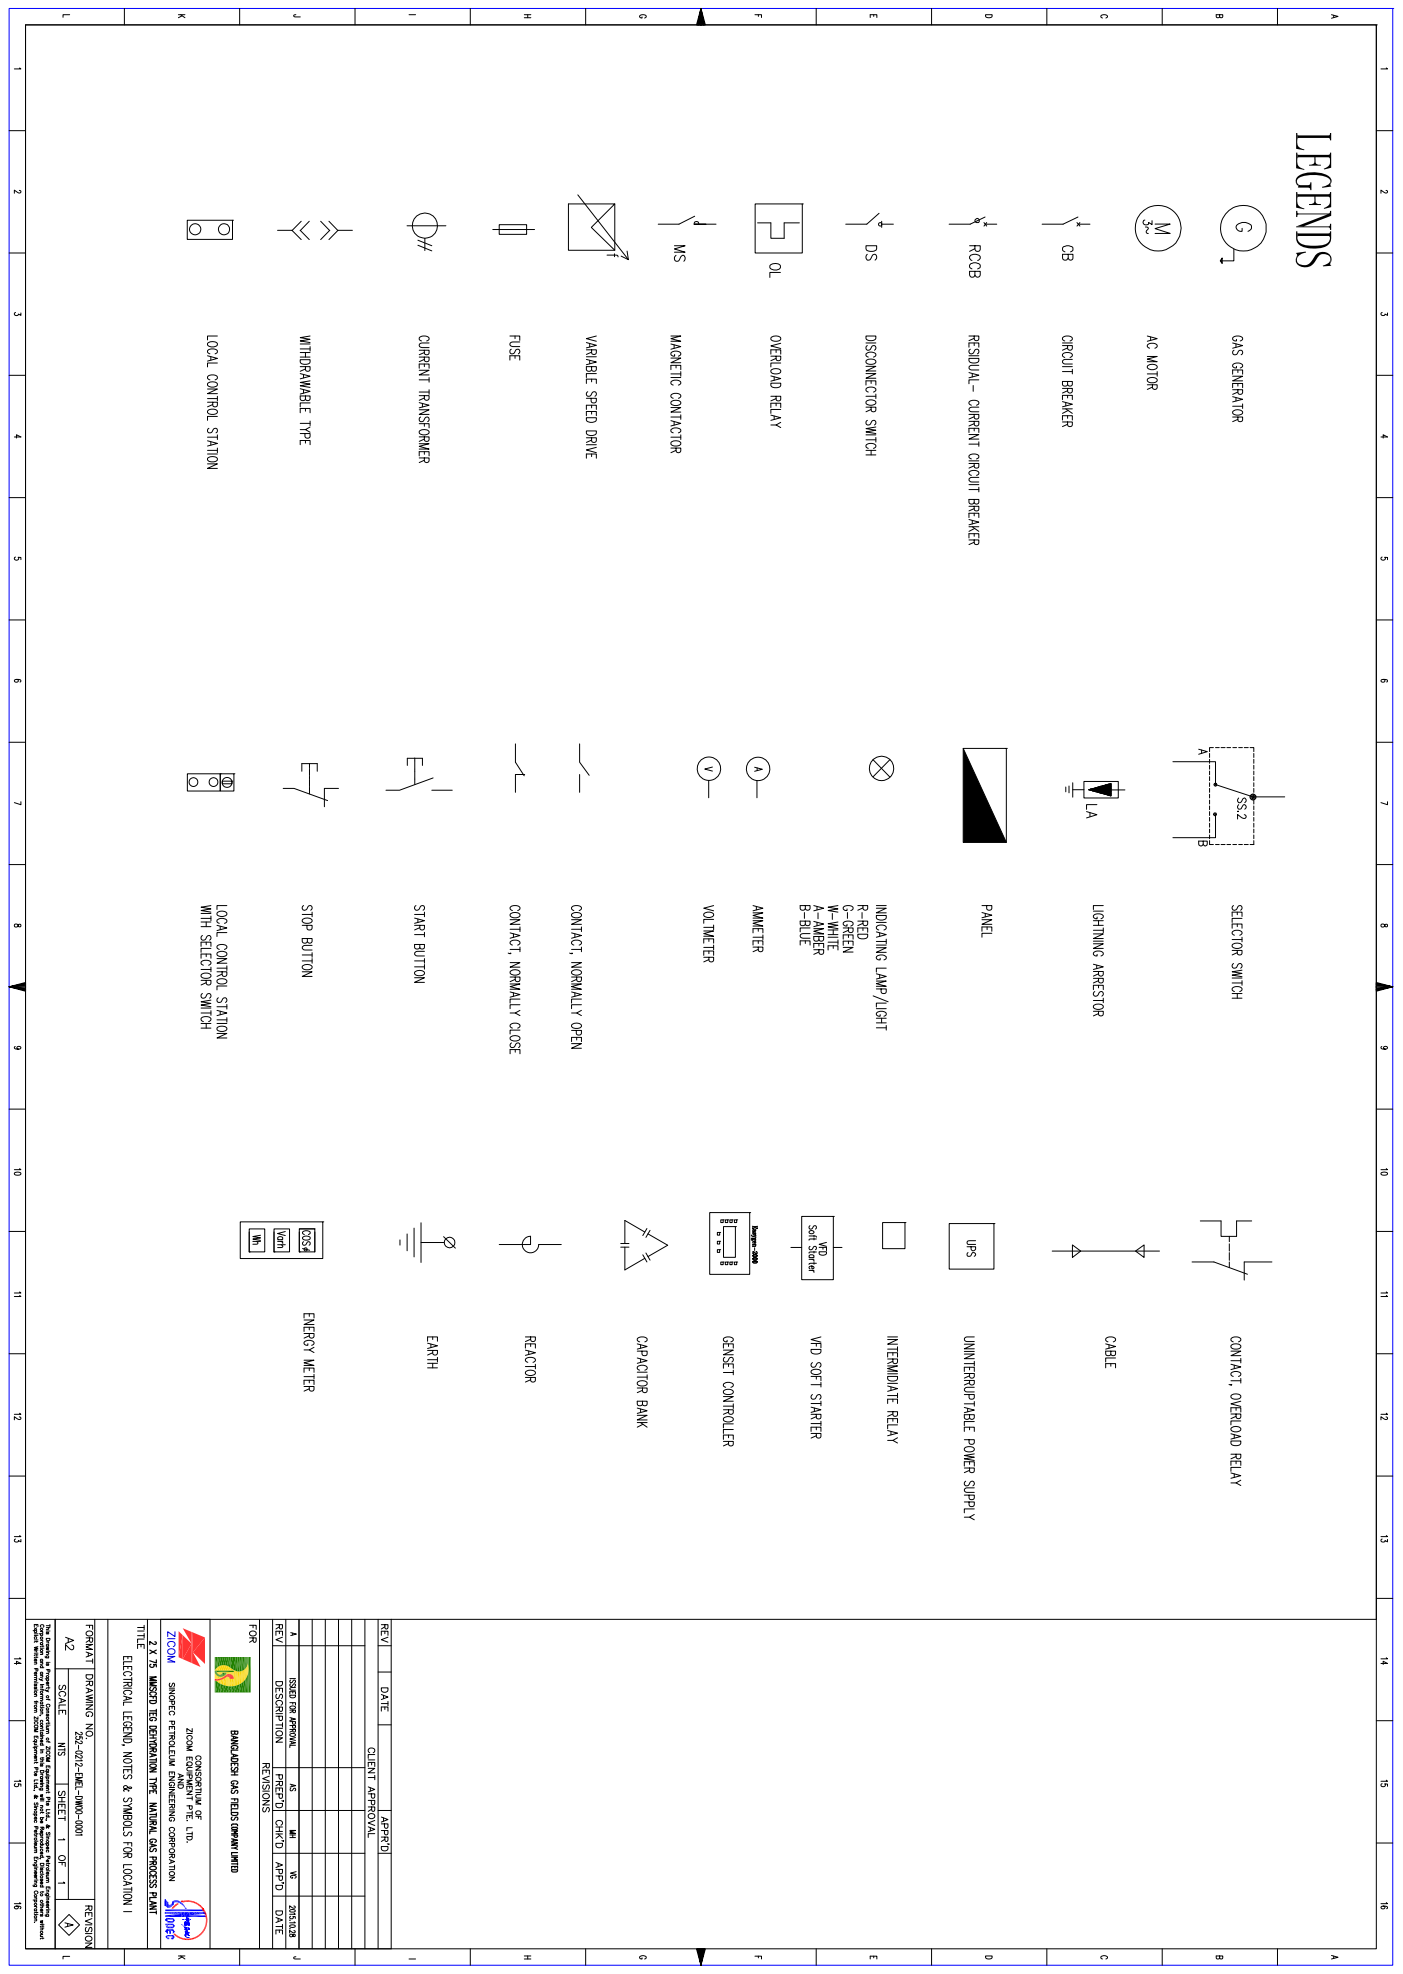
[picture p18: page 1]

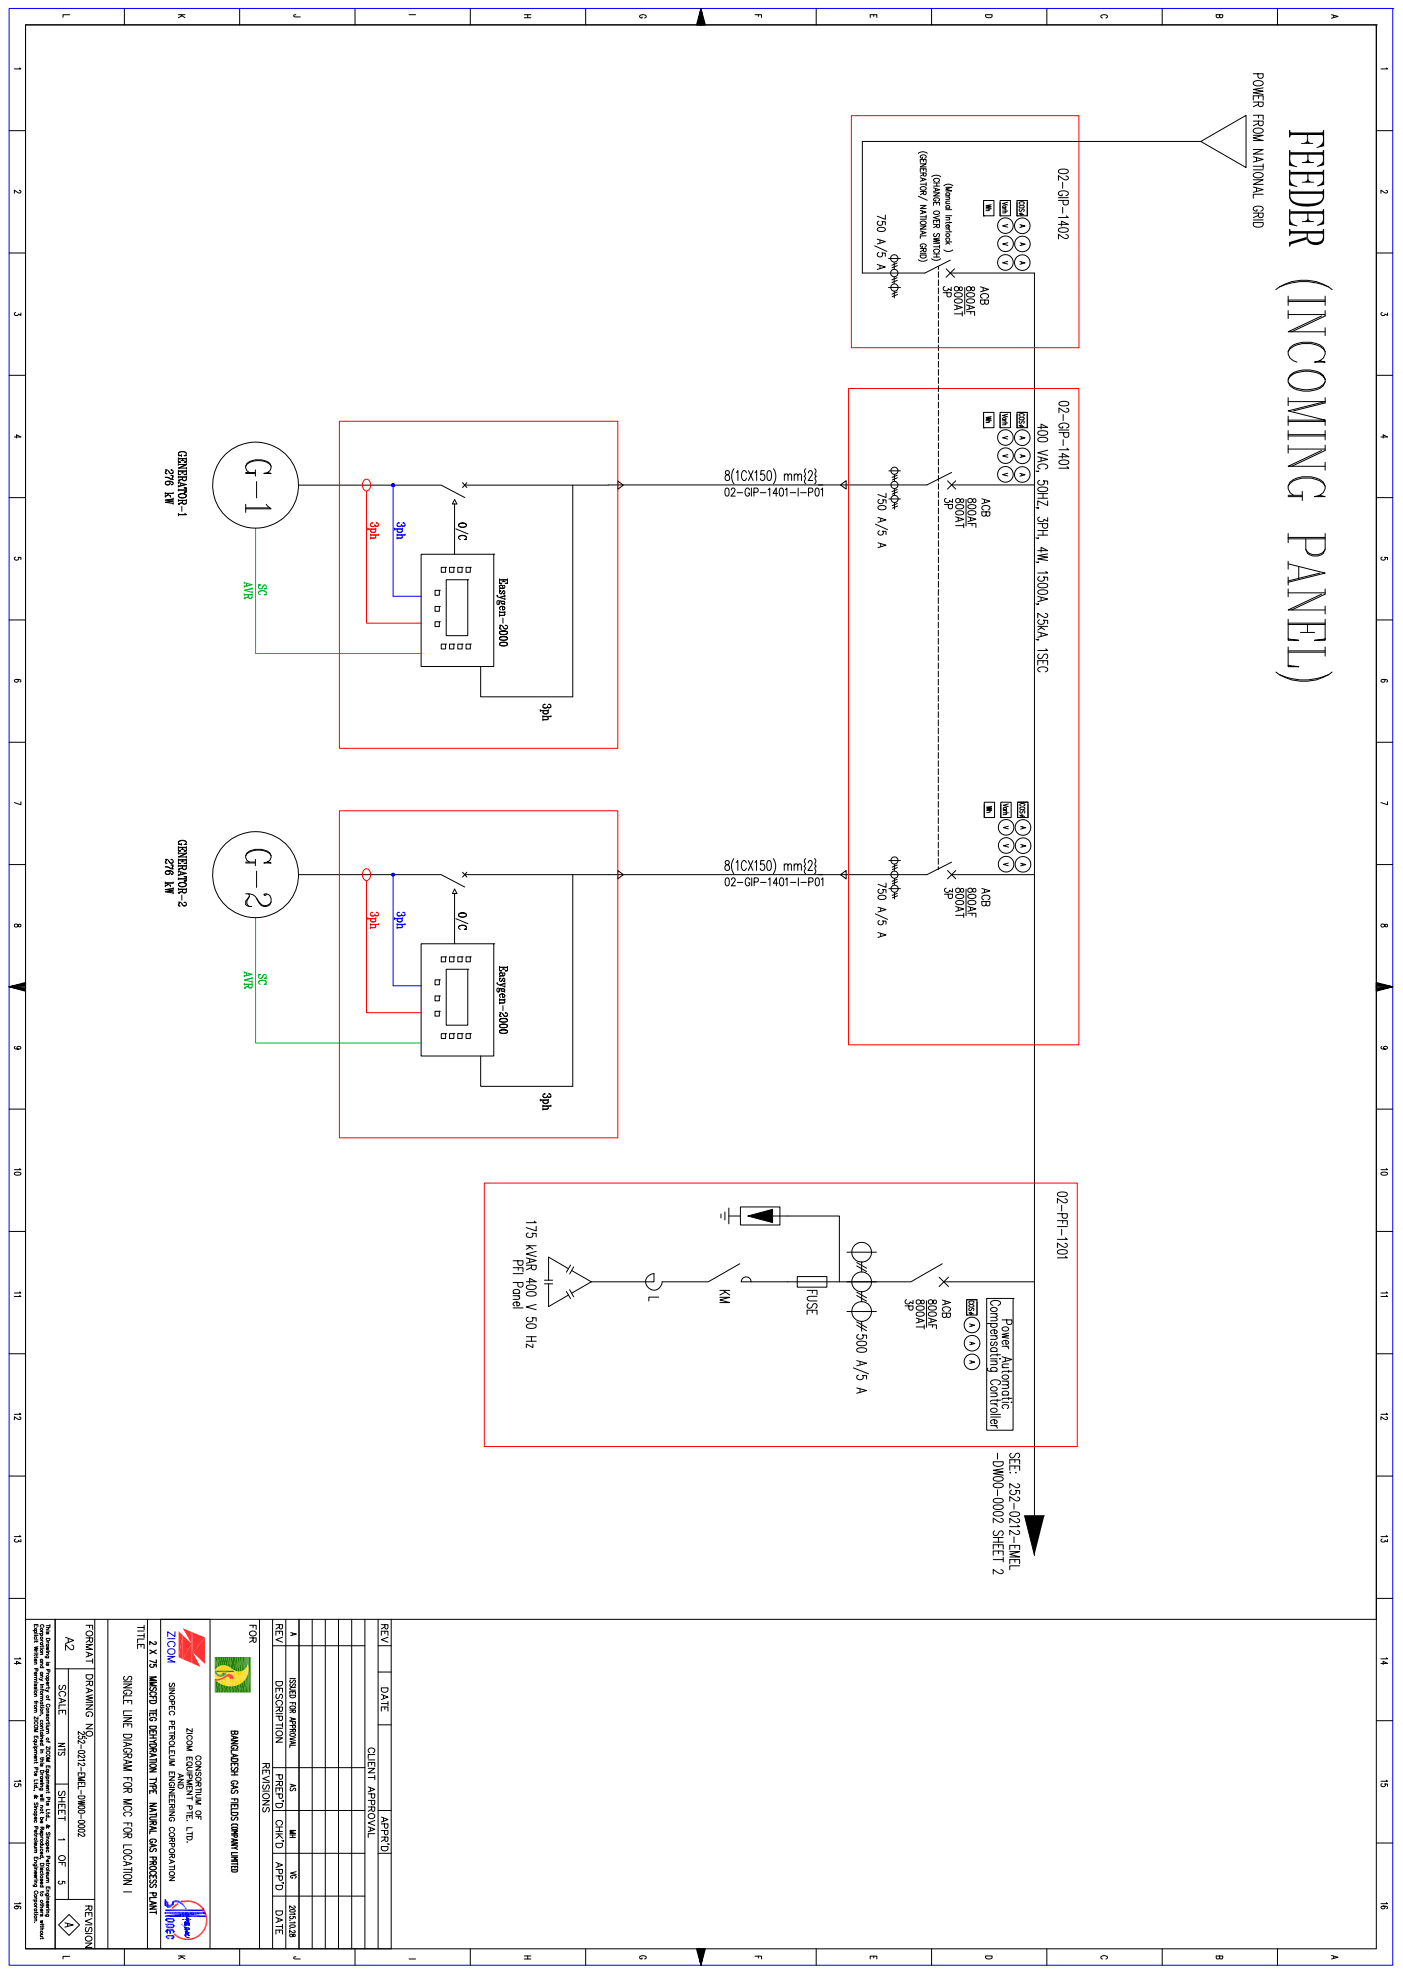
[picture p19: page 2]

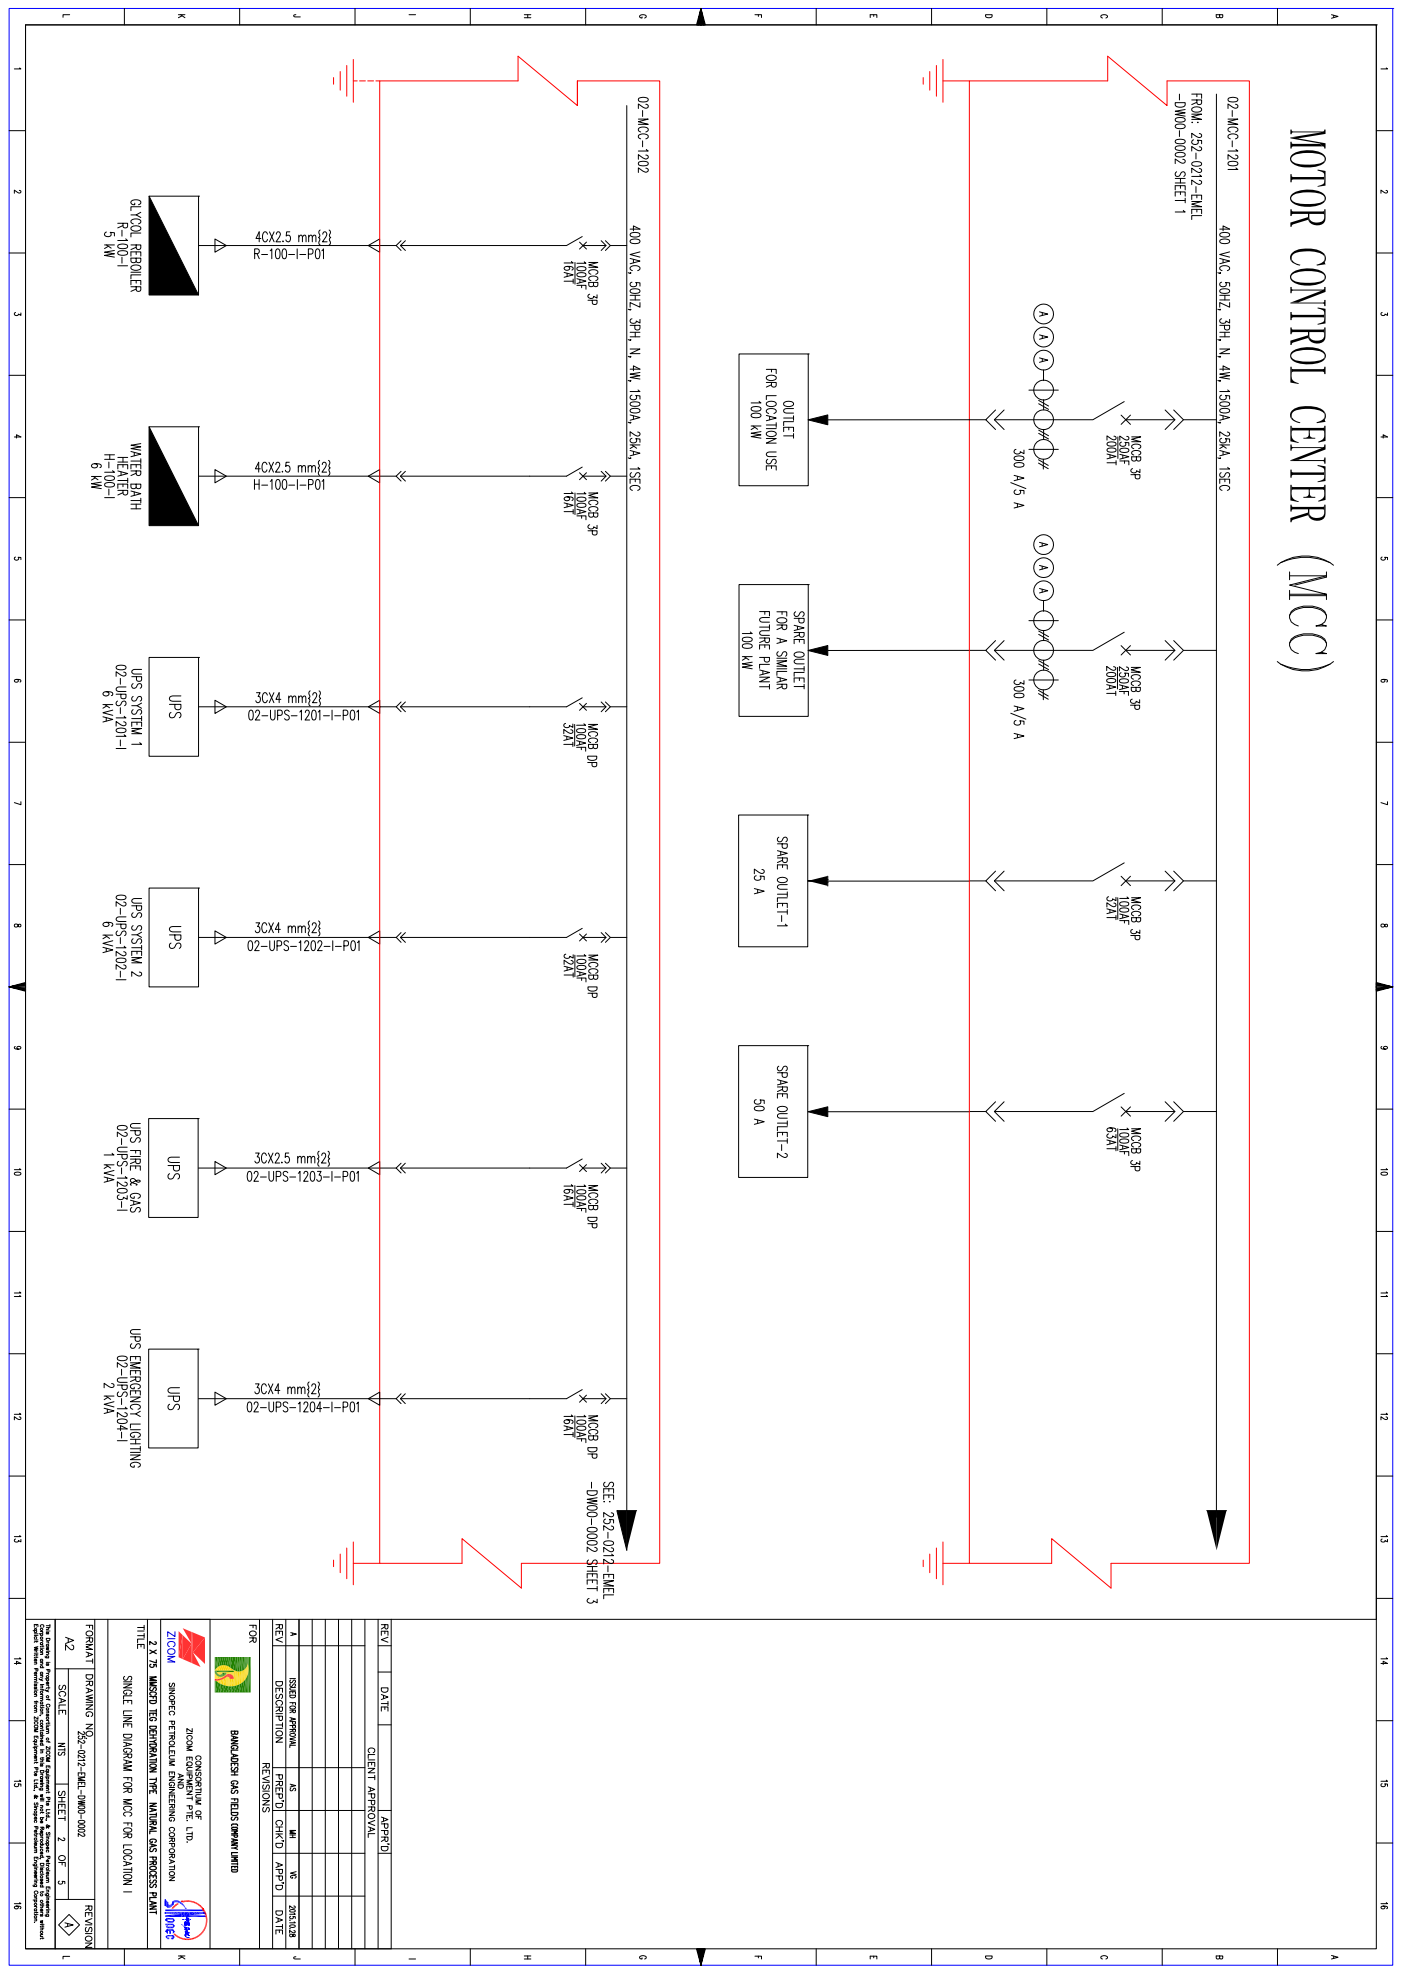
[picture p20: page 3]

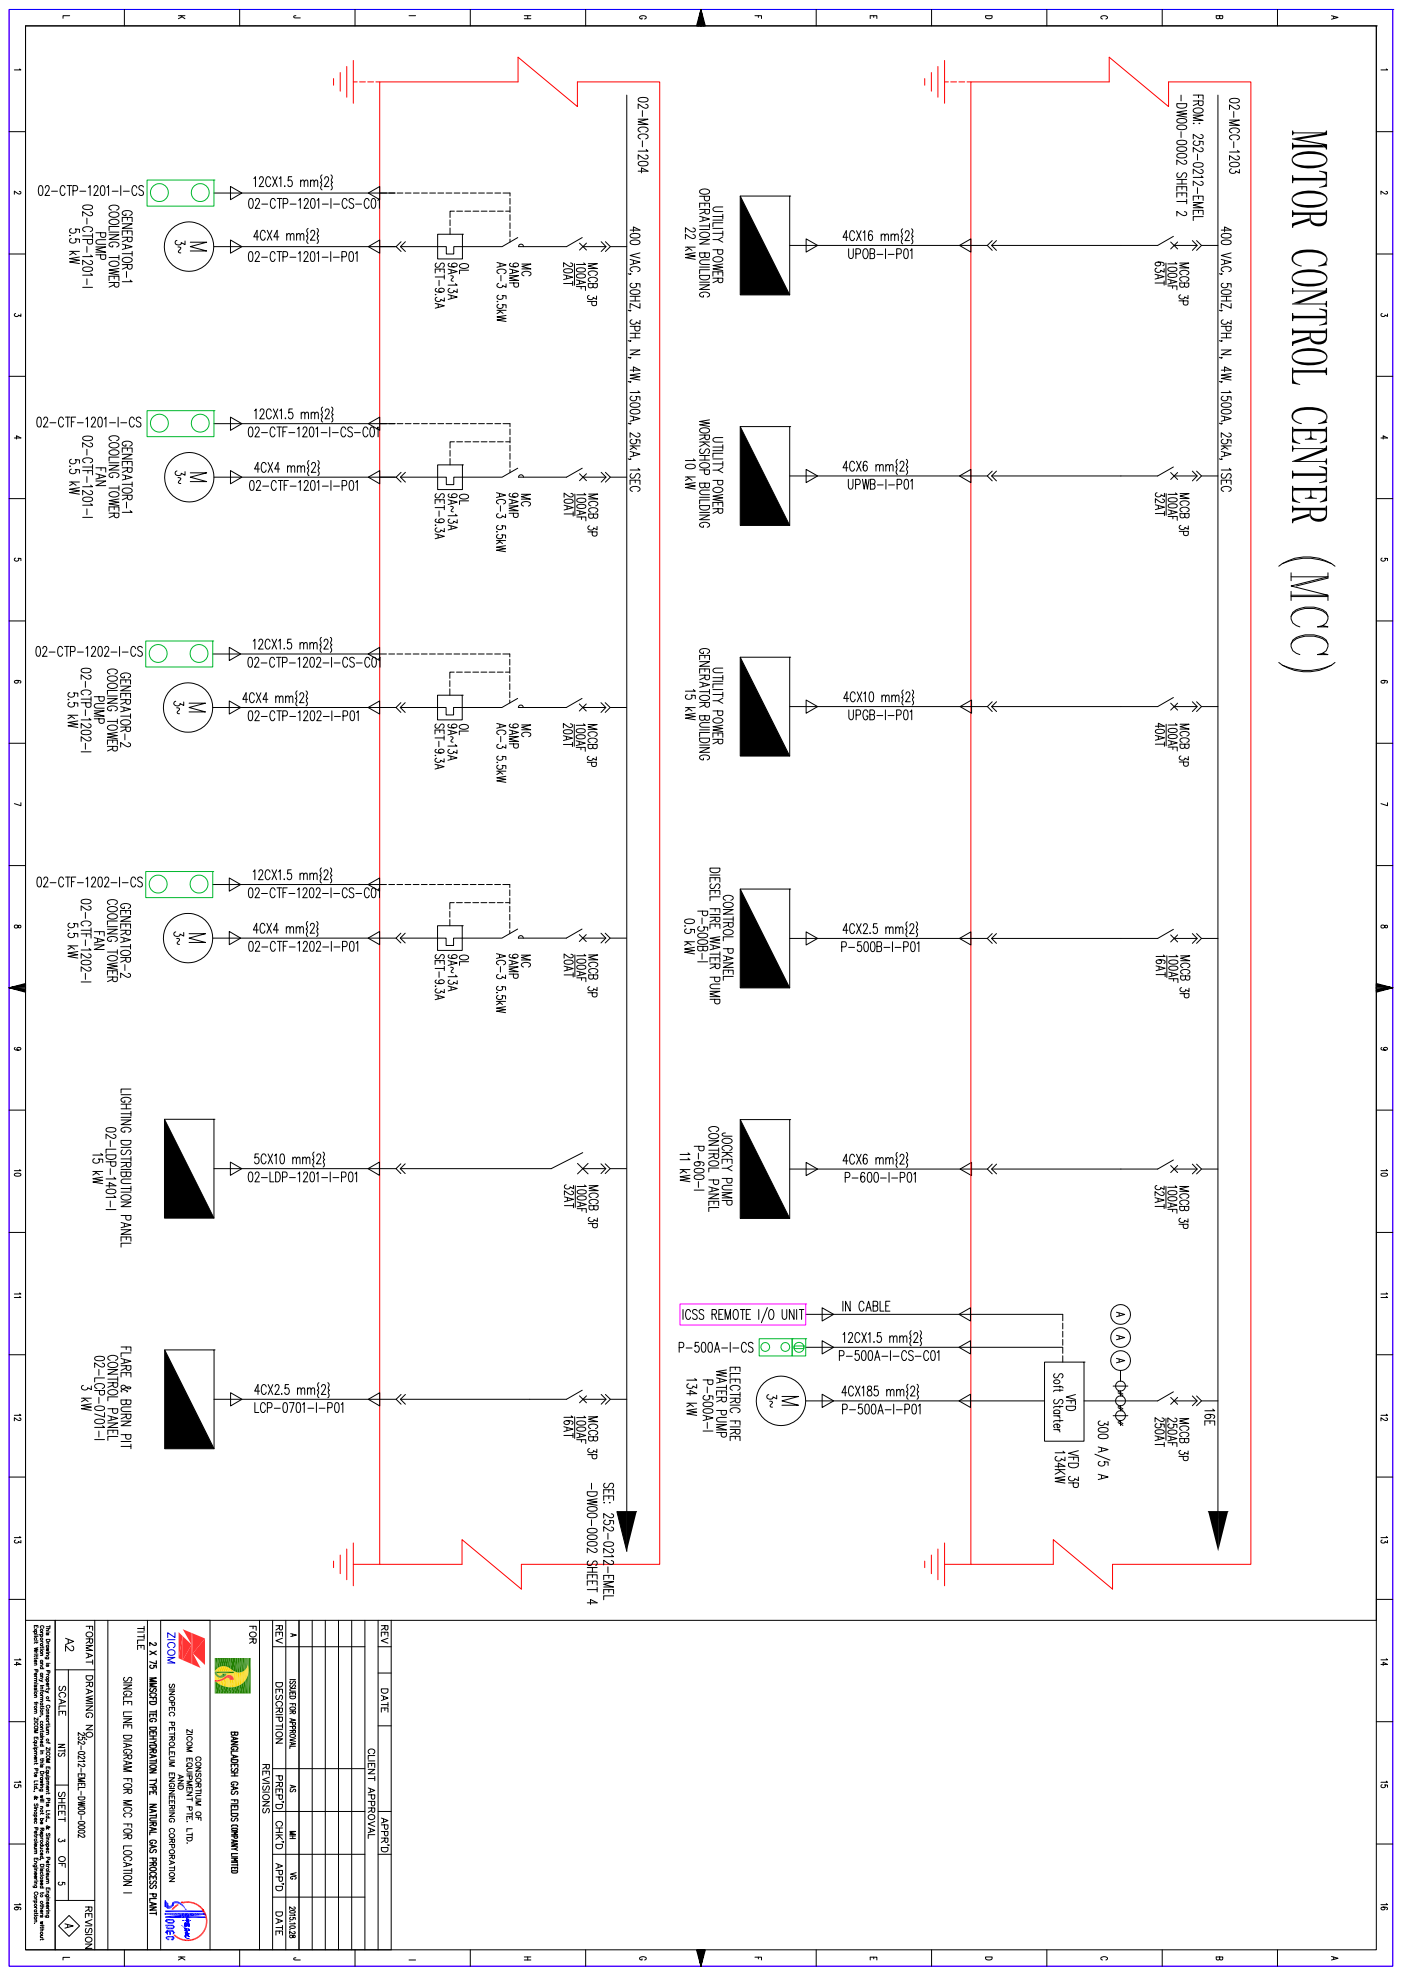
[picture p21: page 4]

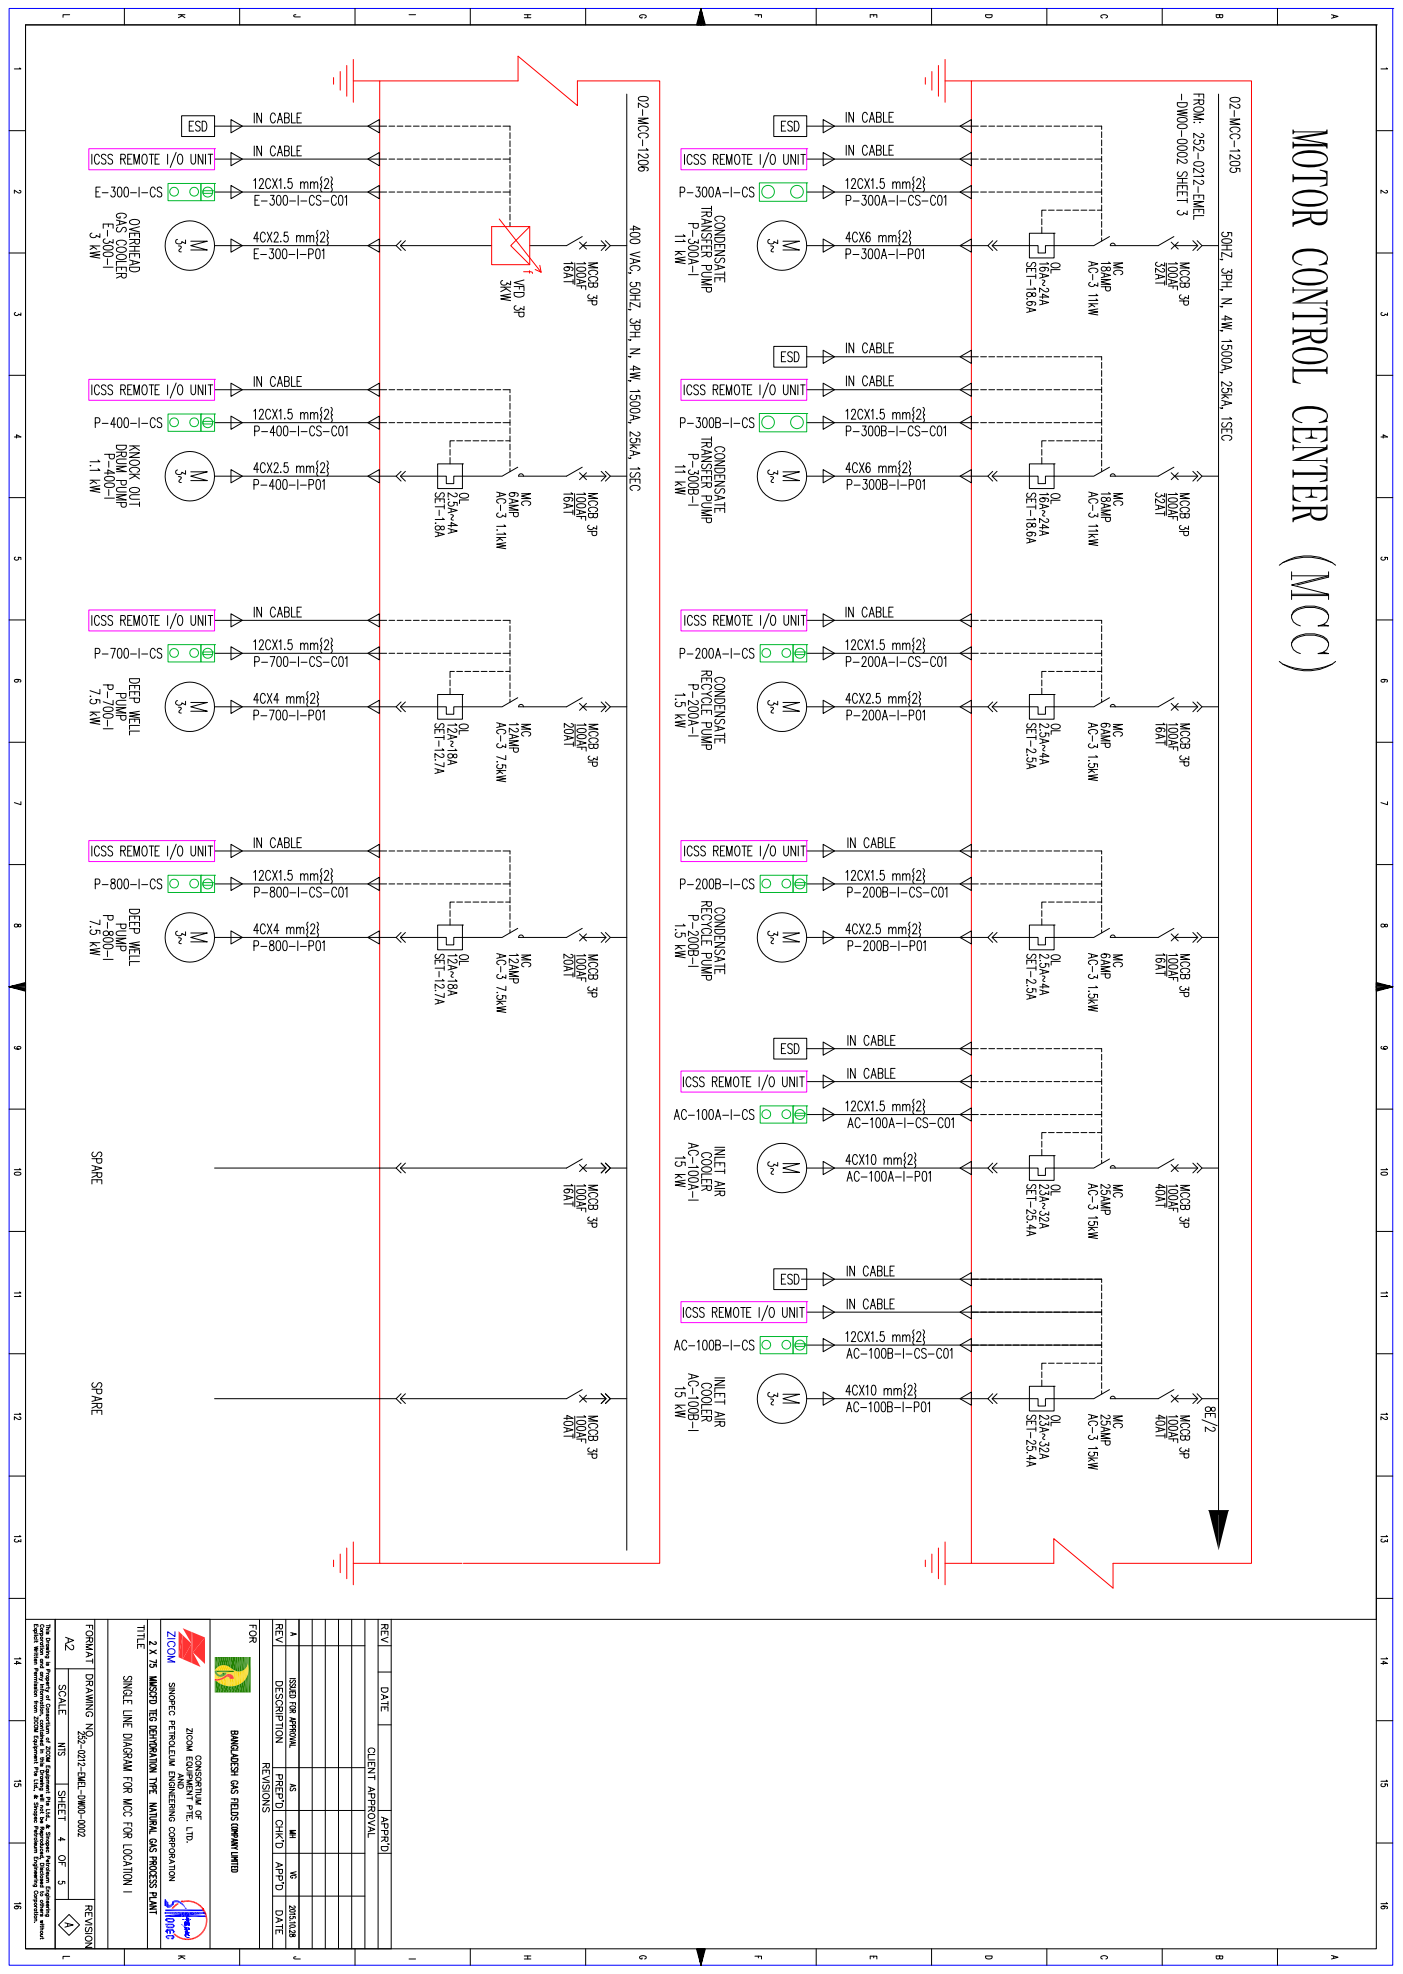
[picture p22: page 5]

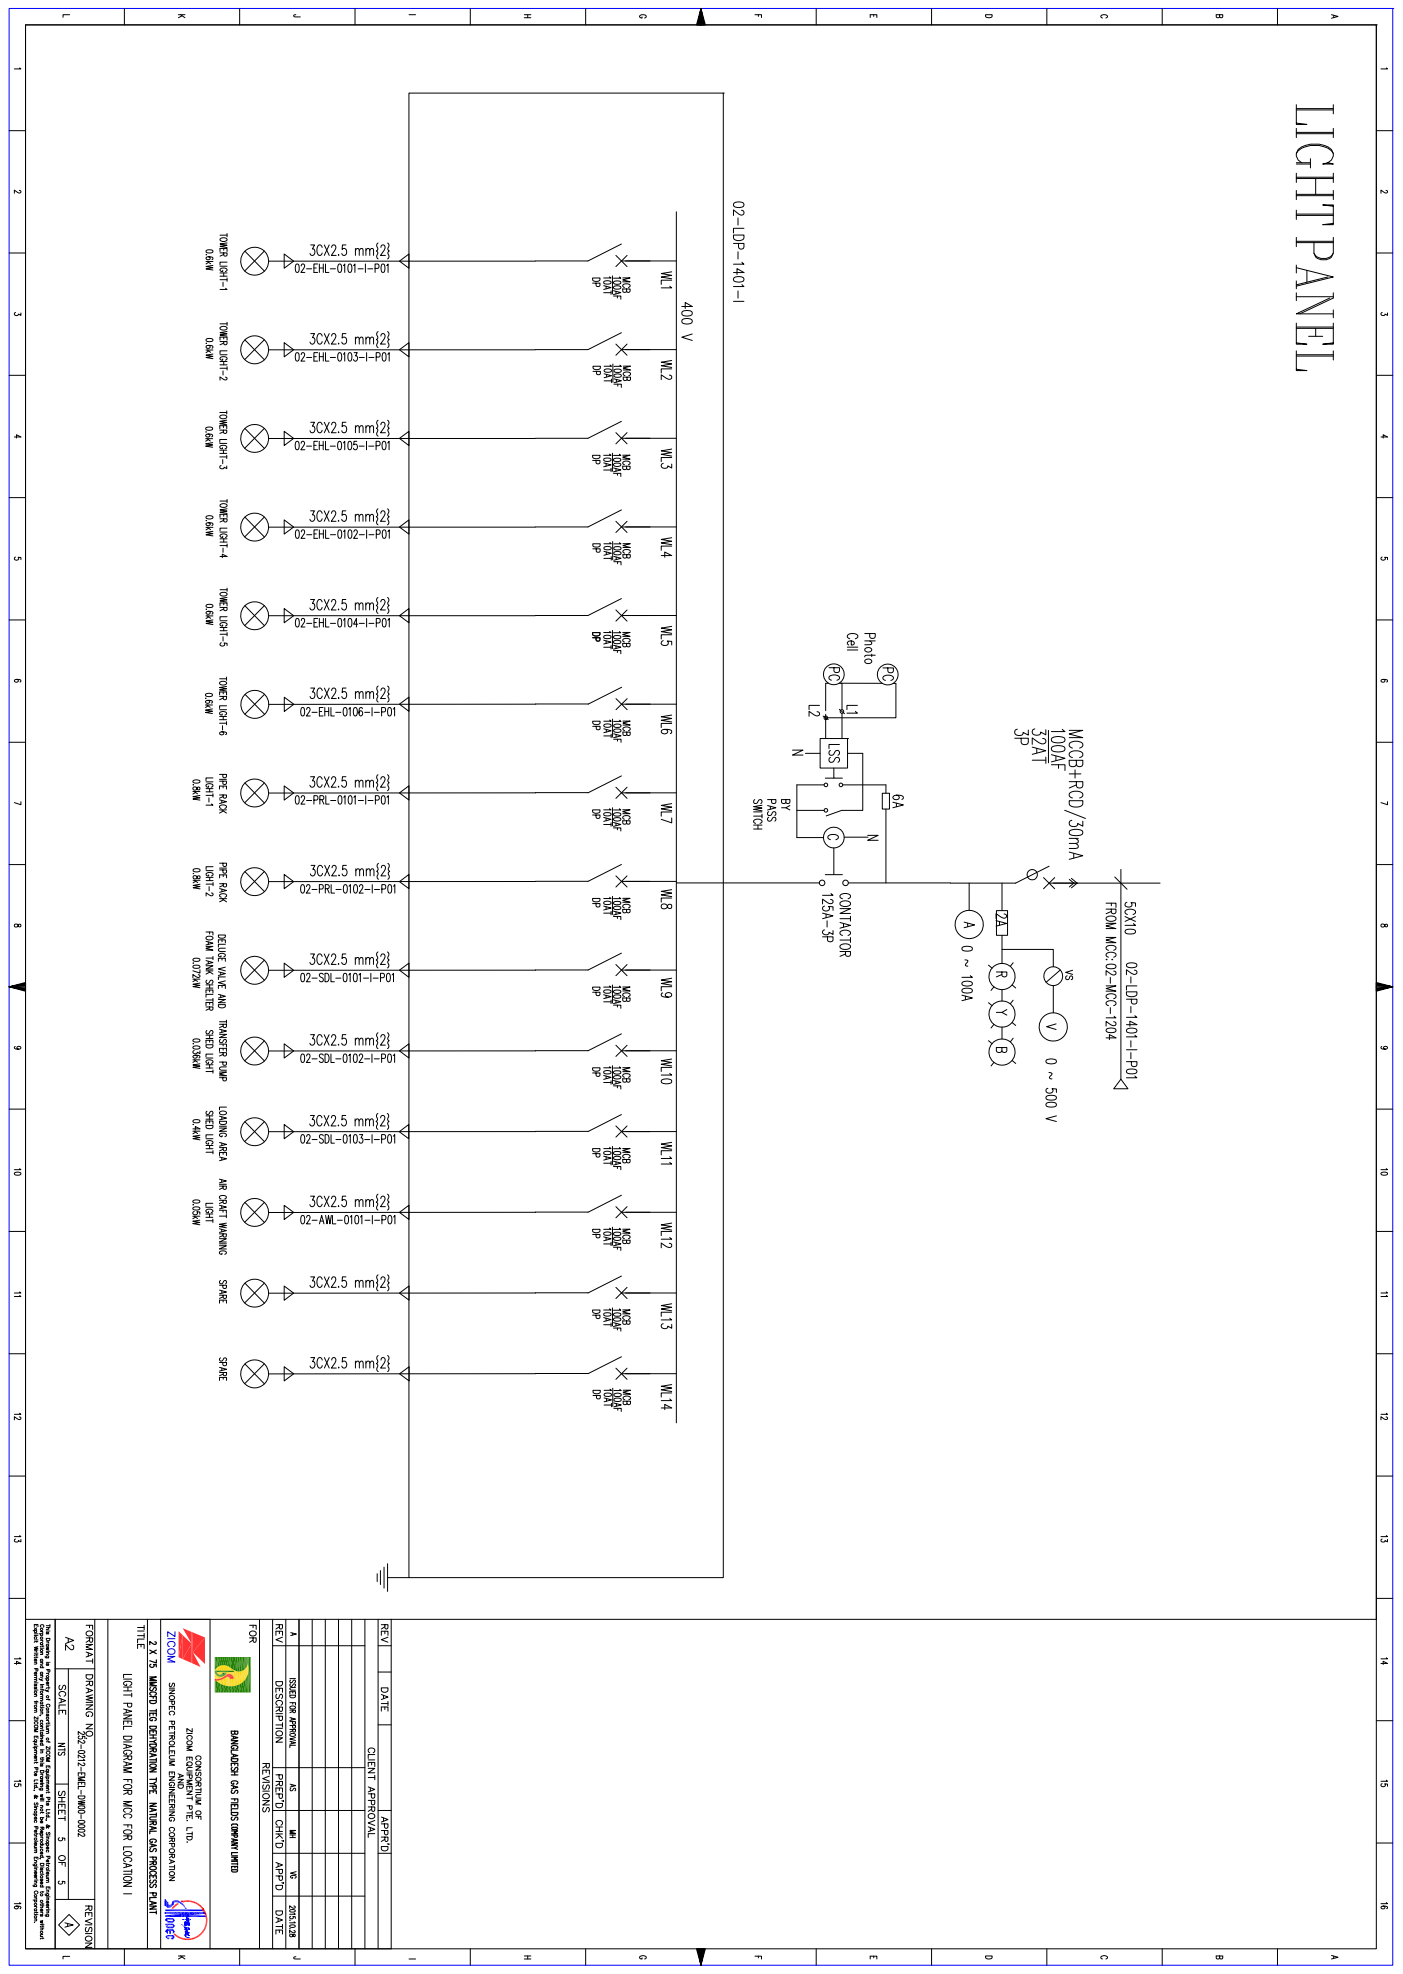
[picture p23: page 6]

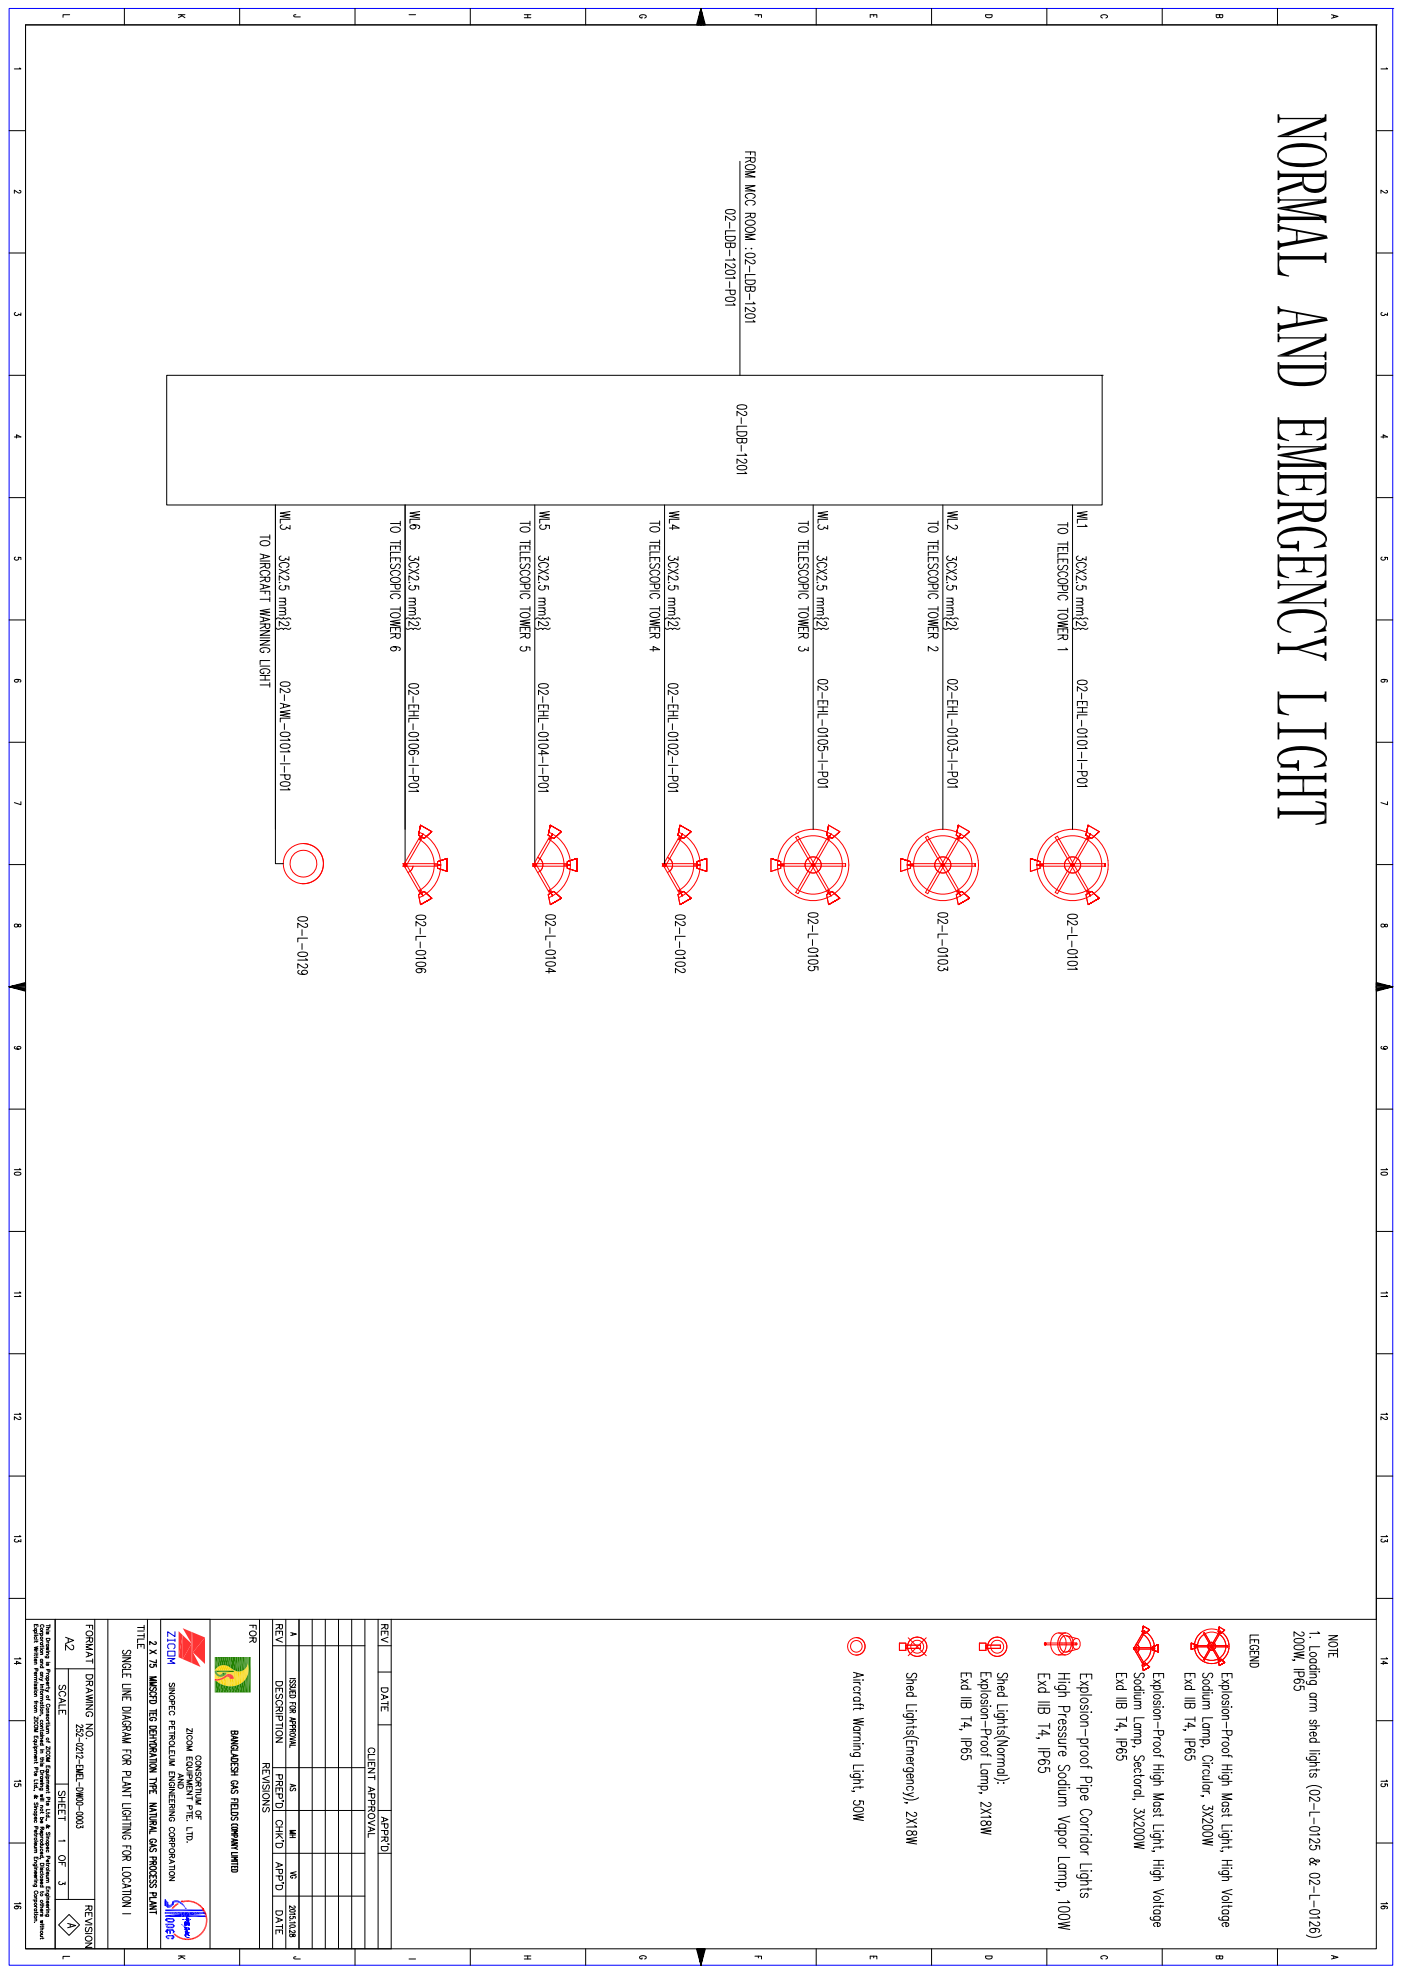
[picture p24: page 7]

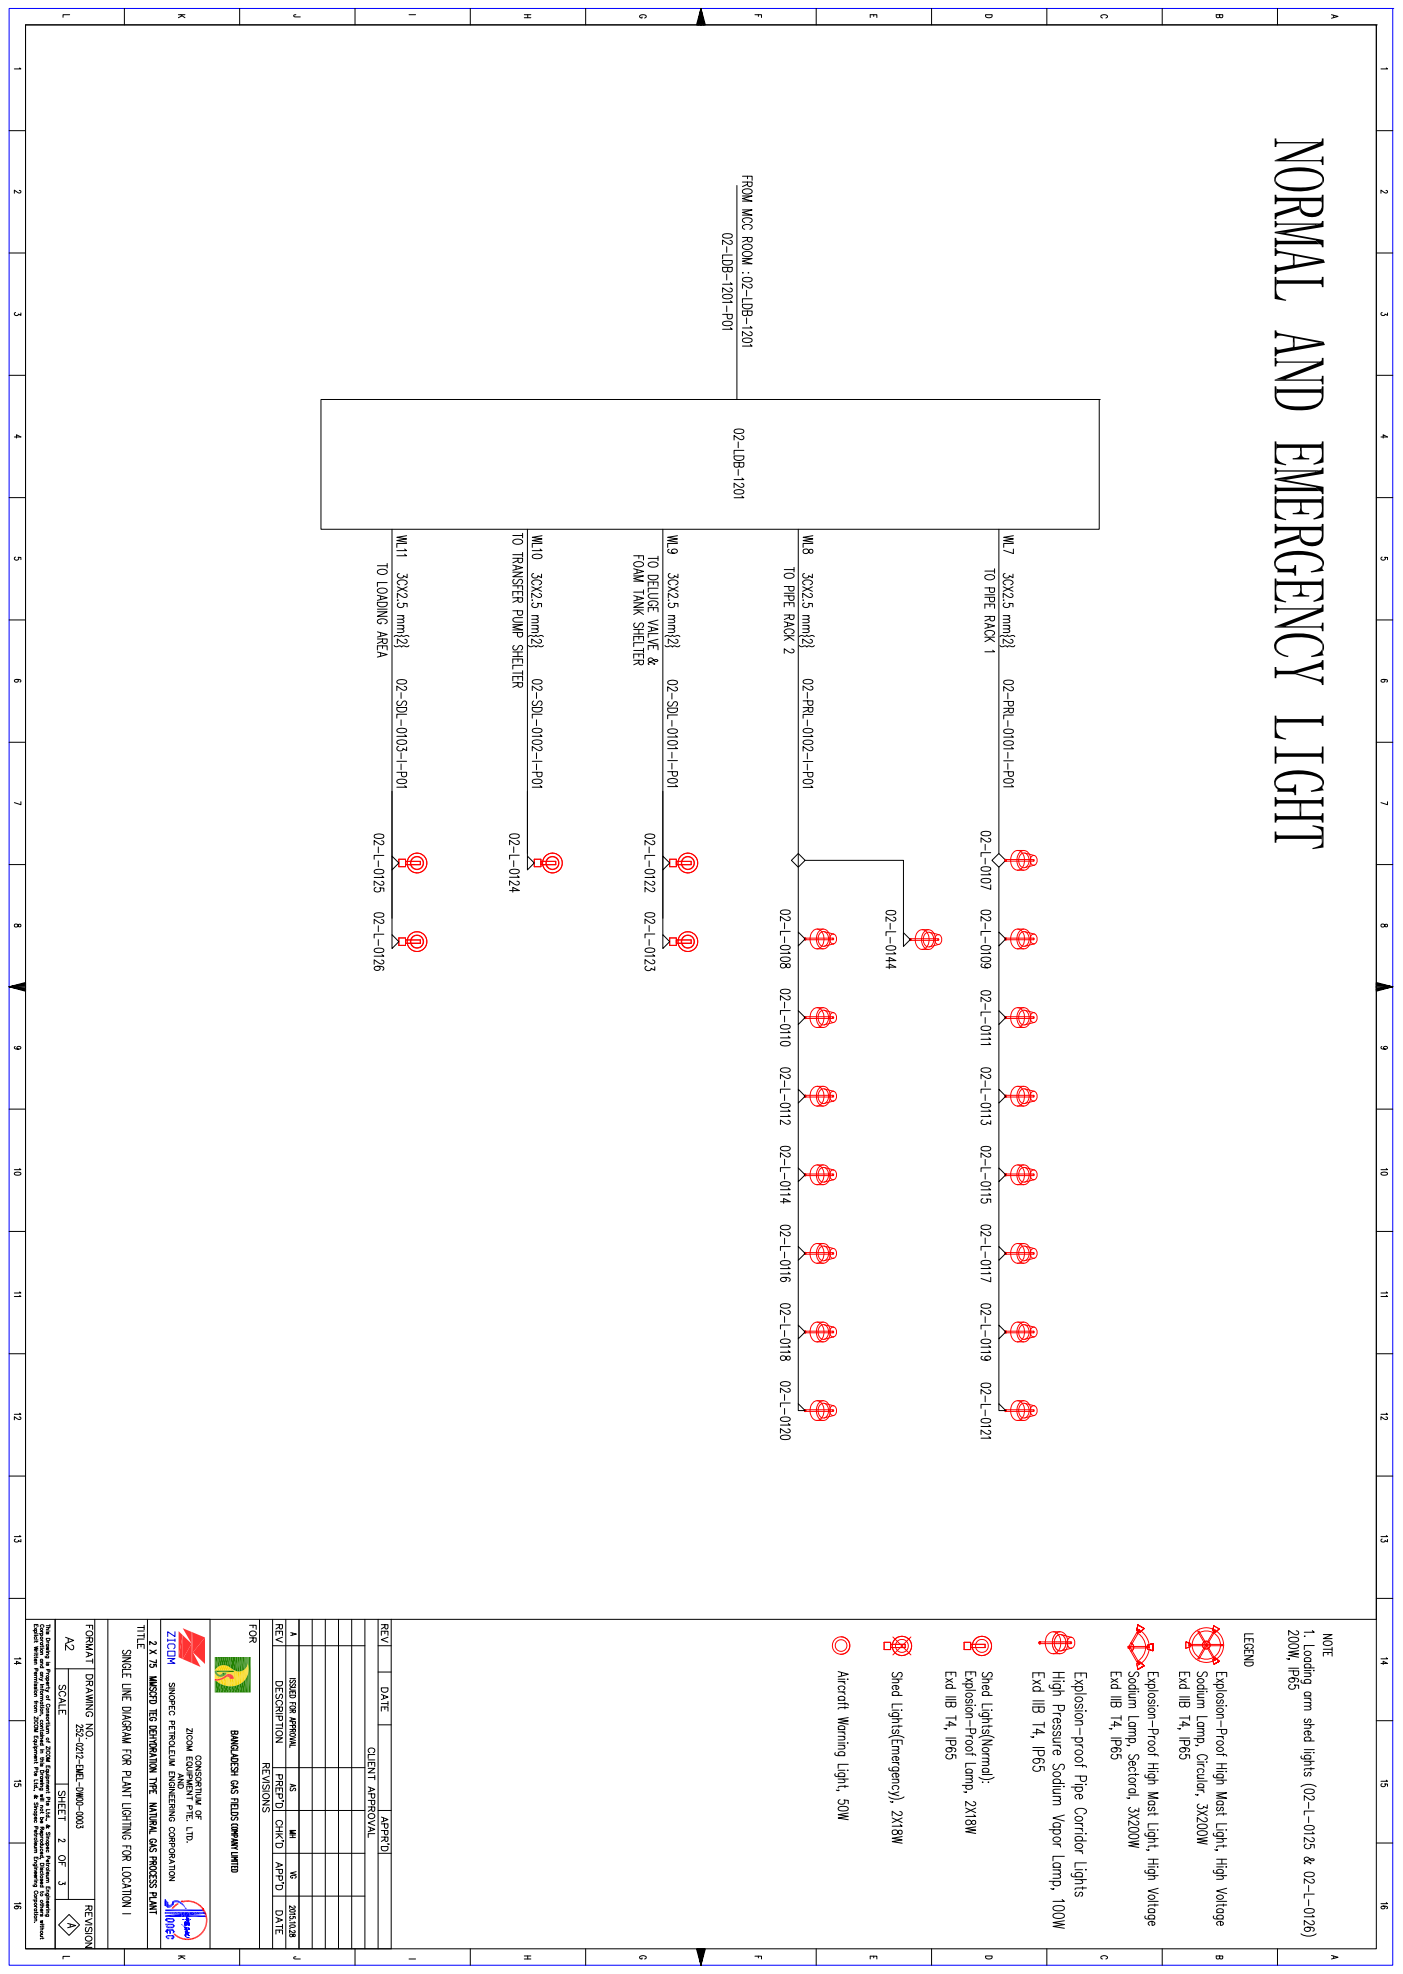
[picture p25: page 8]

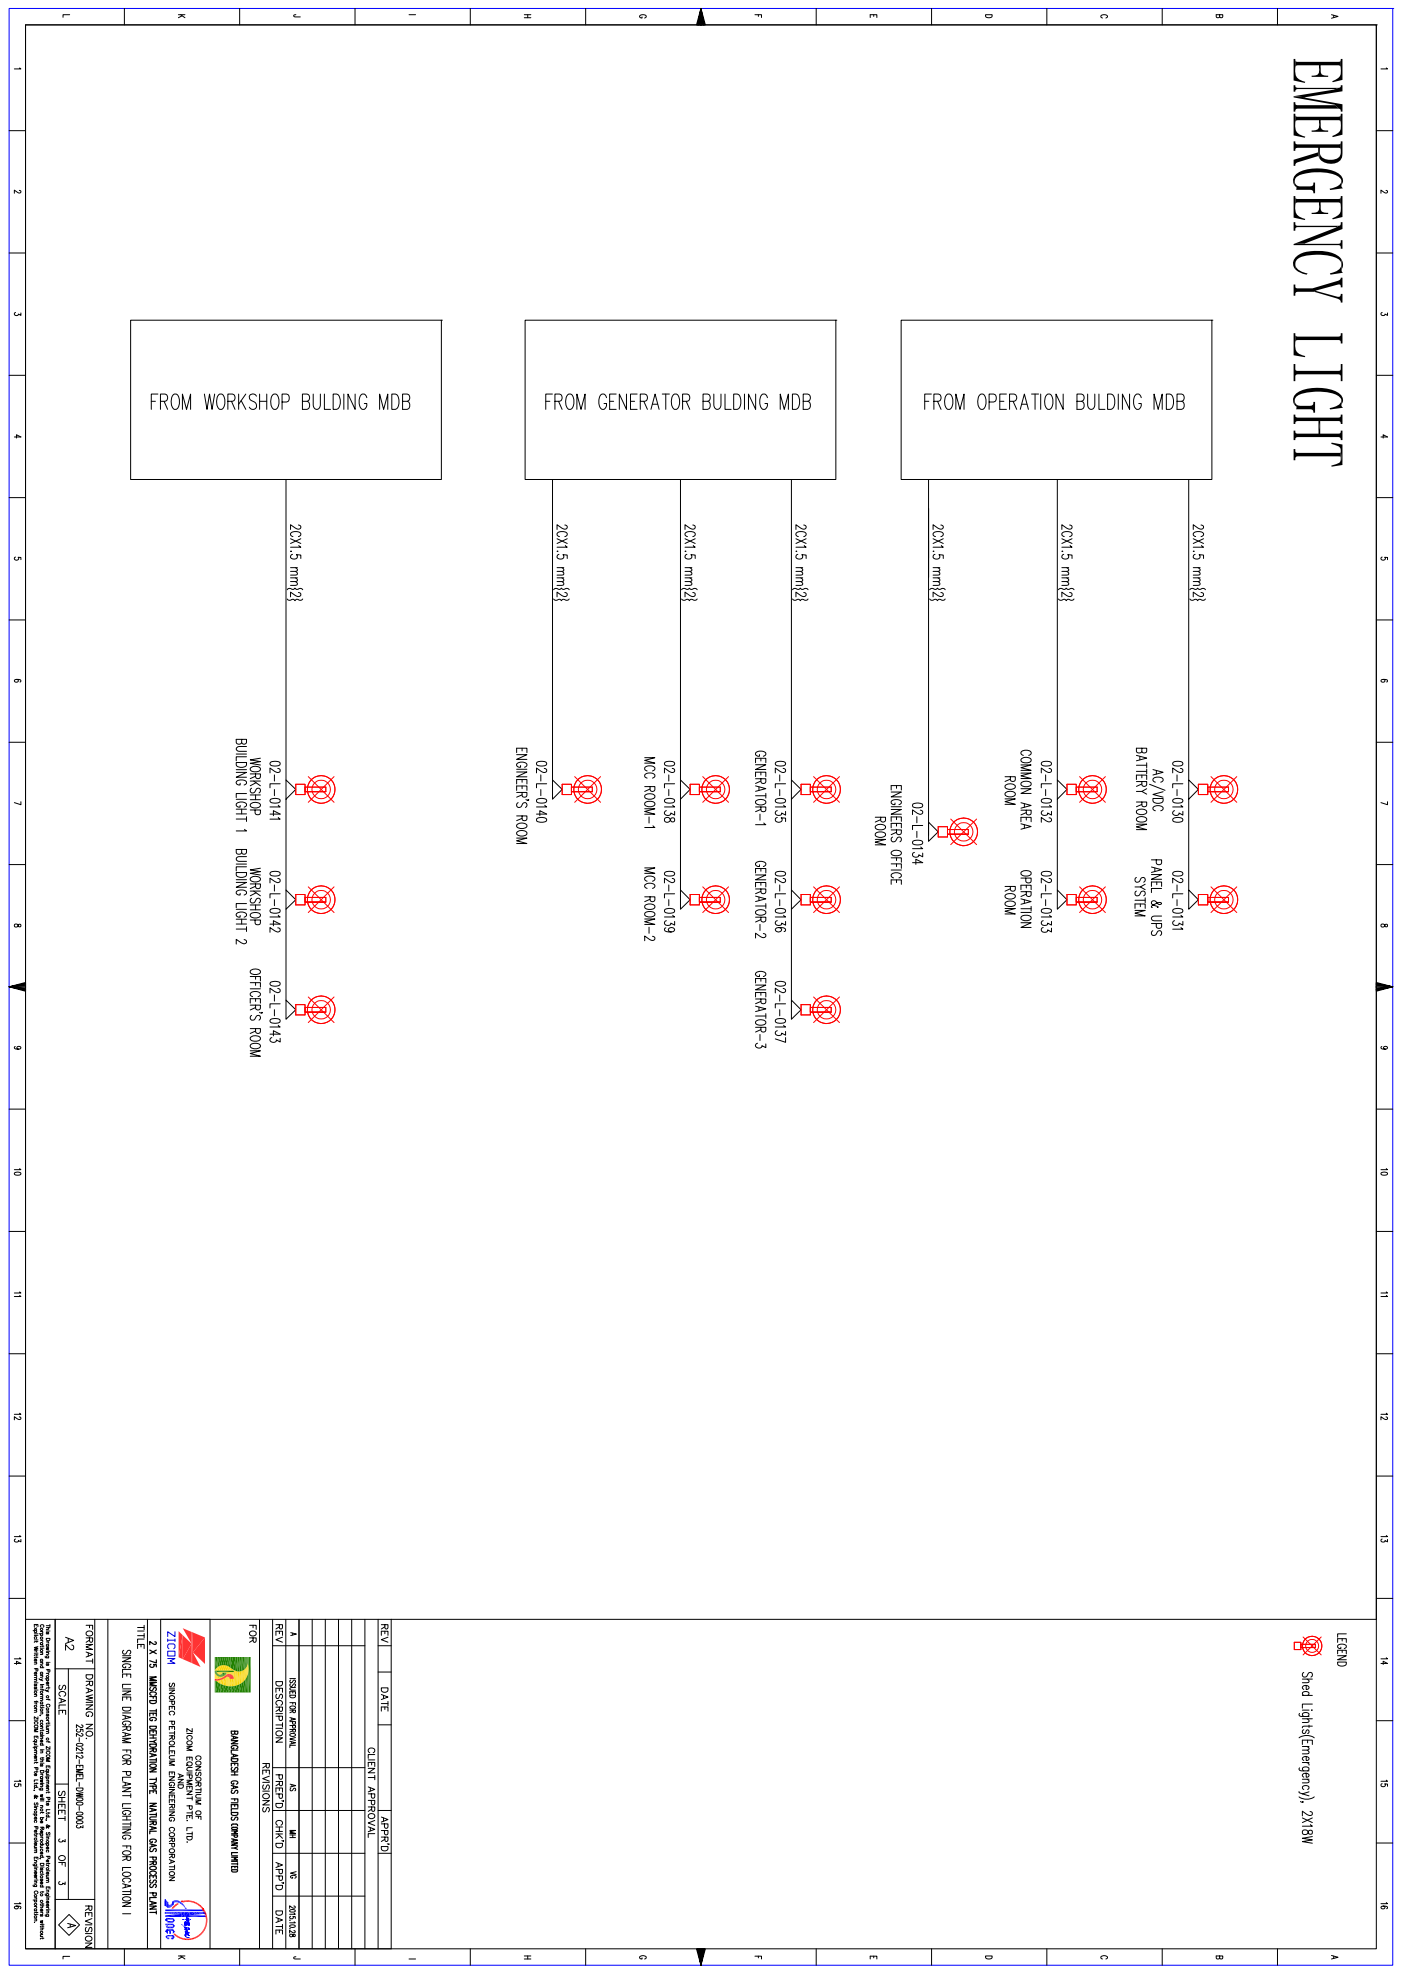
[picture p26: page 9]

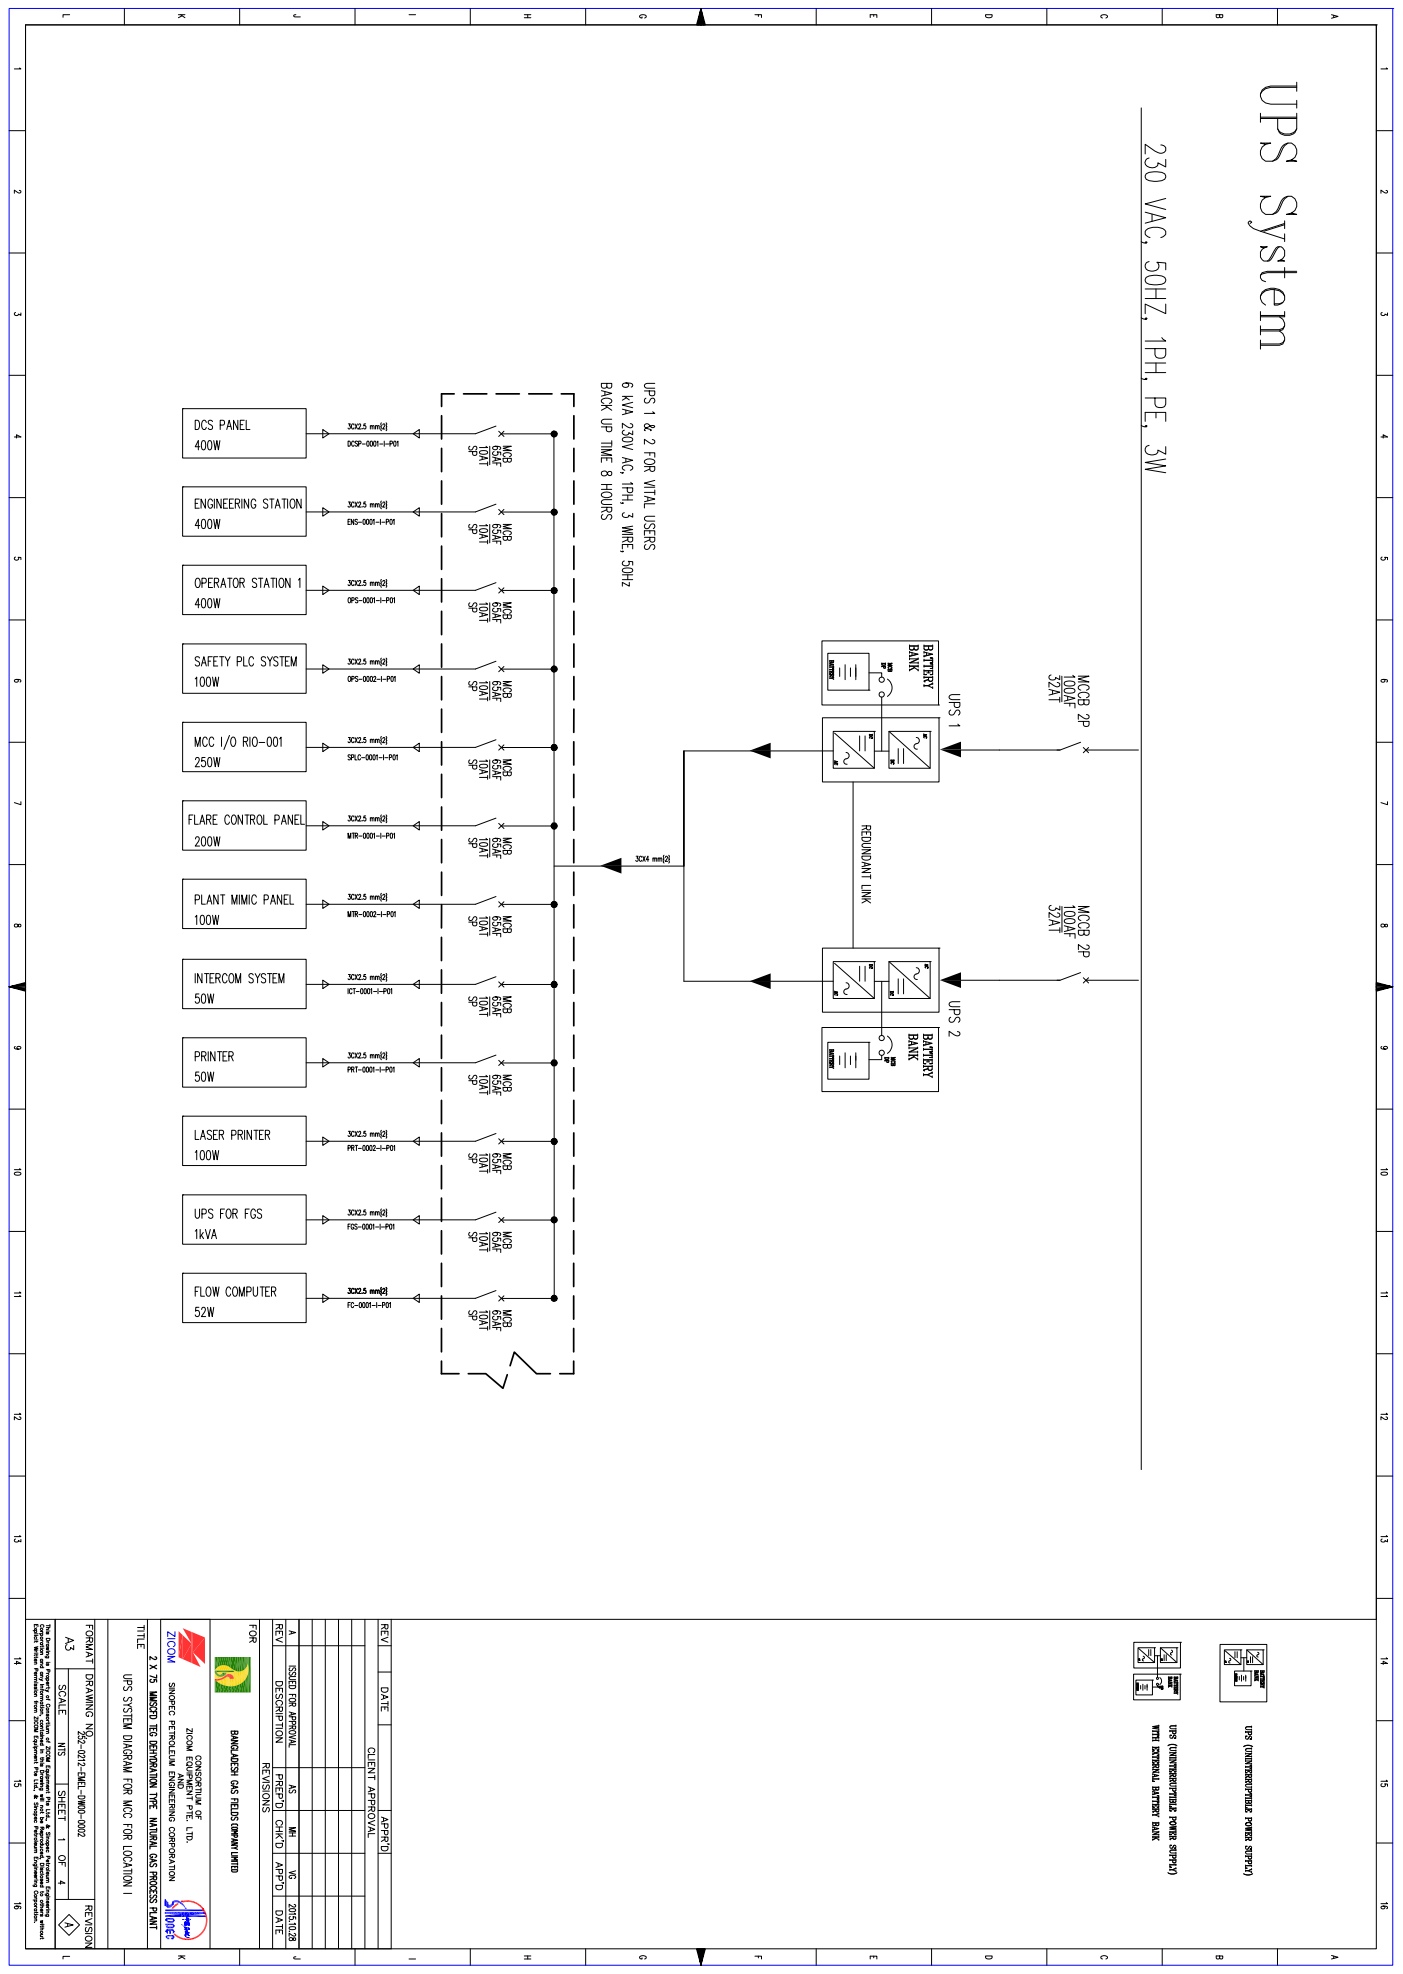
[picture p27: page 10]

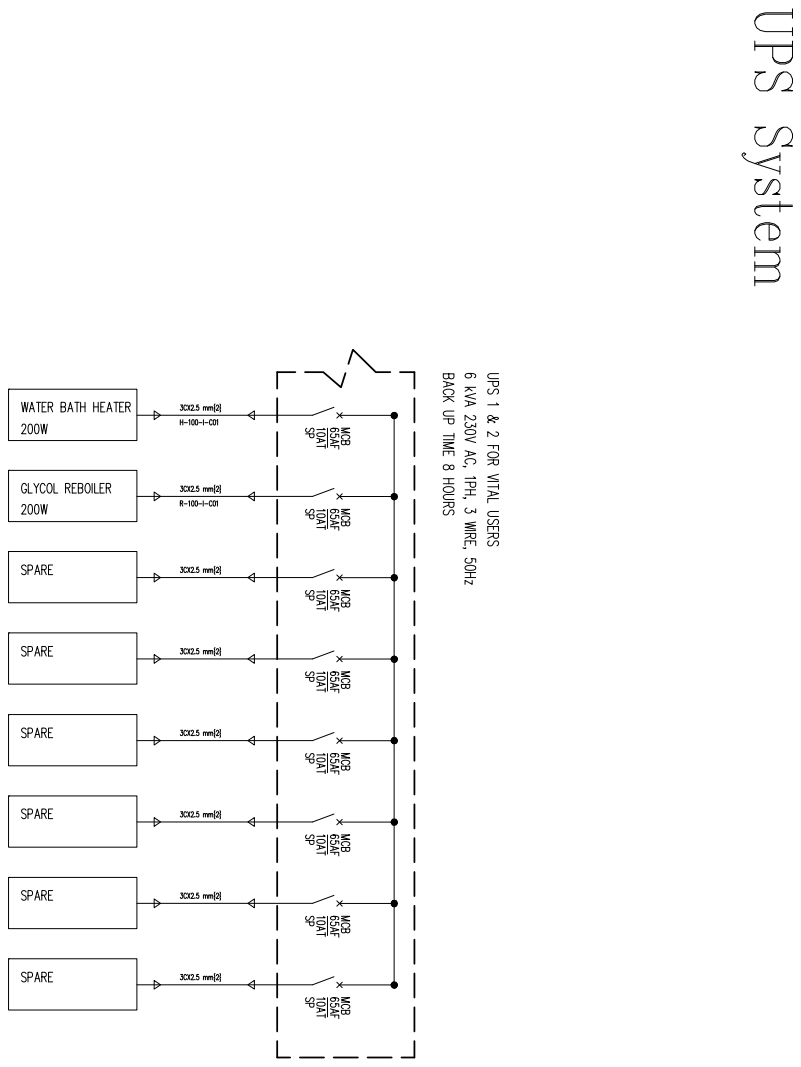
[picture p28: page 11]

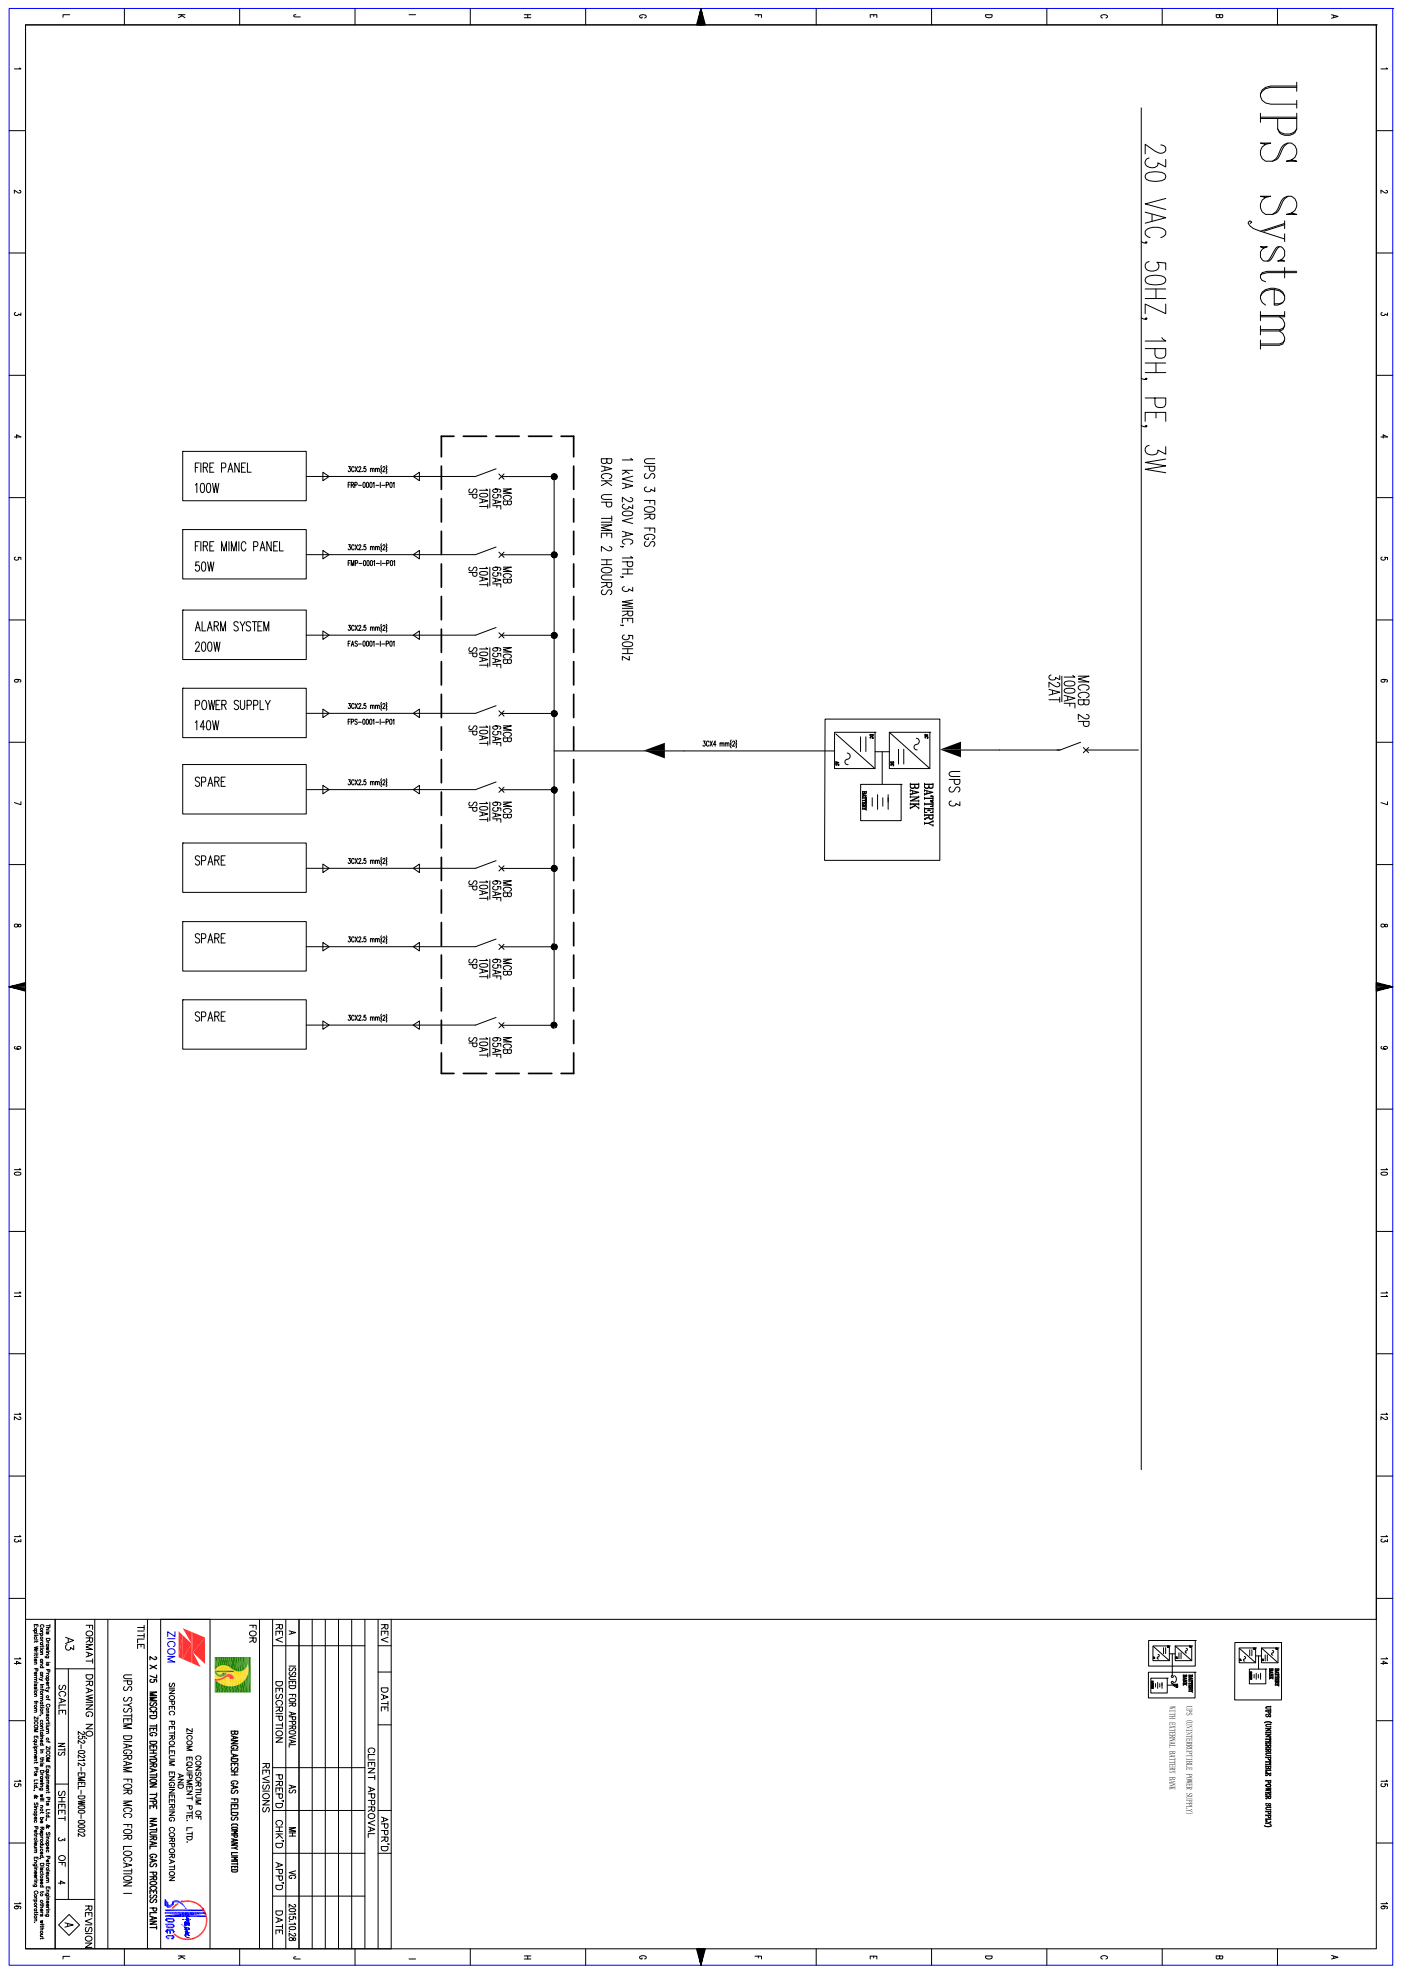
[picture p29: page 12]

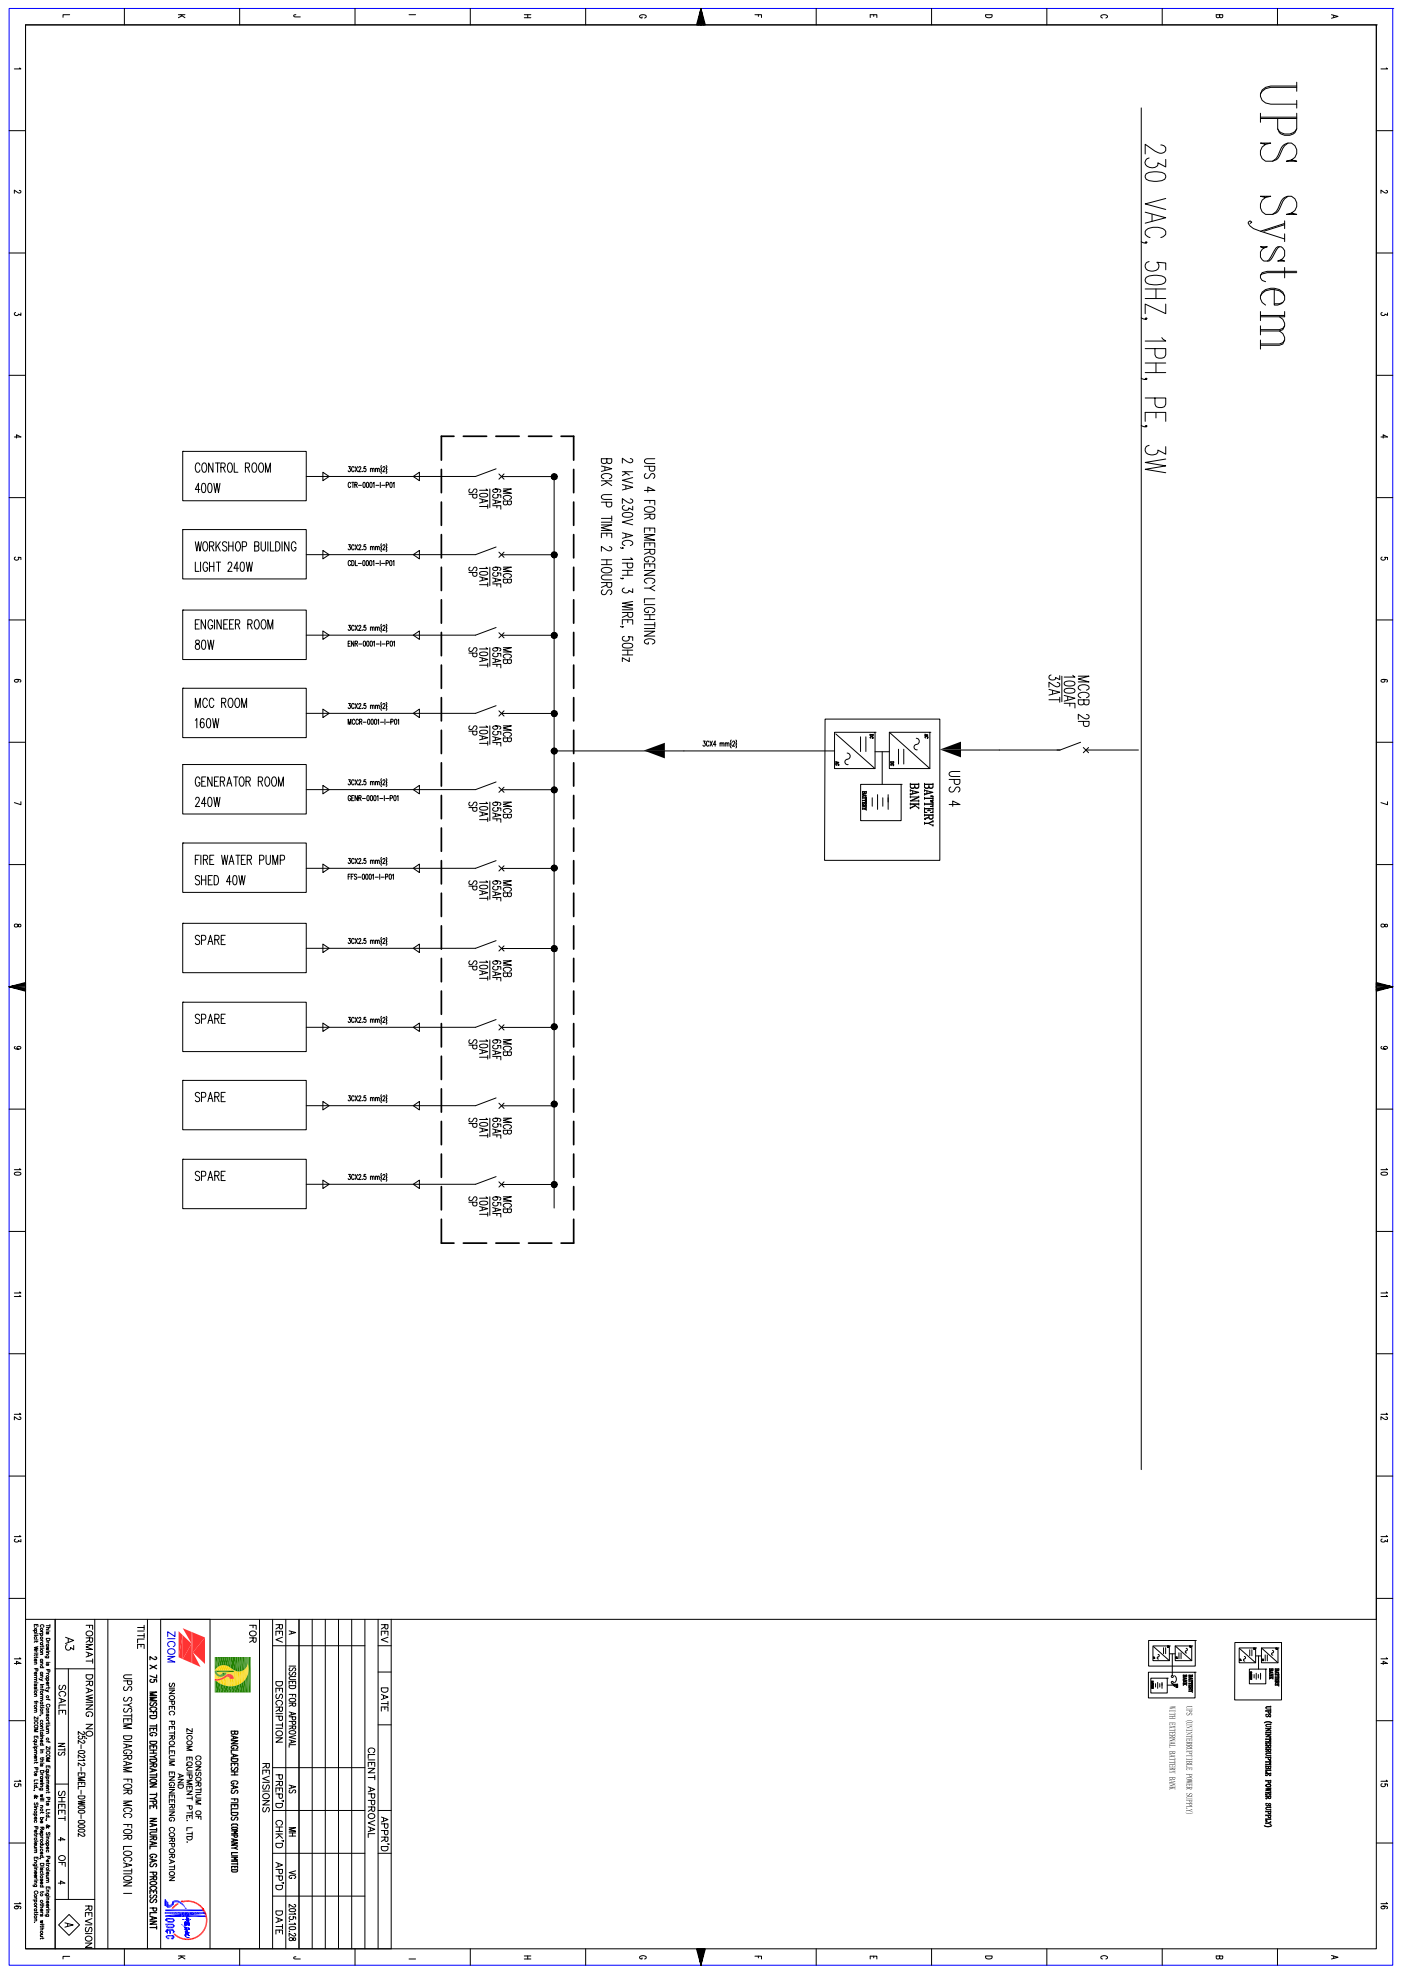
[picture p30: page 13]

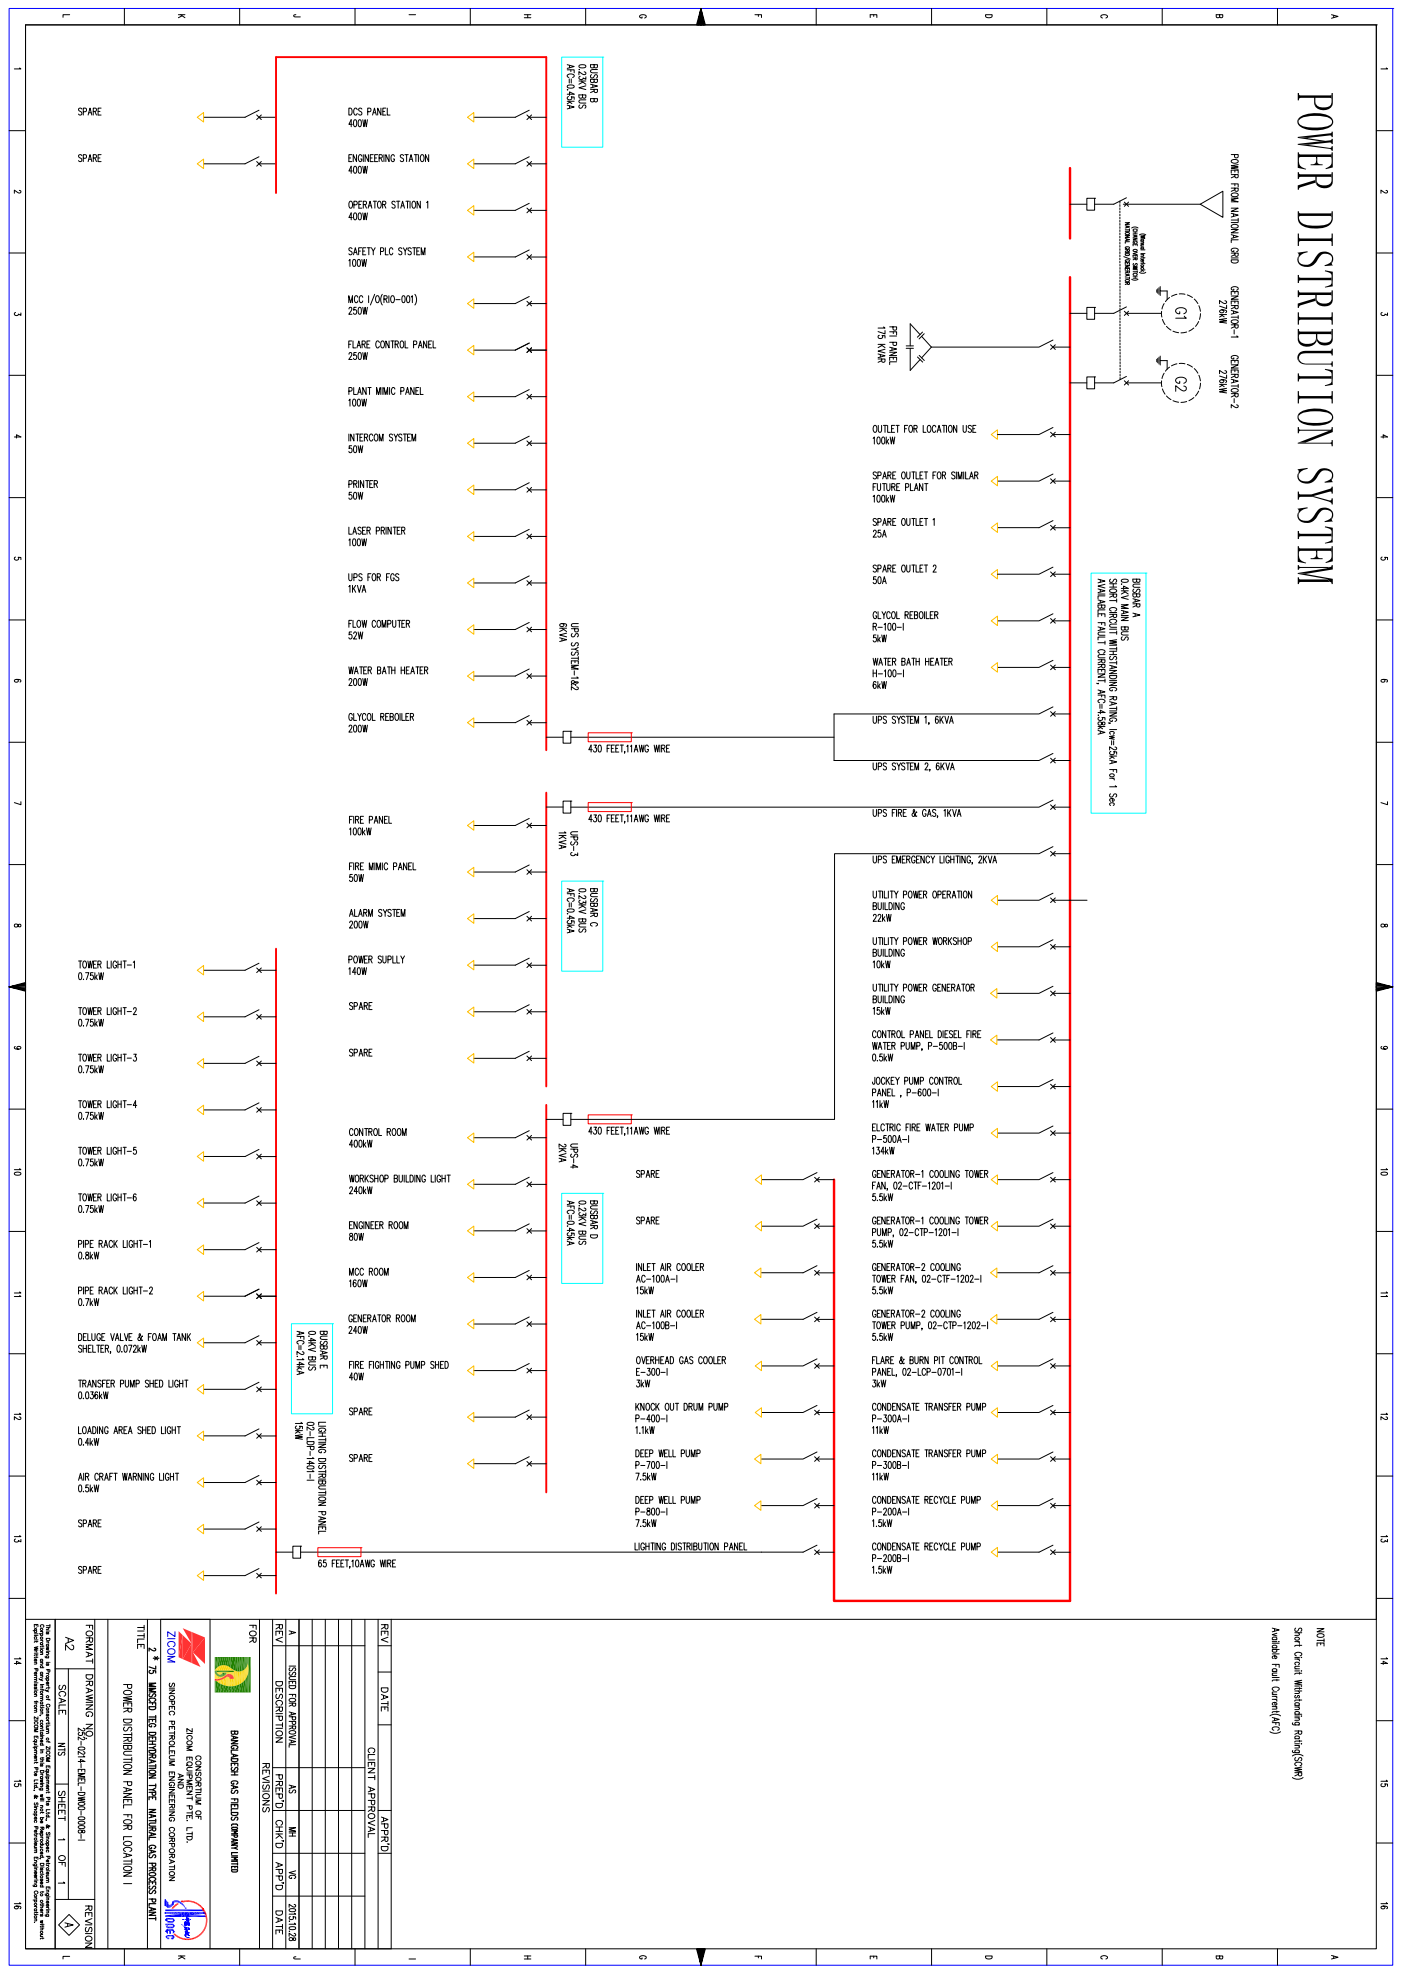
[picture p31: page 14]

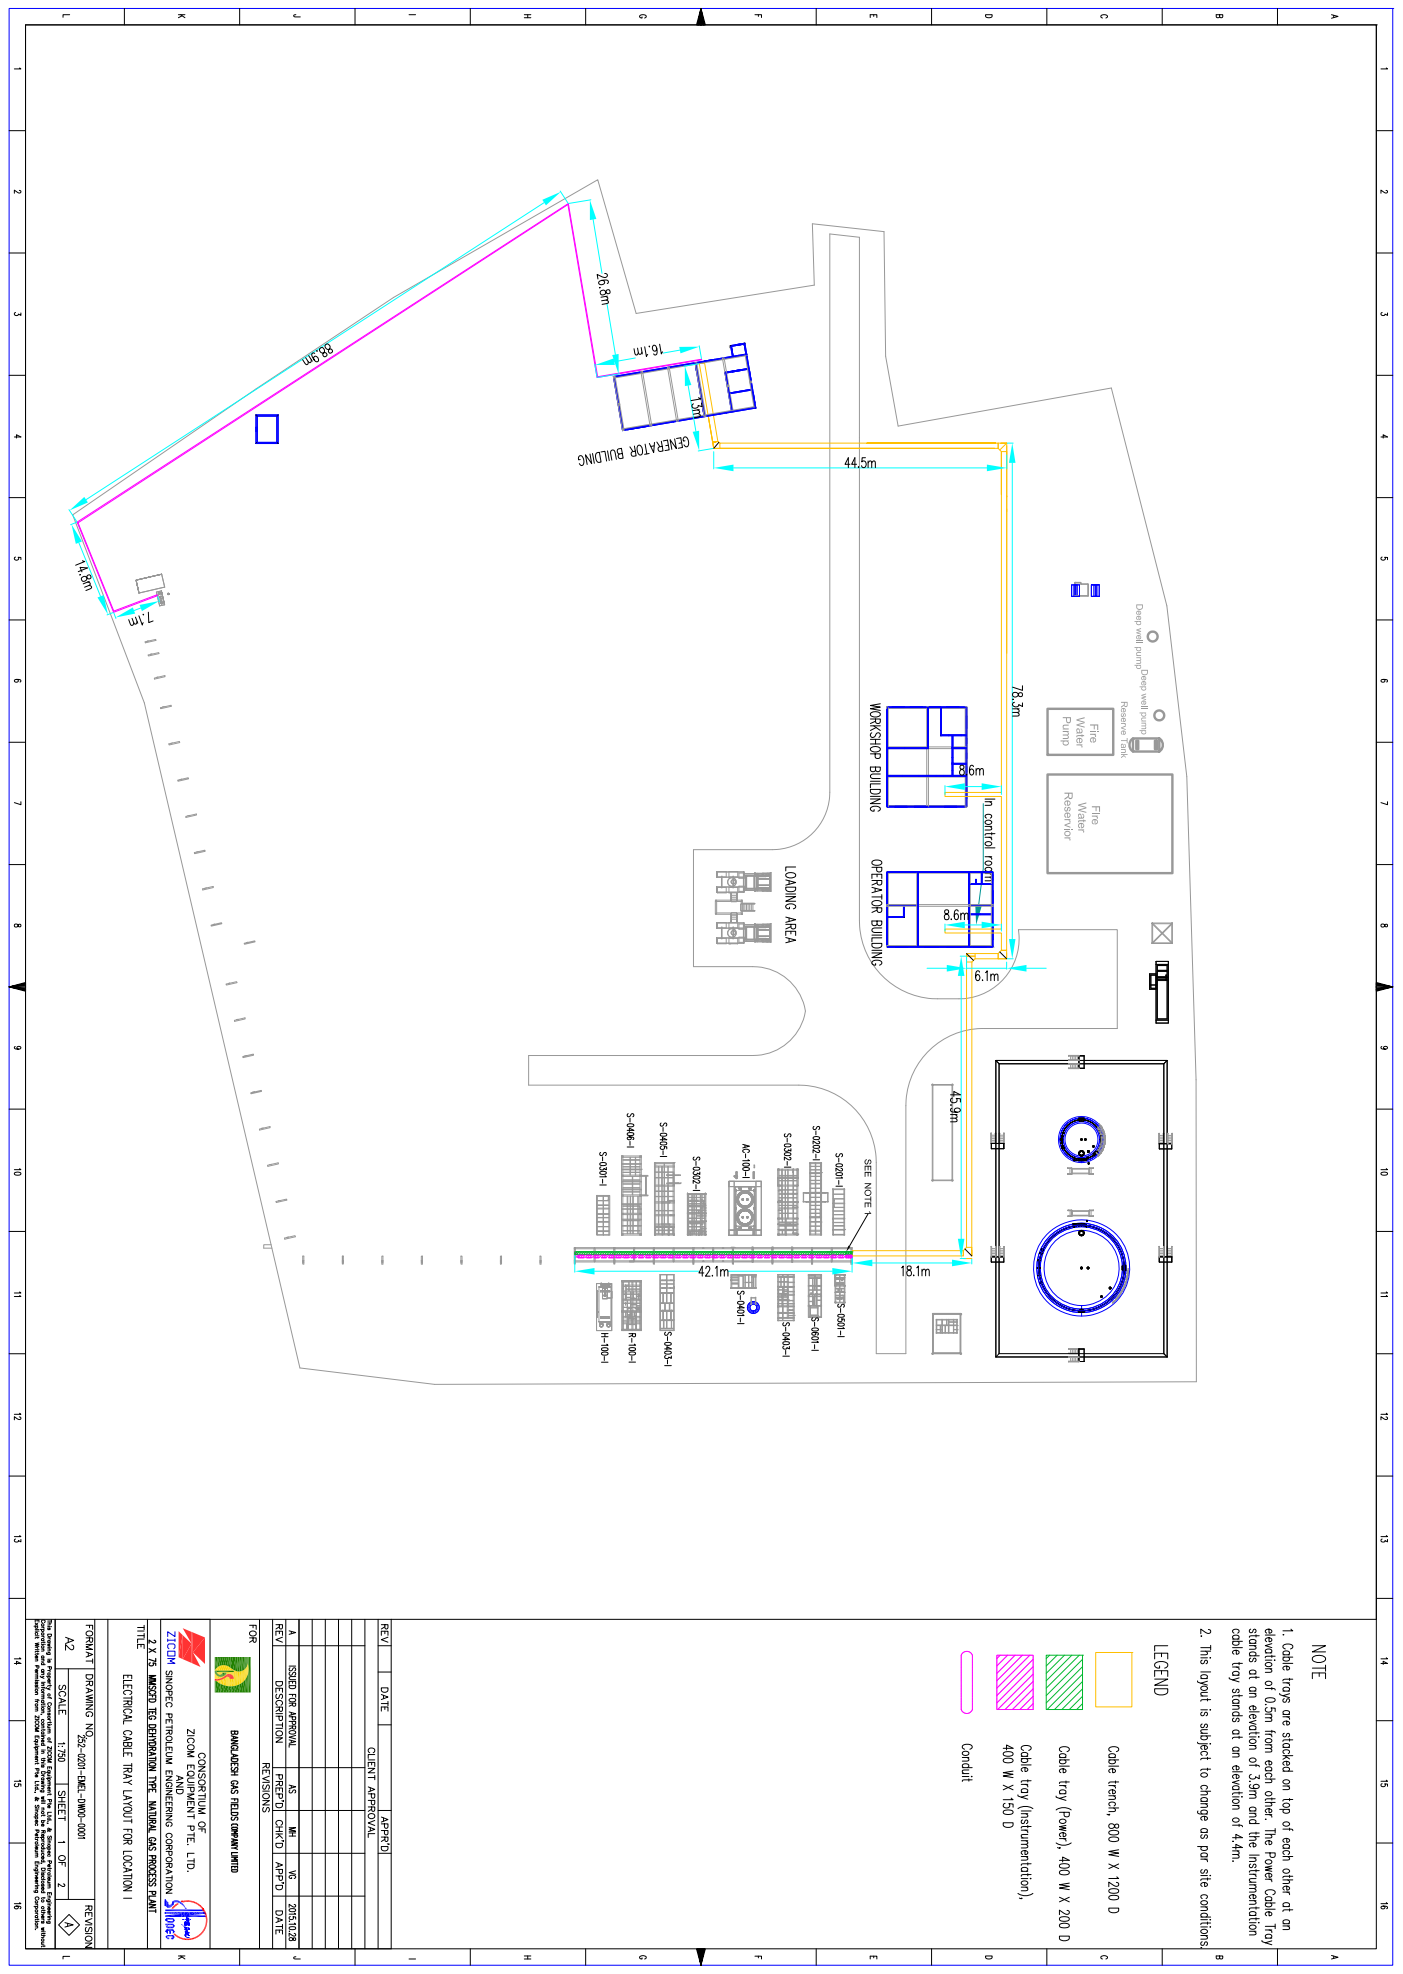
[picture p32: page 15]

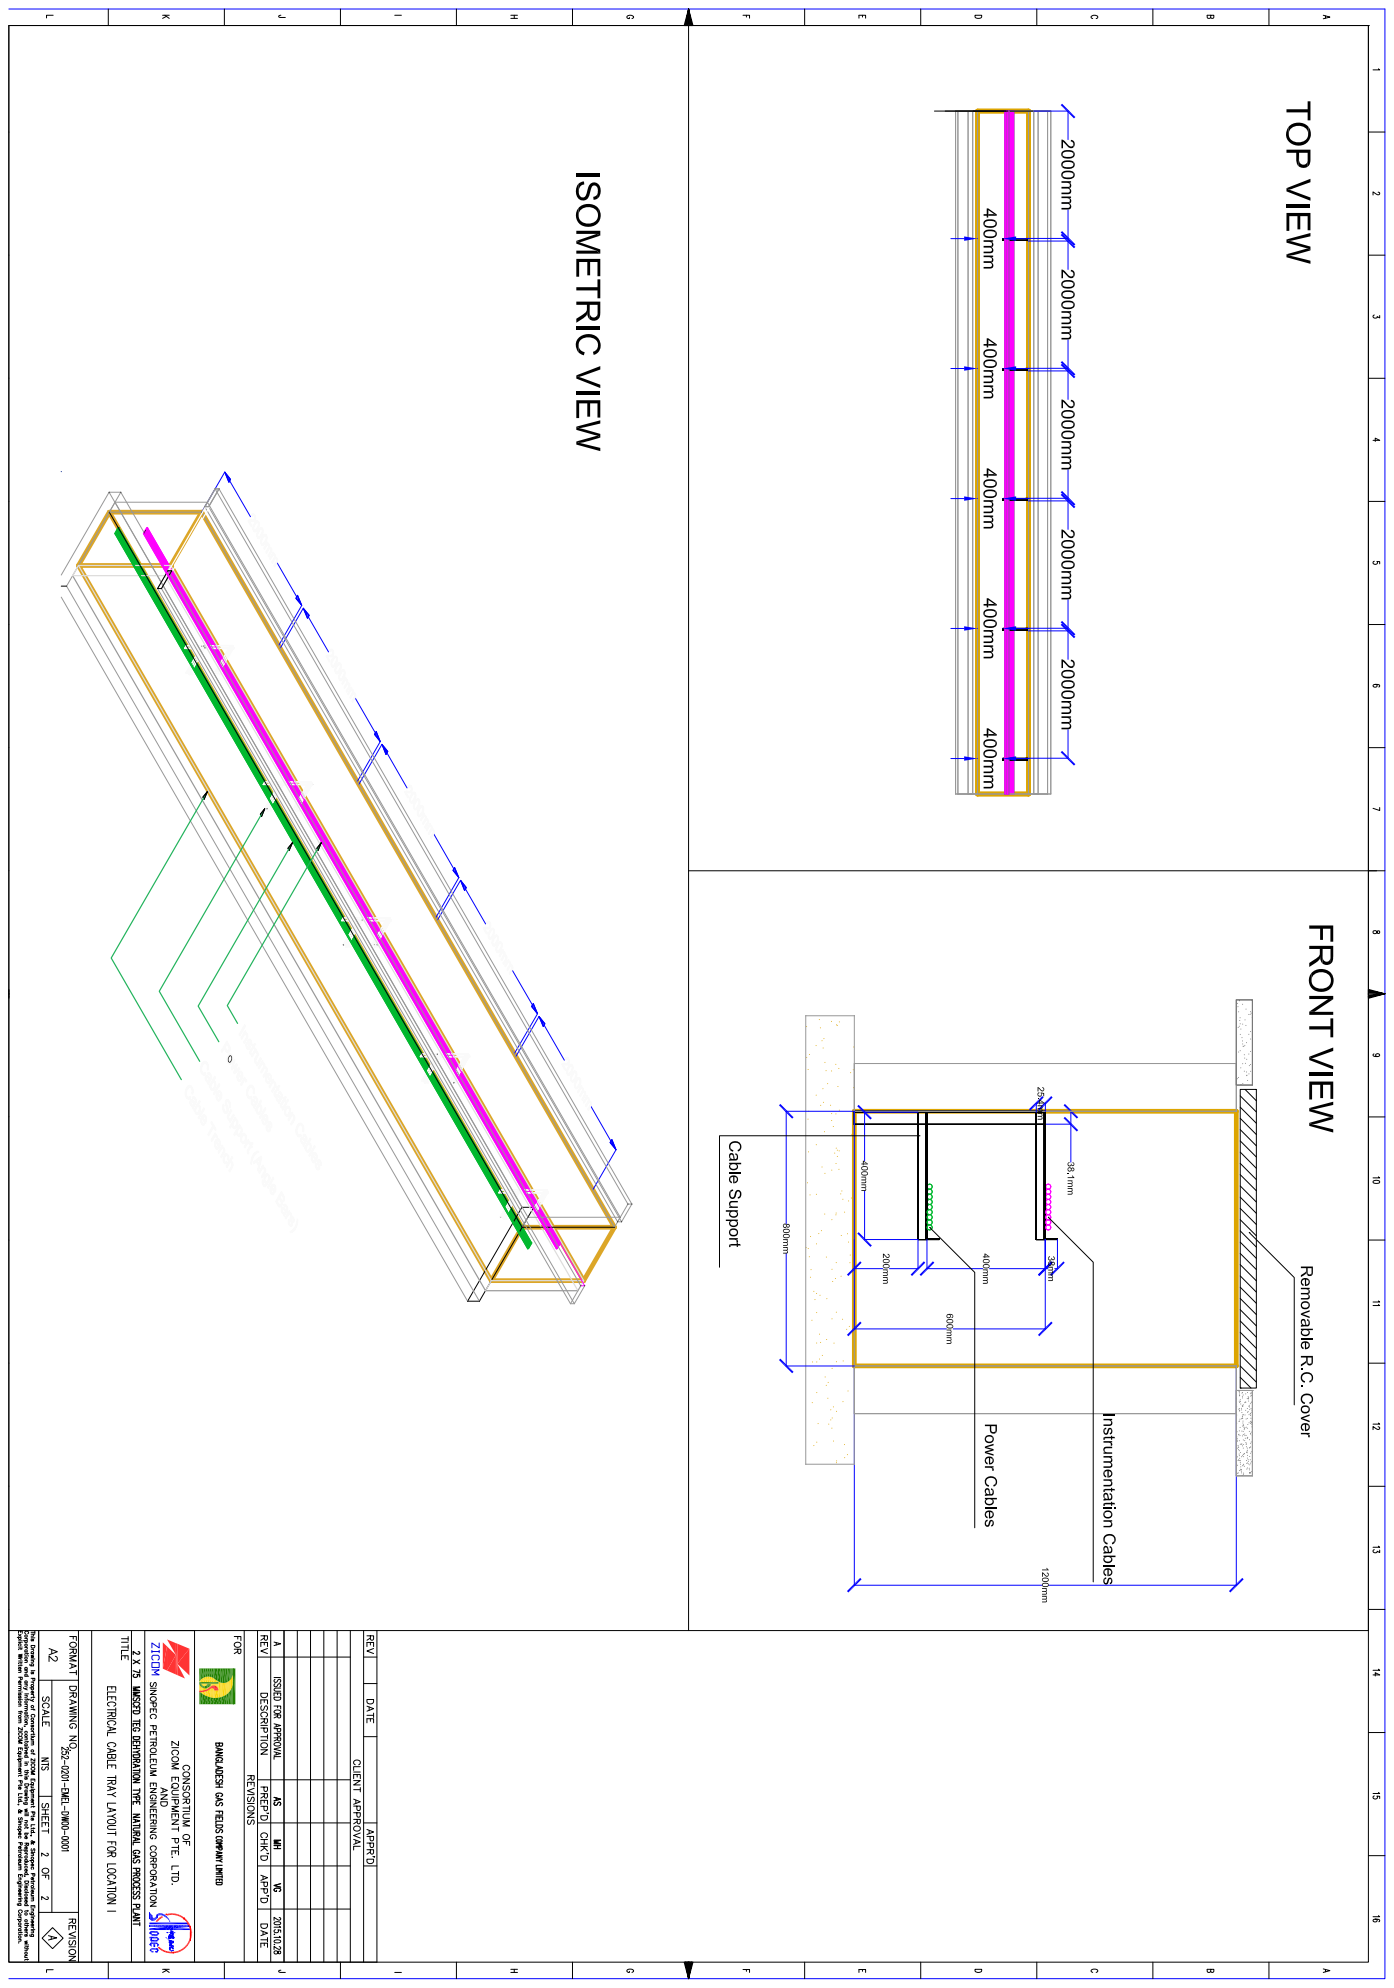
[picture p33: page 16]

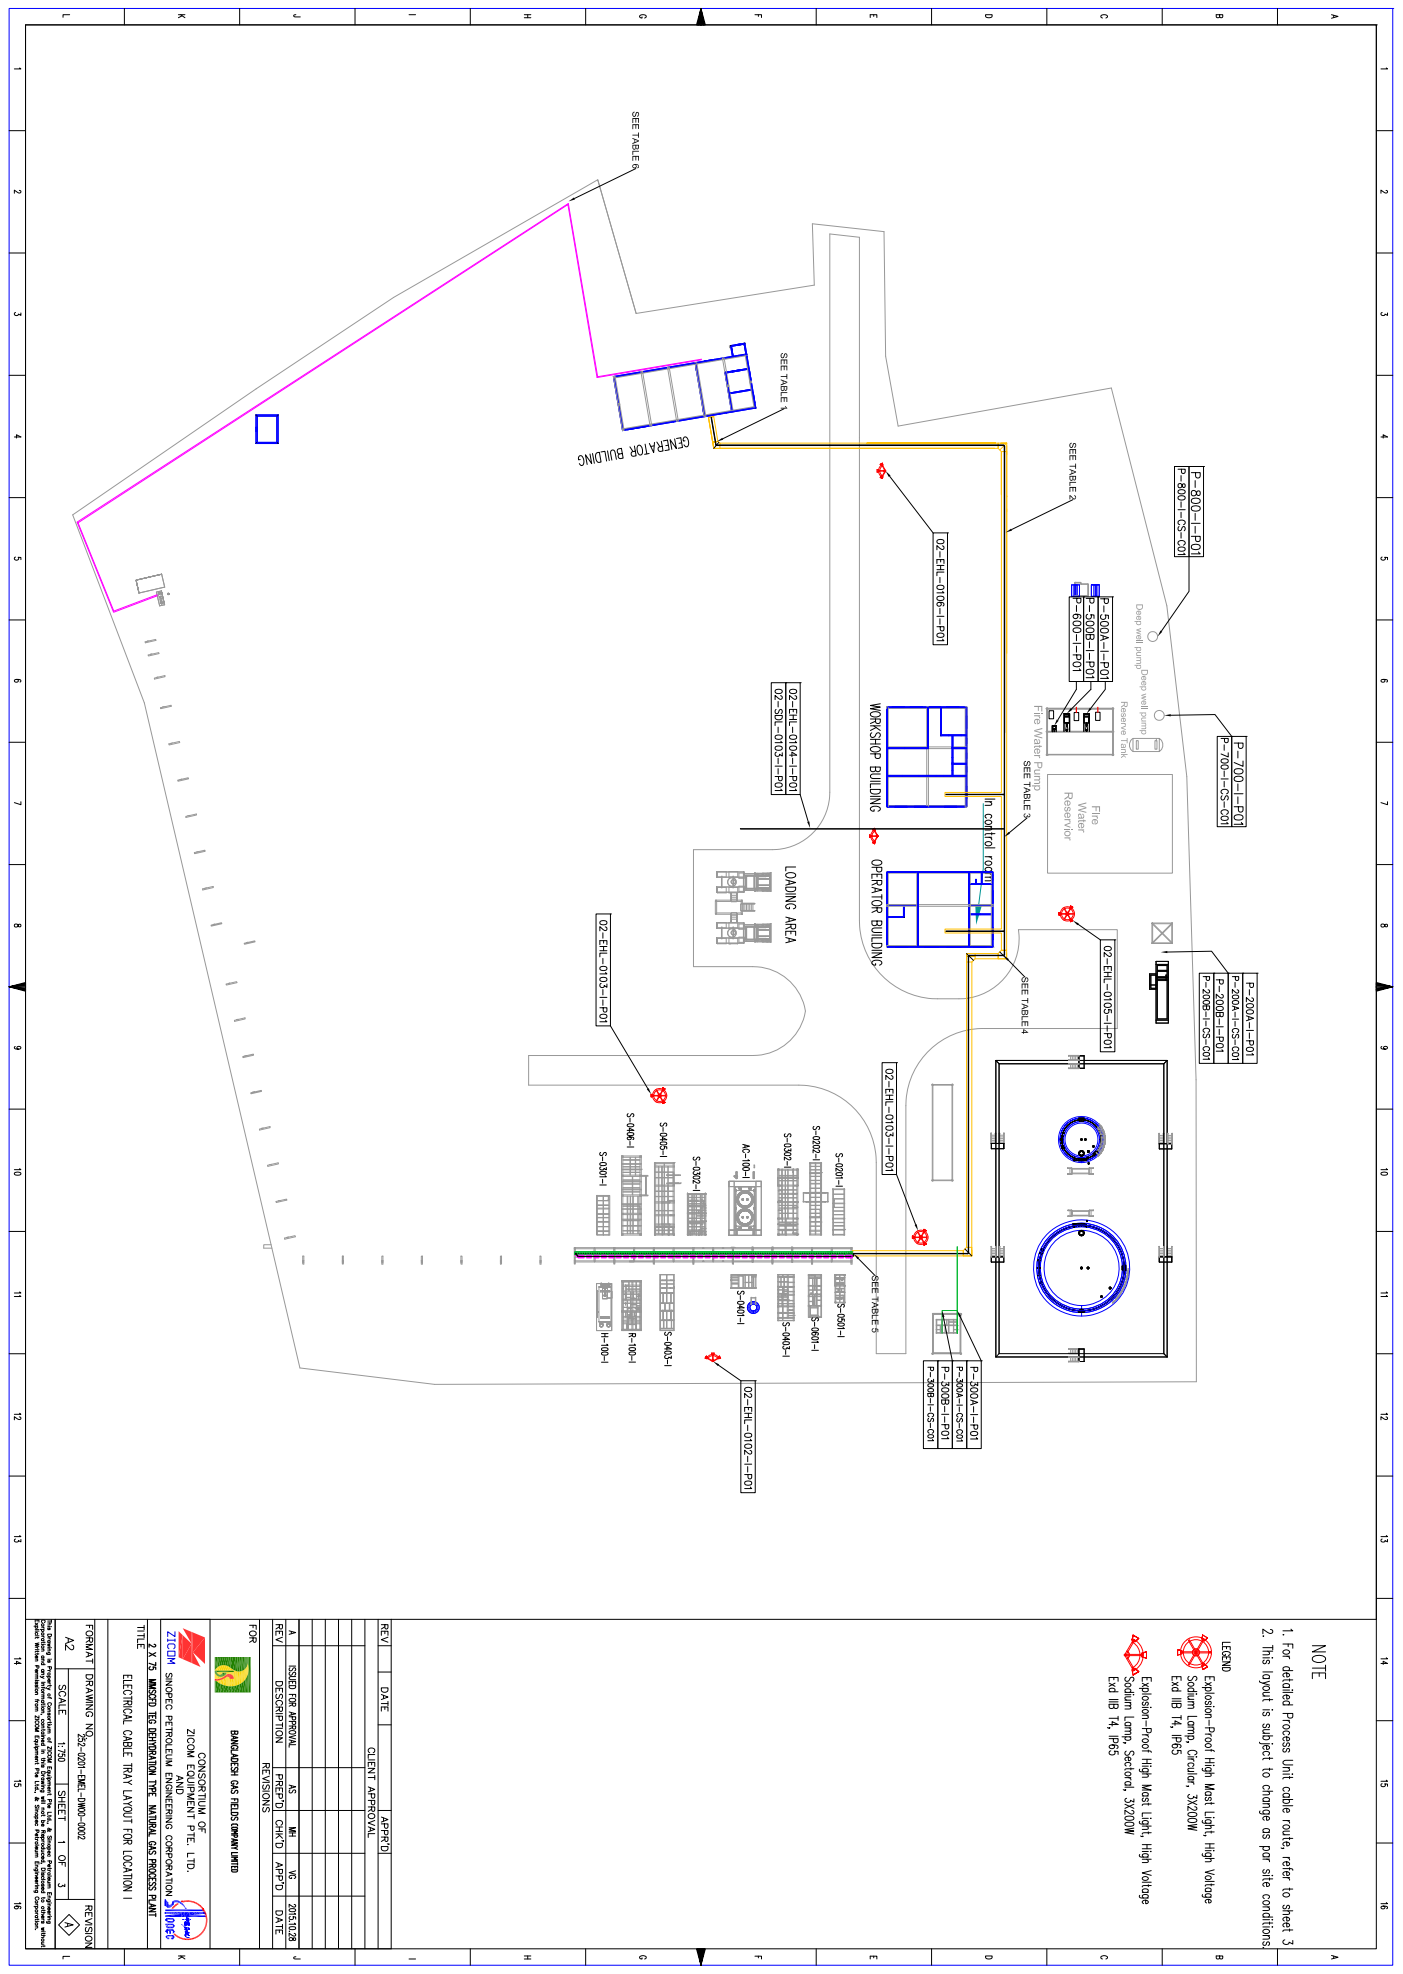
[picture p34: page 17]

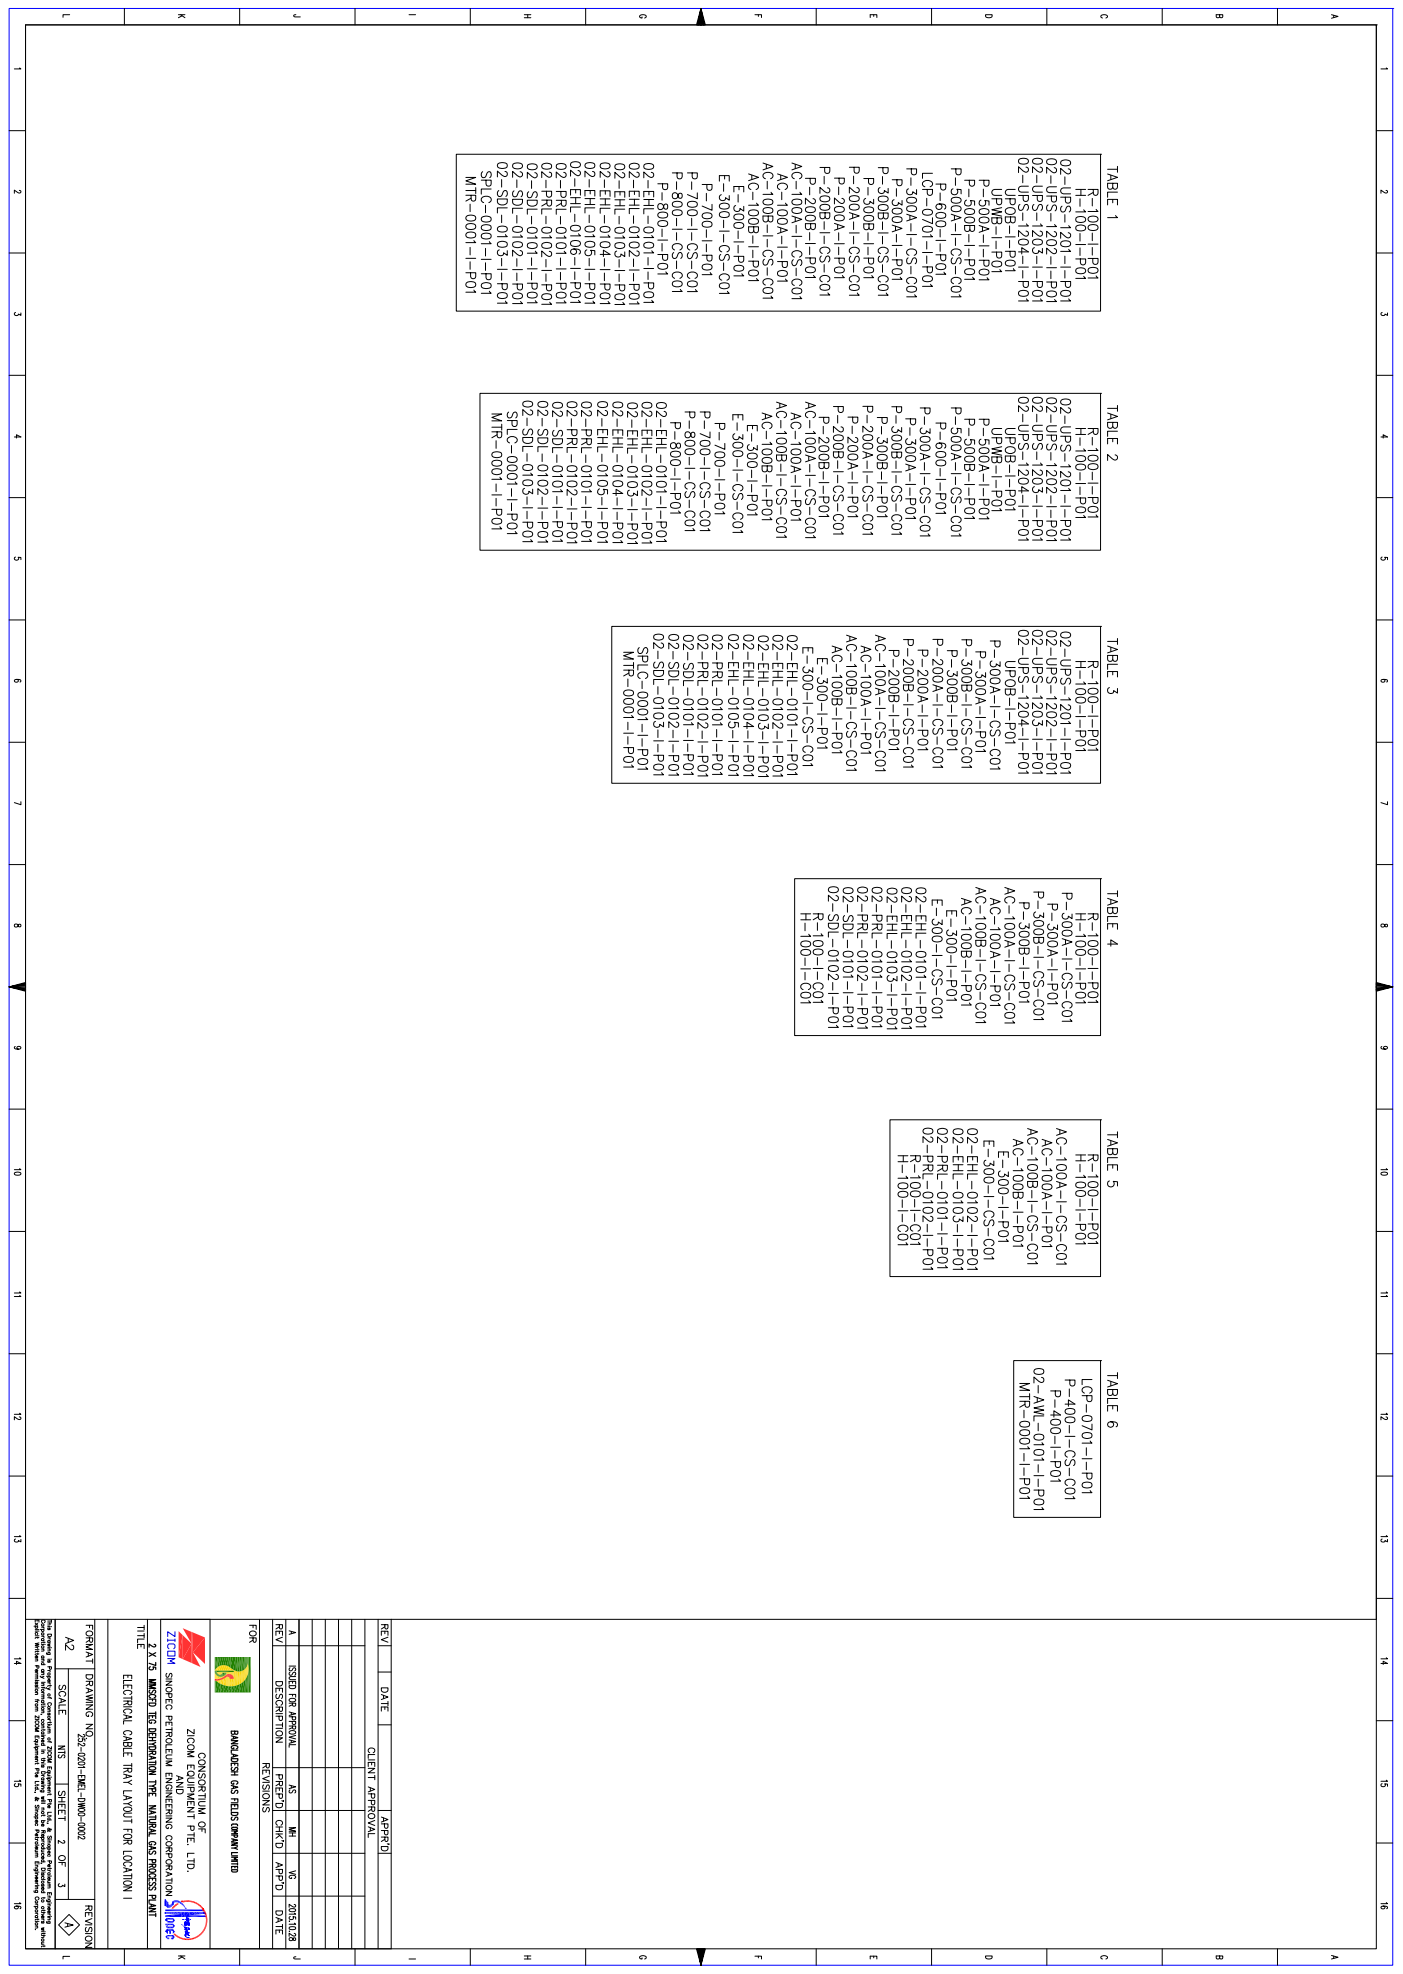
[picture p35: page 18]

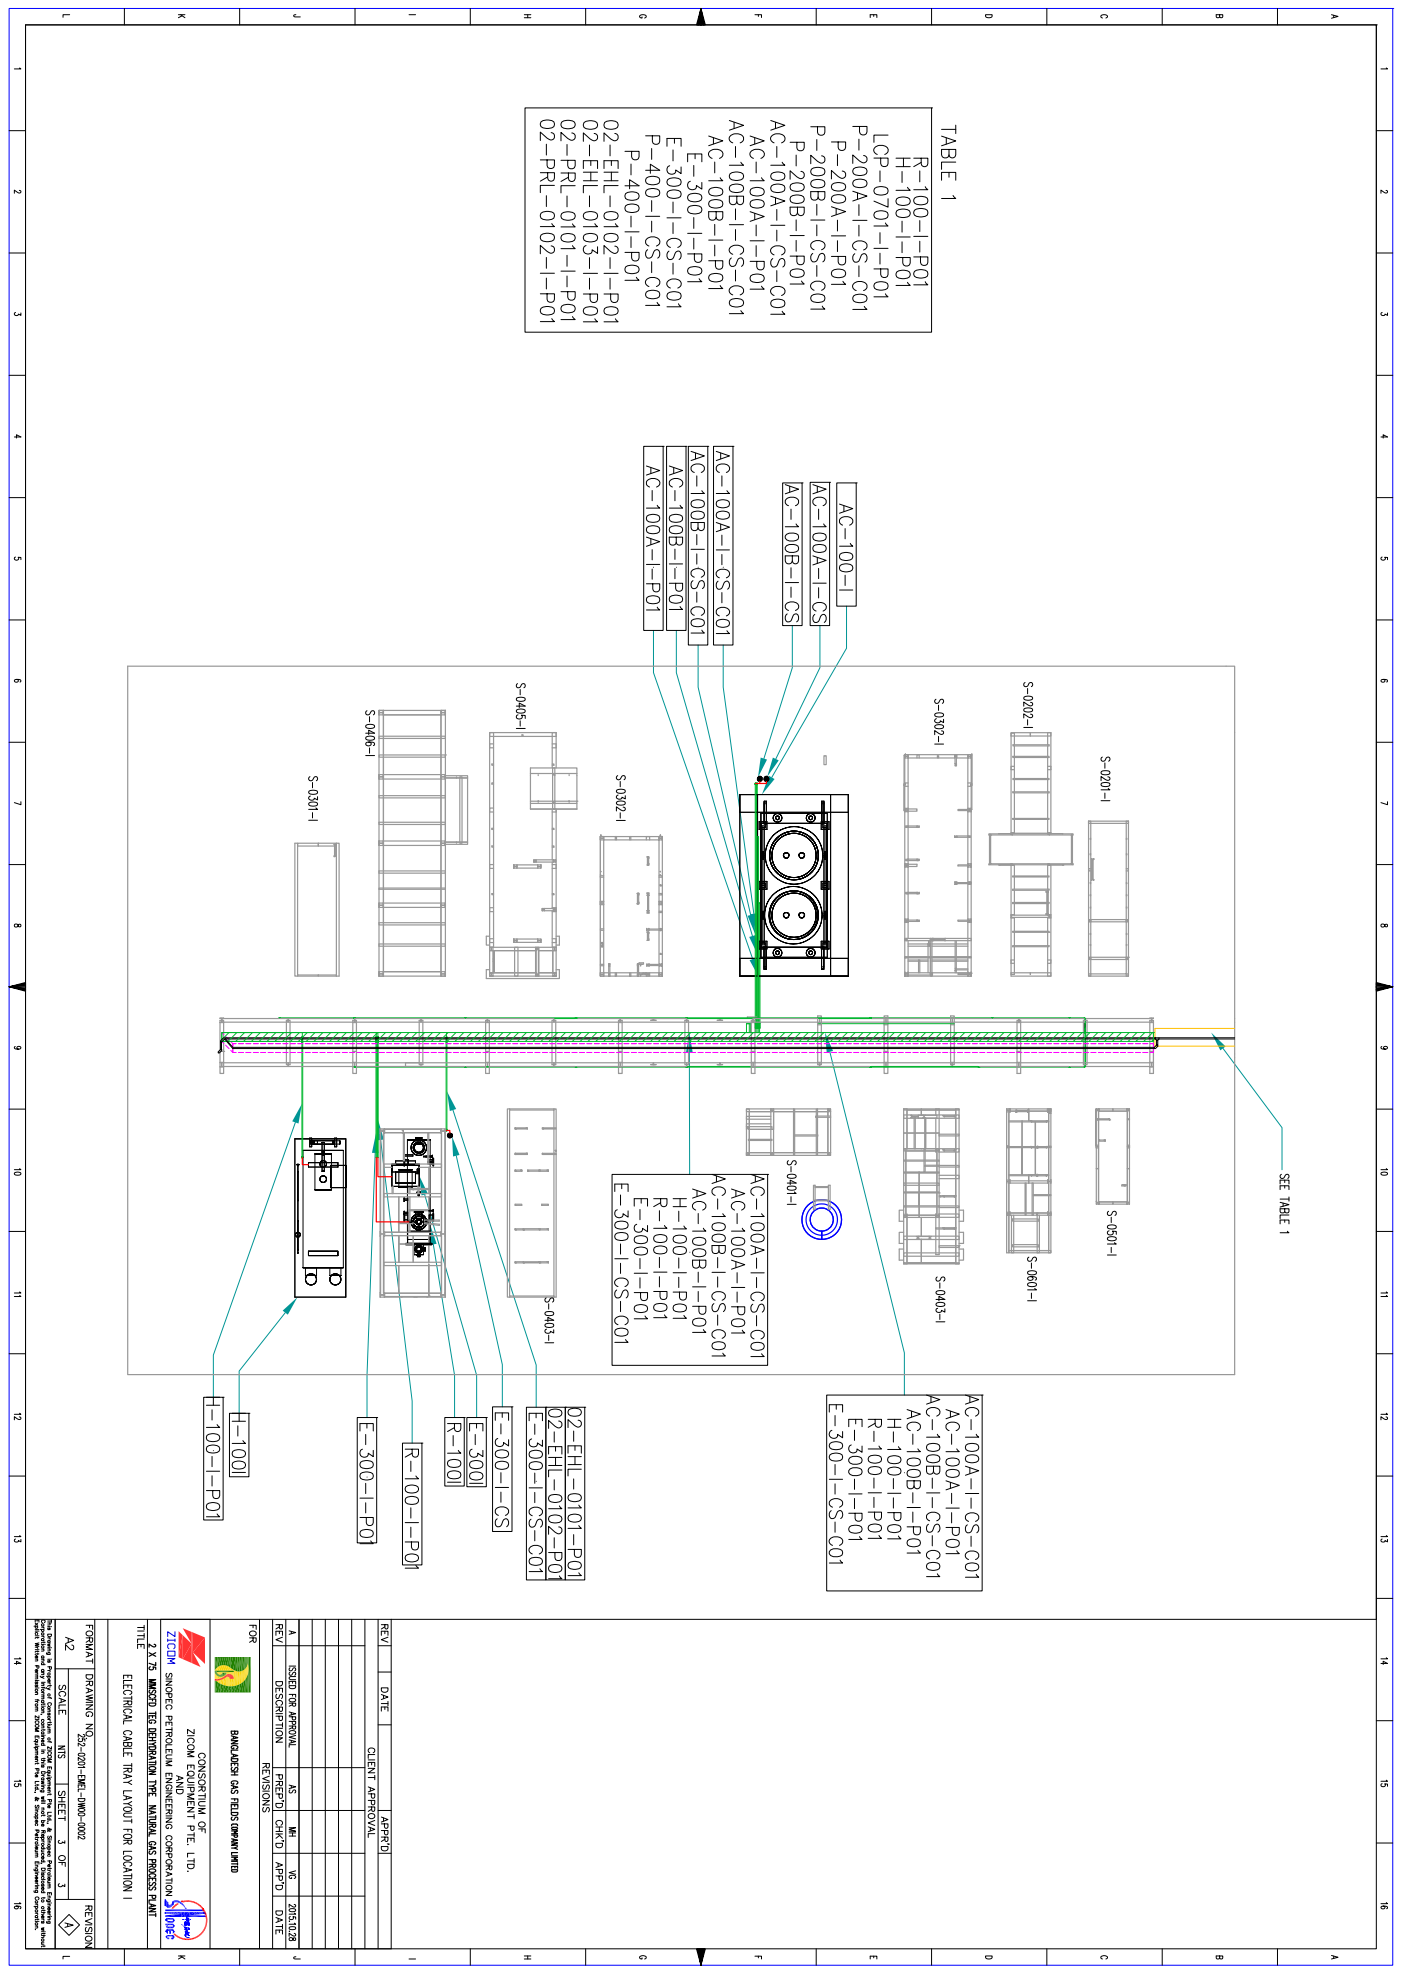
[picture p36: page 19]

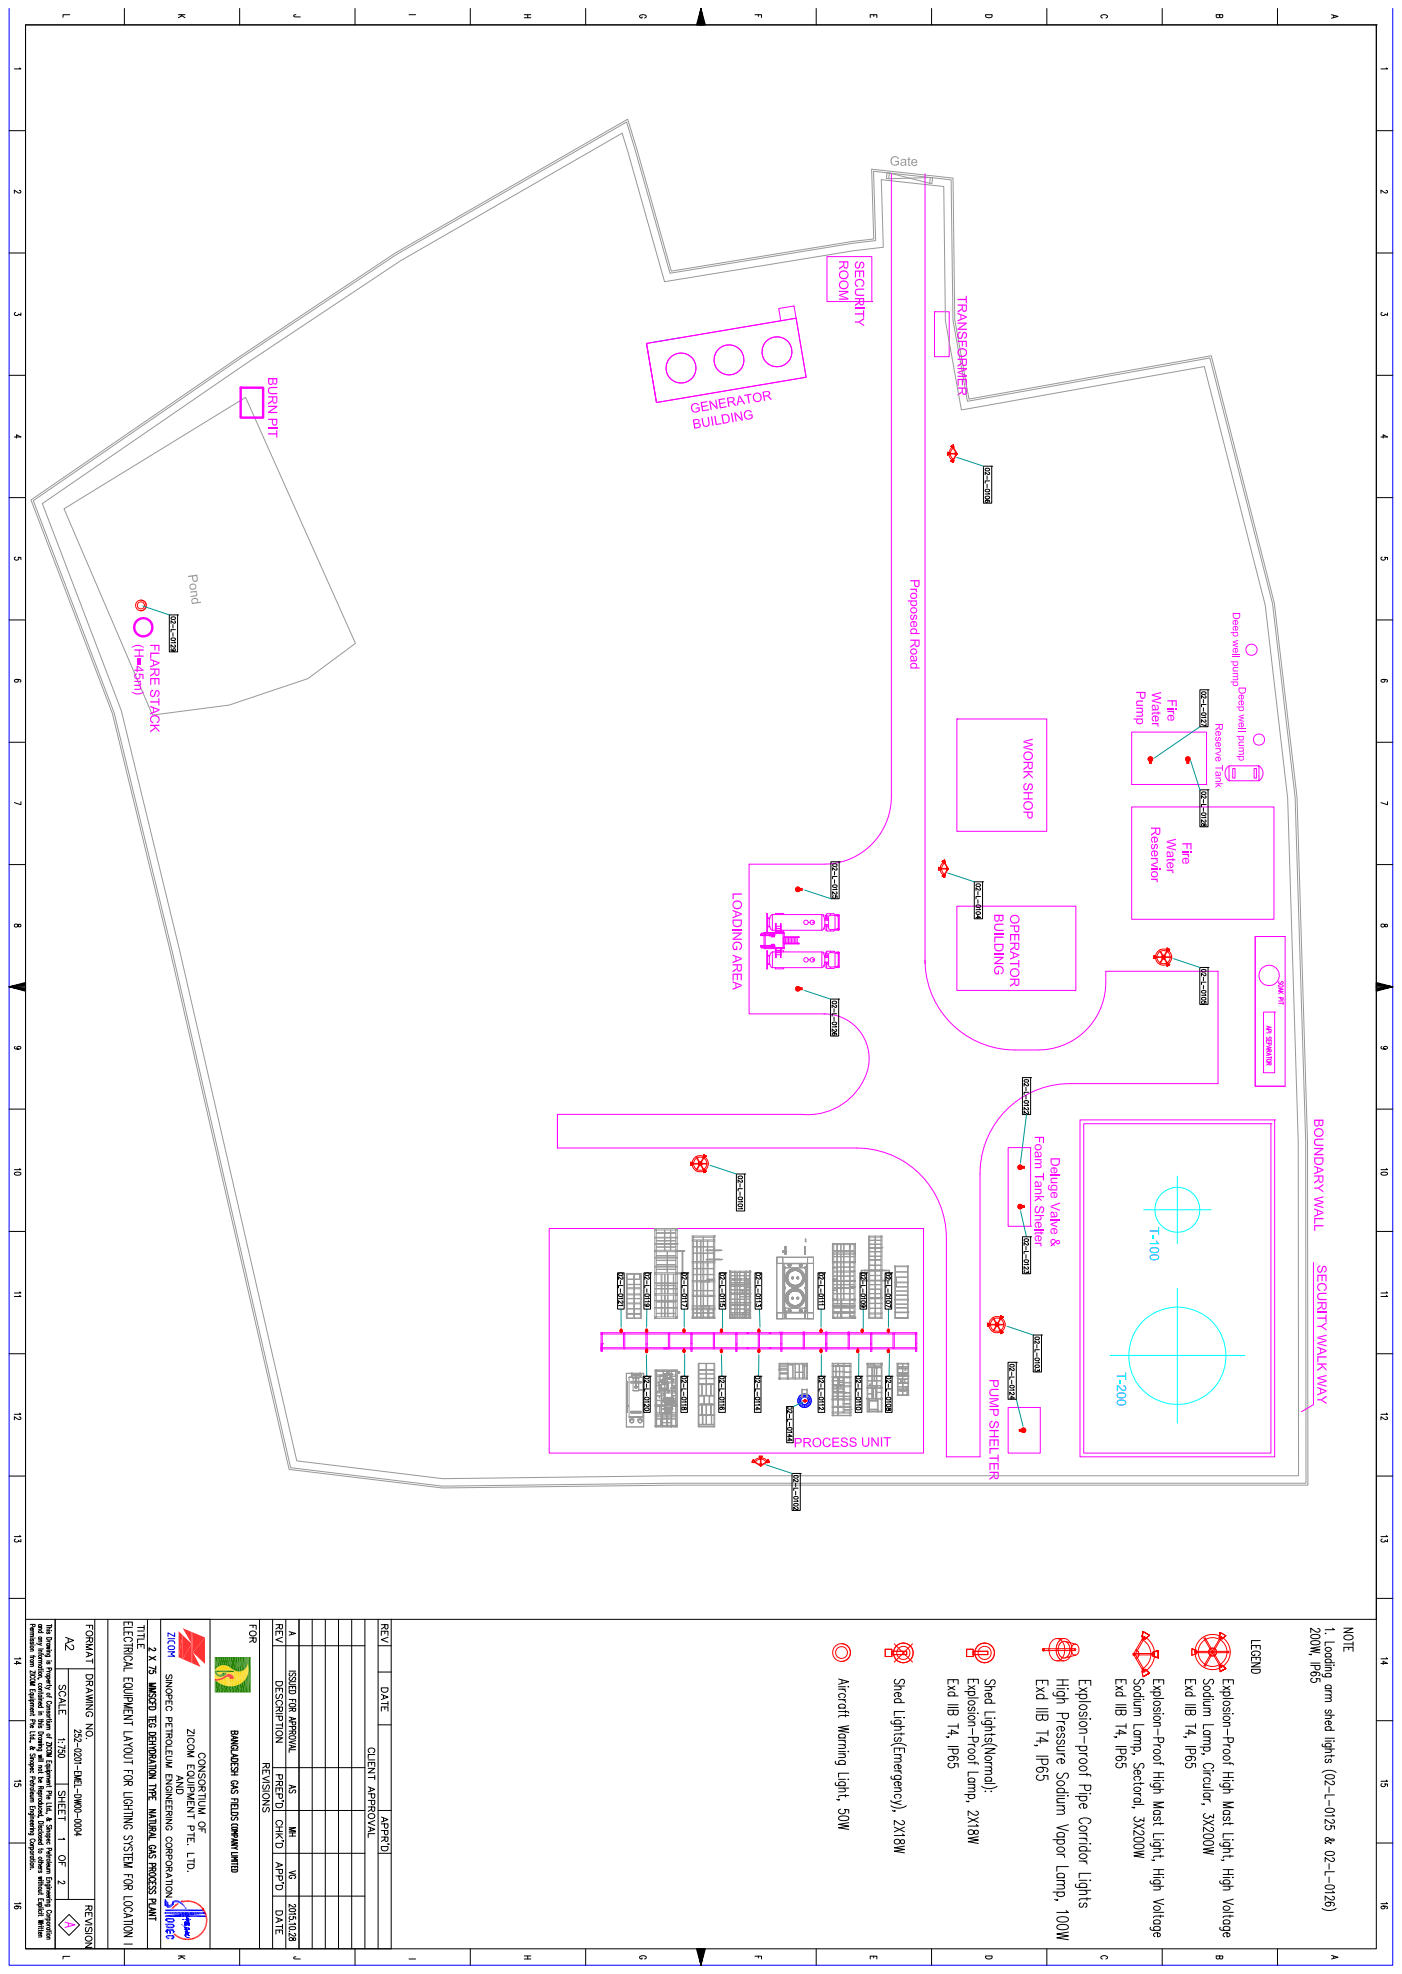
[picture p37: page 20]

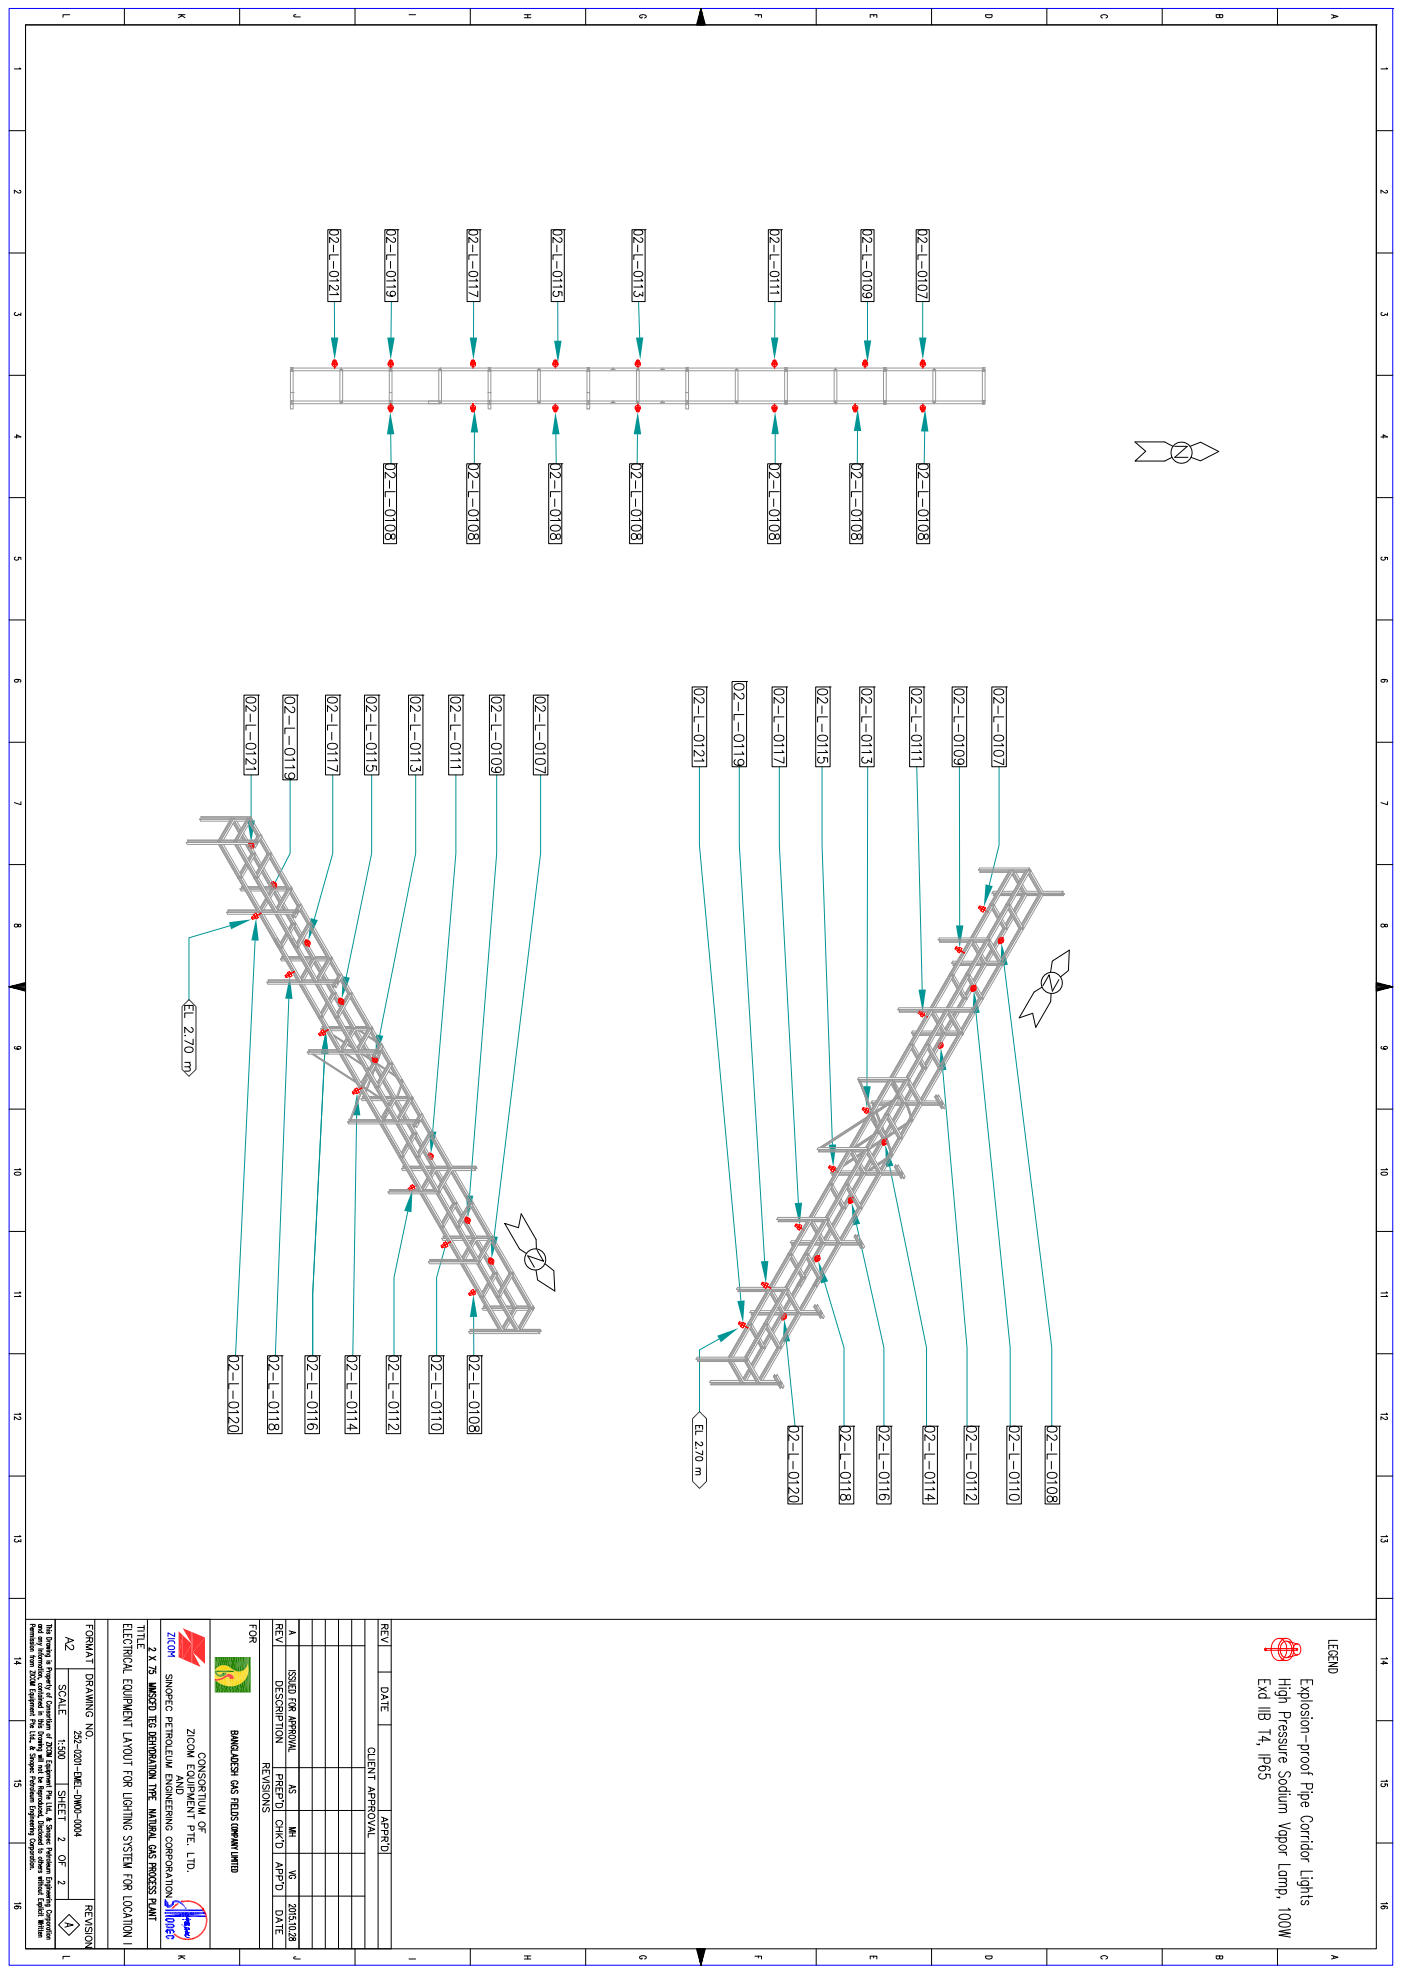
[picture p38: page 21]

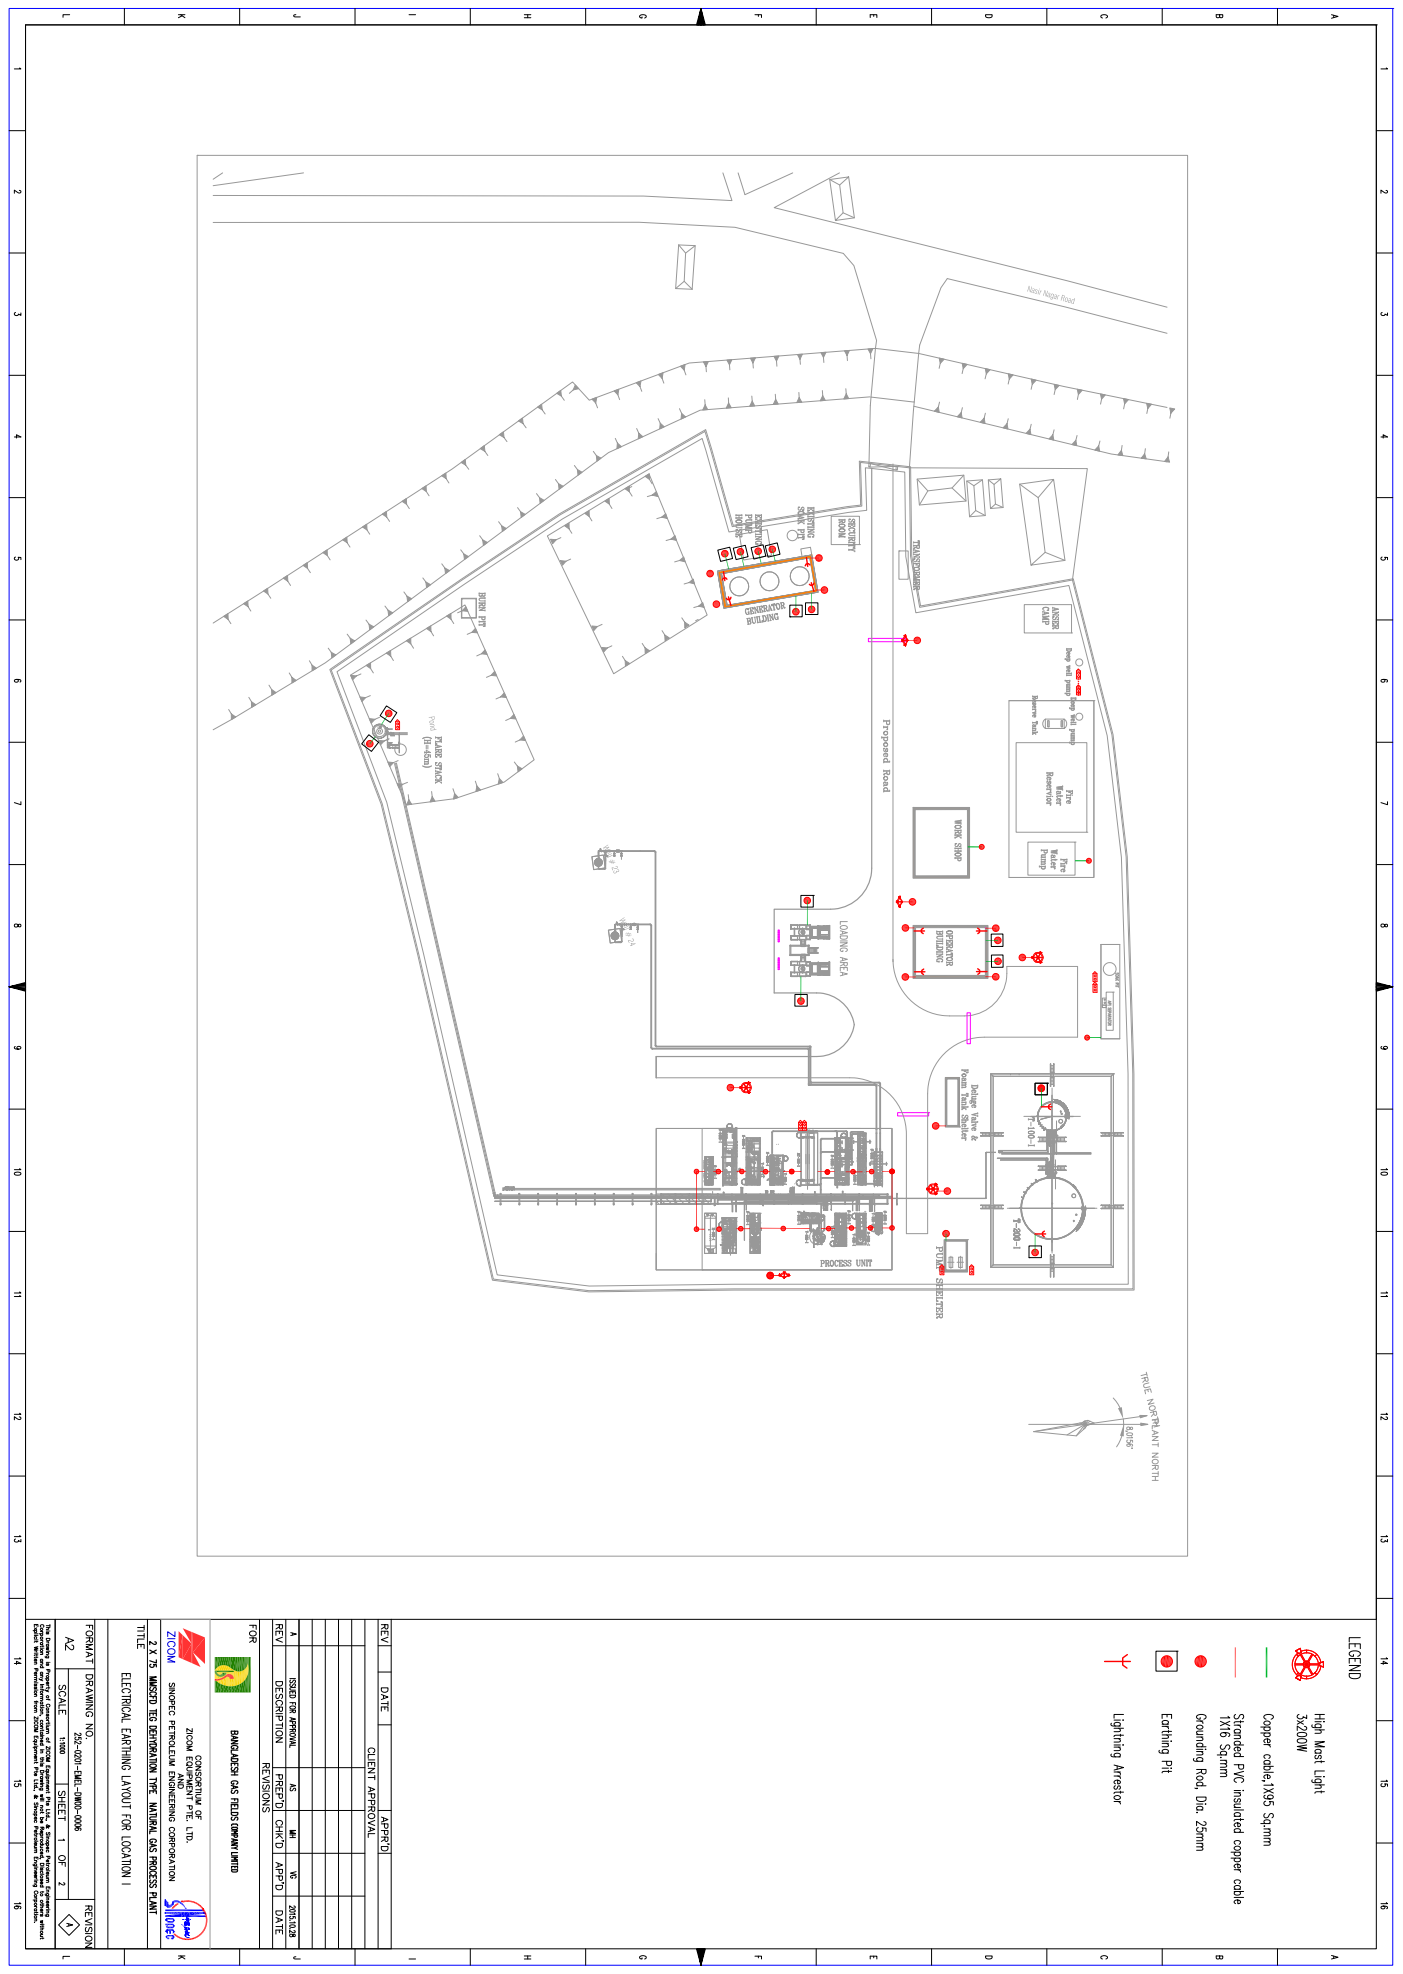
[picture p39: page 22]

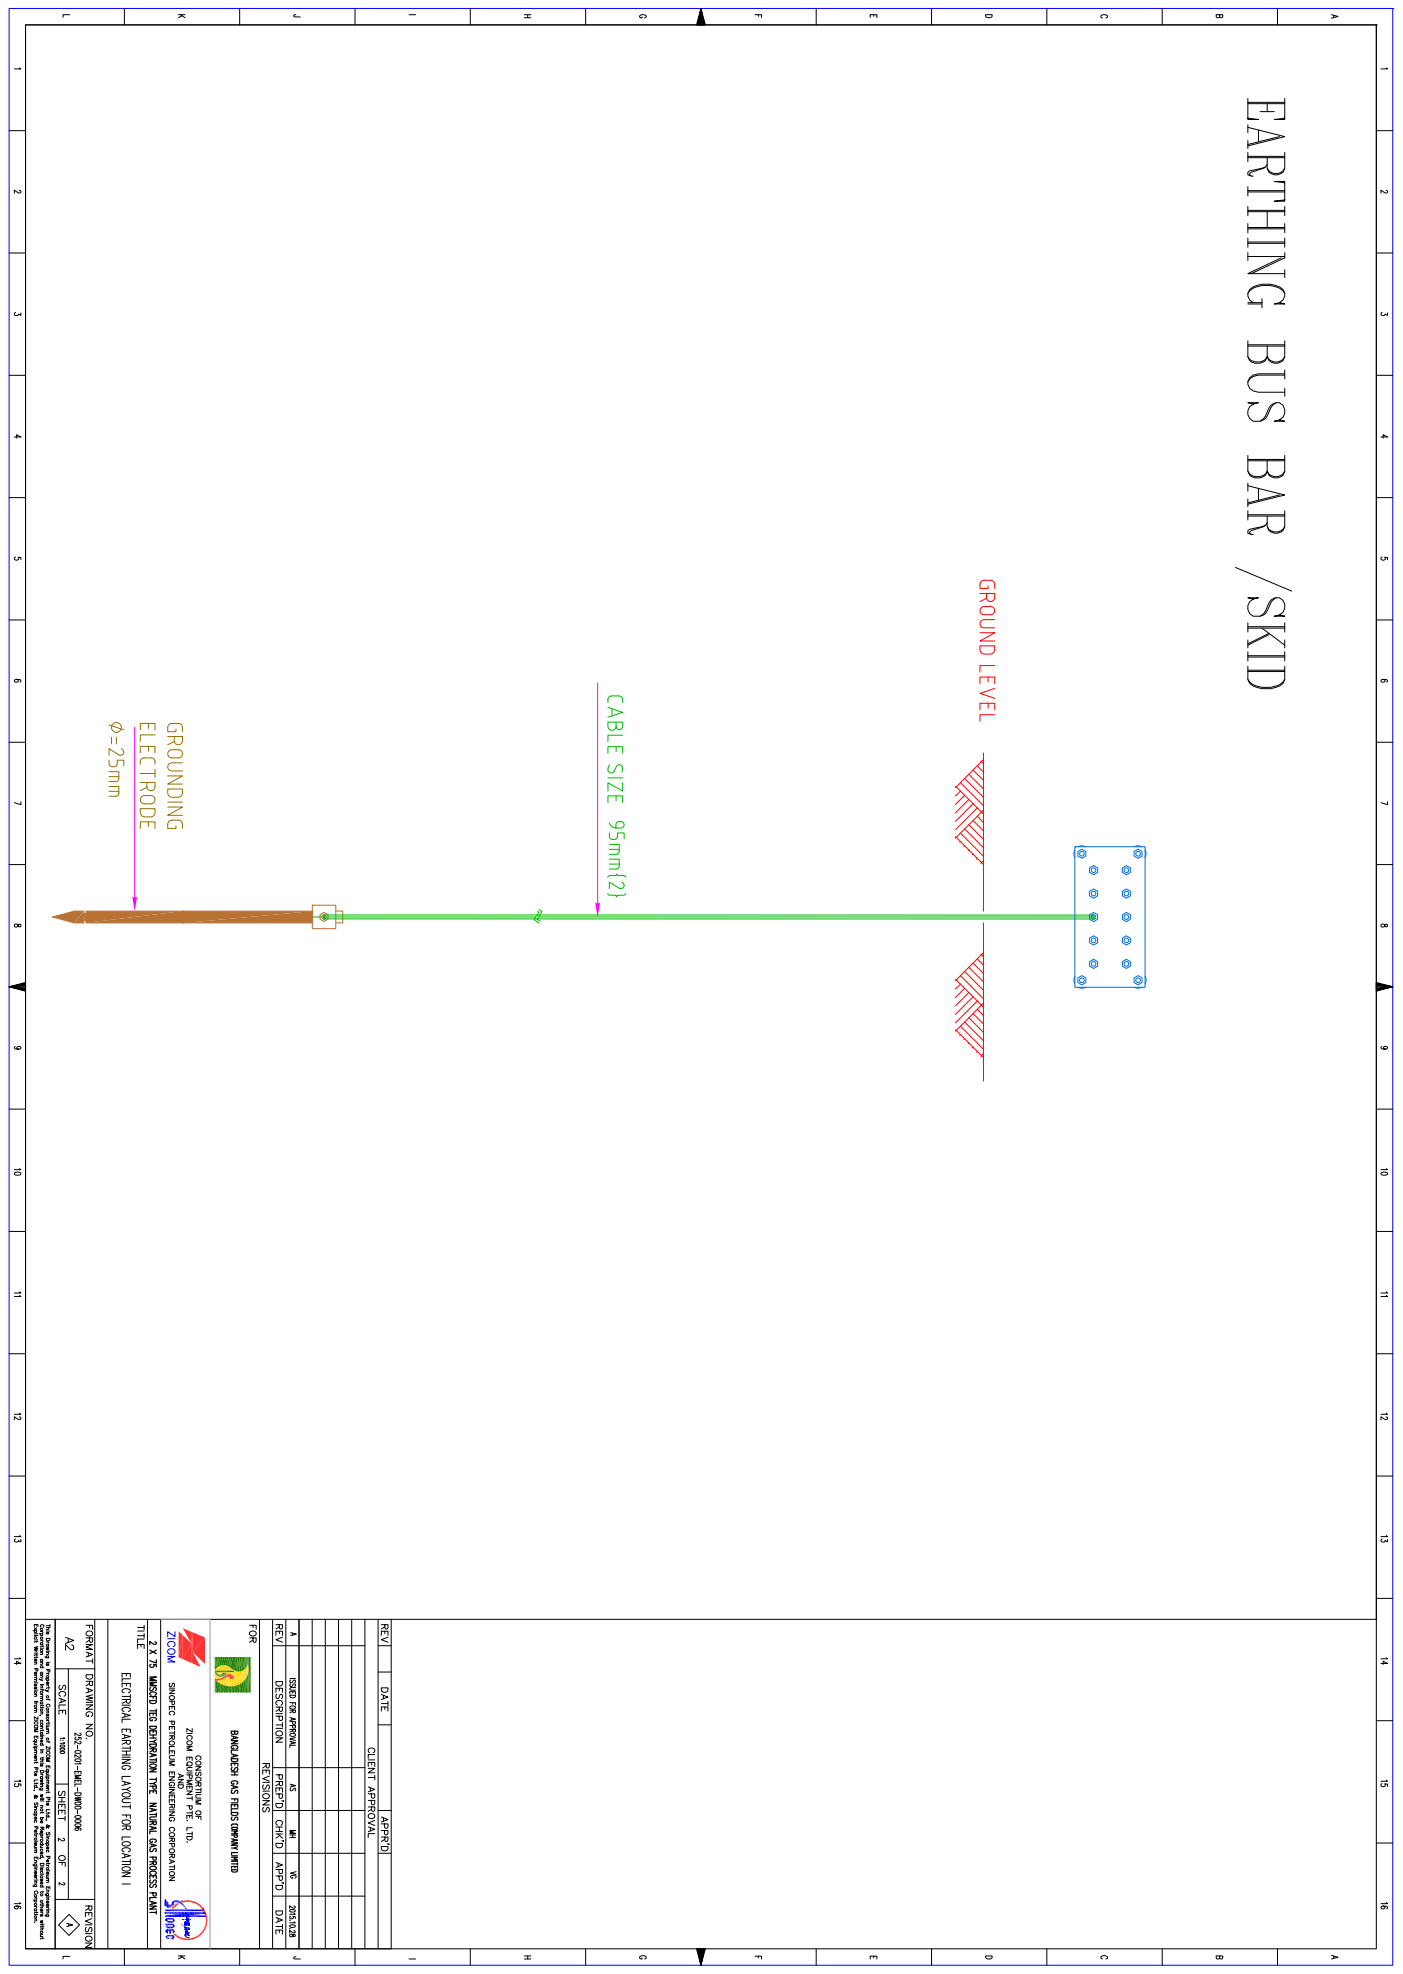
[picture p40: page 23]

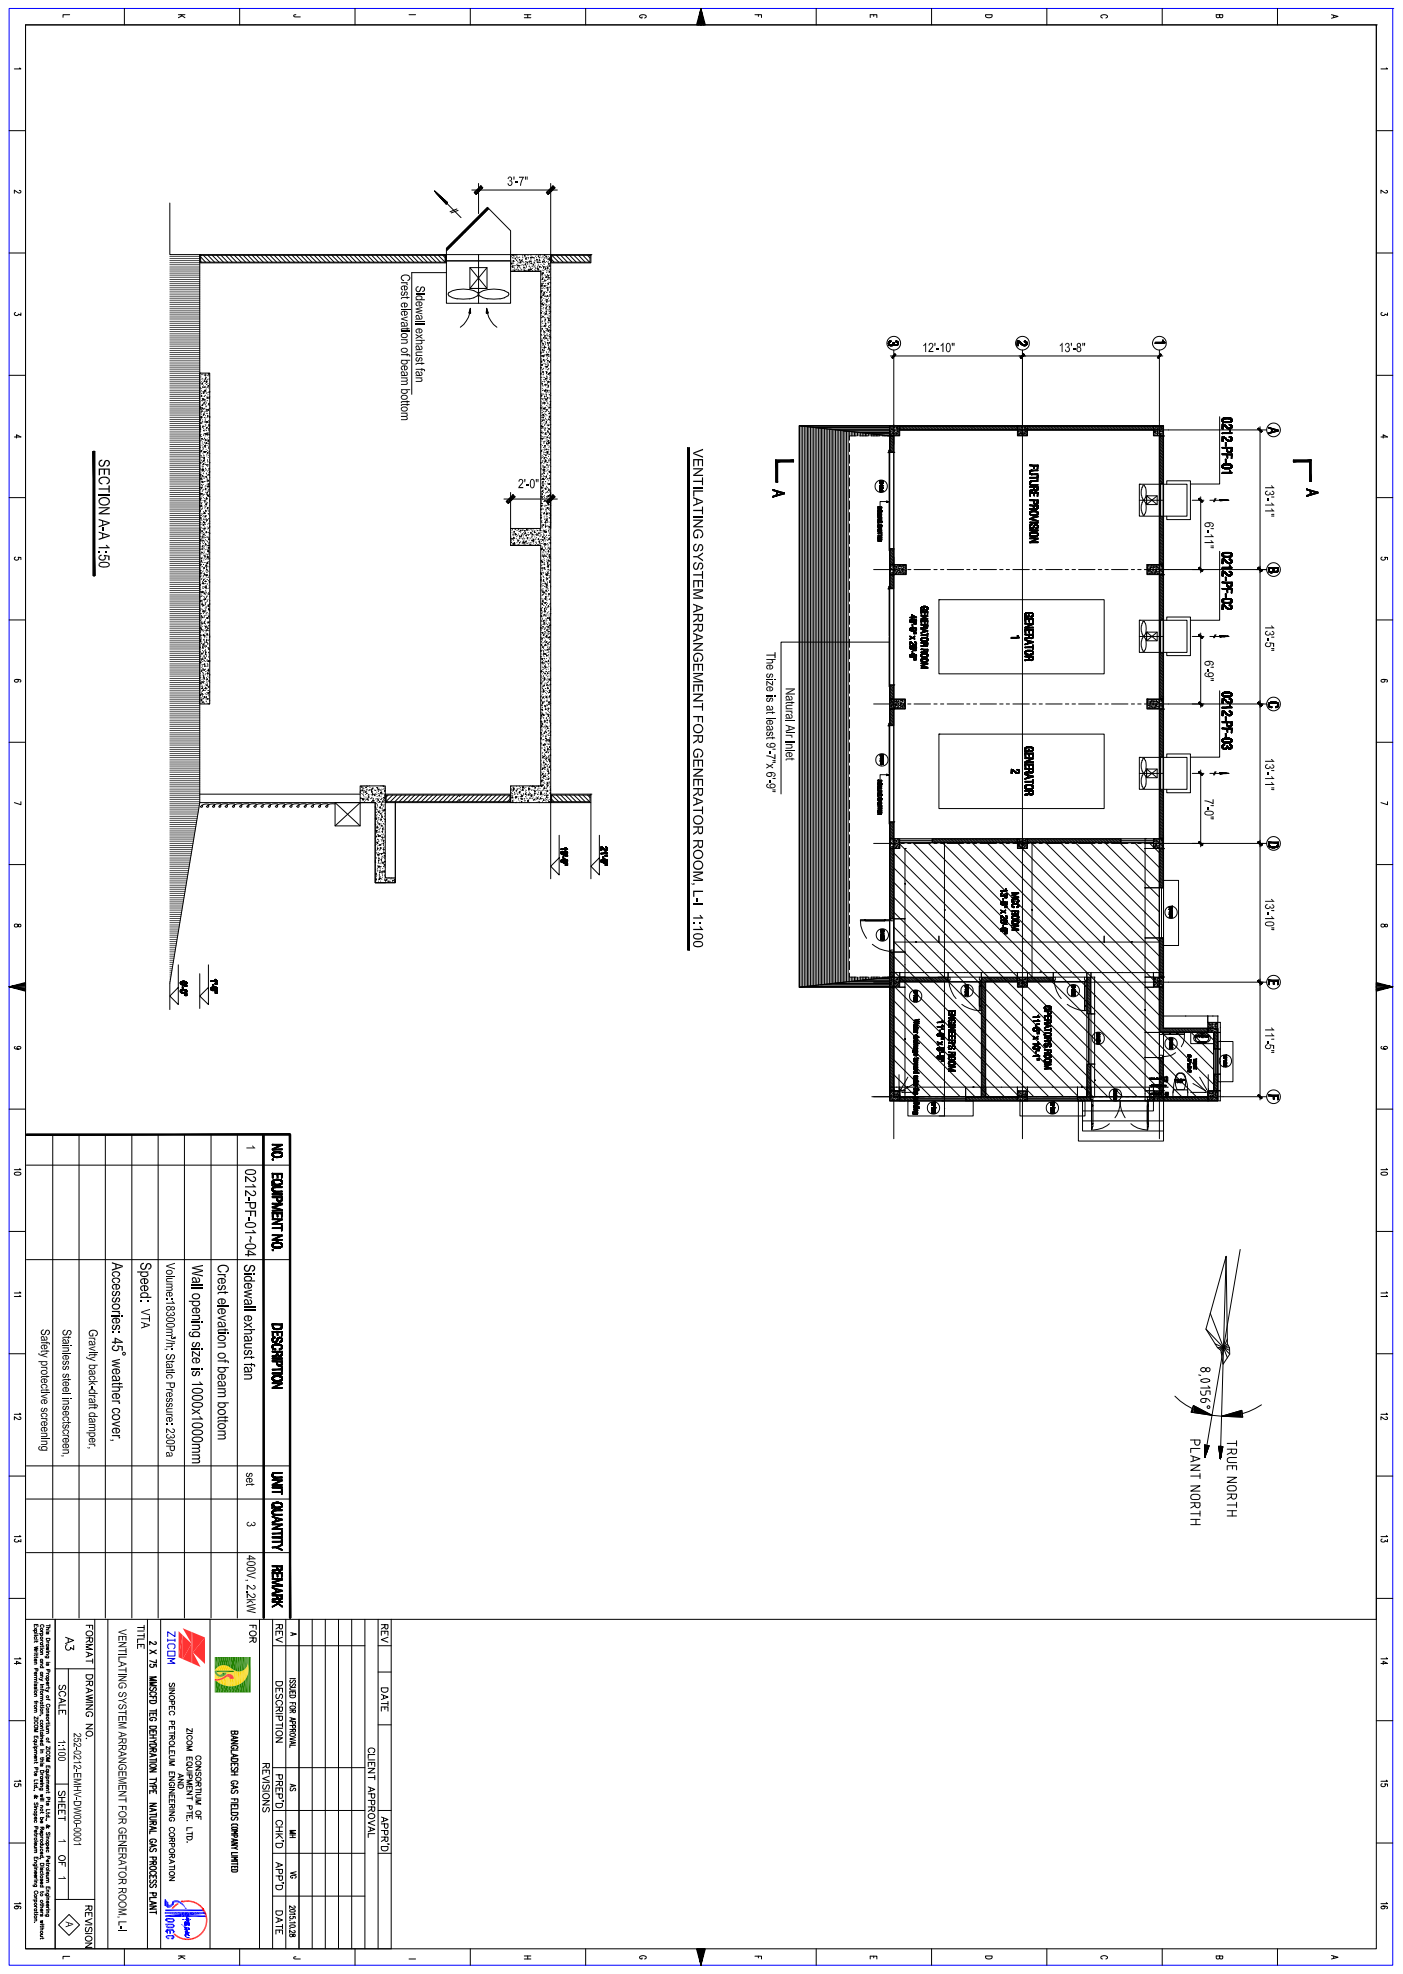
[picture p41: page 24]
