skdzicombd/P_252_Documentation/Location J/P_252 Location J Drawing Binder.pdf

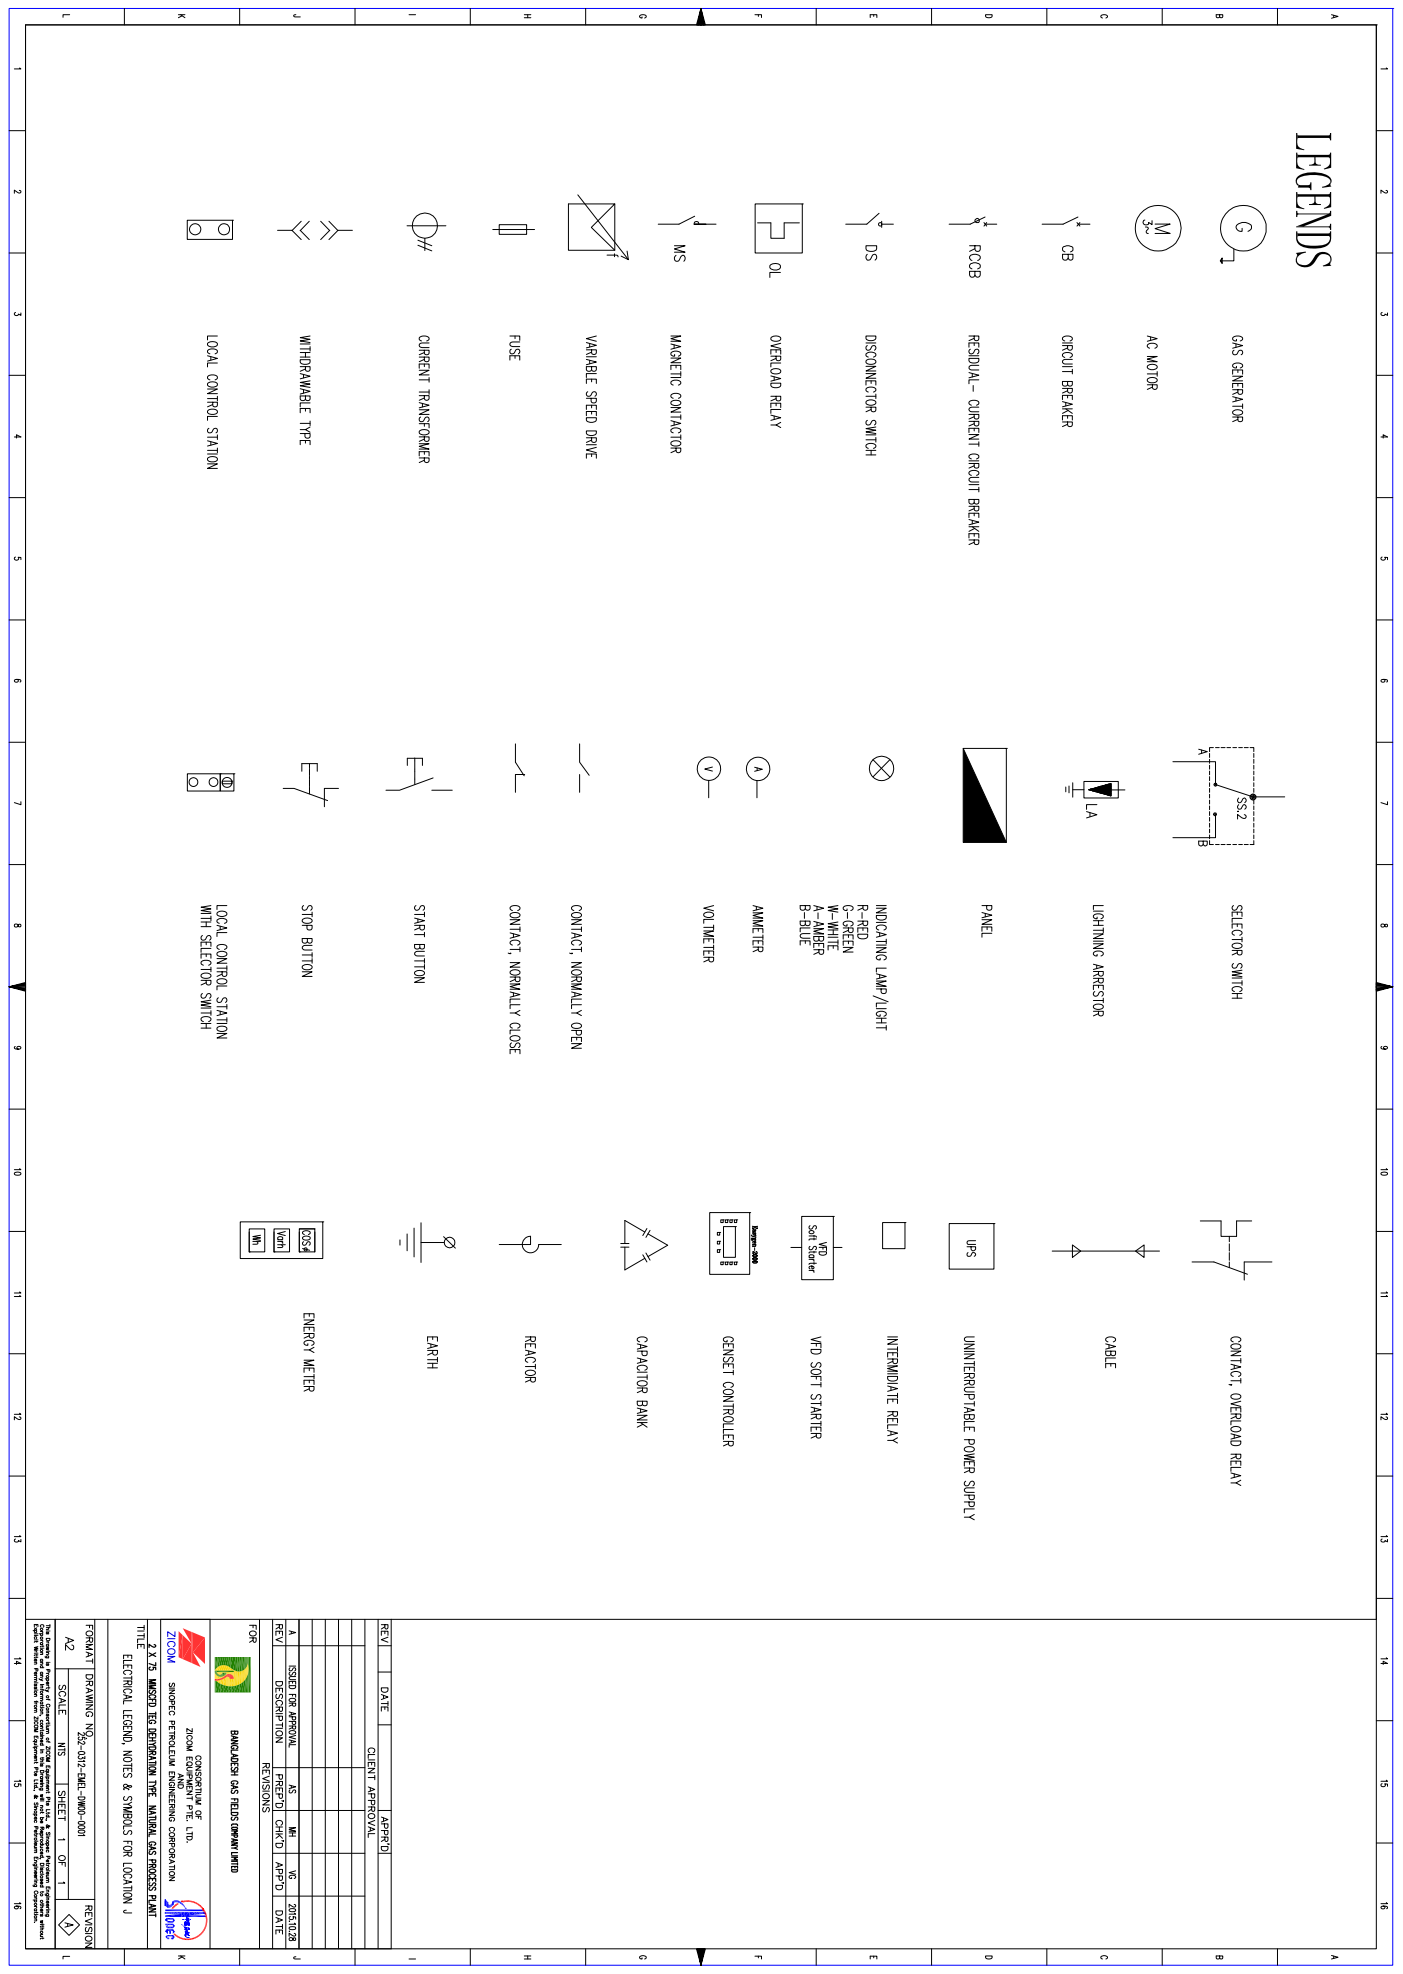
[picture p42: page 1]

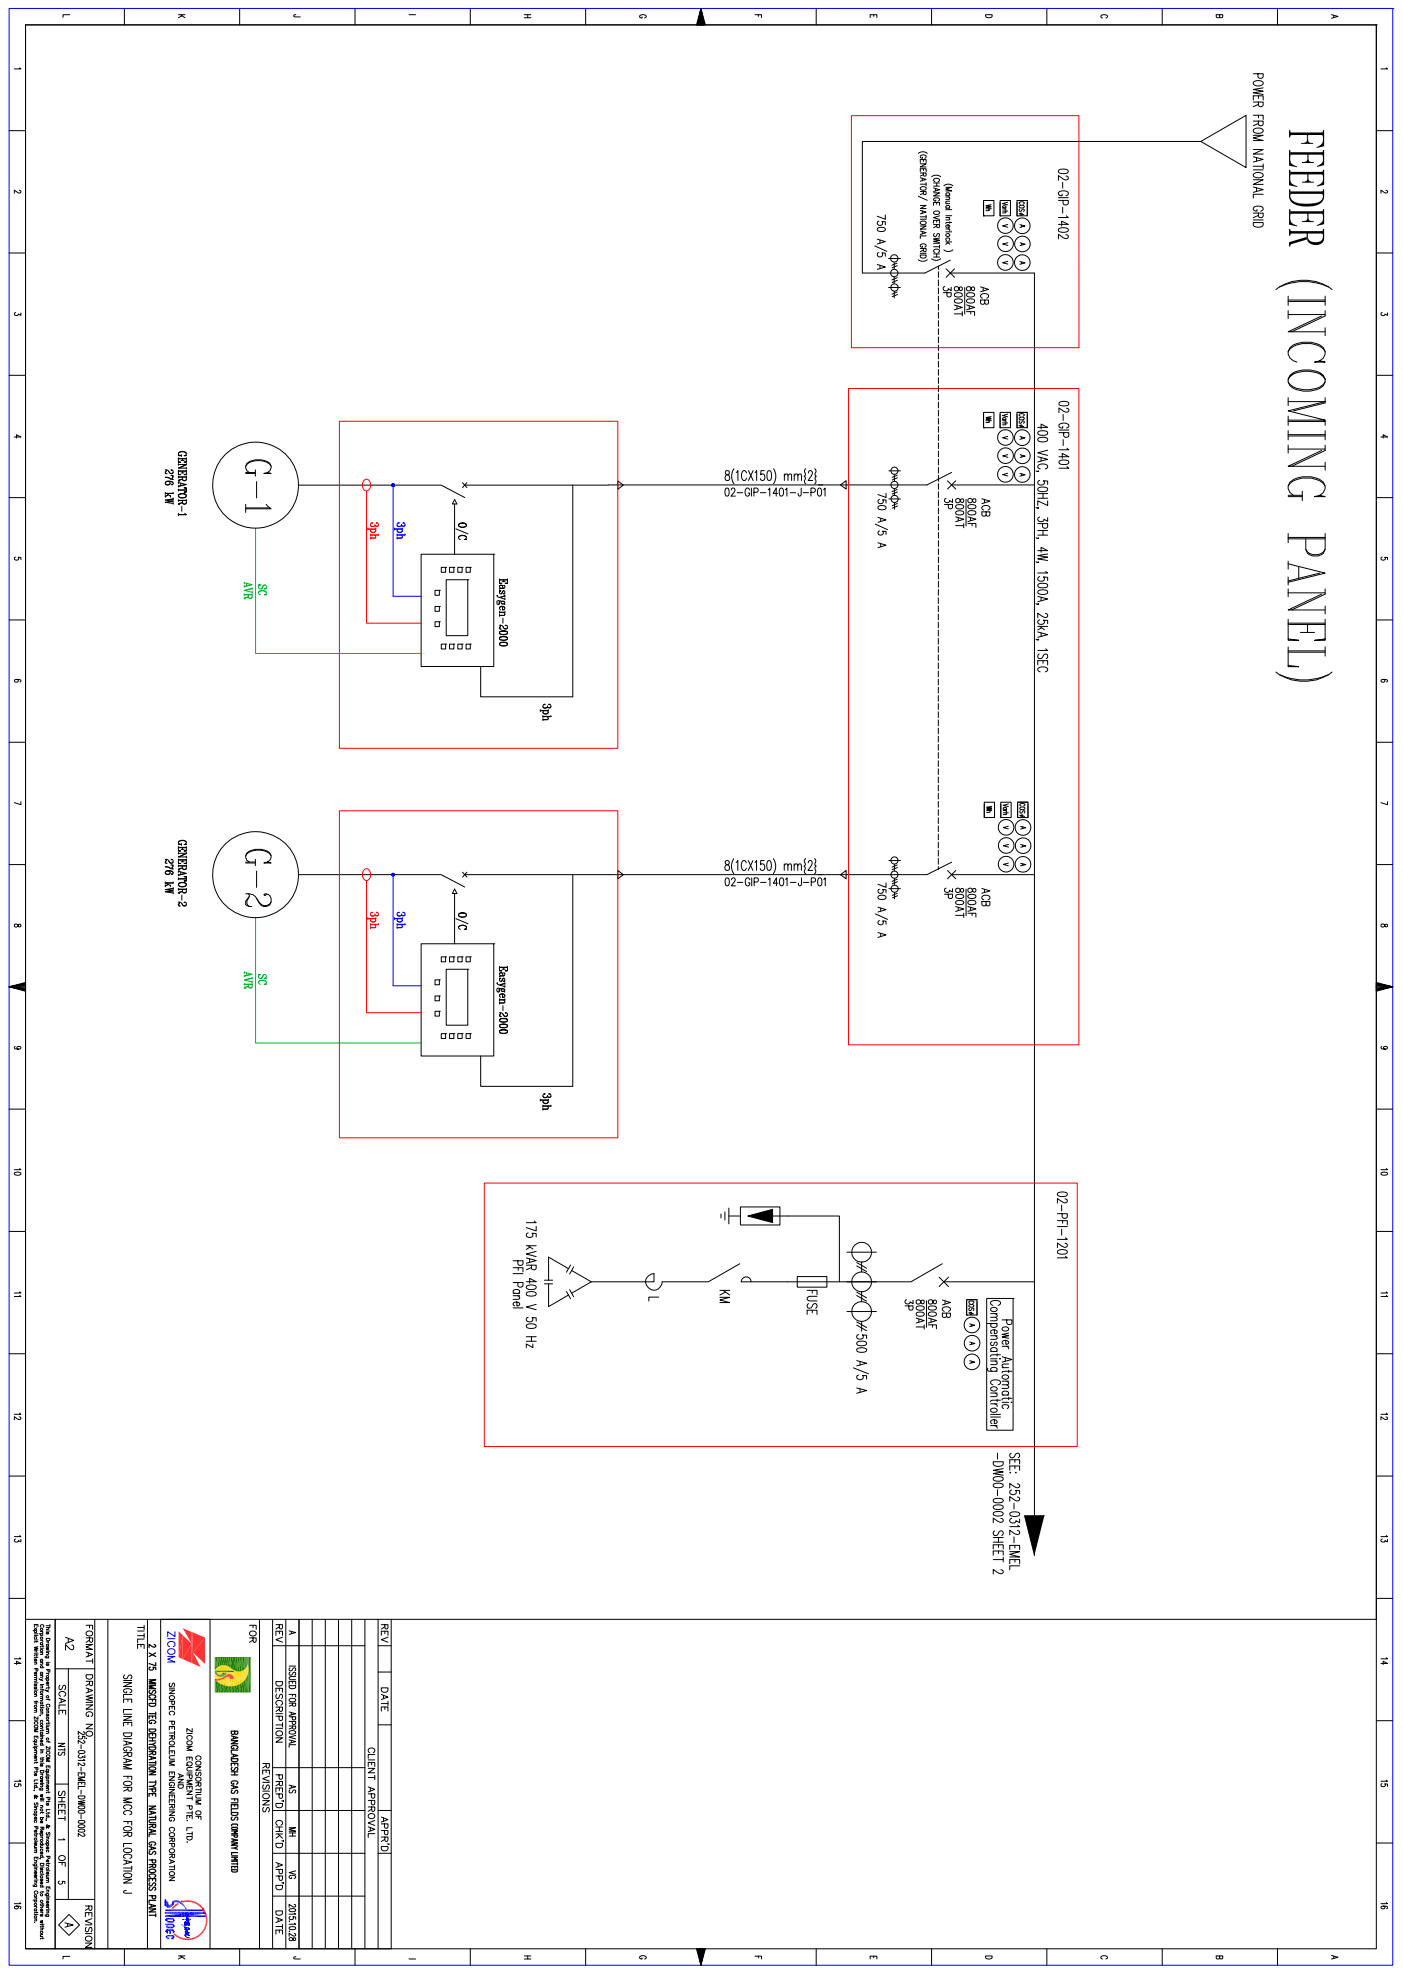
[picture p43: page 2]

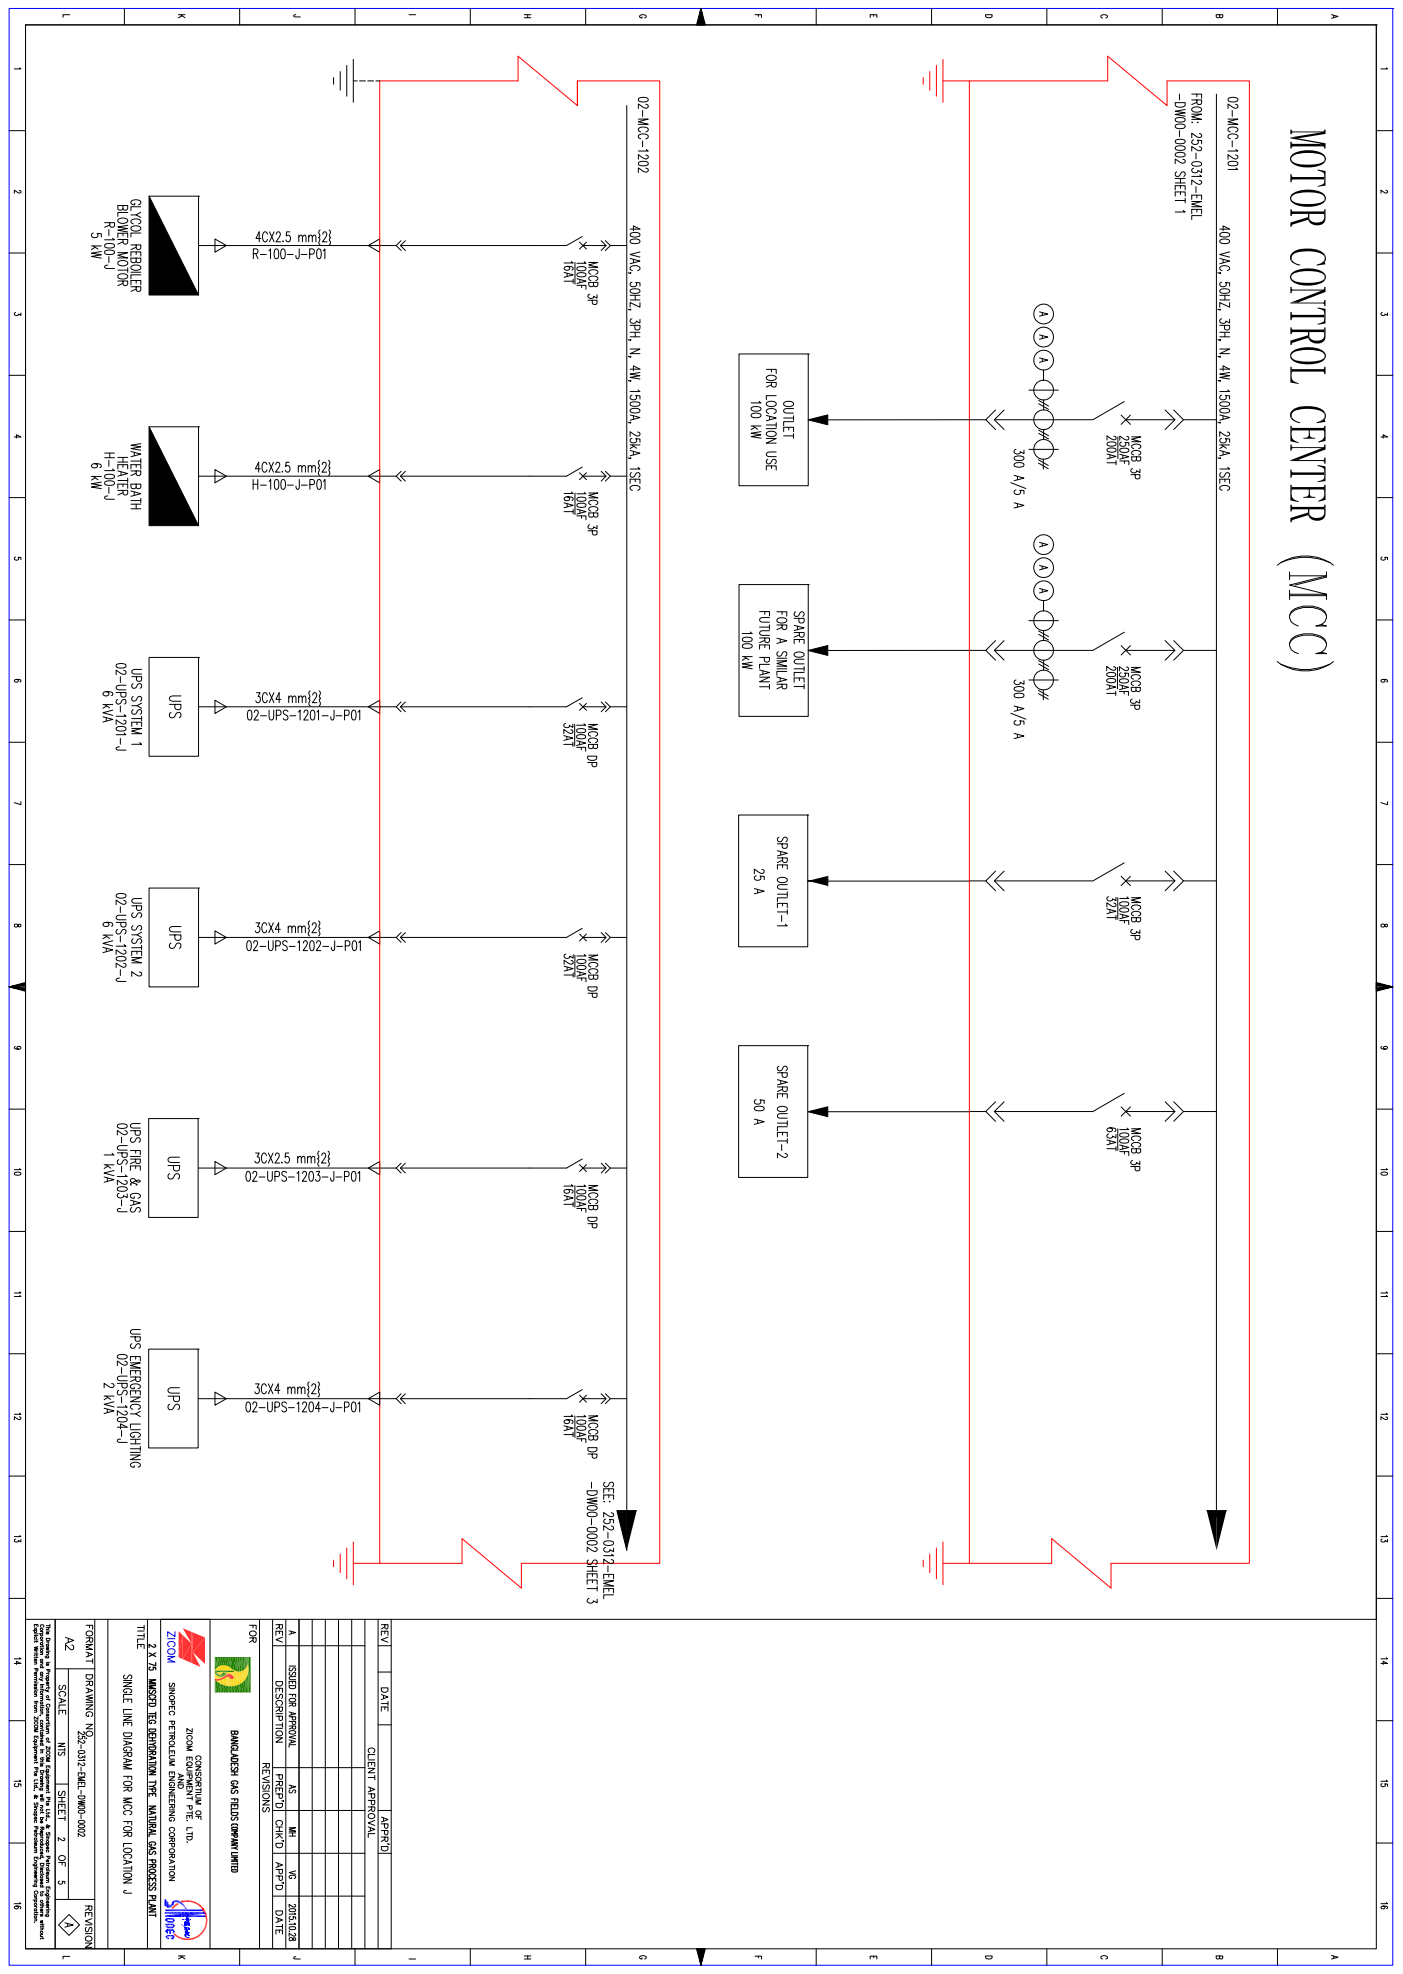
[picture p44: page 3]

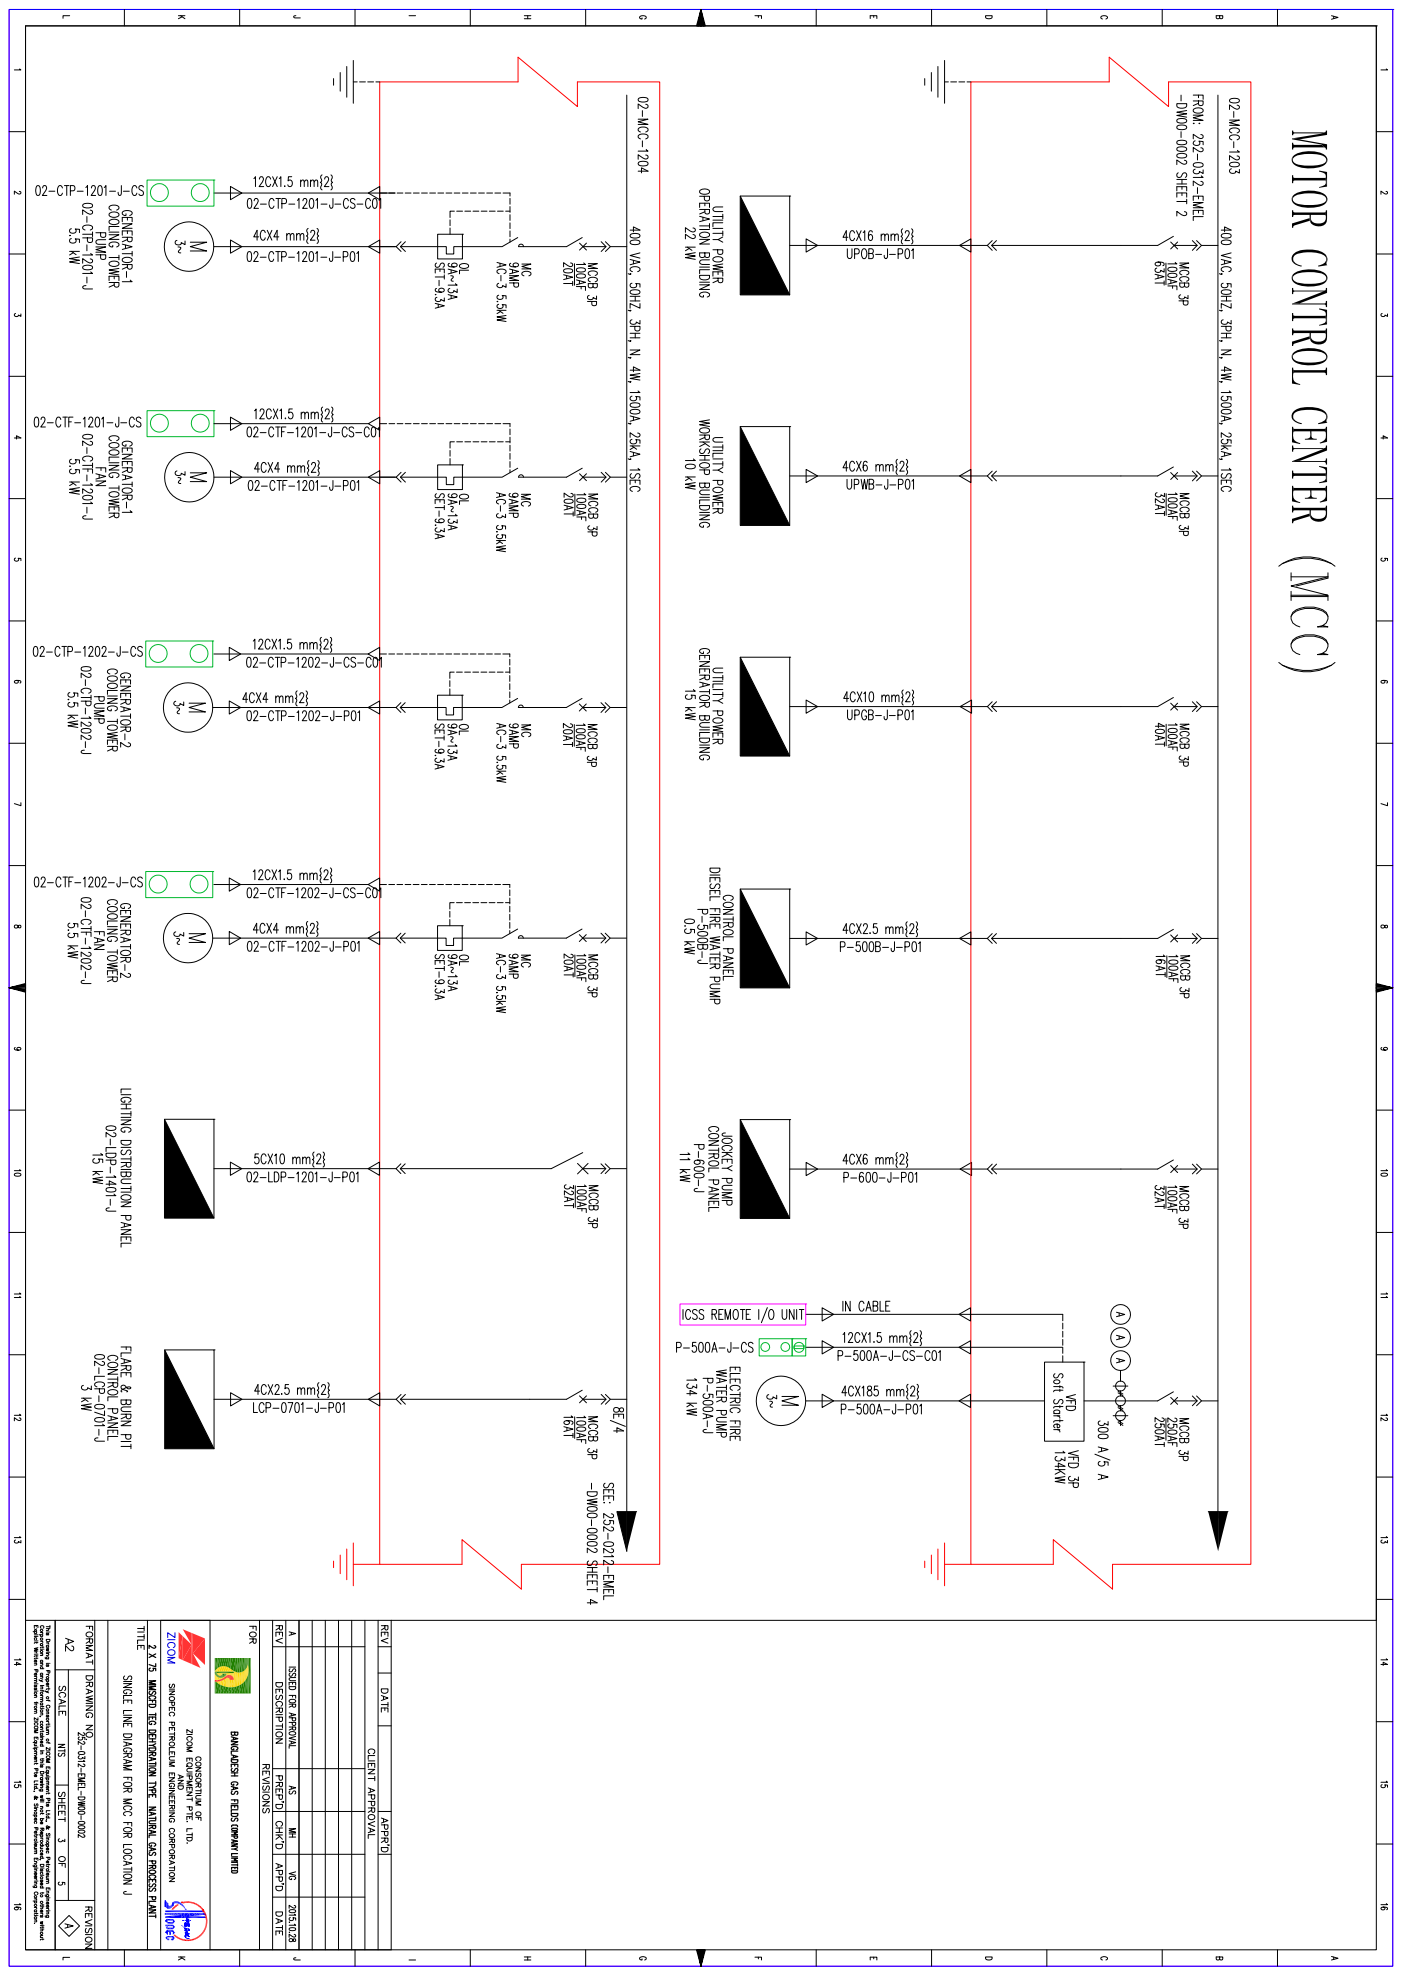
[picture p45: page 4]

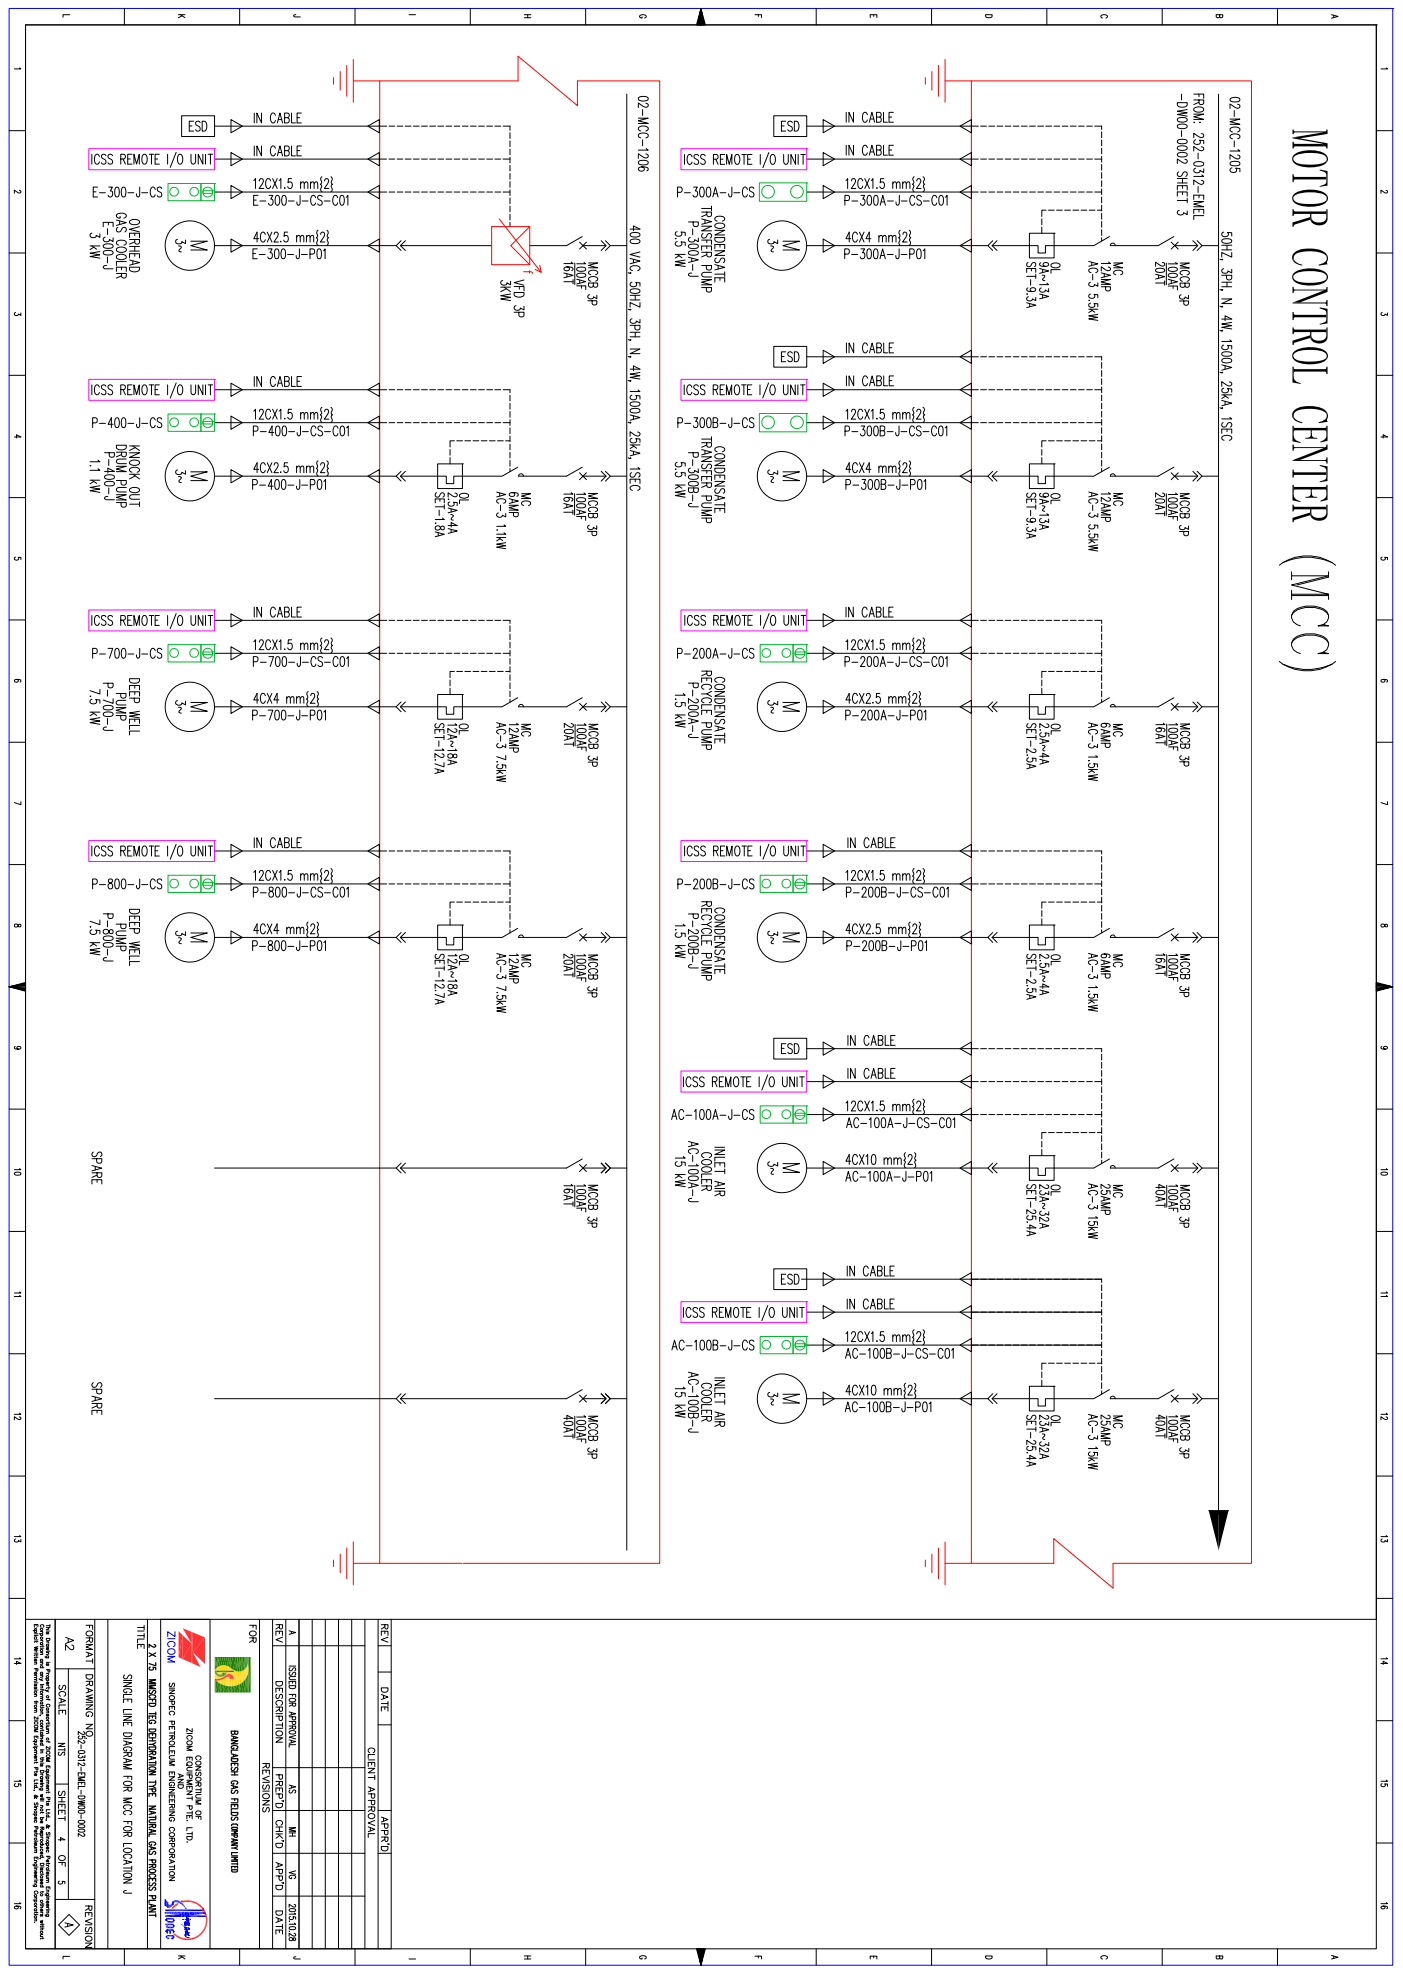
[picture p46: page 5]

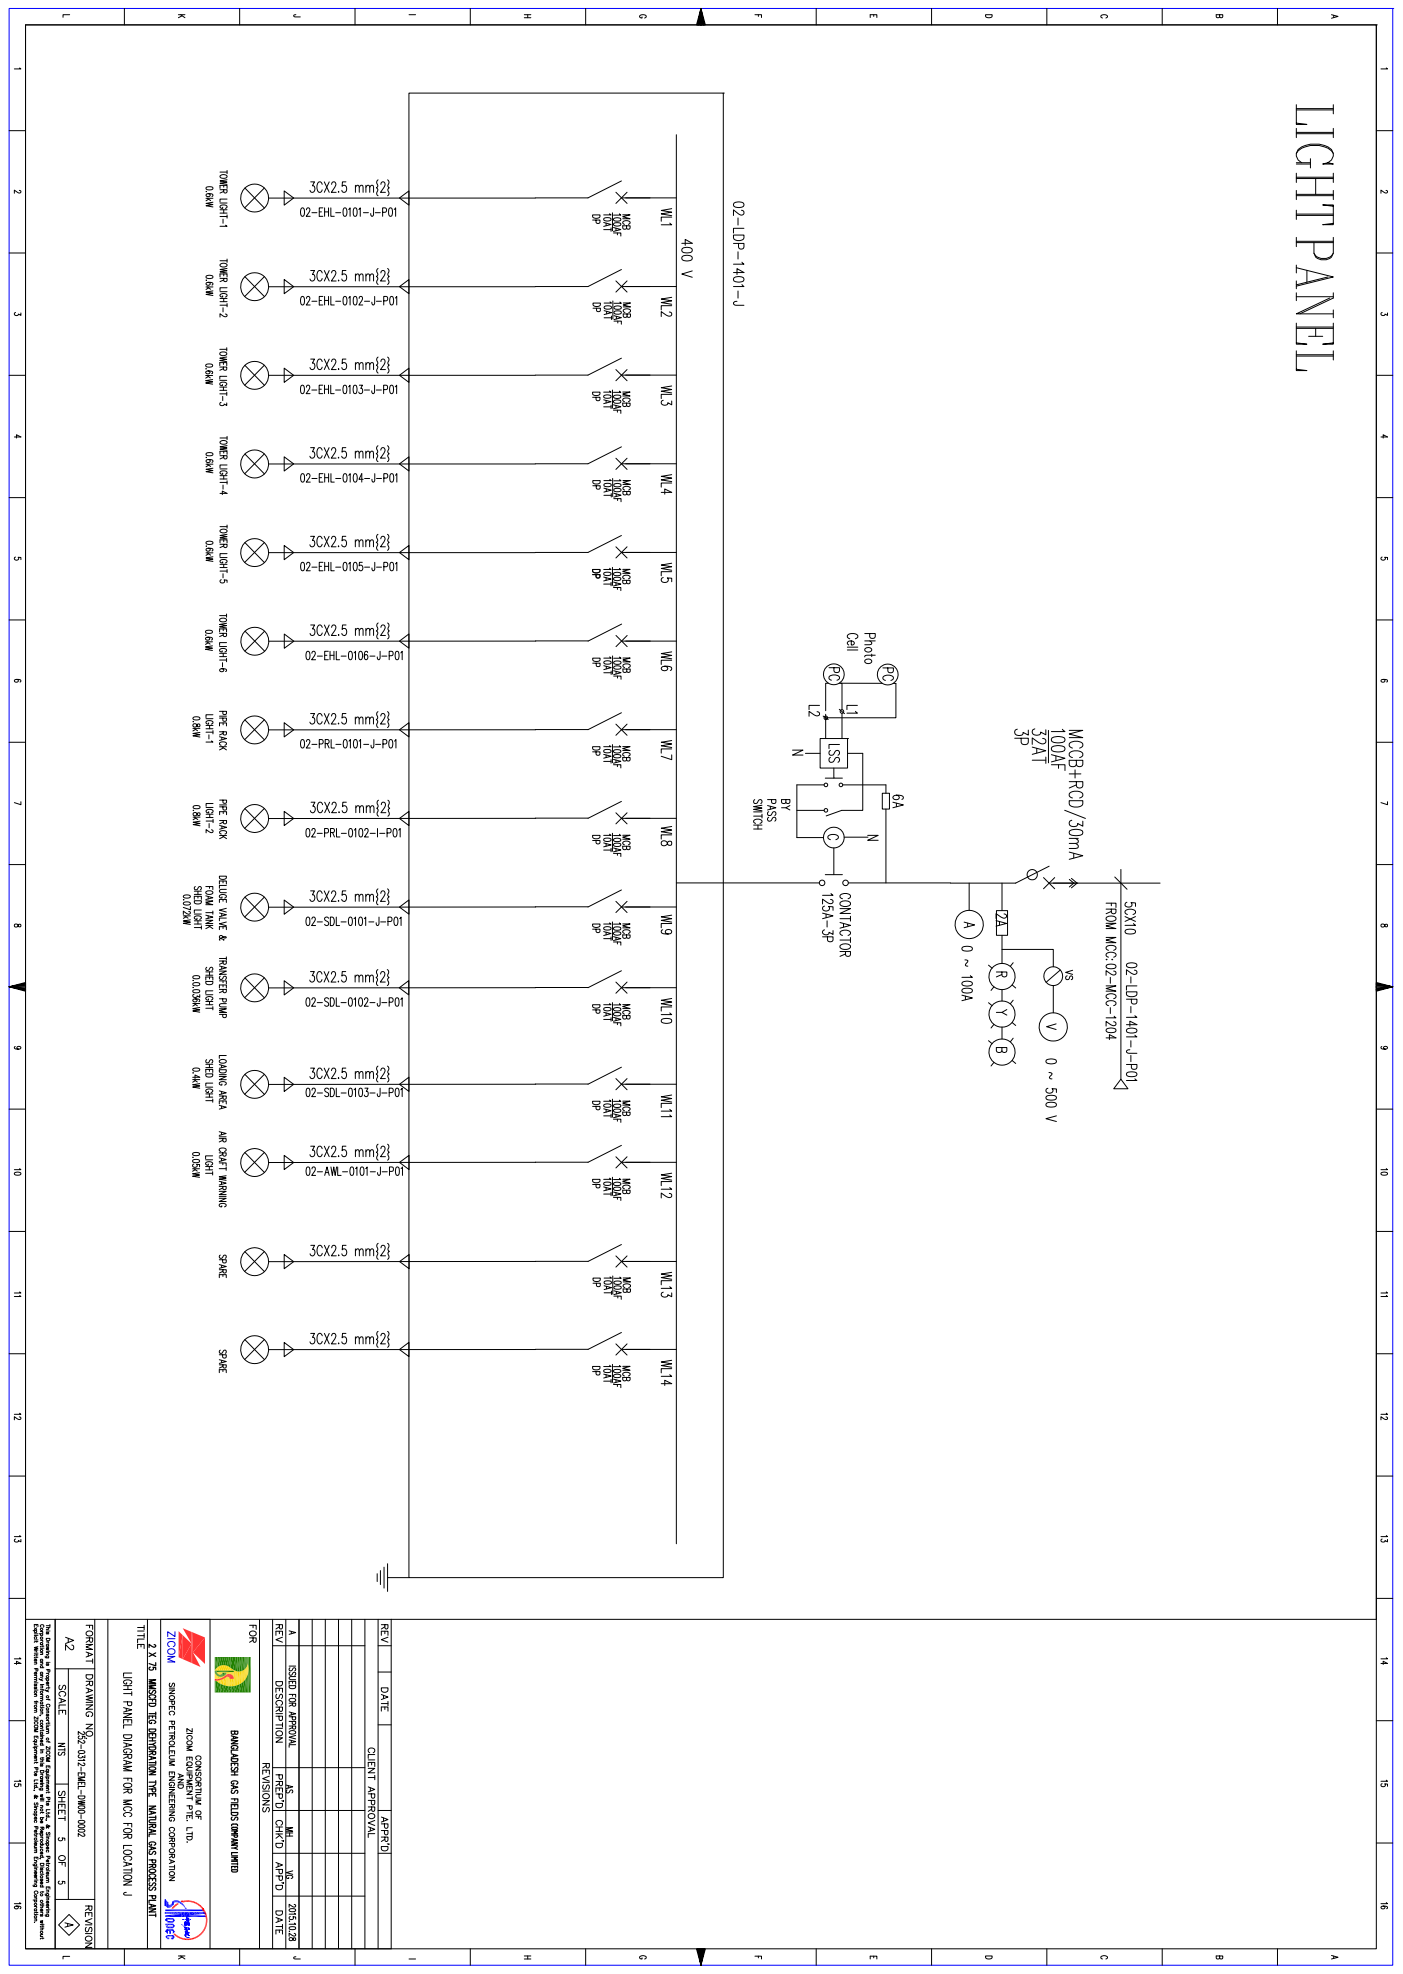
[picture p47: page 6]

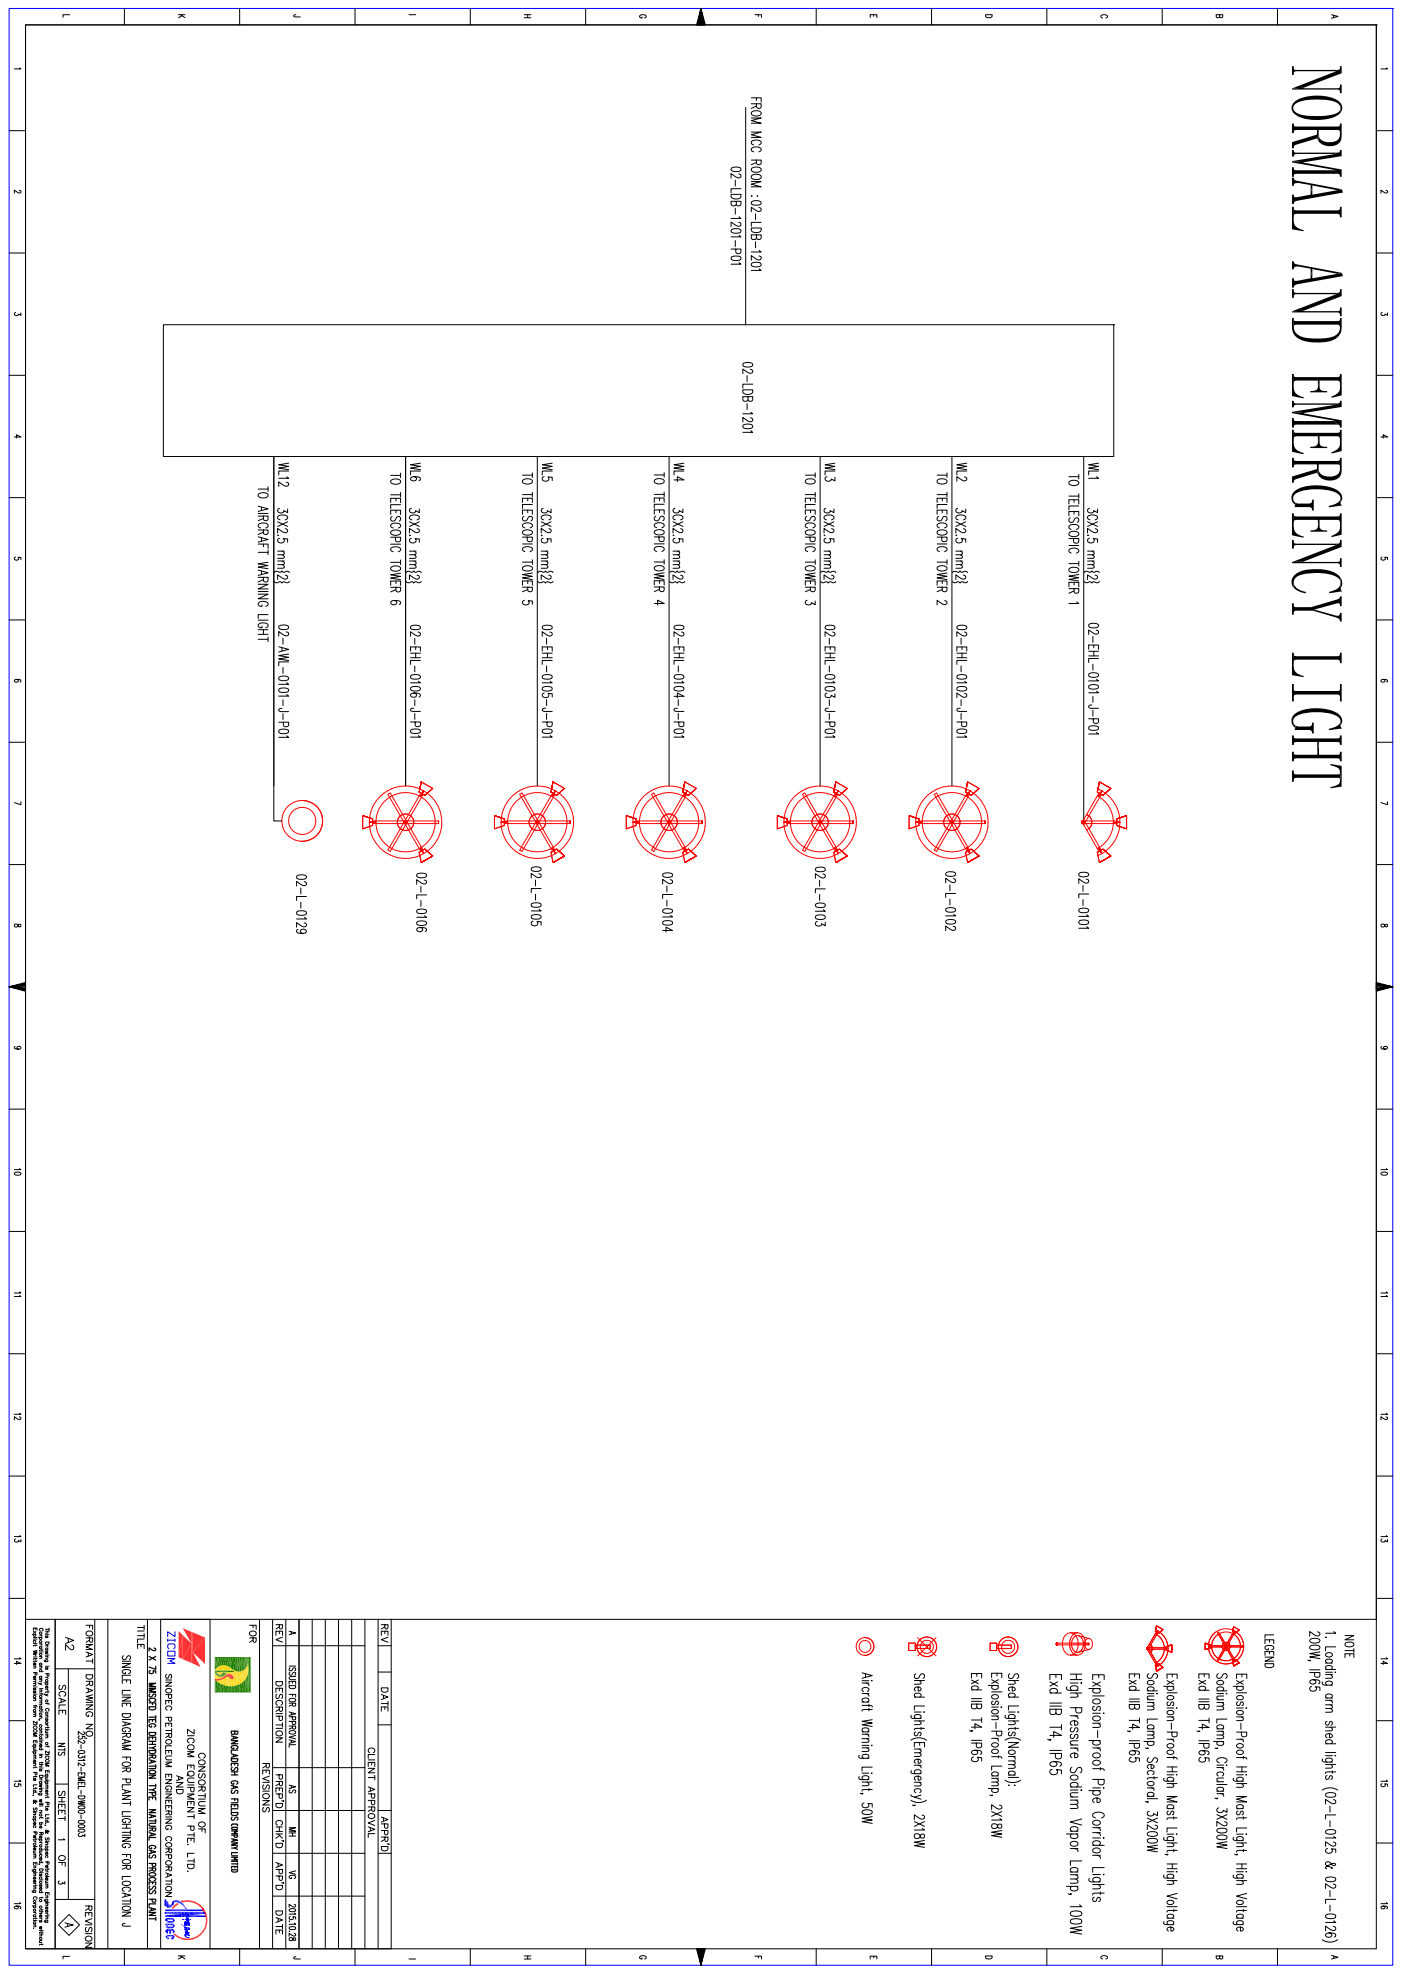
[picture p48: page 7]

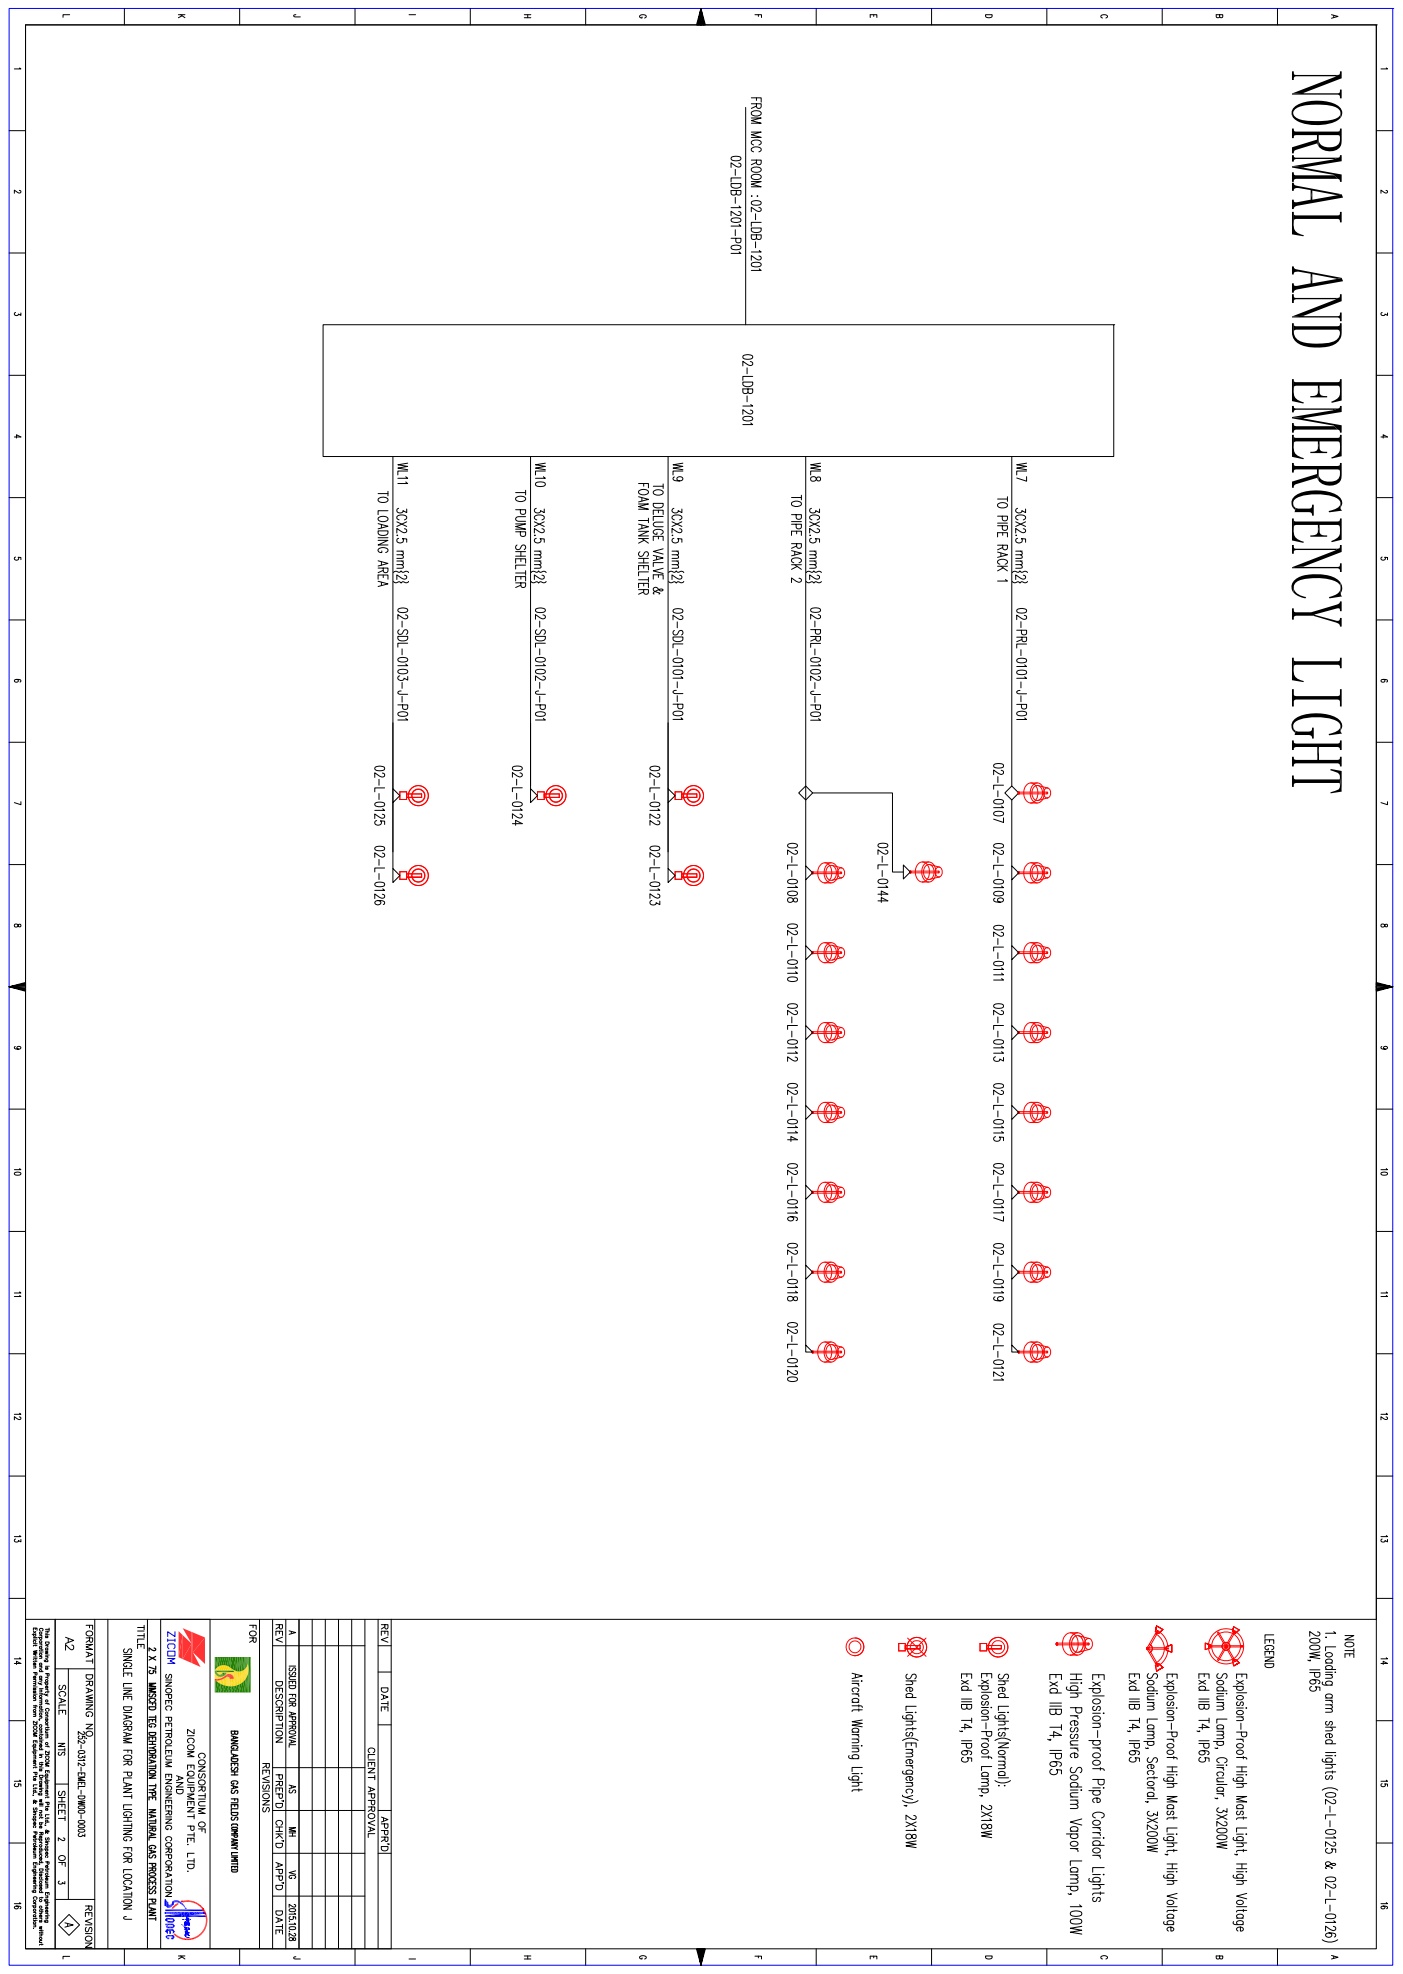
[picture p49: page 8]

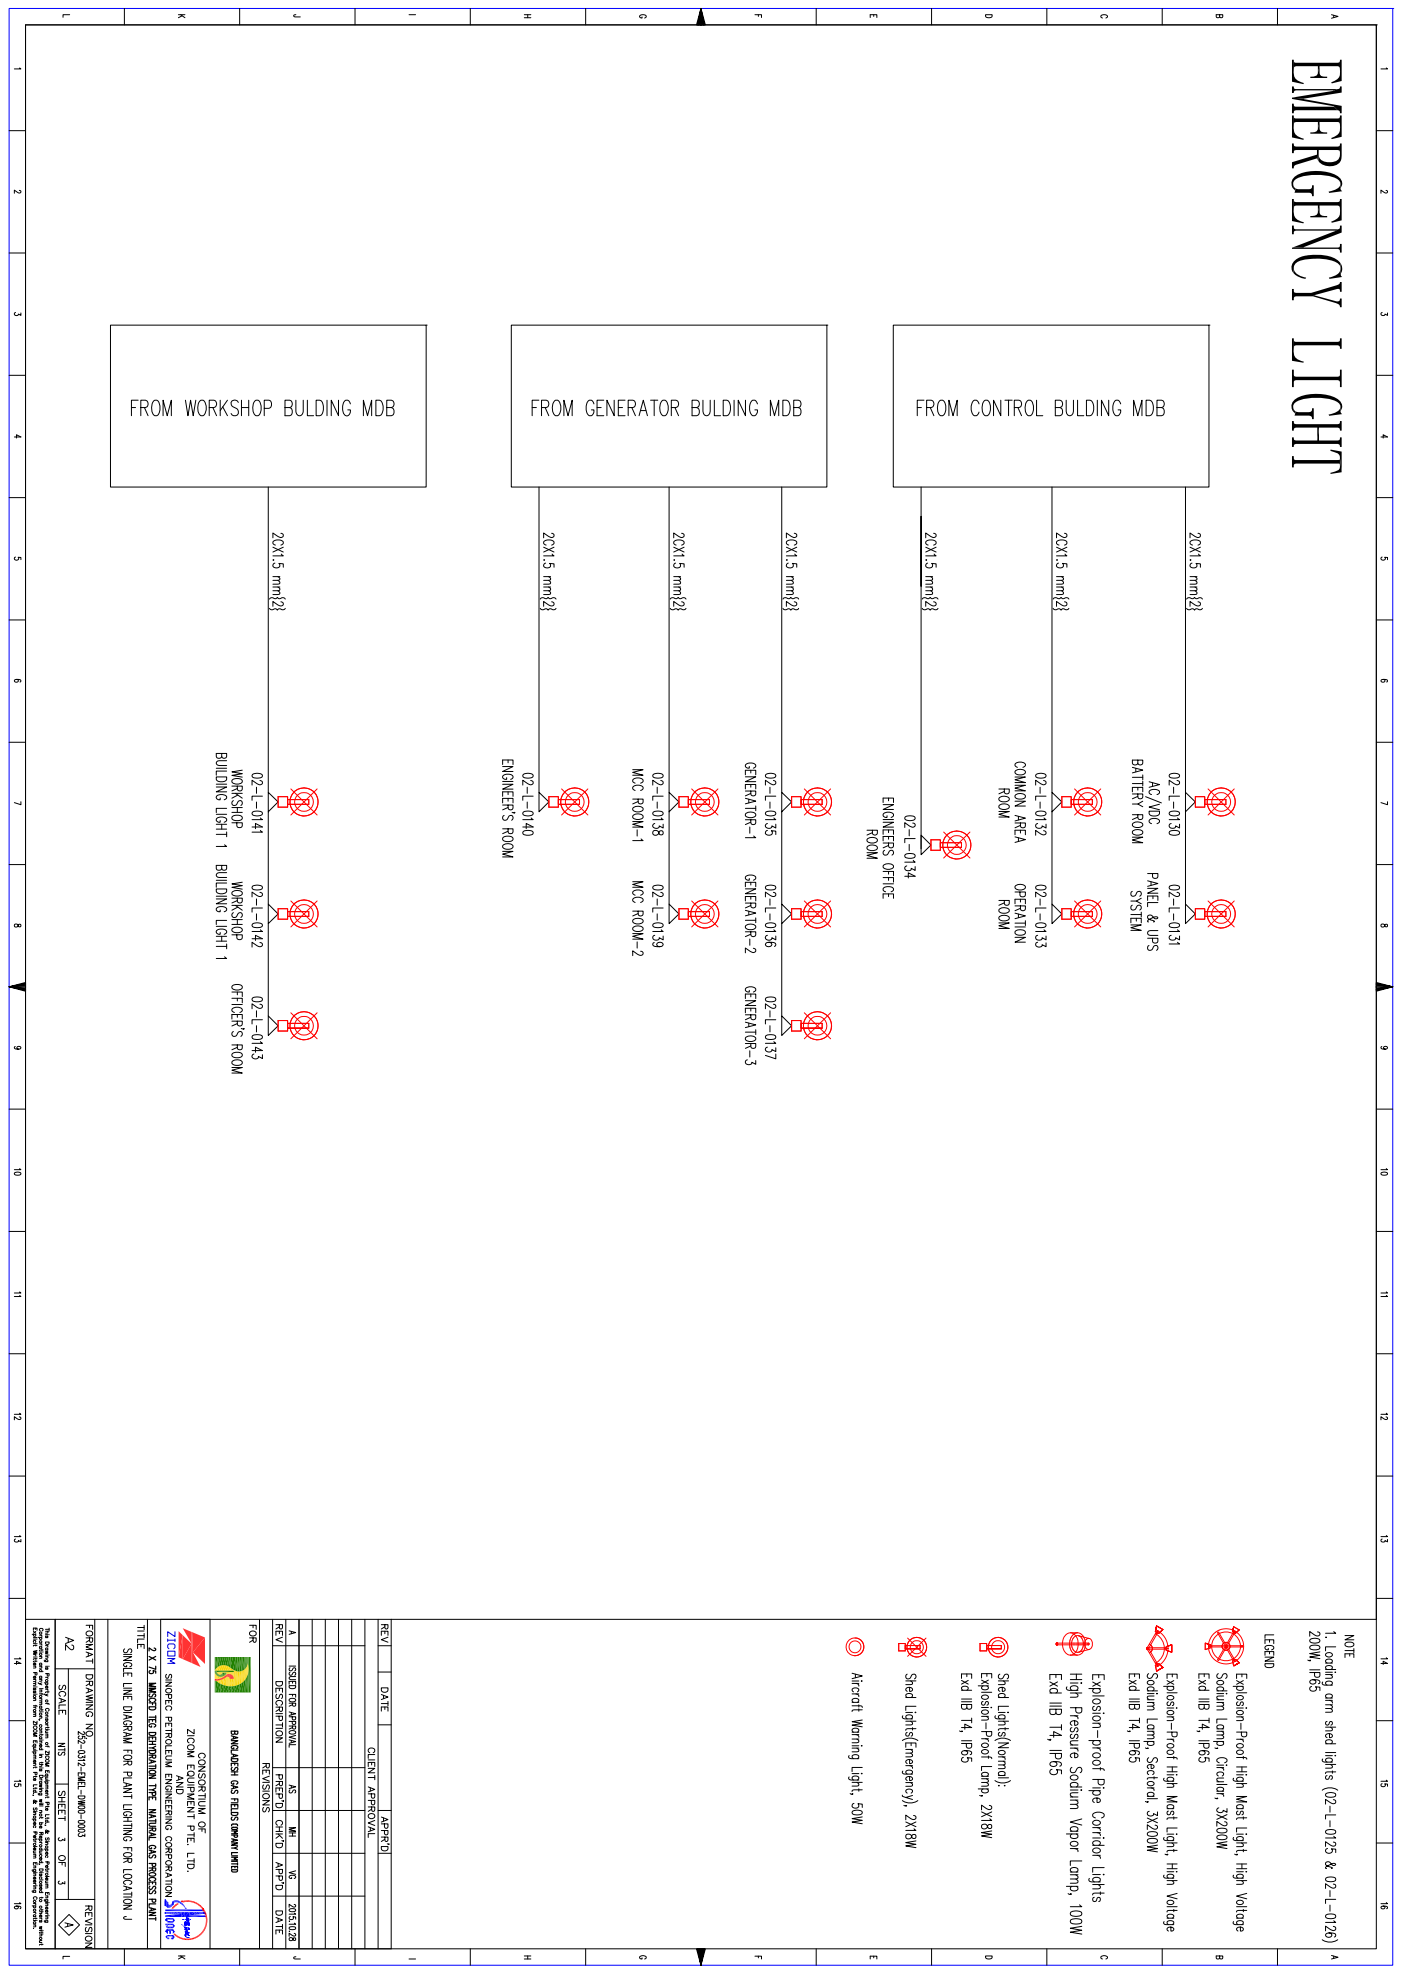
[picture p50: page 9]

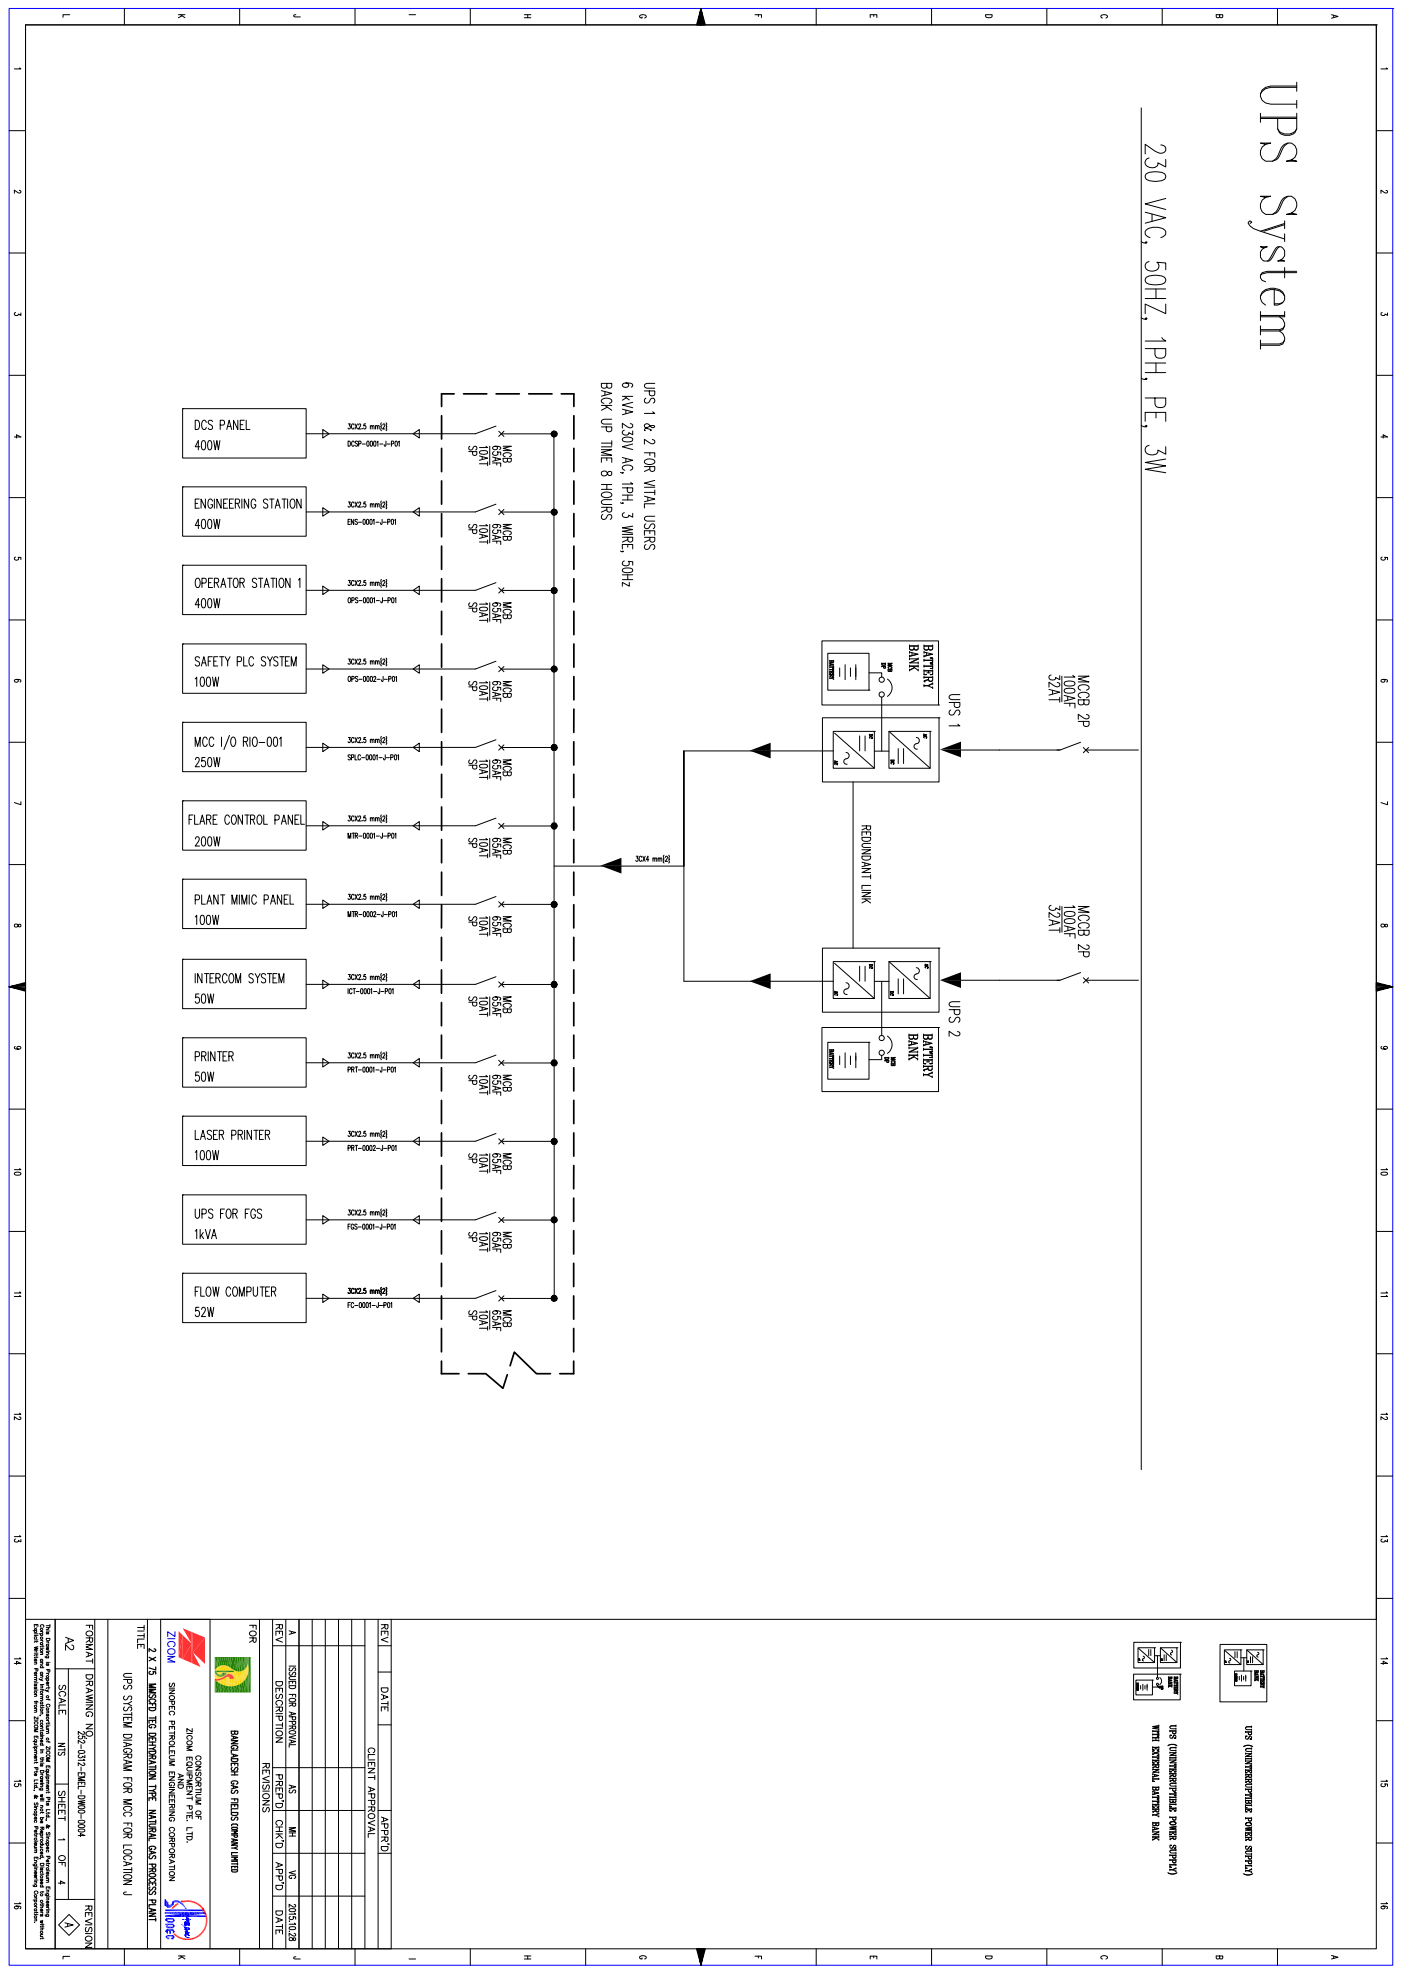
[picture p51: page 10]

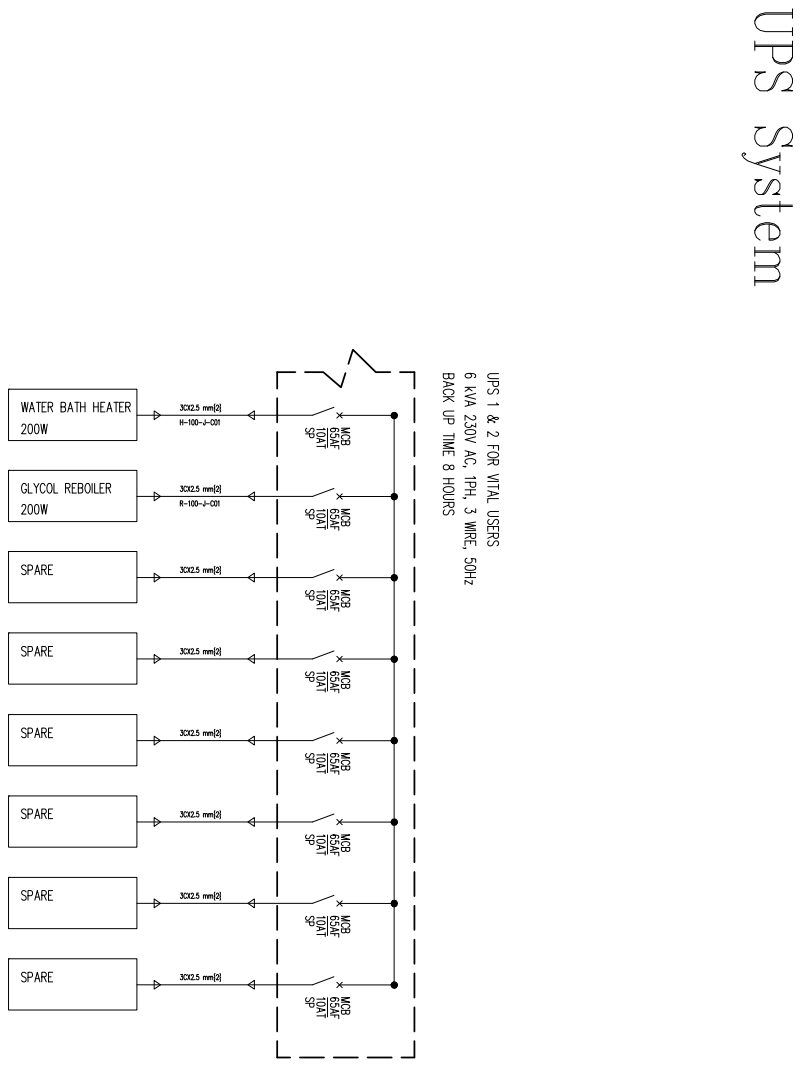
[picture p52: page 11]

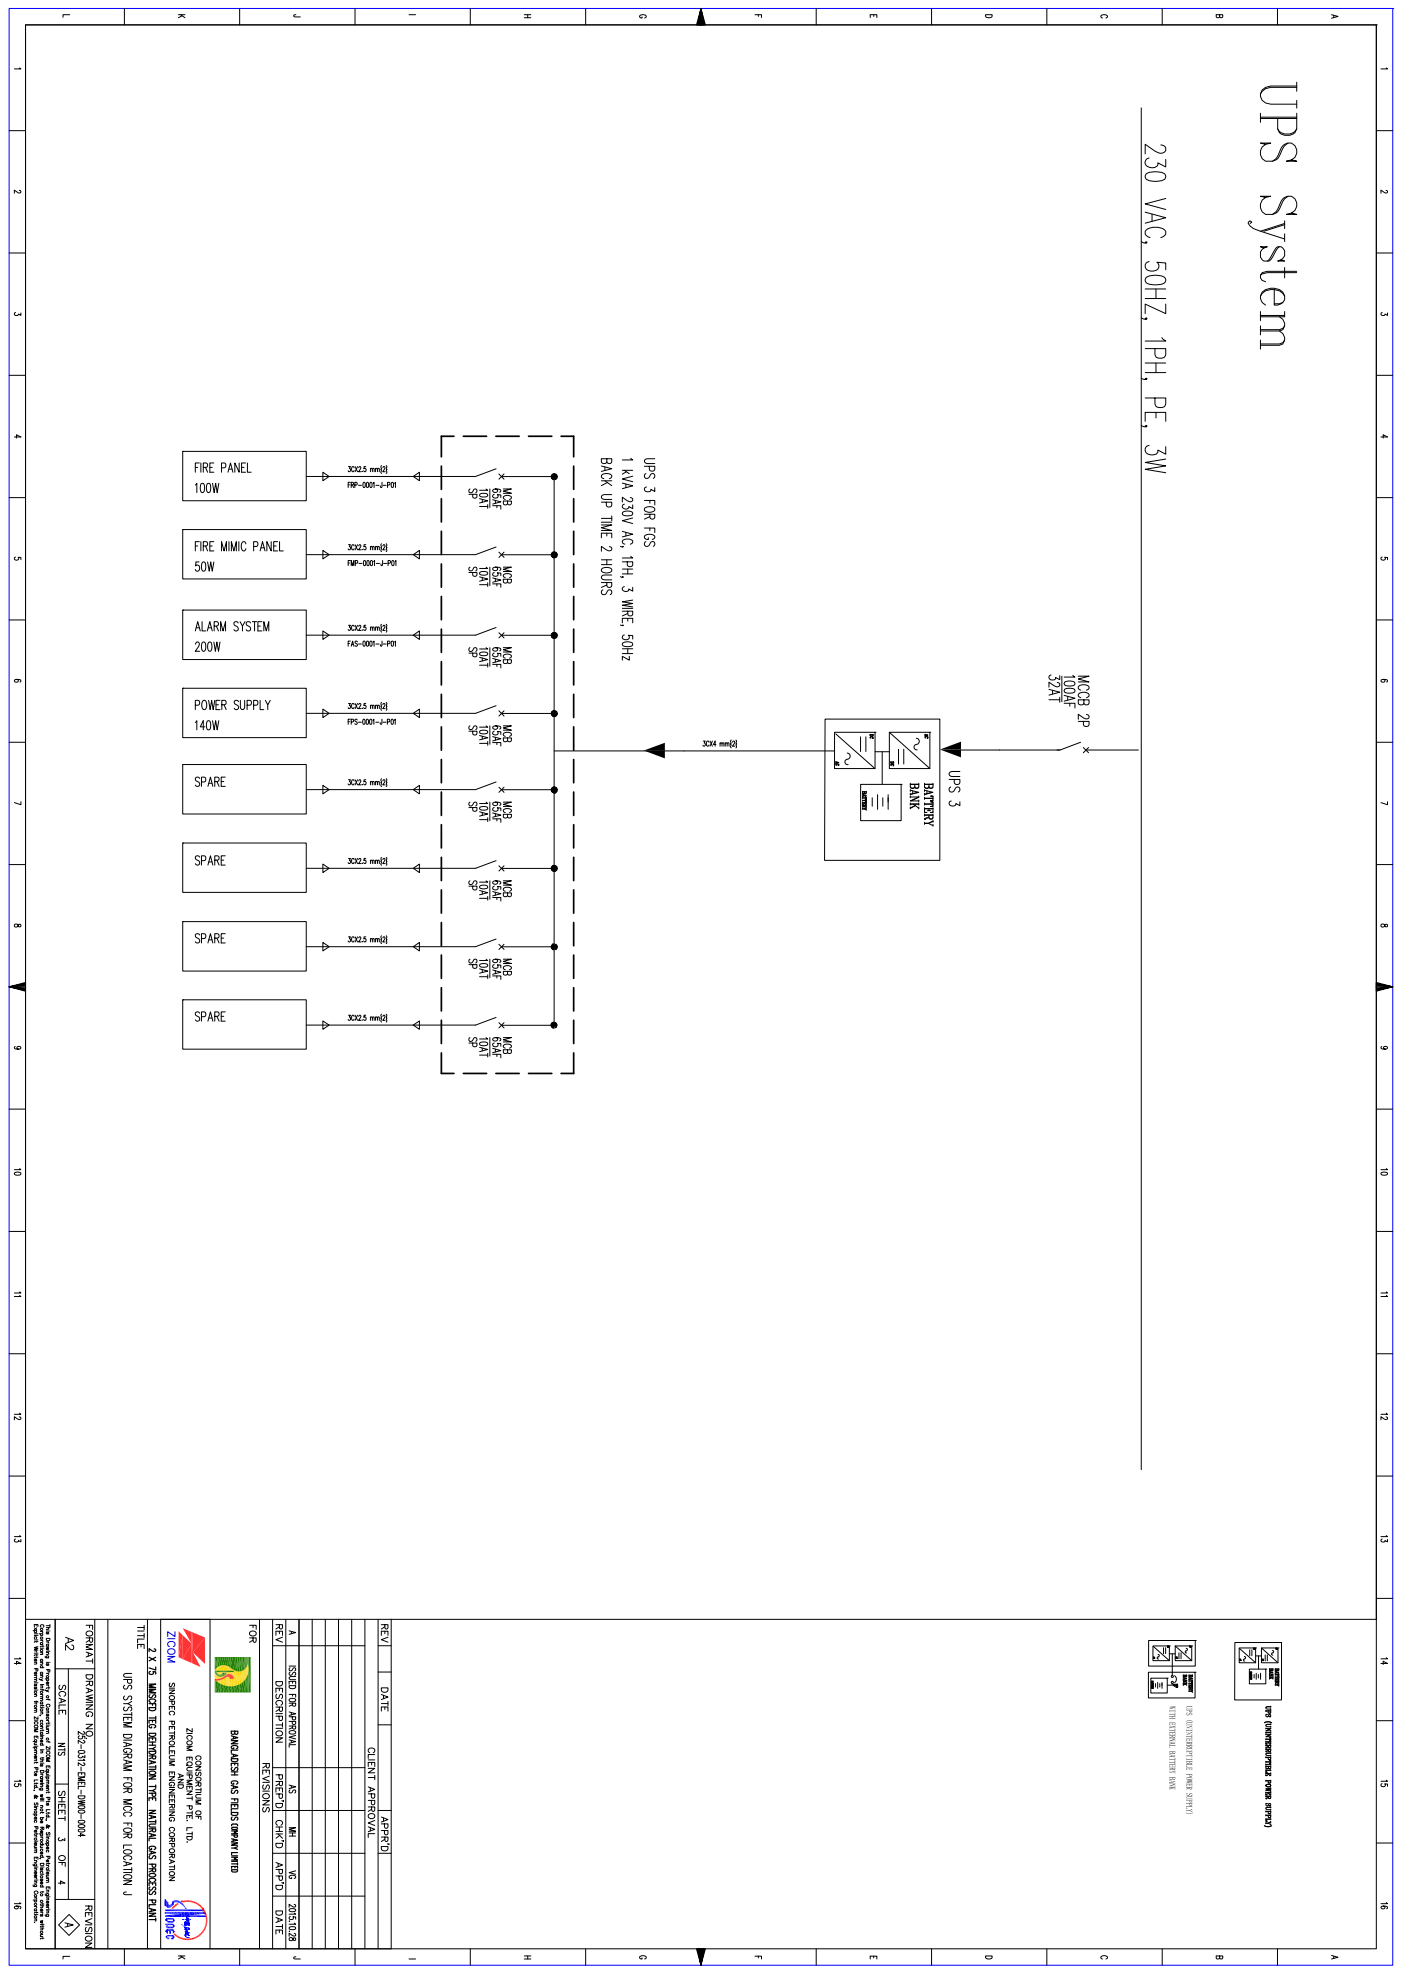
[picture p53: page 12]

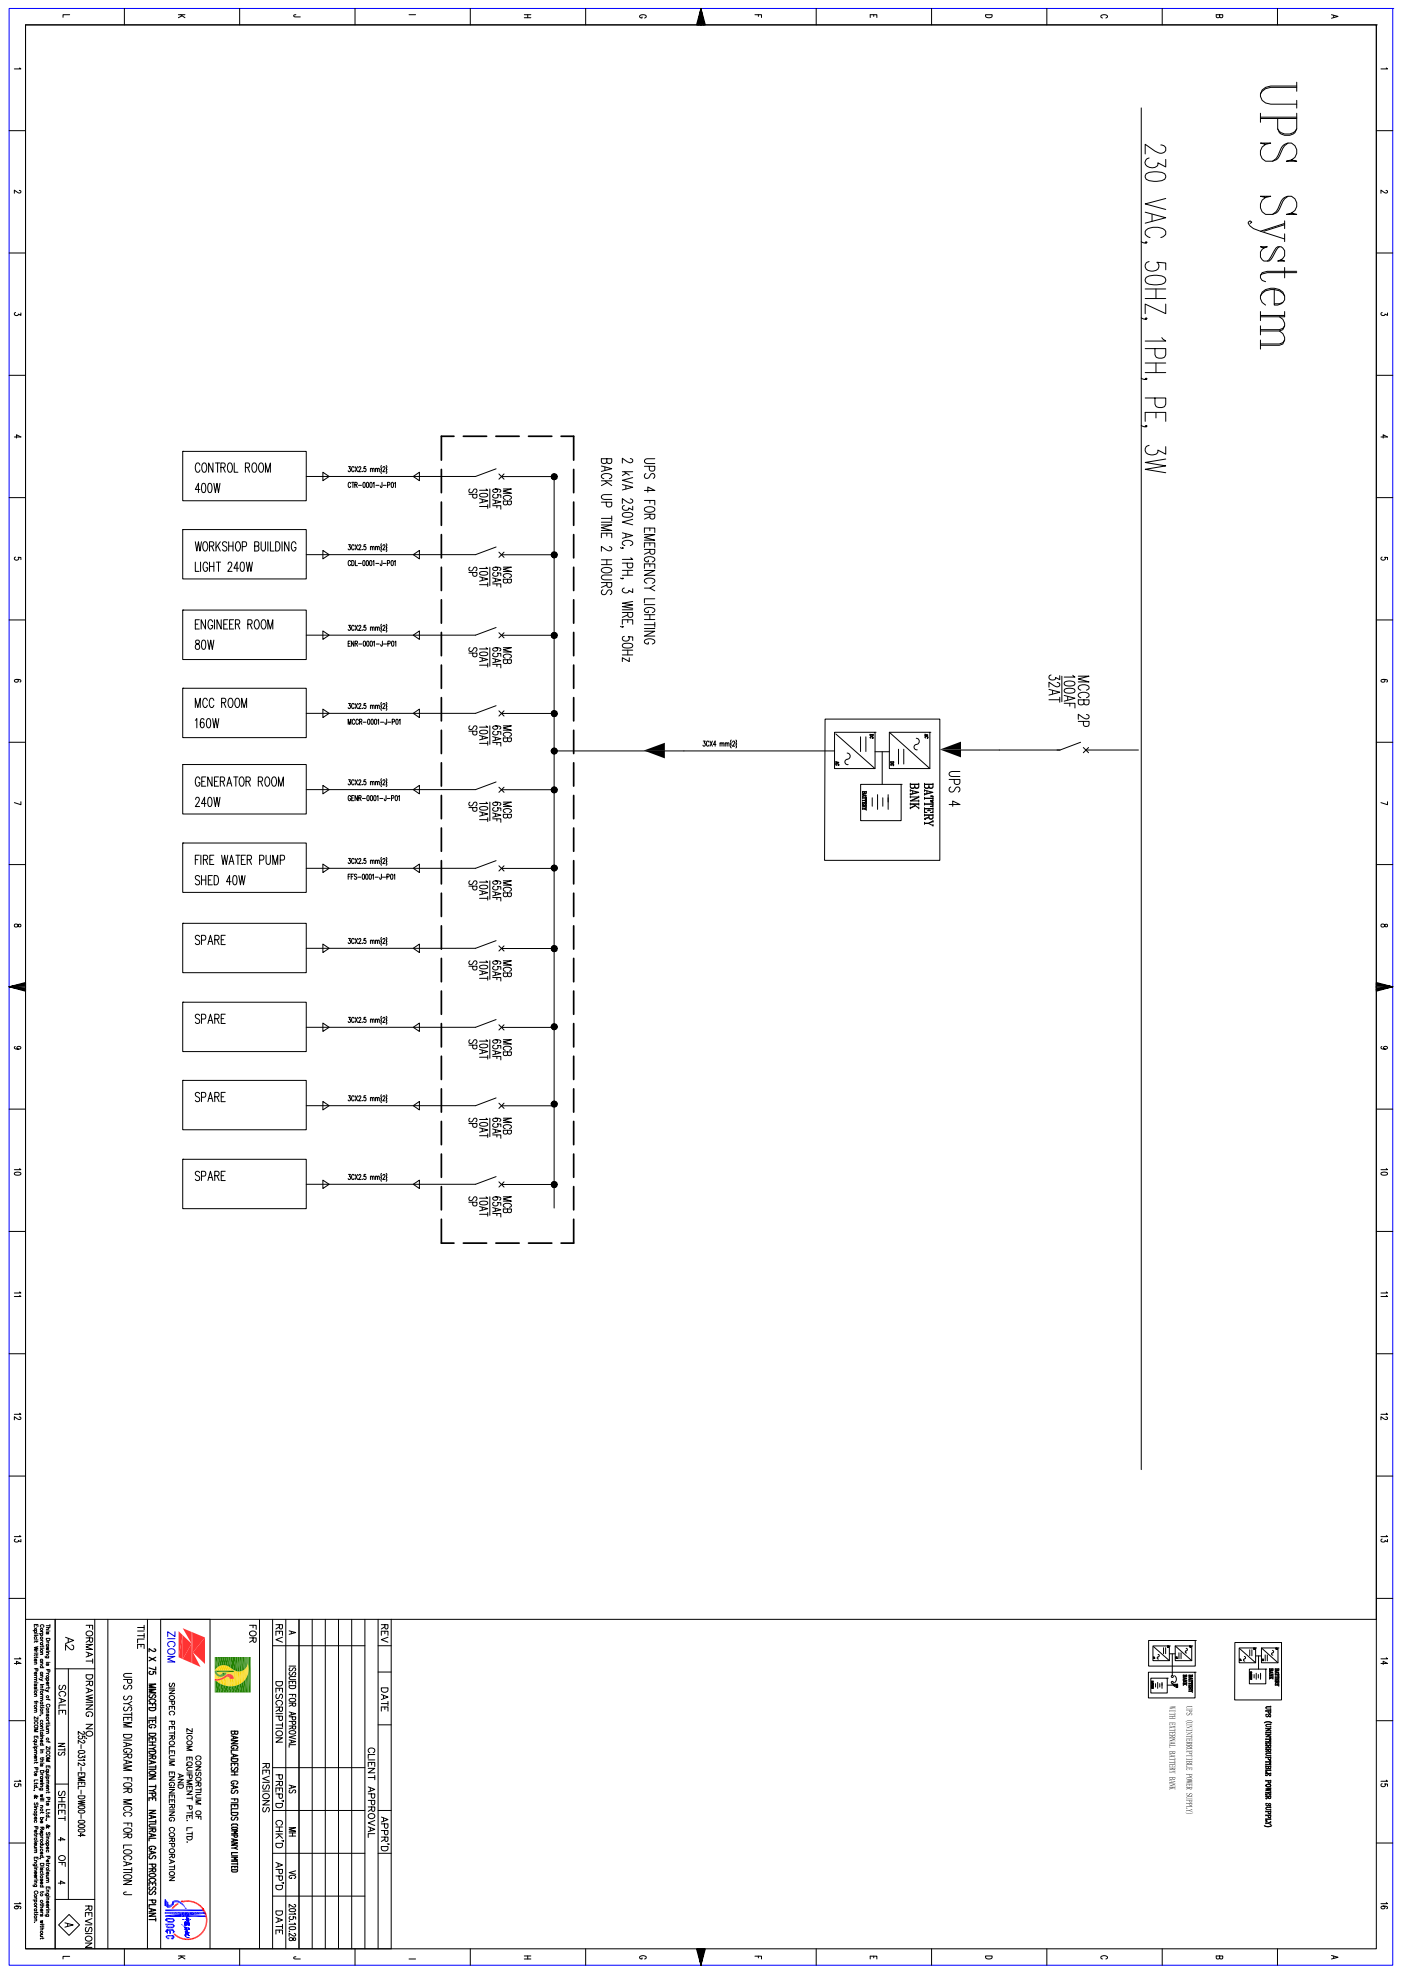
[picture p54: page 13]

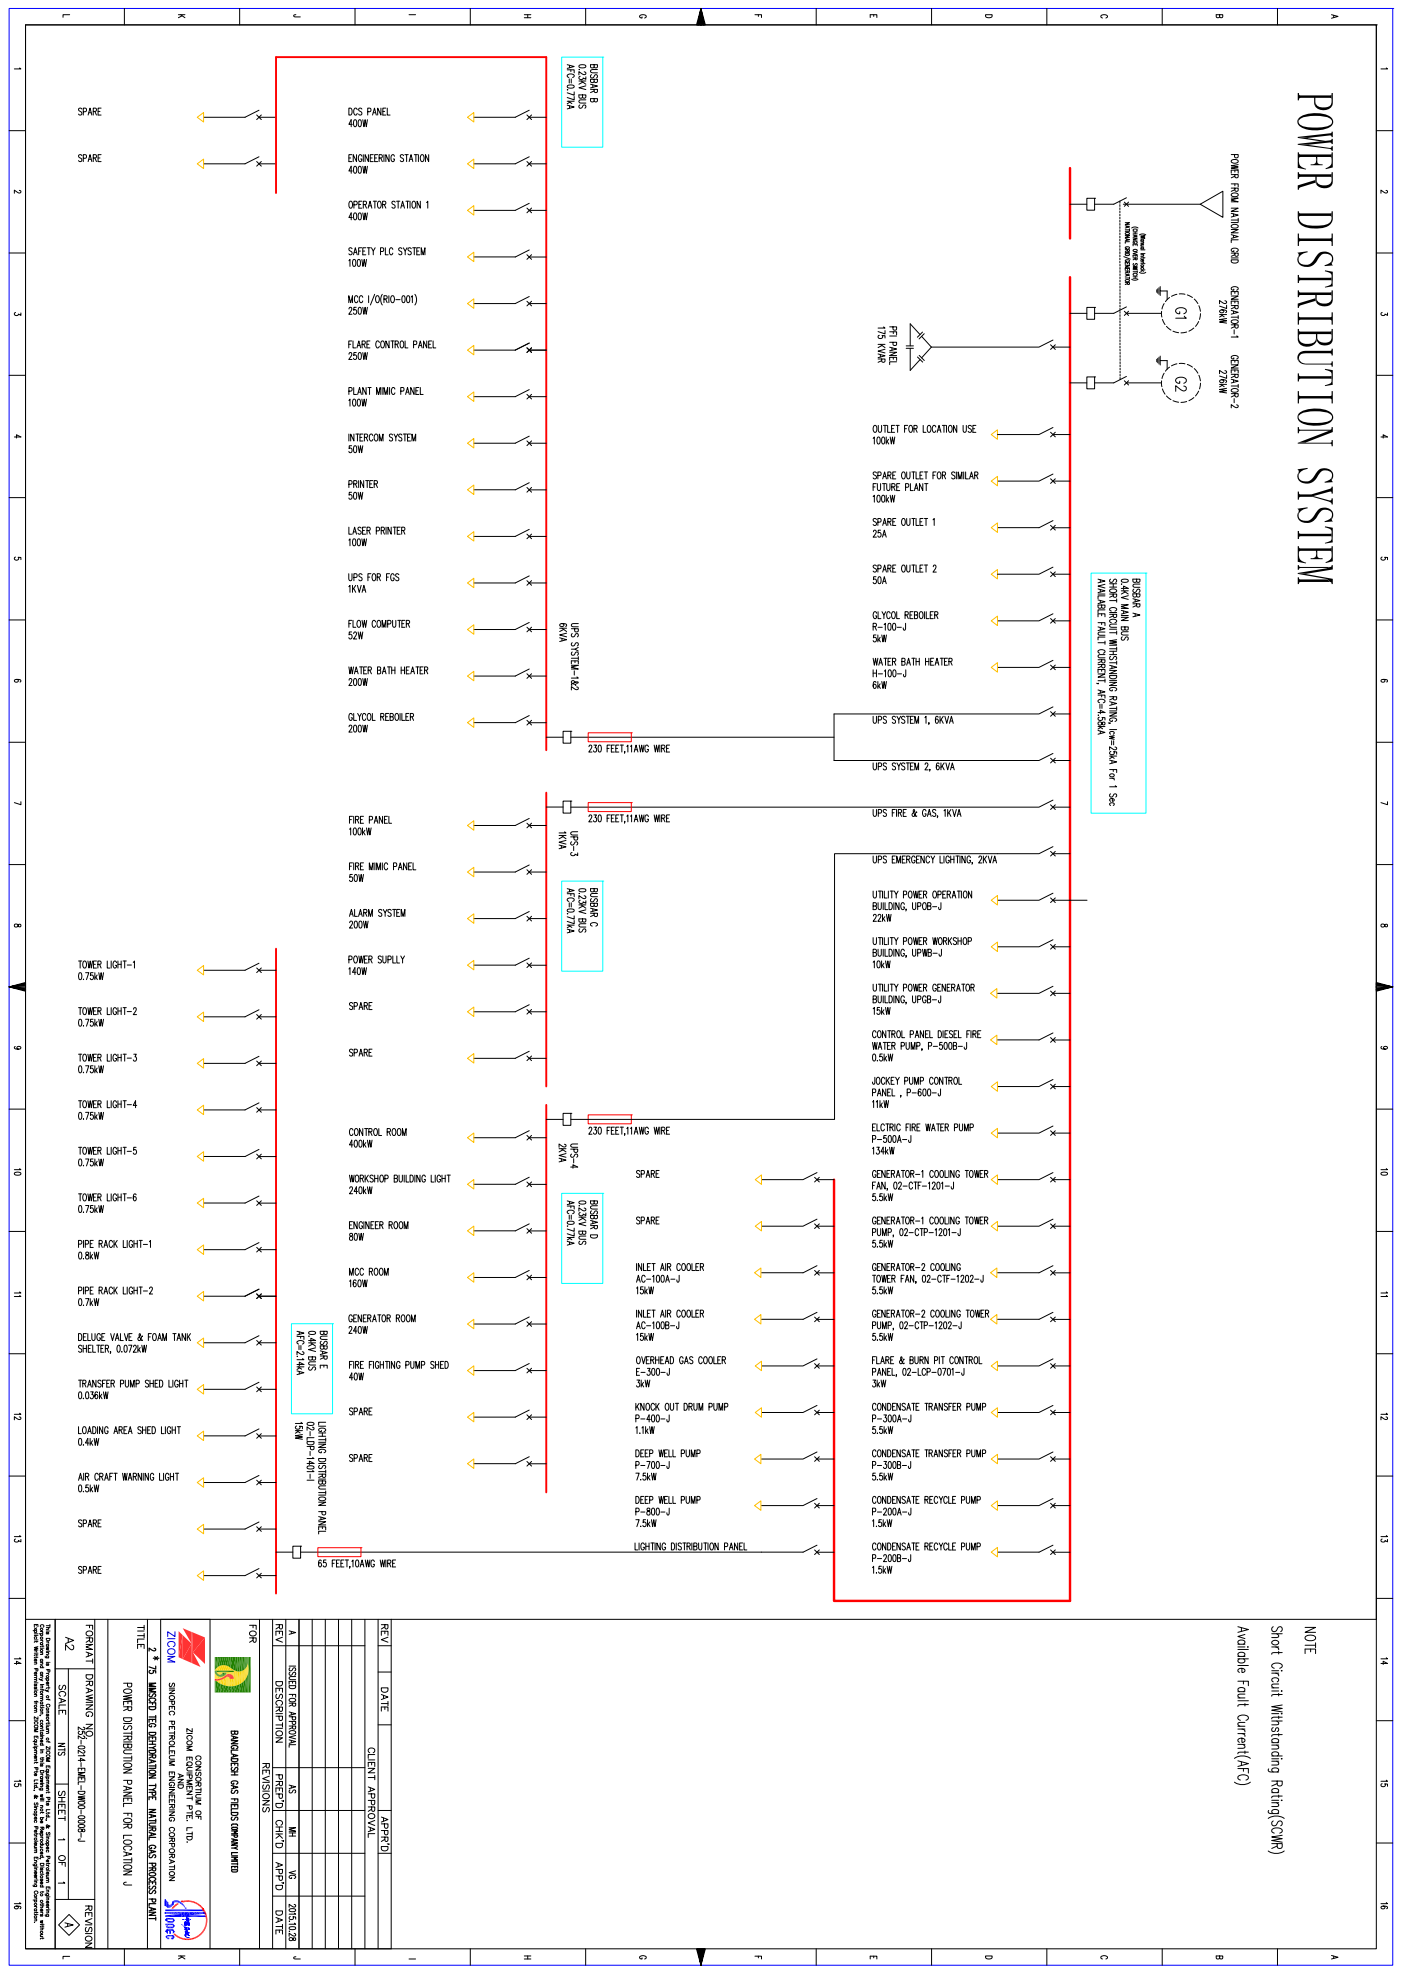
[picture p55: page 14]

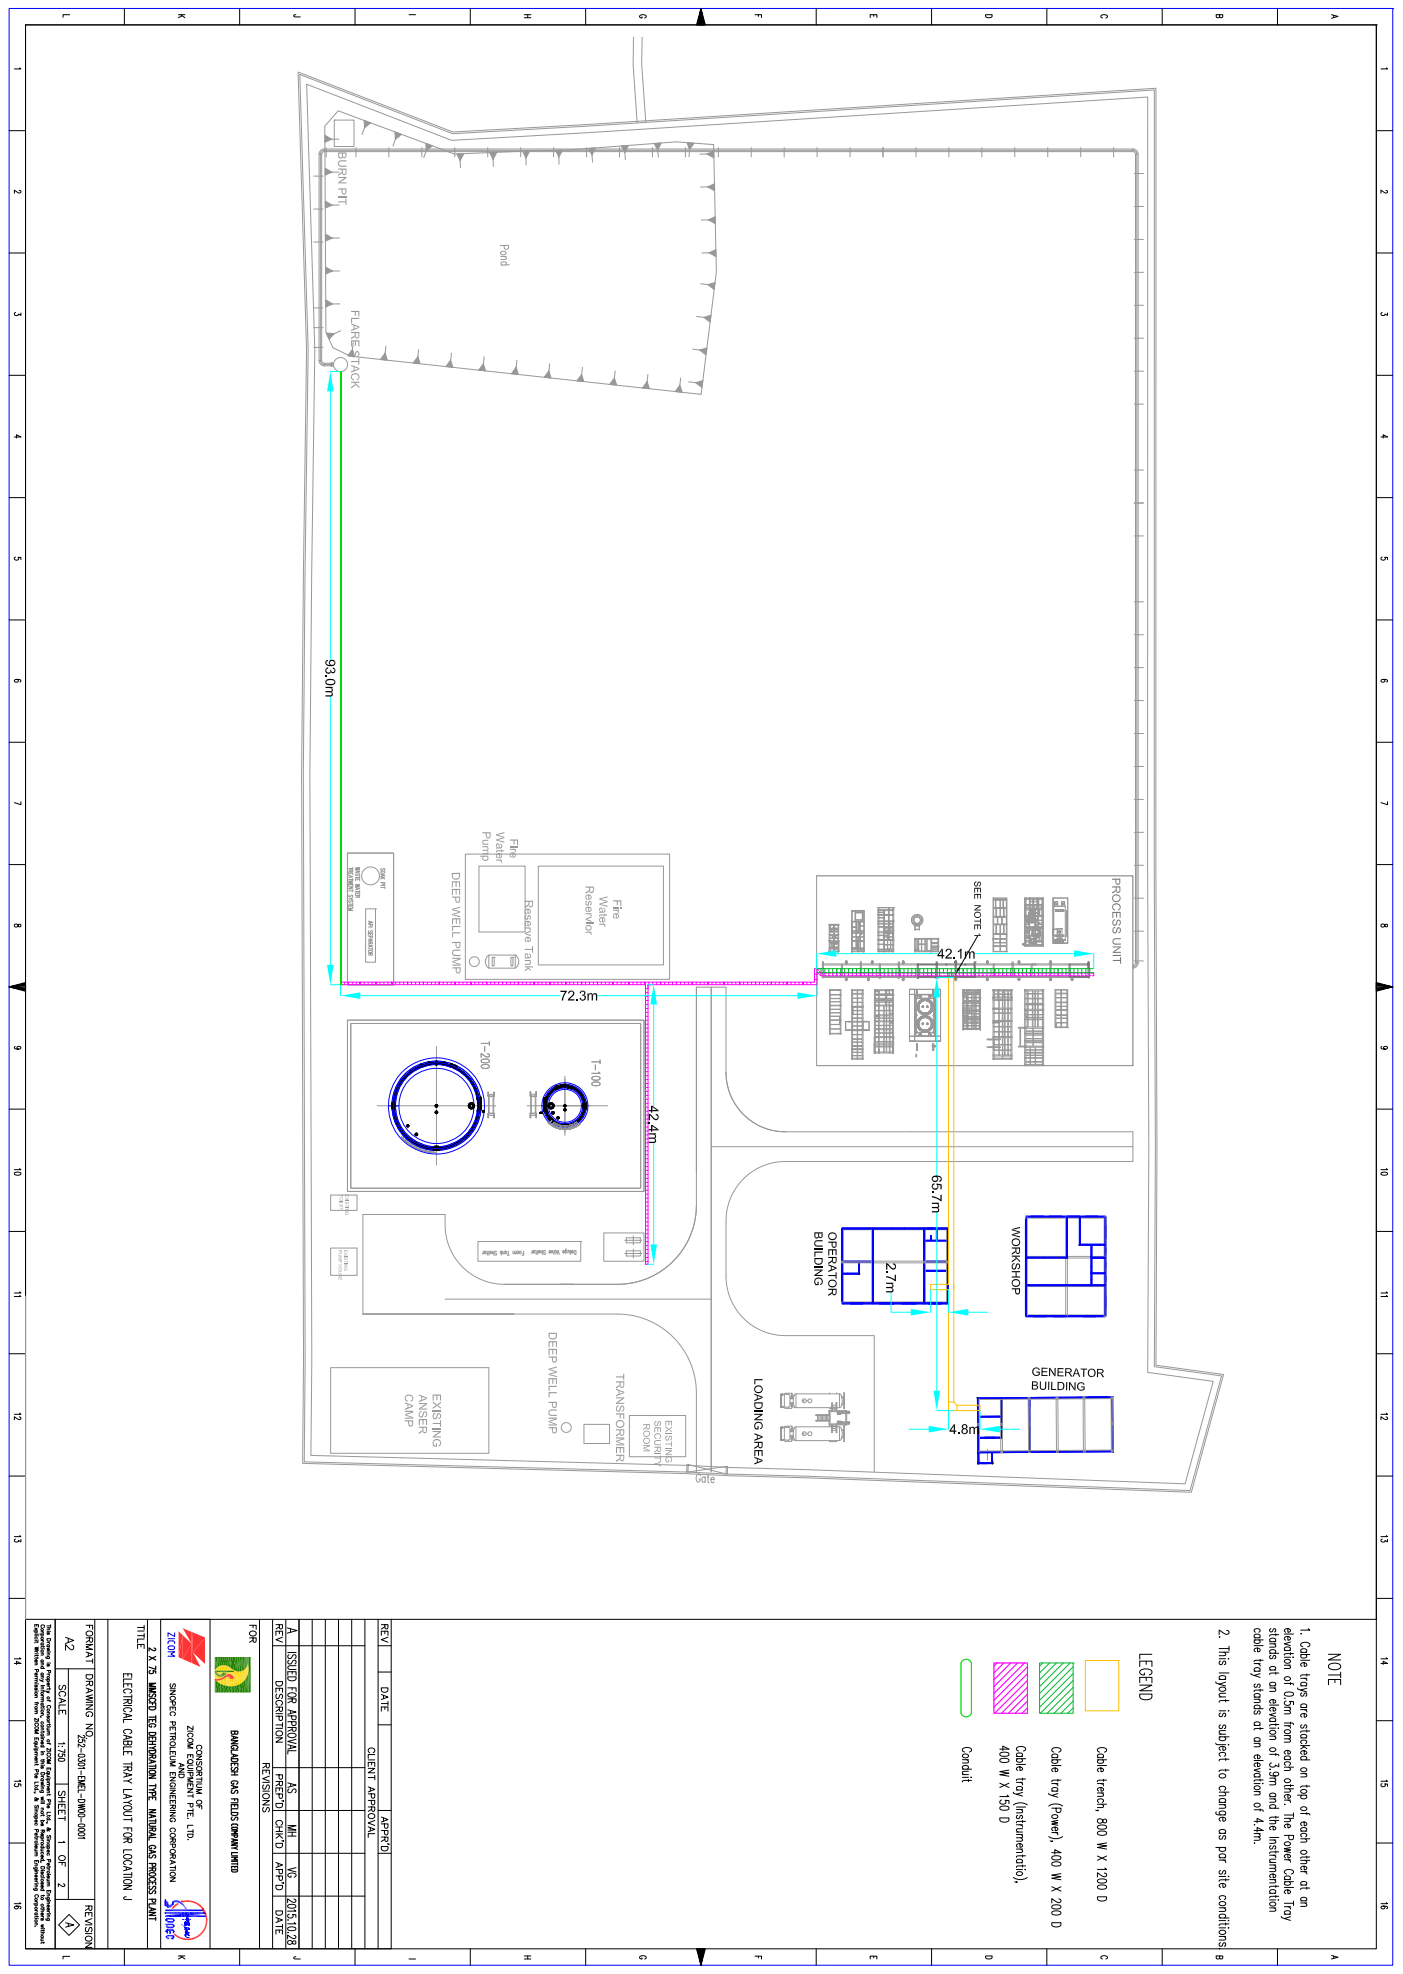
[picture p56: page 15]

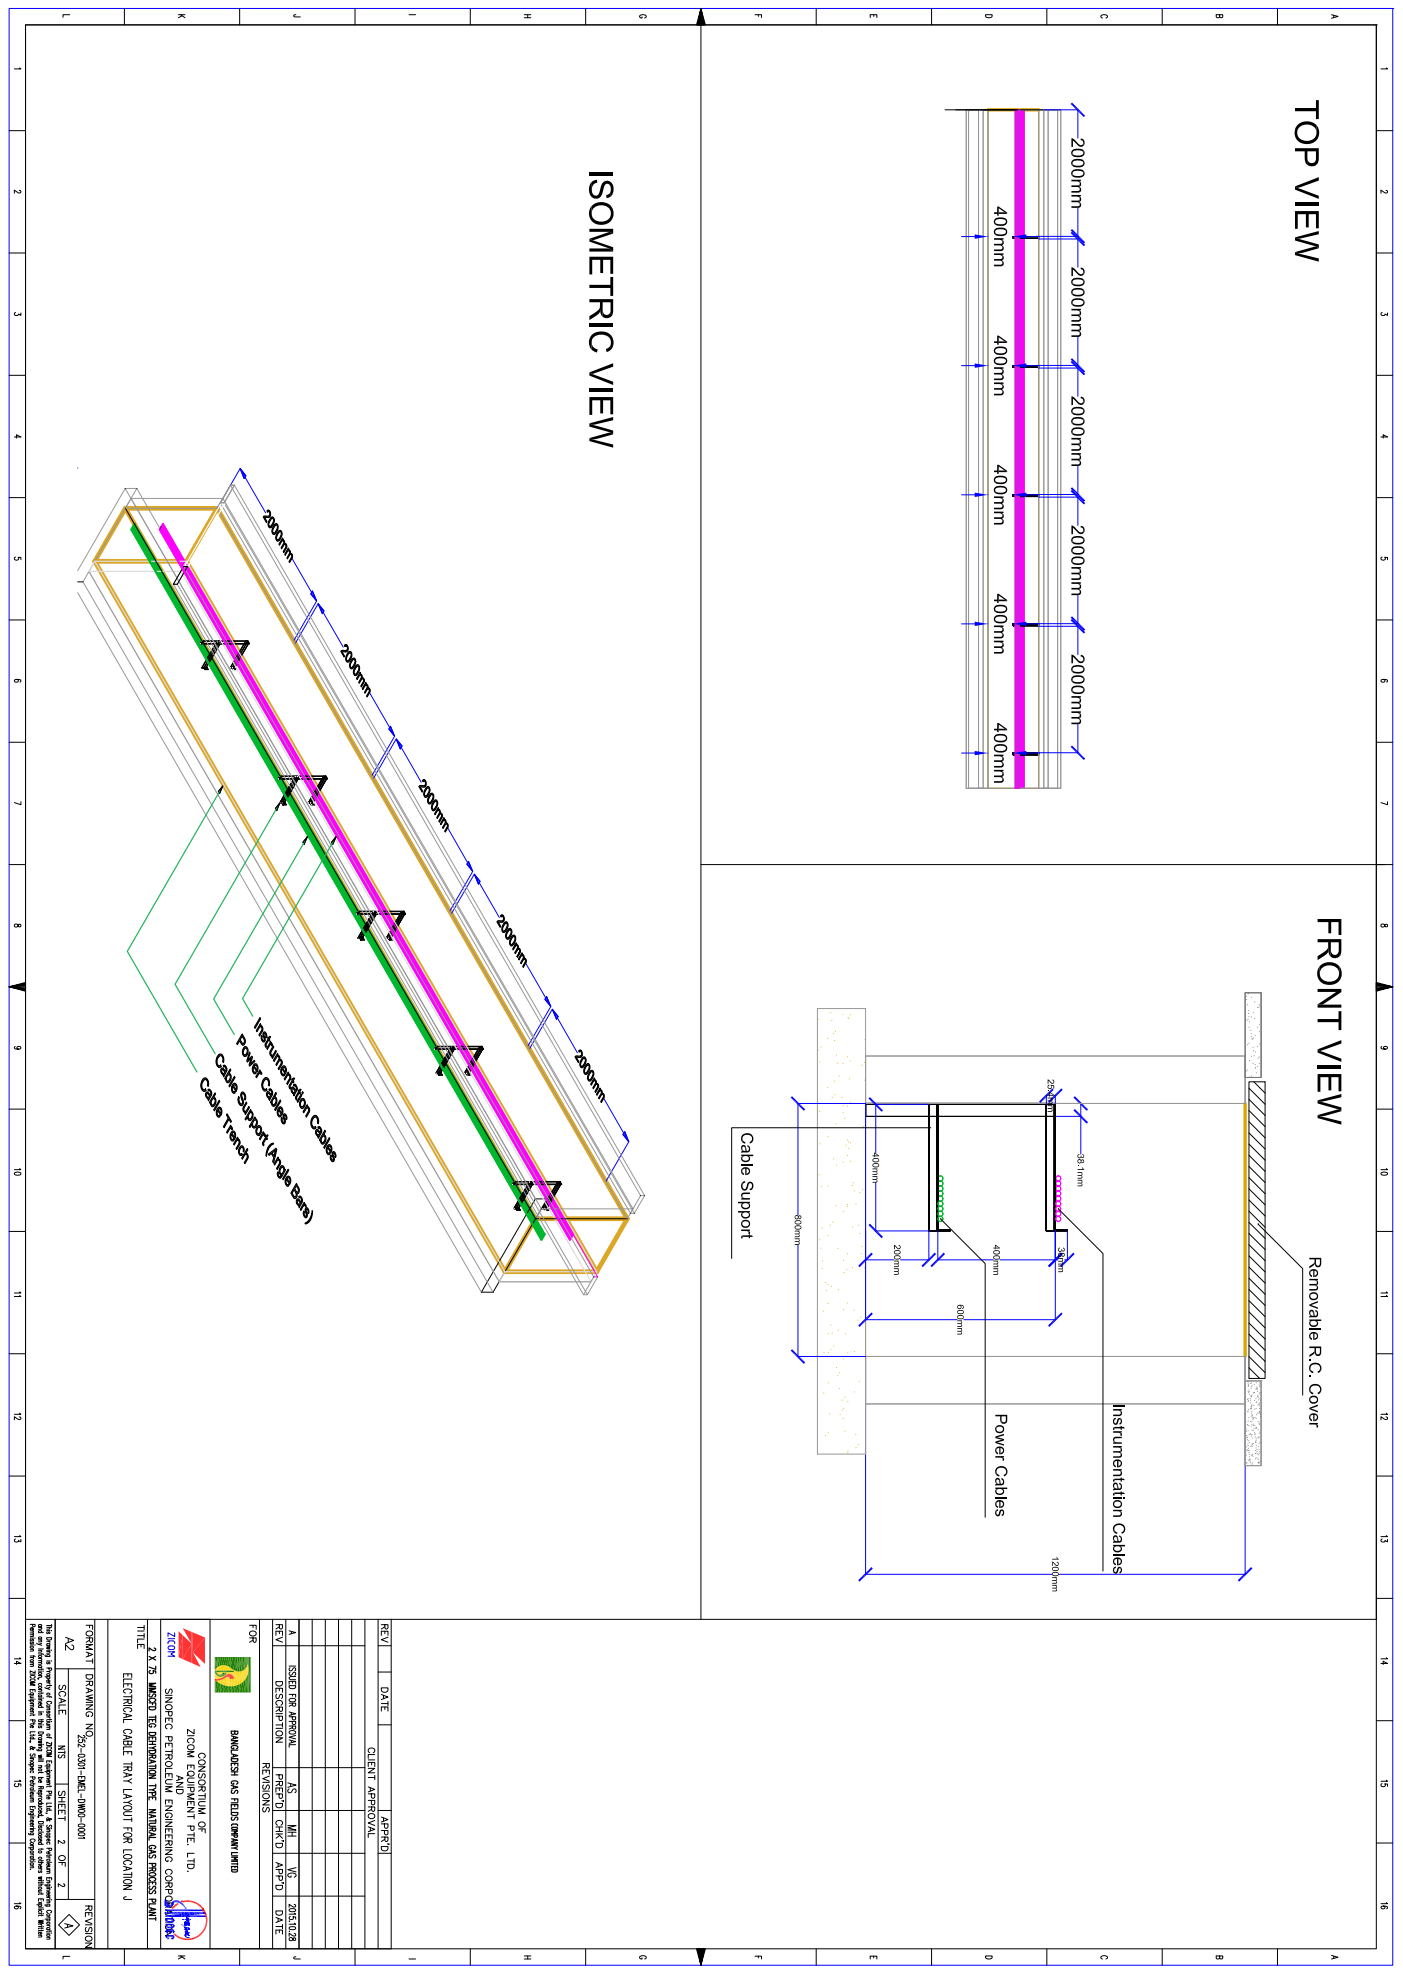
[picture p57: page 16]

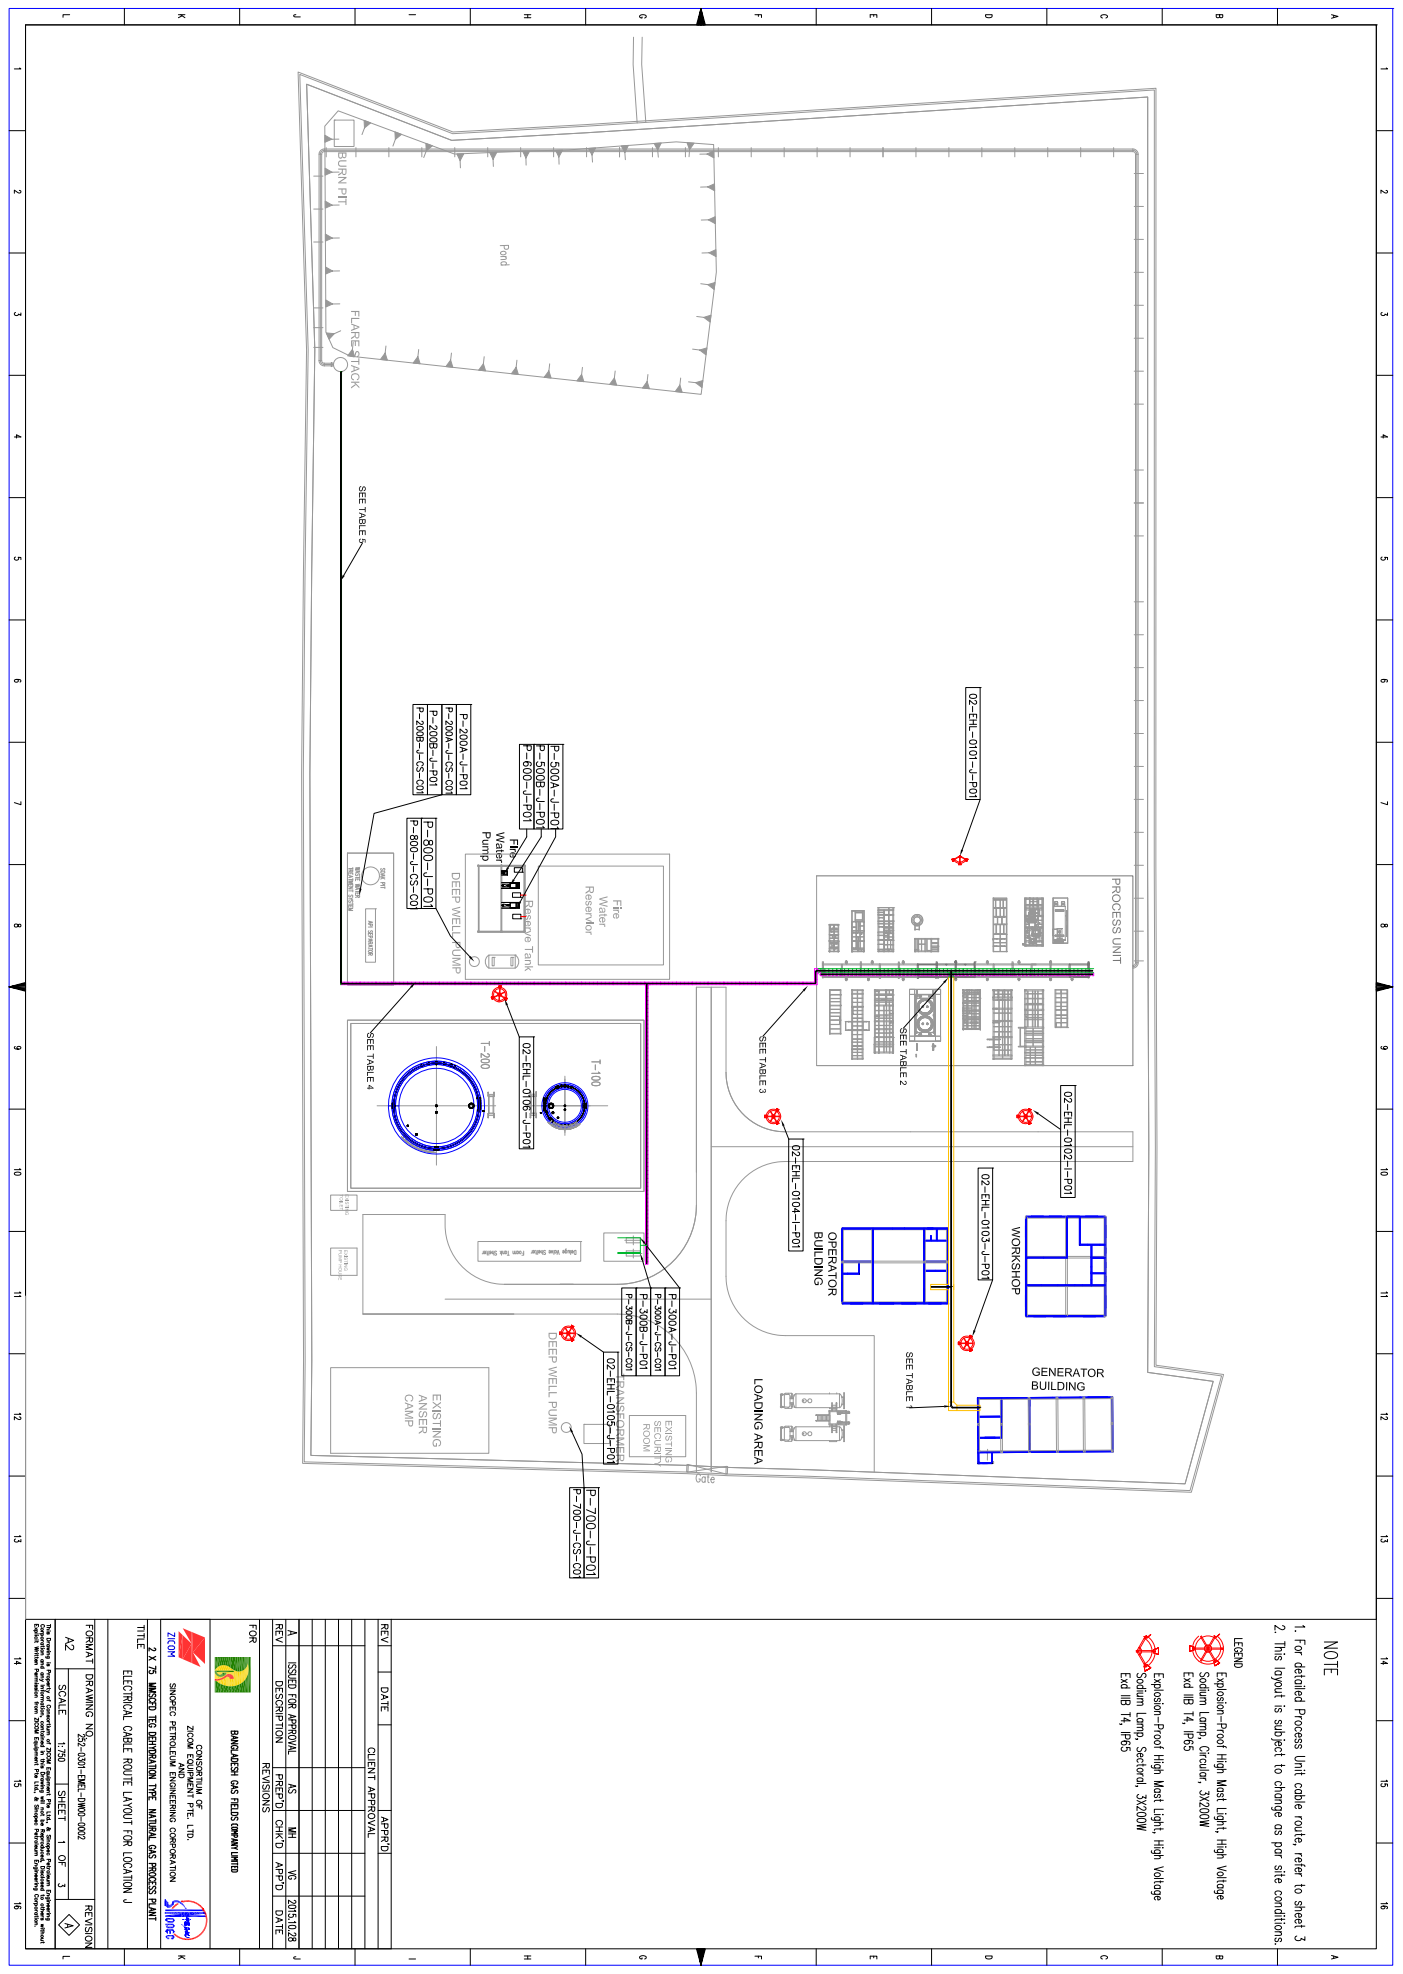
[picture p58: page 17]

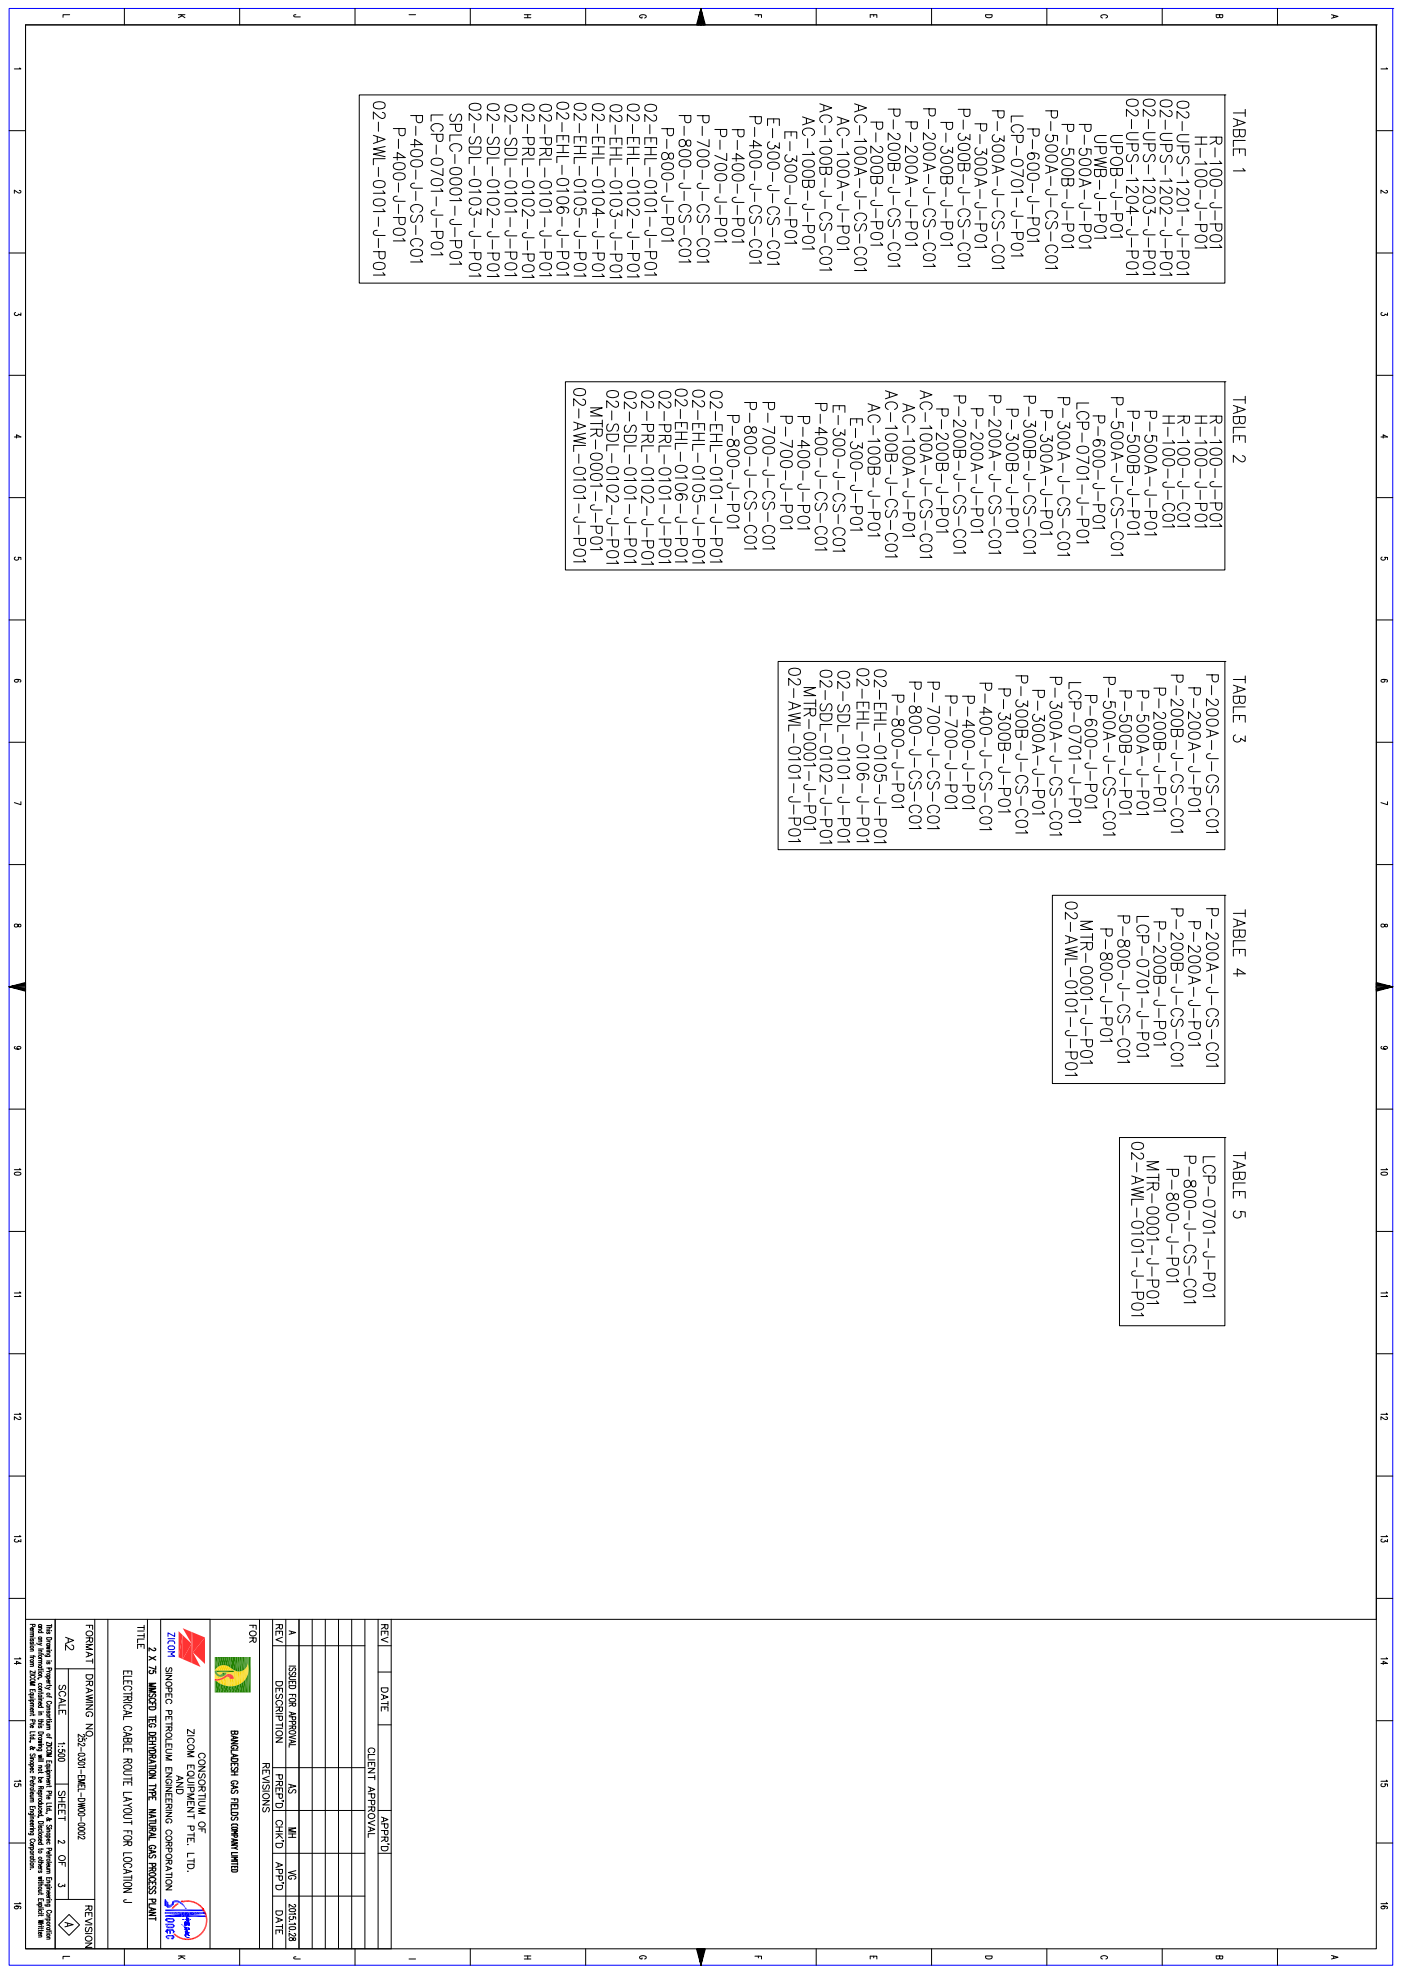
[picture p59: page 18]

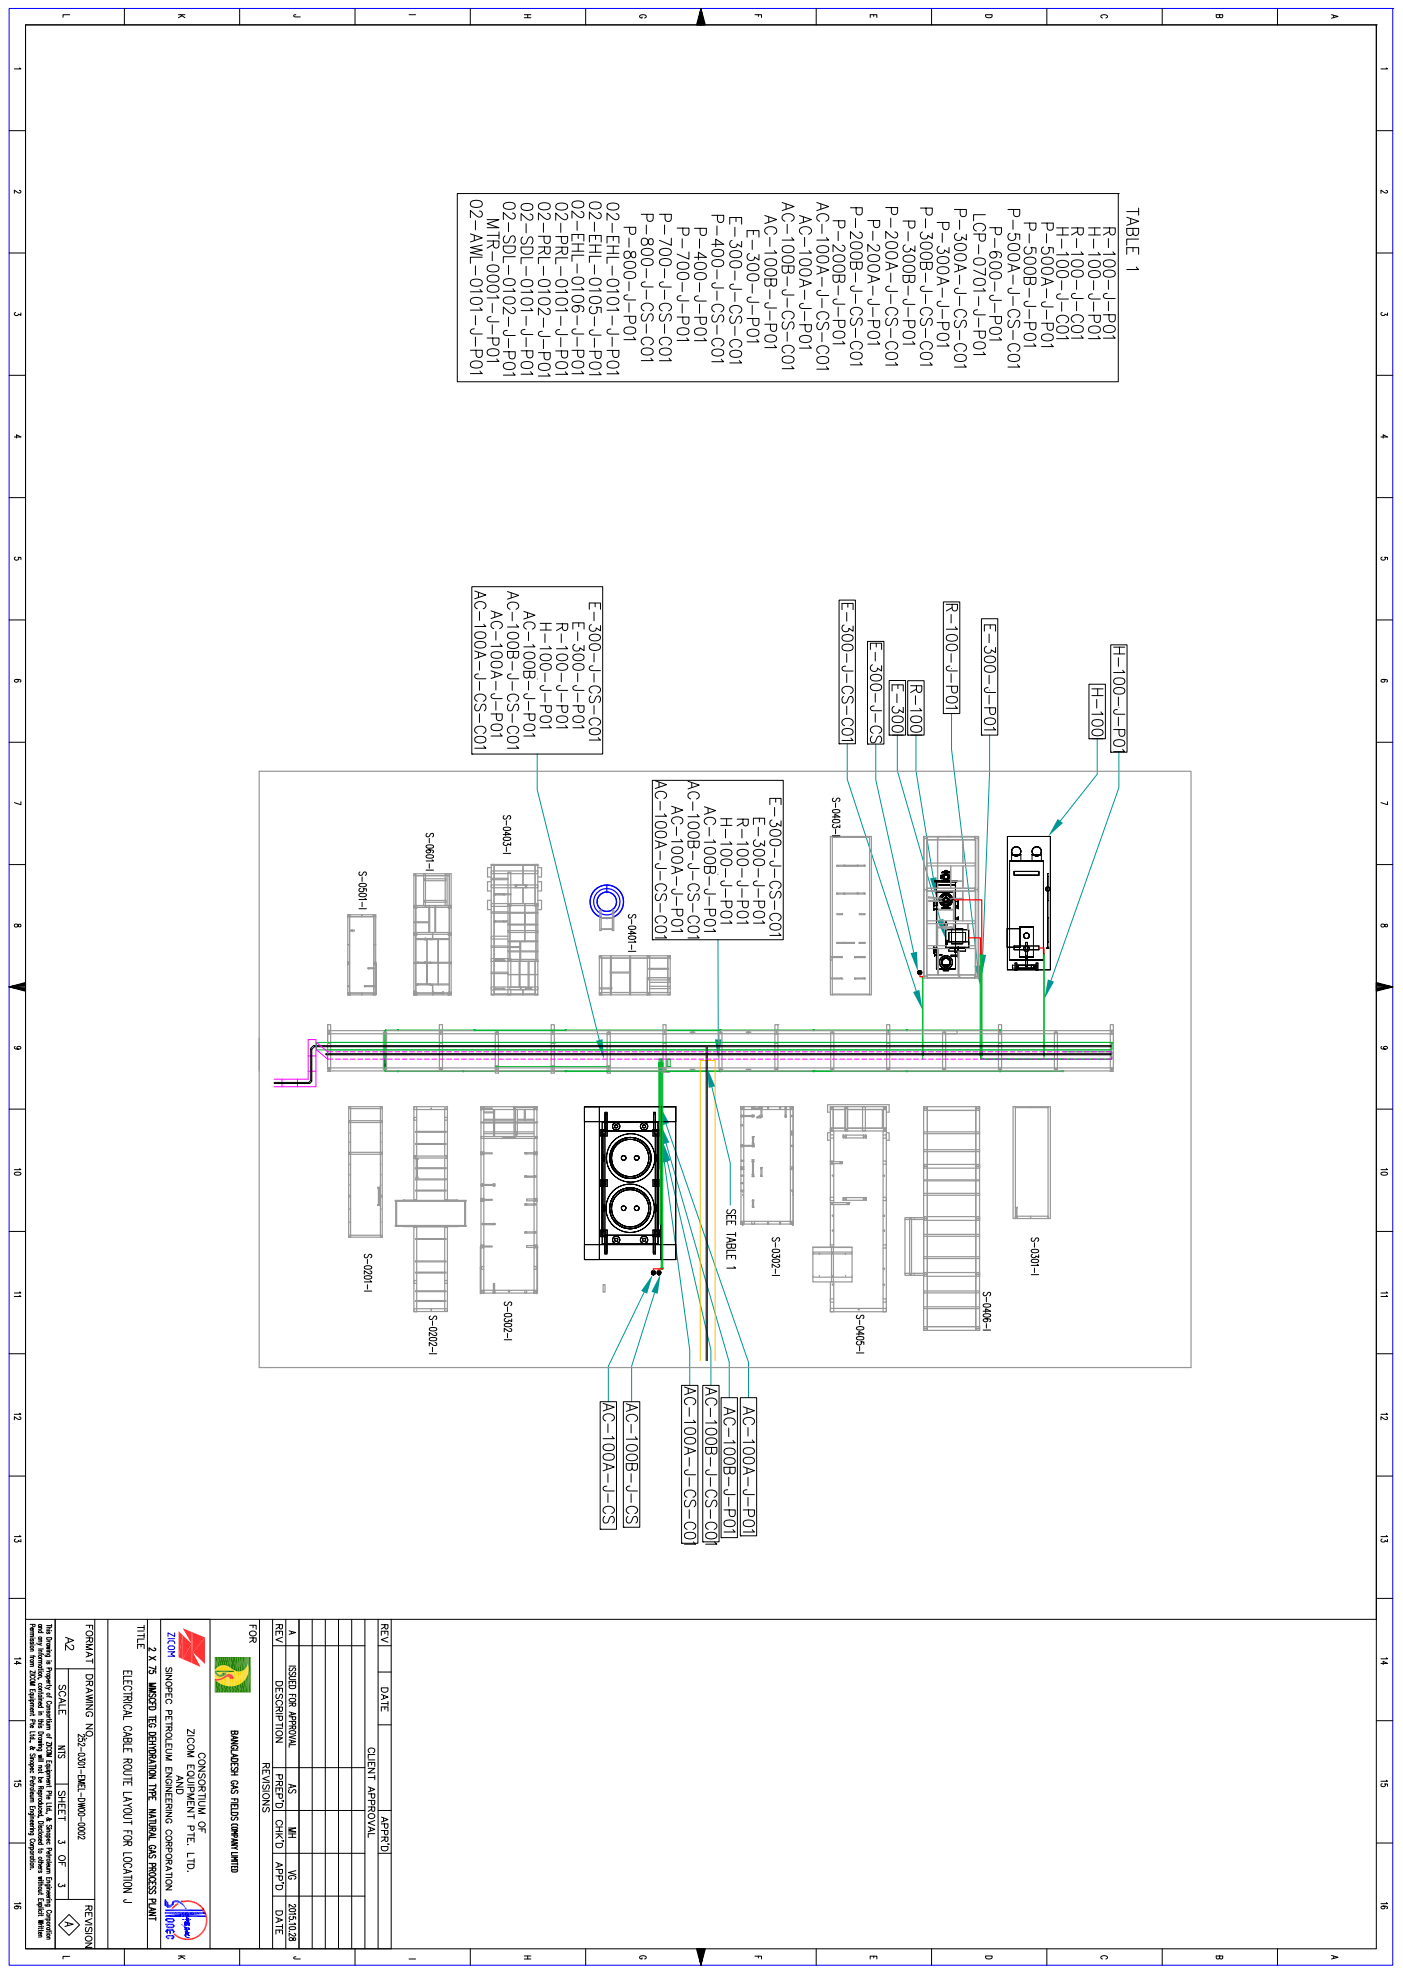
[picture p60: page 19]

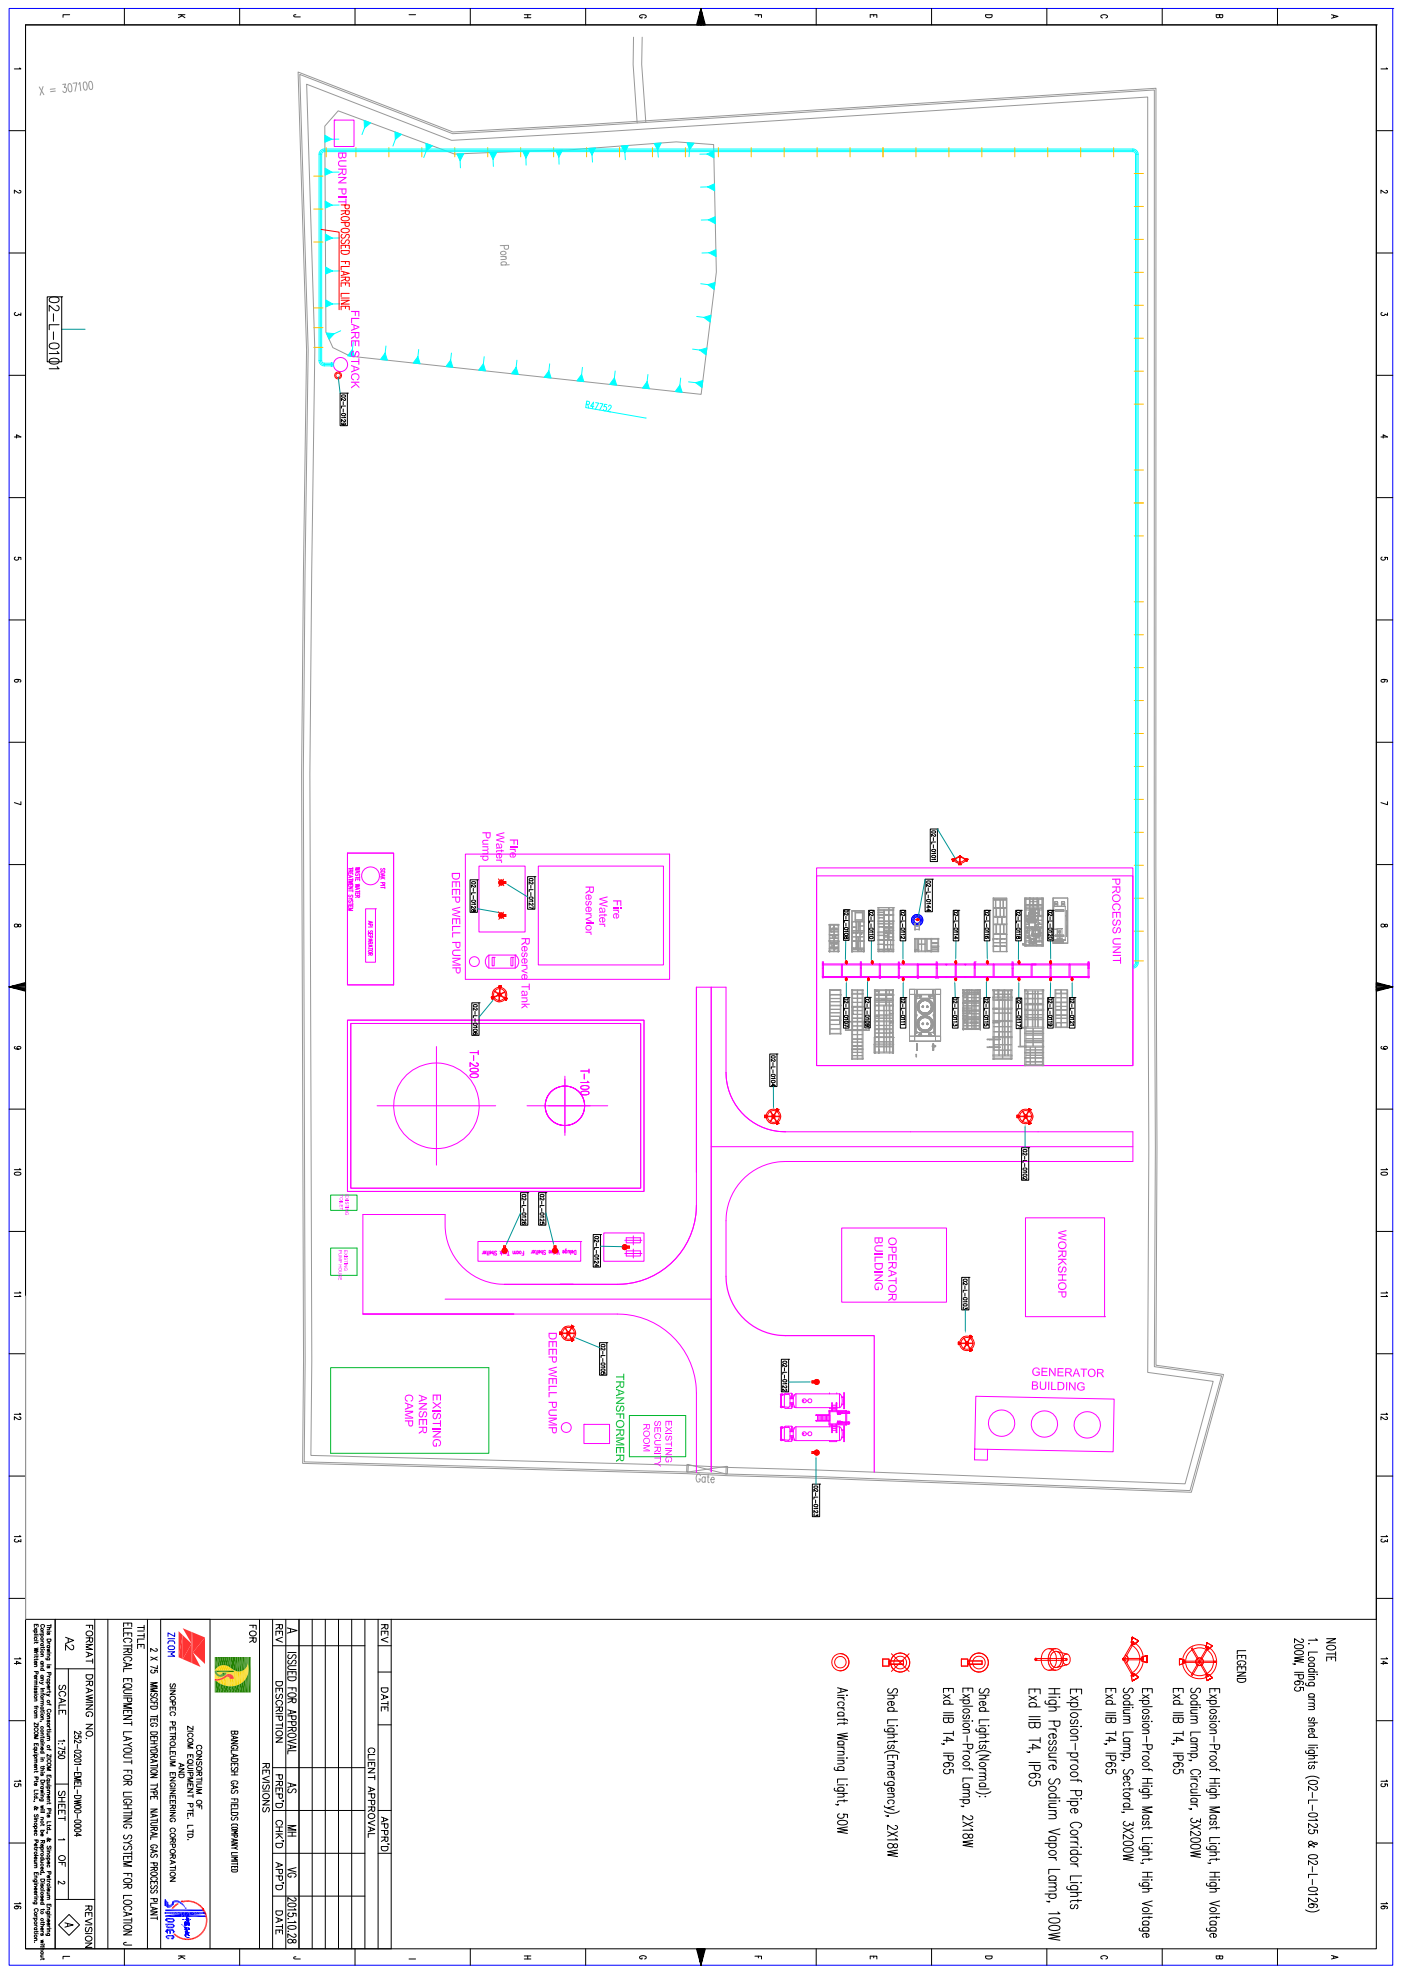
[picture p61: page 20]

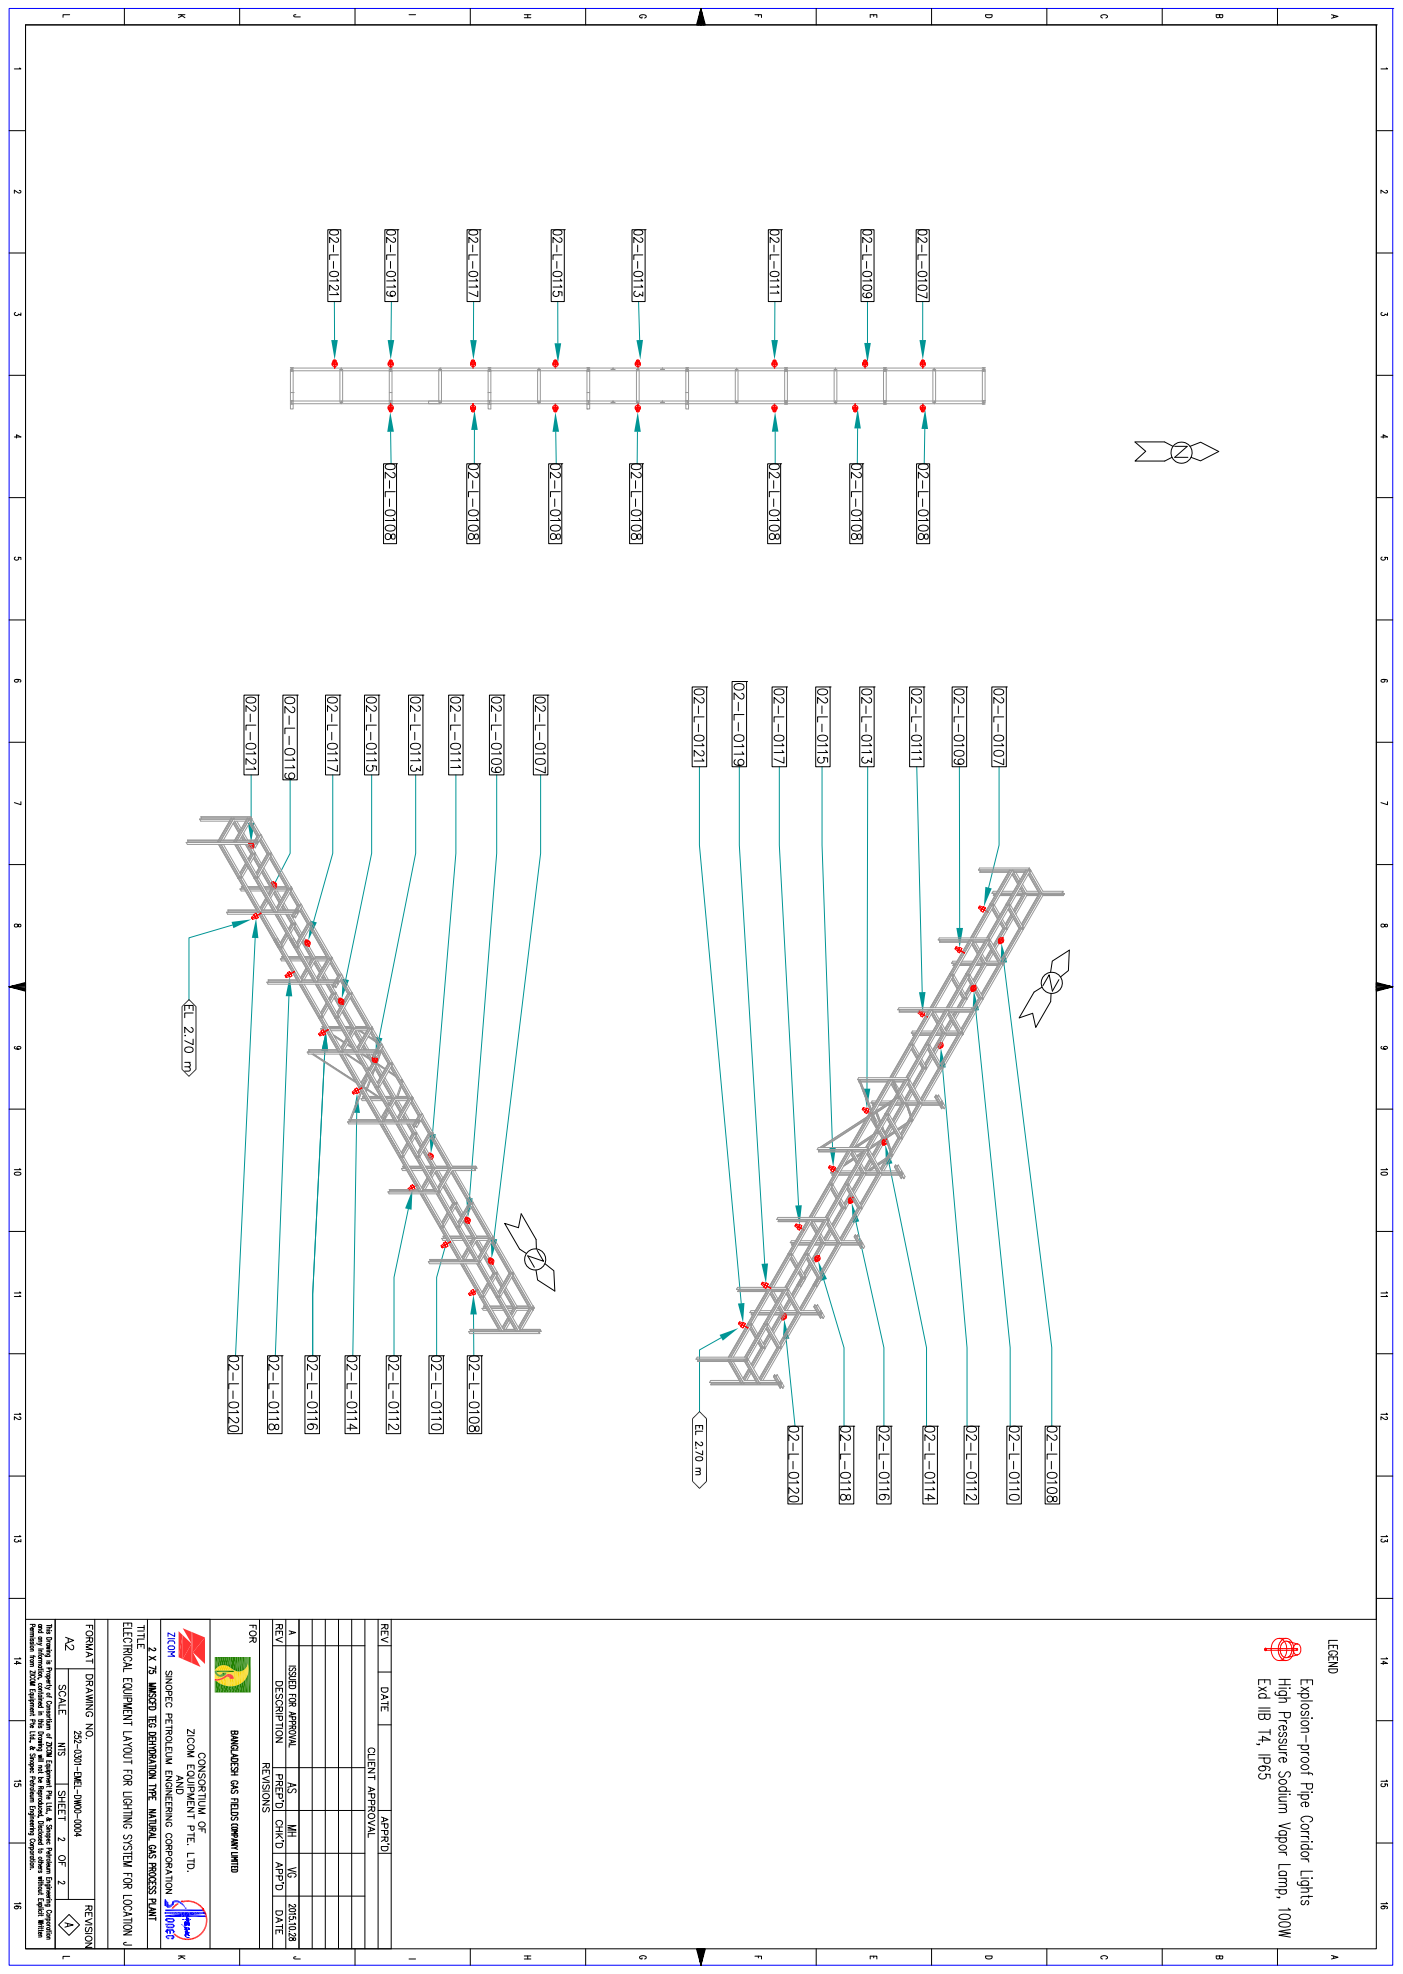
[picture p62: page 21]

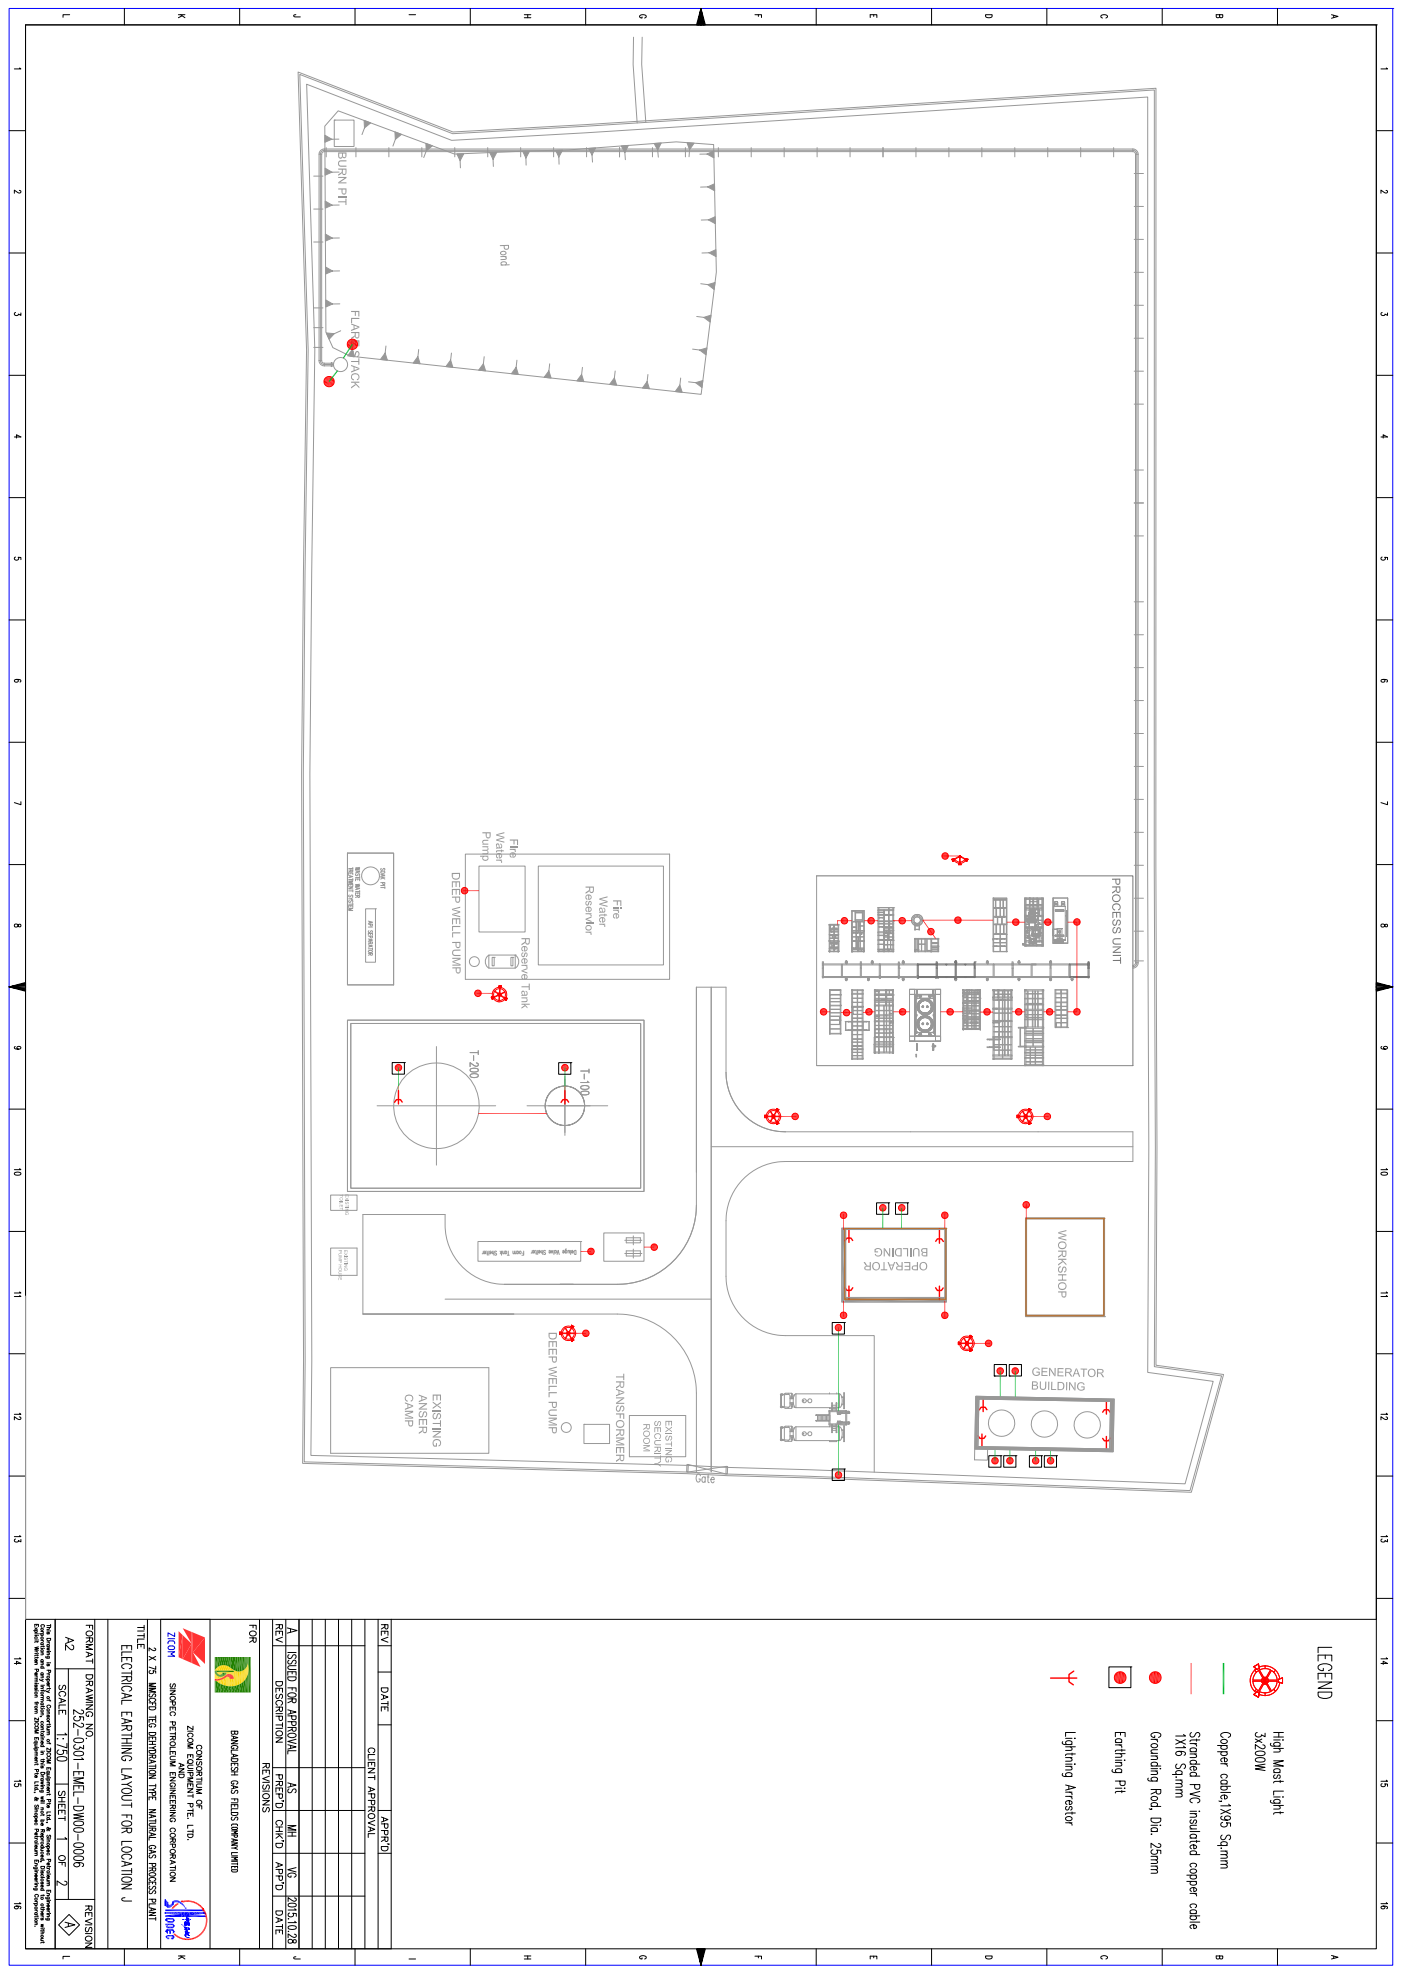
[picture p63: page 22]

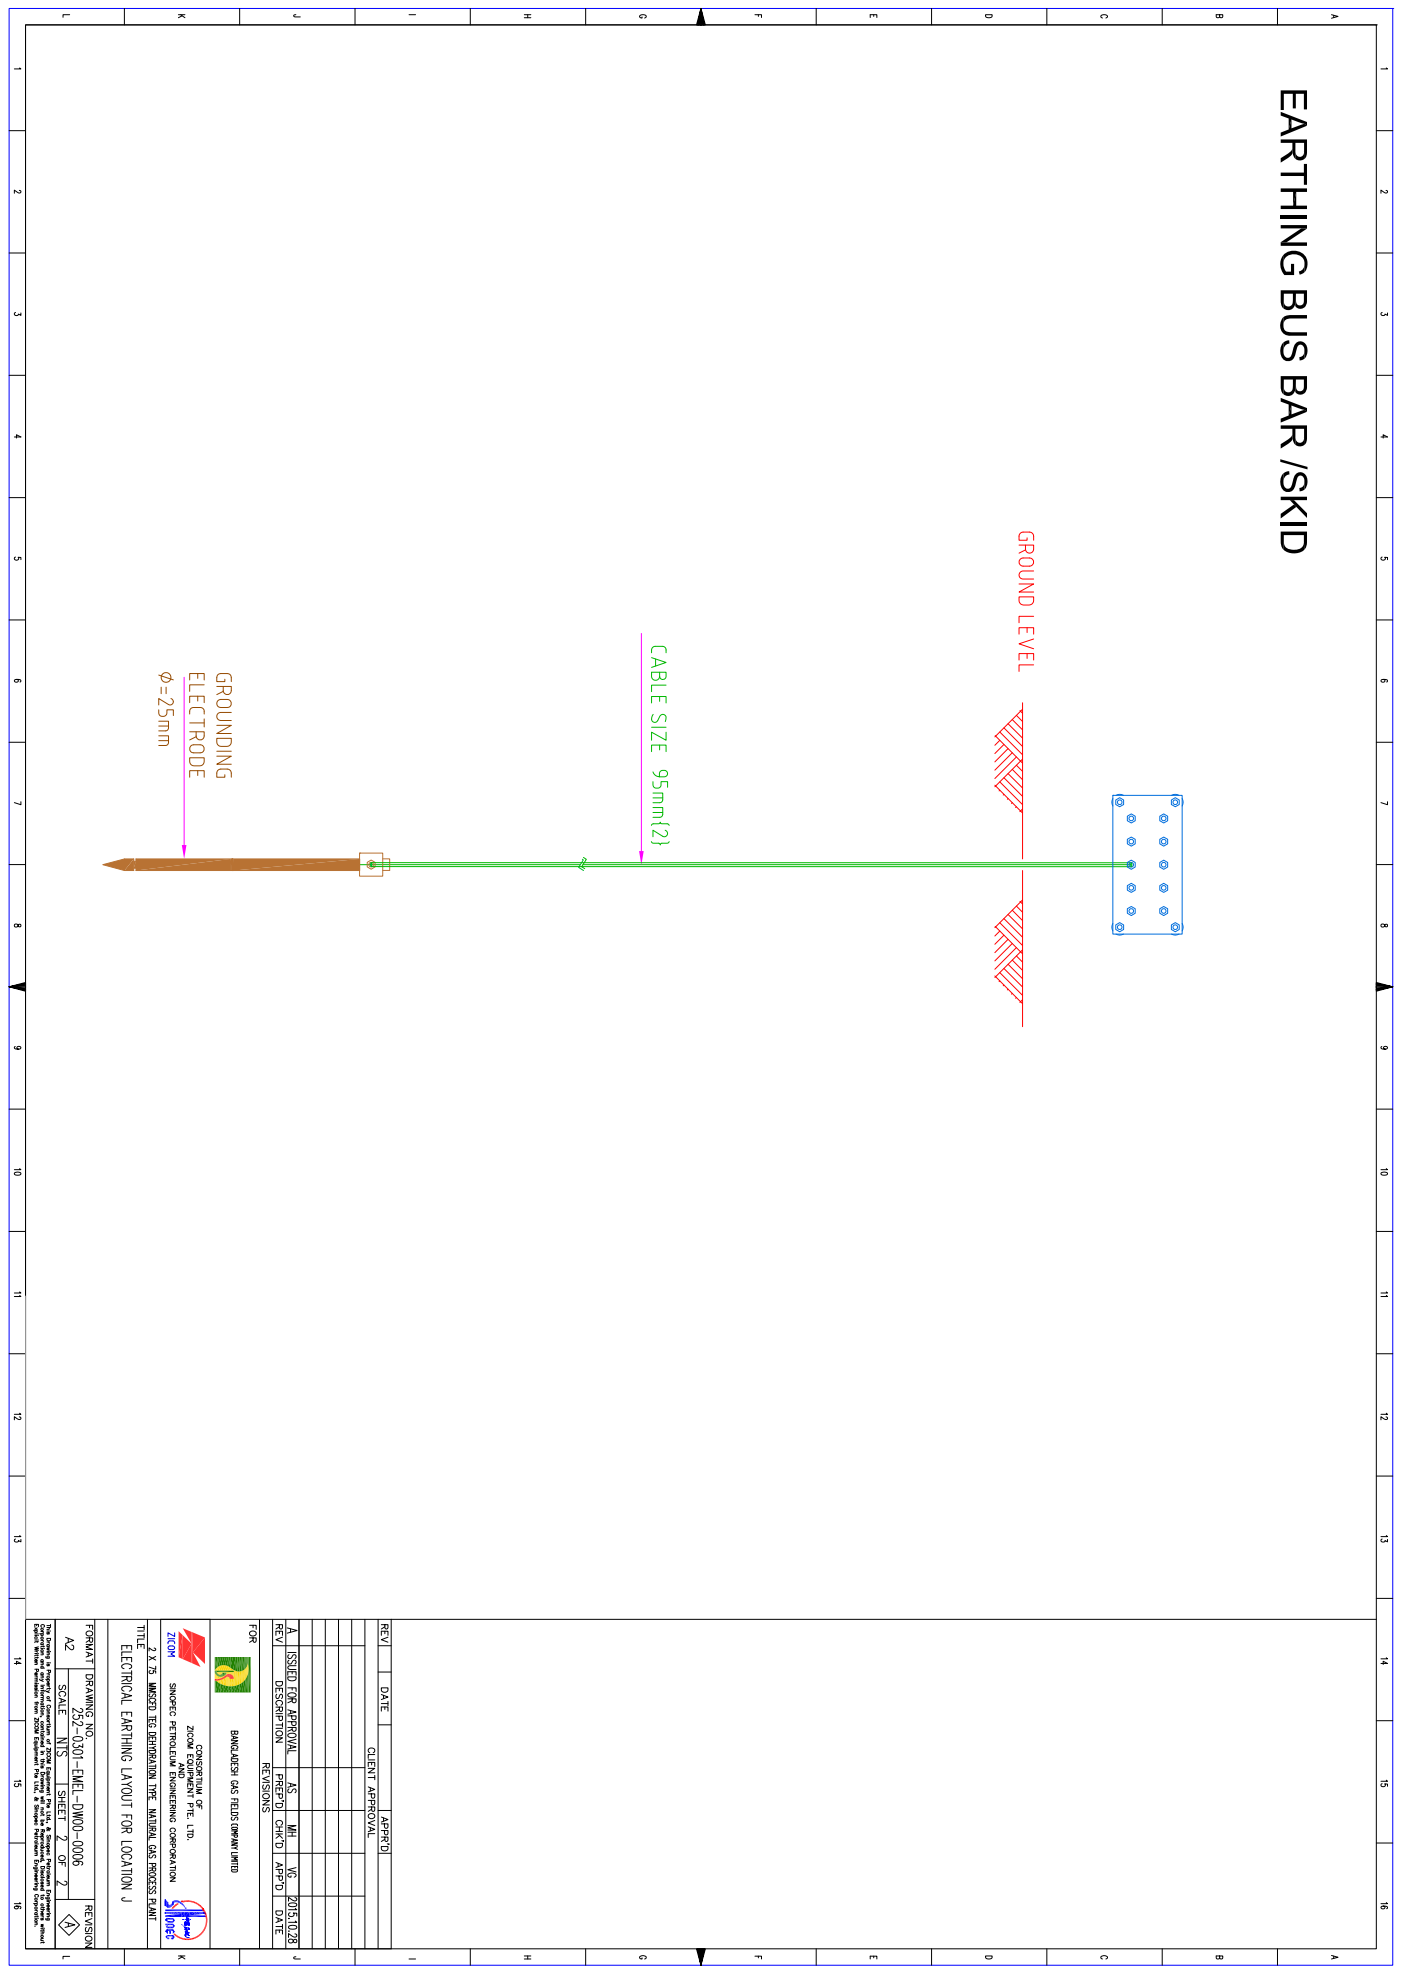
[picture p64: page 23]

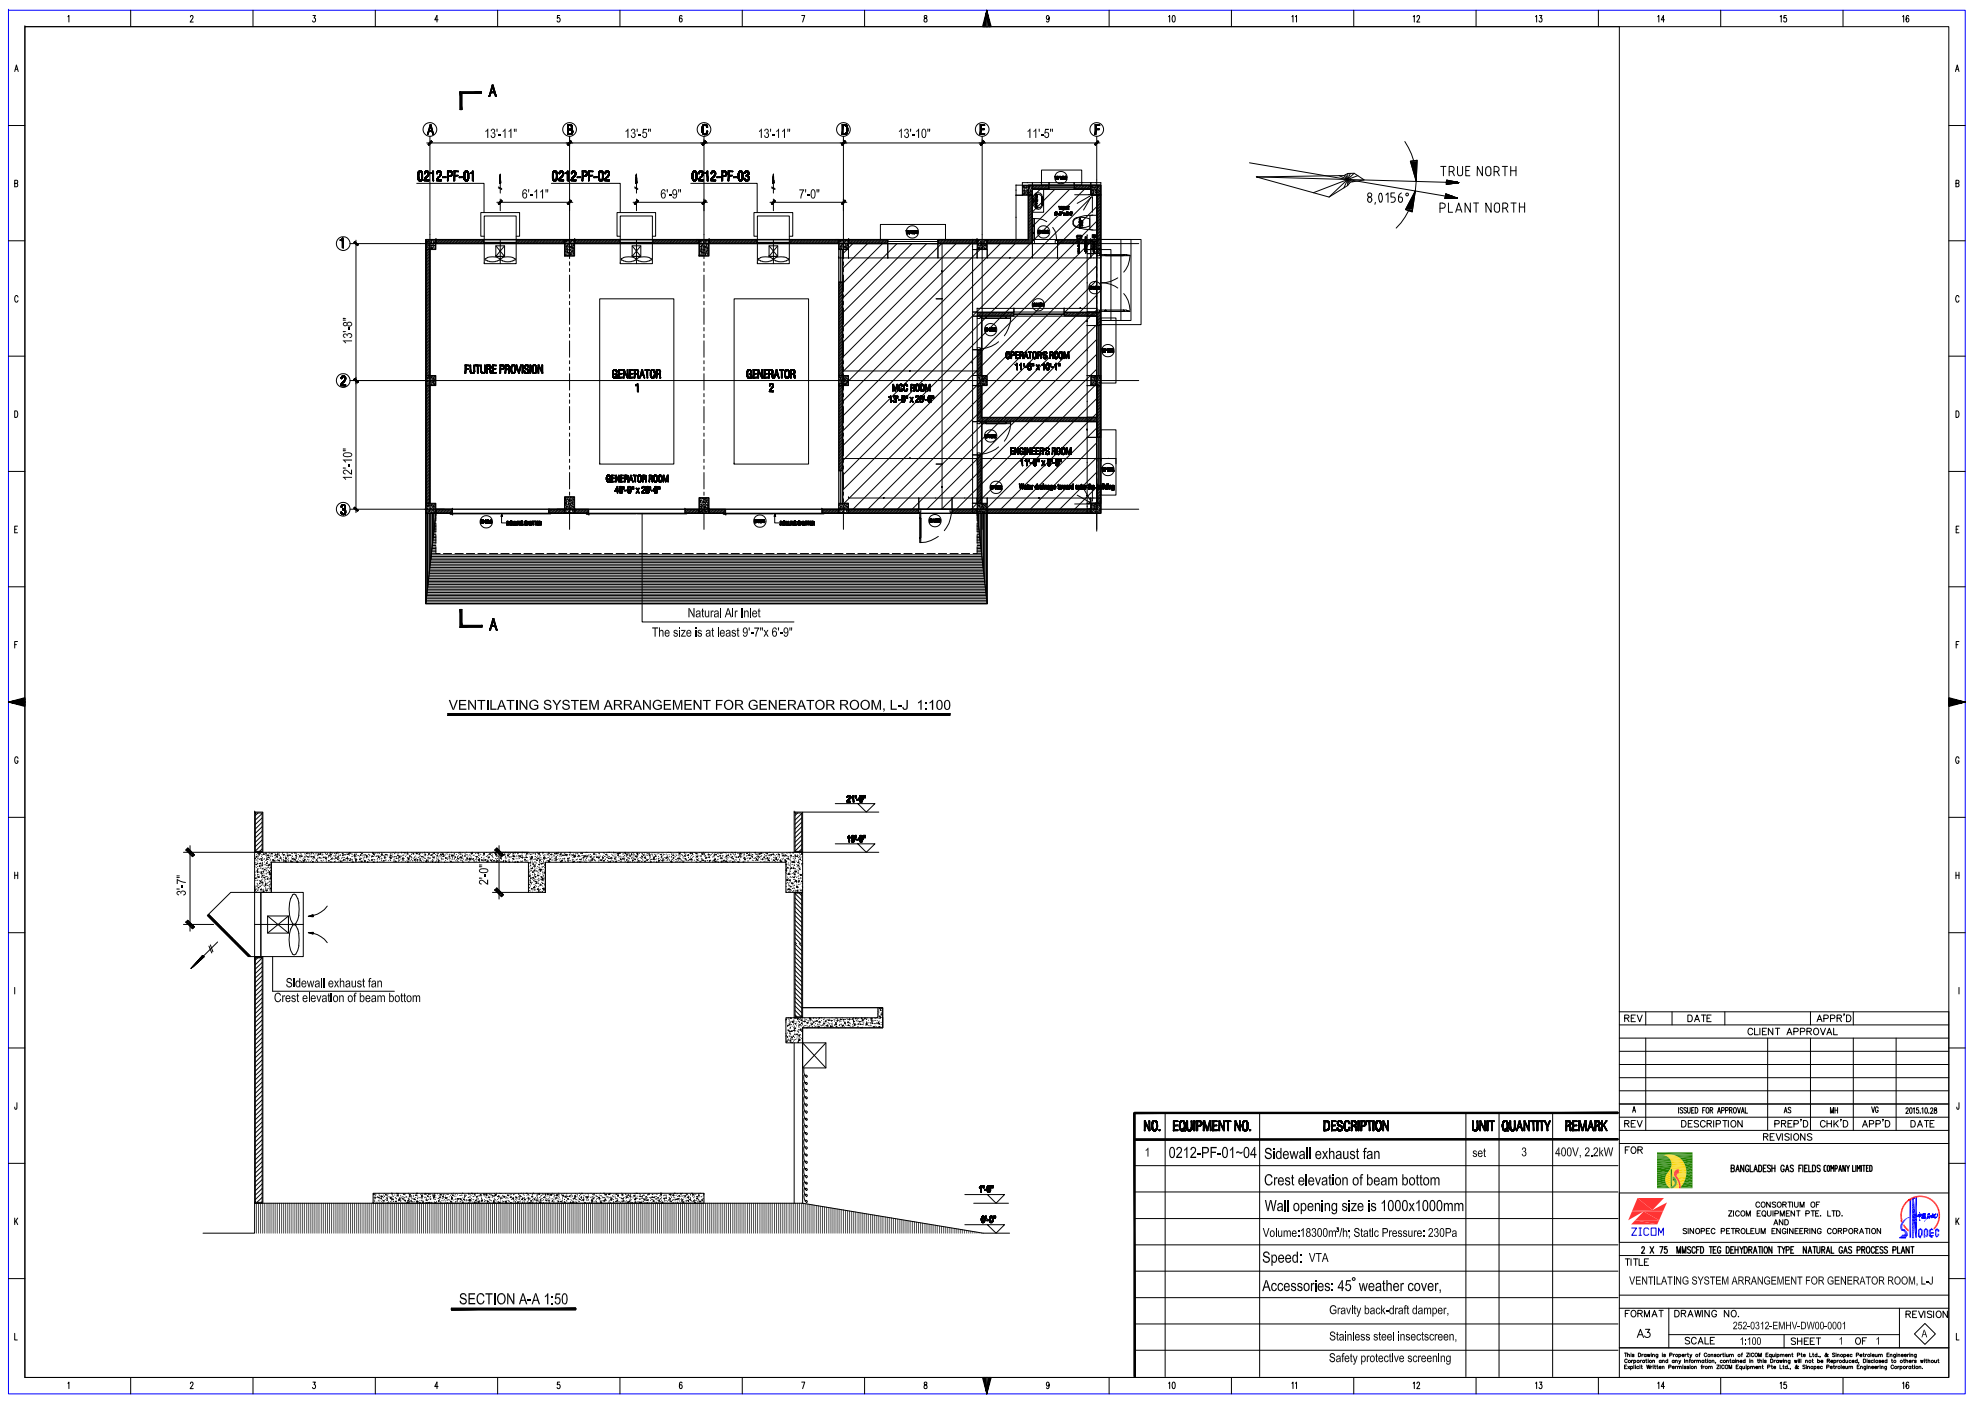
[picture p65: page 24]

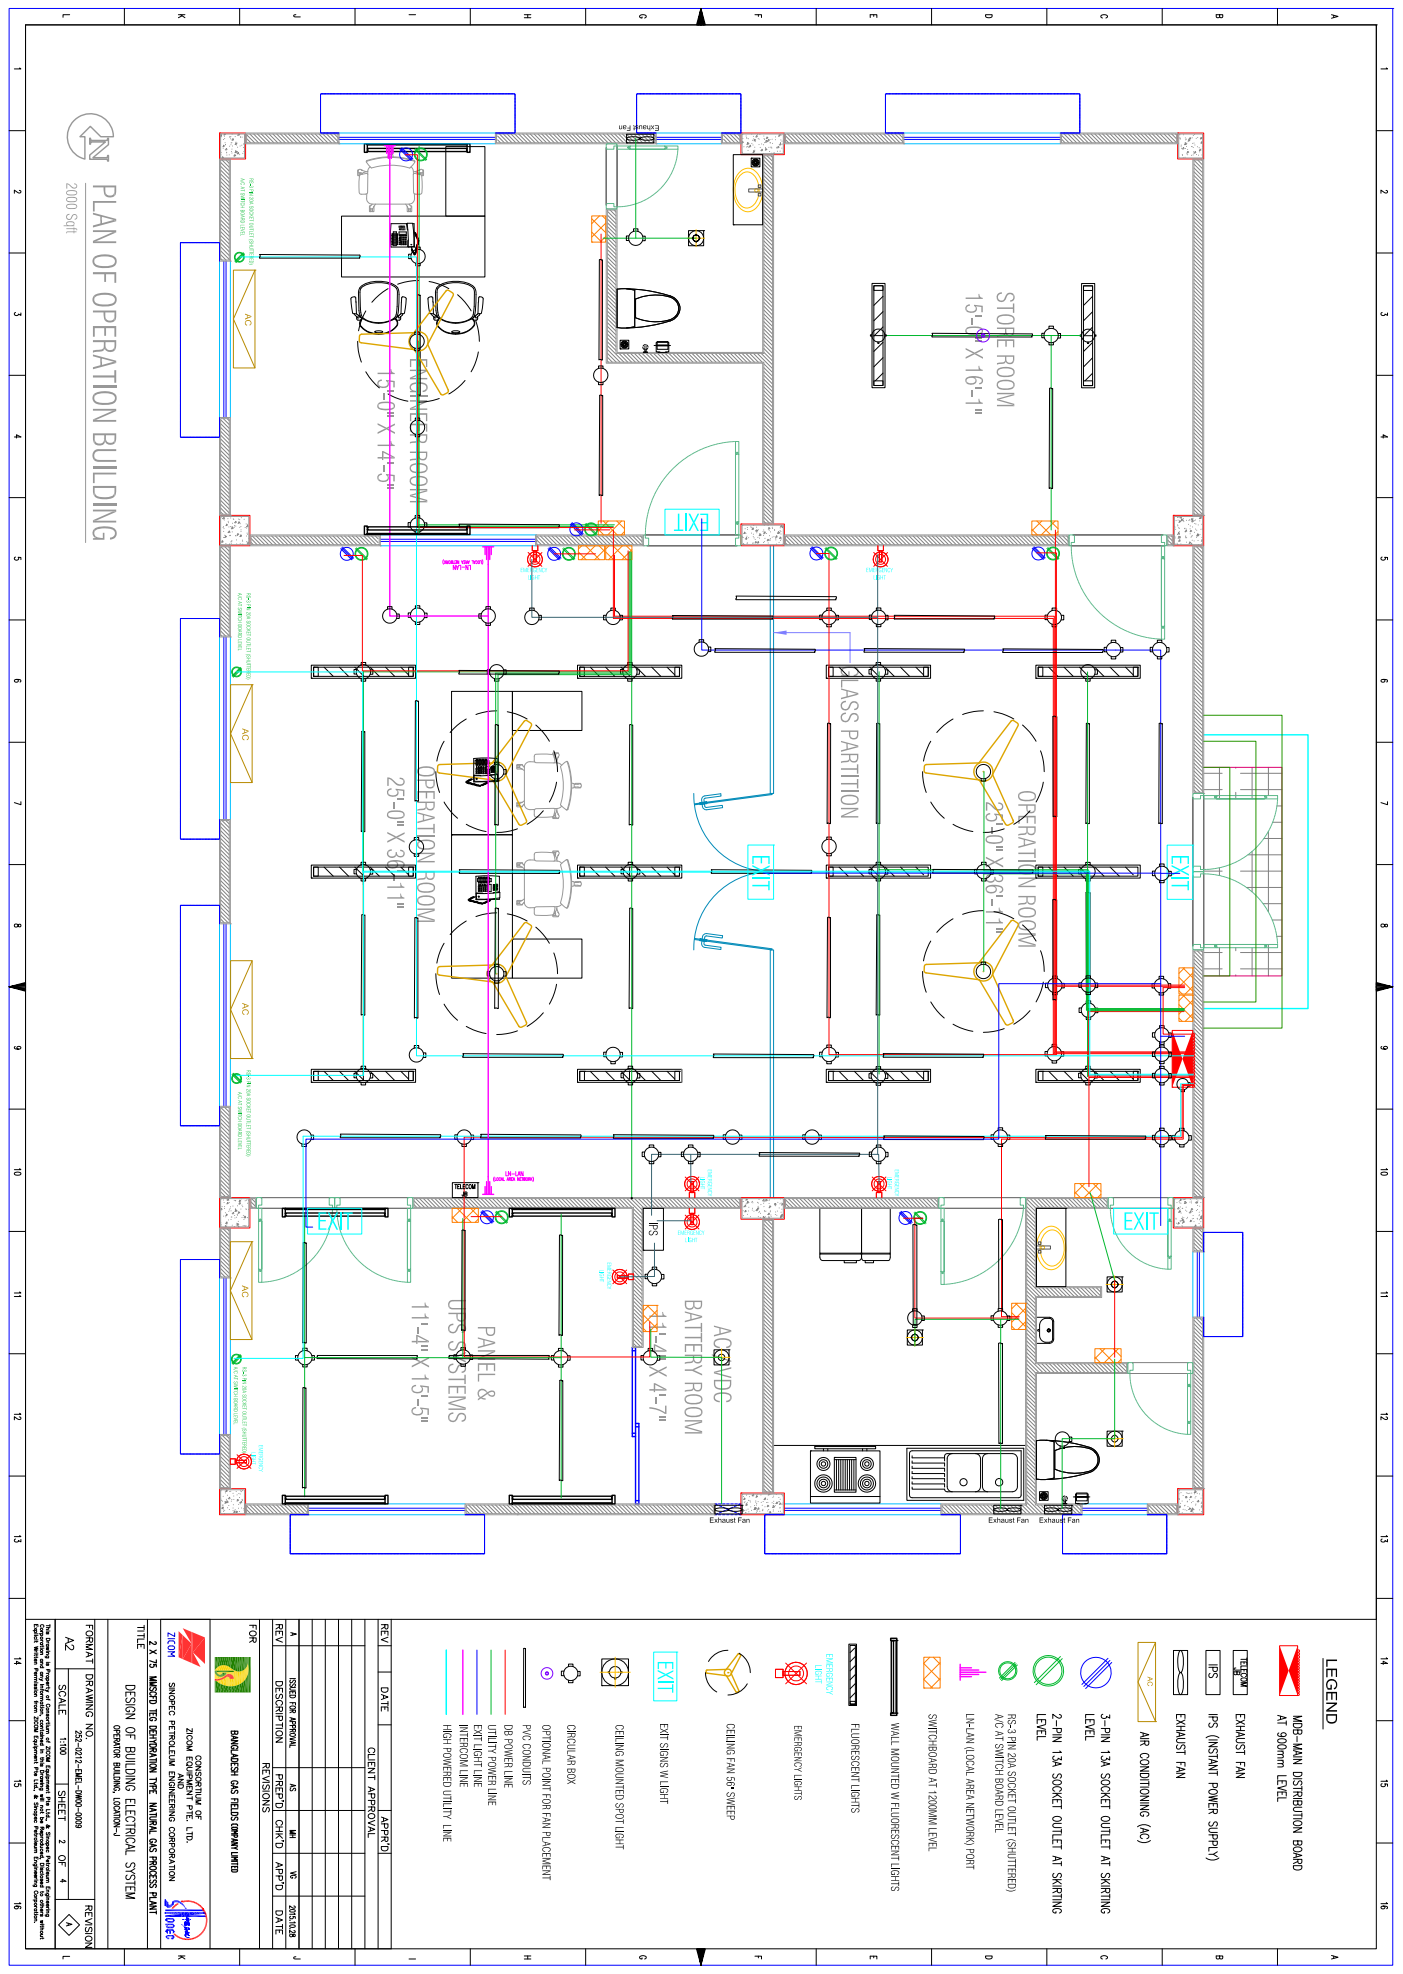
[picture p66: page 25]

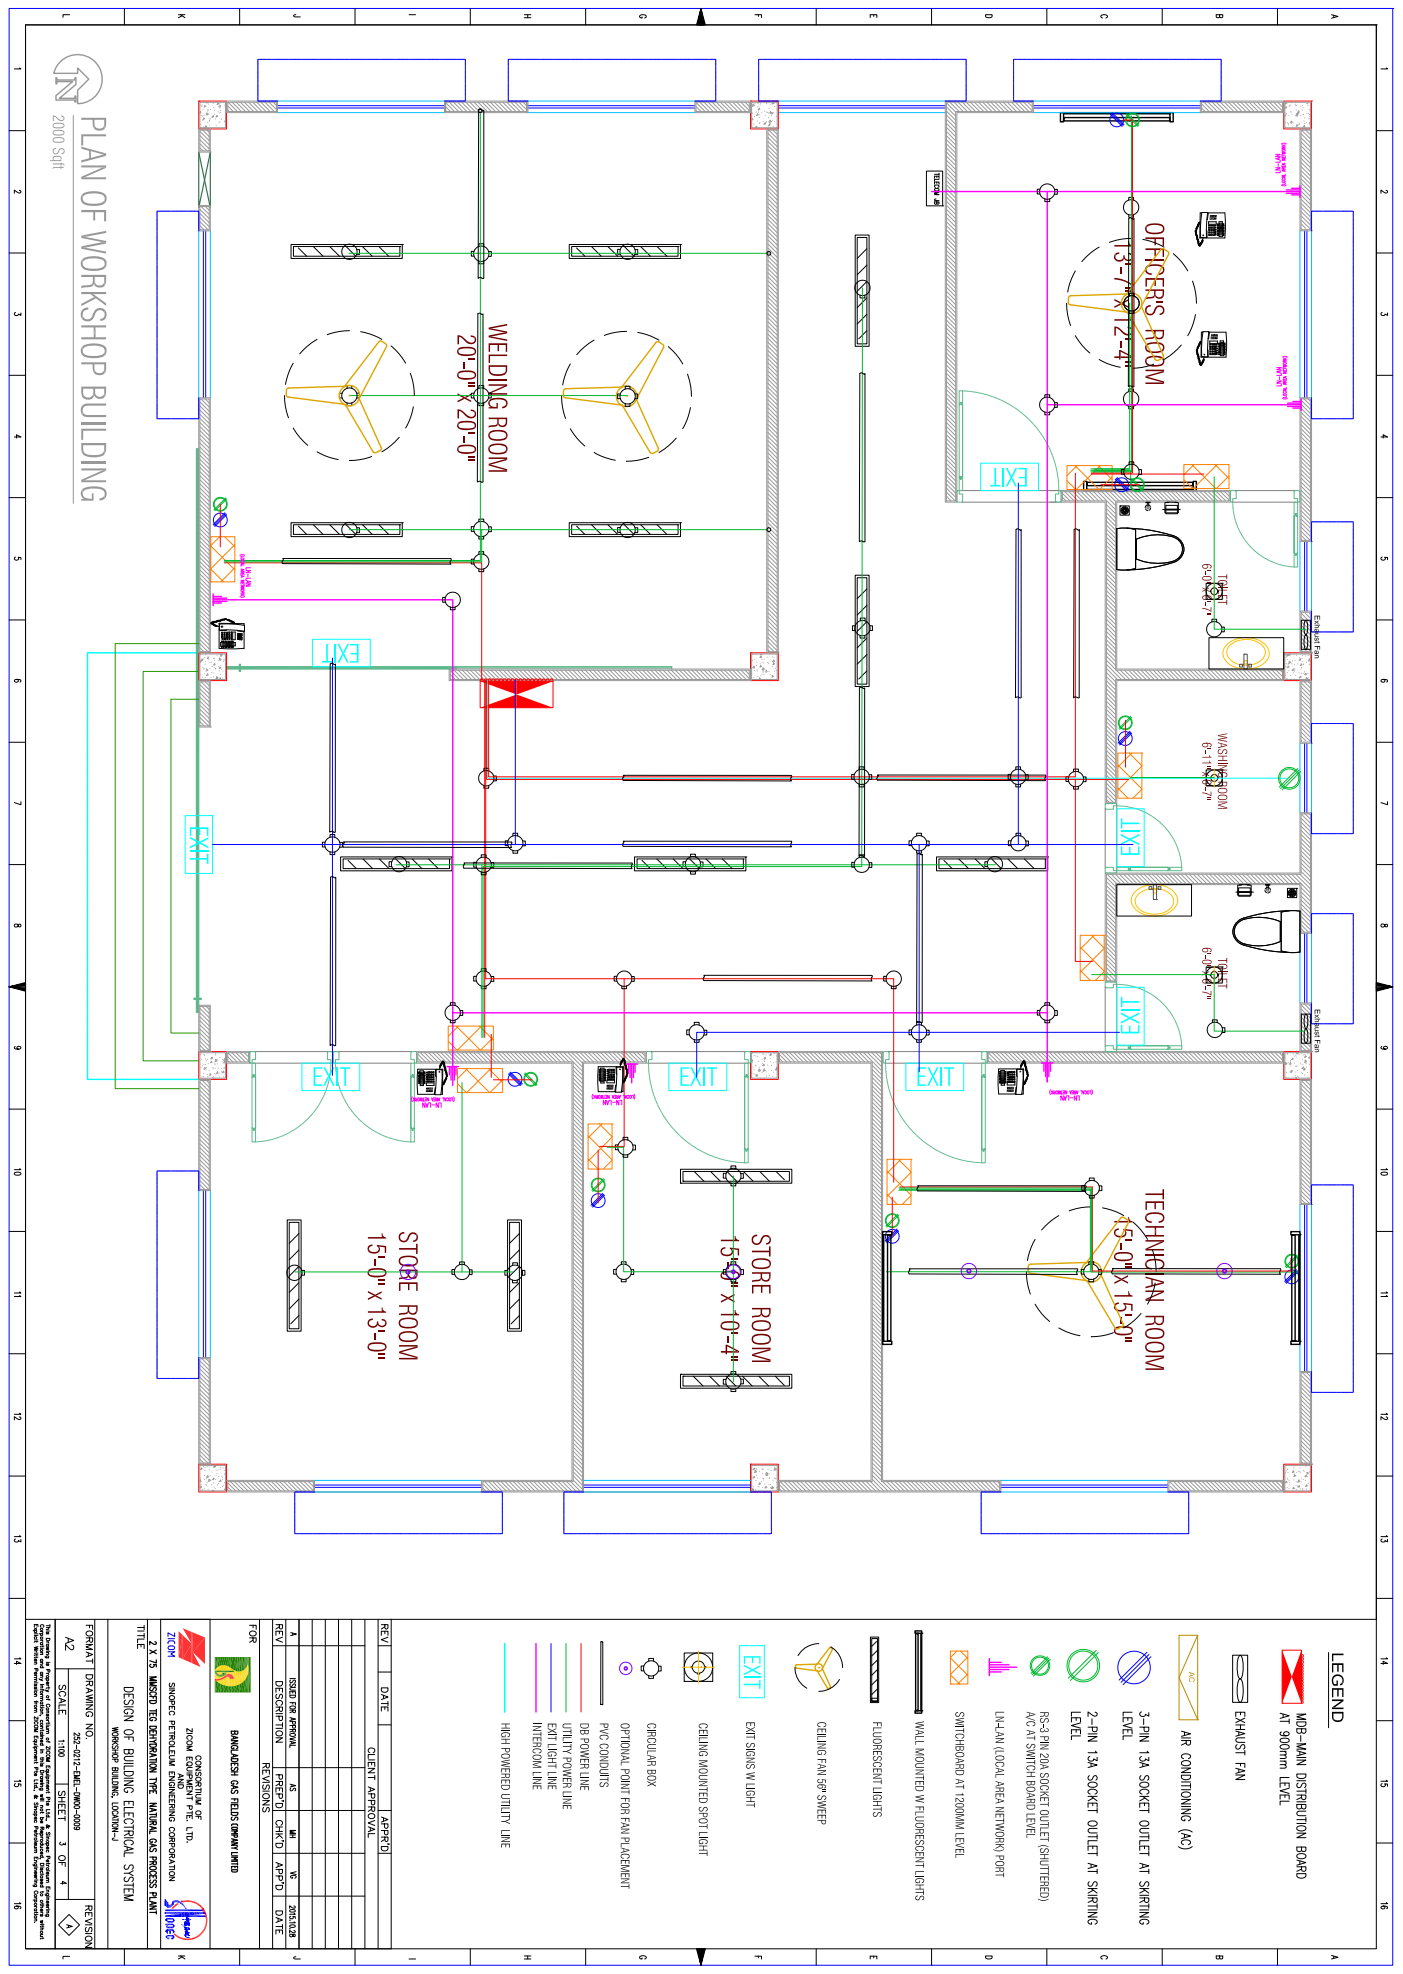
[picture p67: page 26]
