skdzicombd/P_252_Documentation/Location I/HVAC for Generator Room/252-0212-EMHV-DW00-0001_RevA - Ventilating System Arrangement for Generator Room, Location-I.pdf

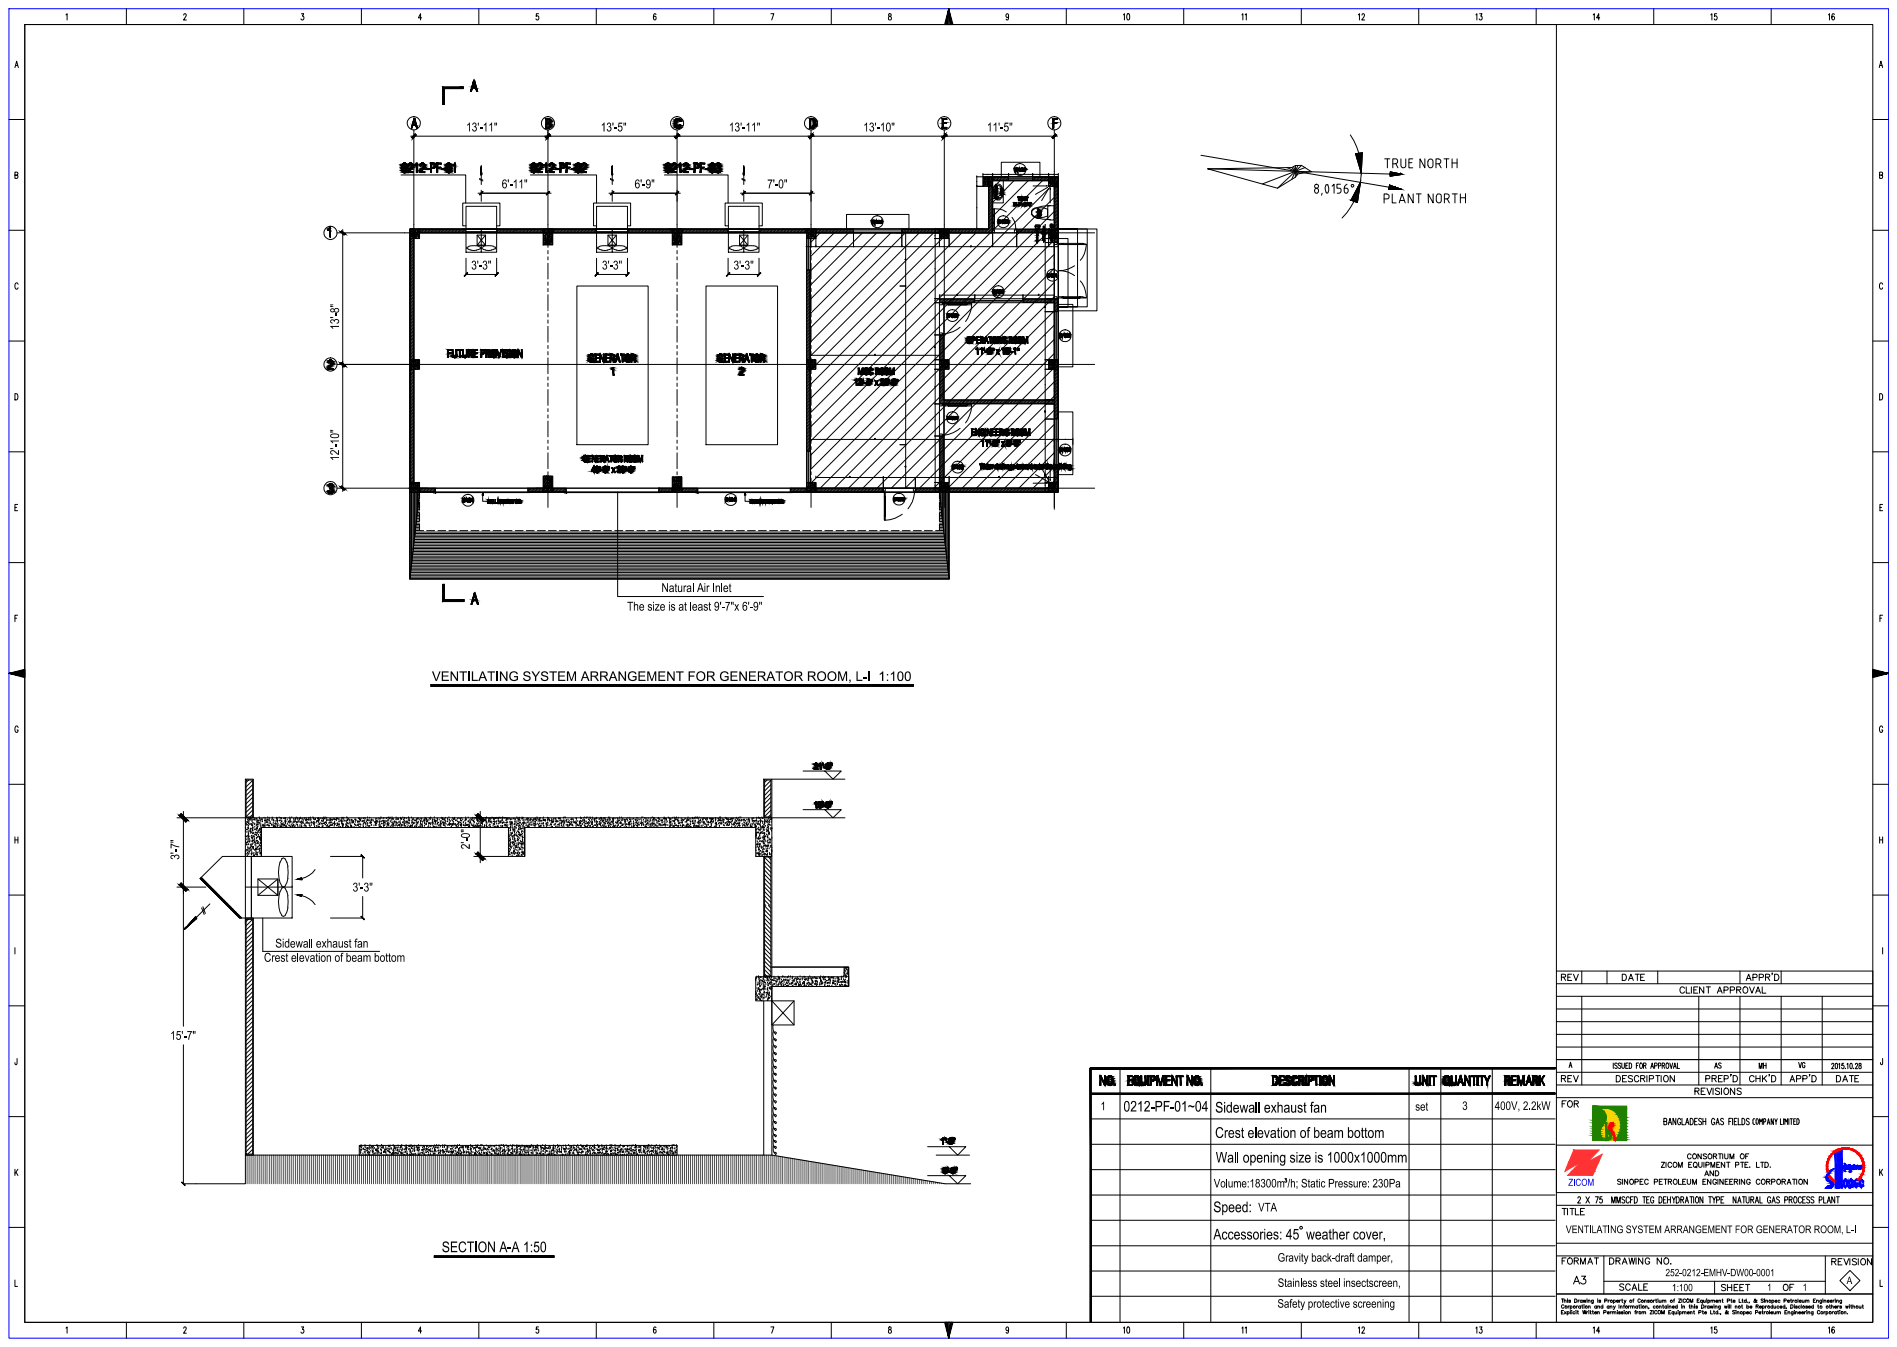
[picture p68: page 1]
