skdzicombd/P_252_Documentation/Location J/HVAC for Generator Room/252-0312-EMHV-DW00-0001_RevA - Ventilating System Arrangement for Generator Room, Location J-Model.pdf

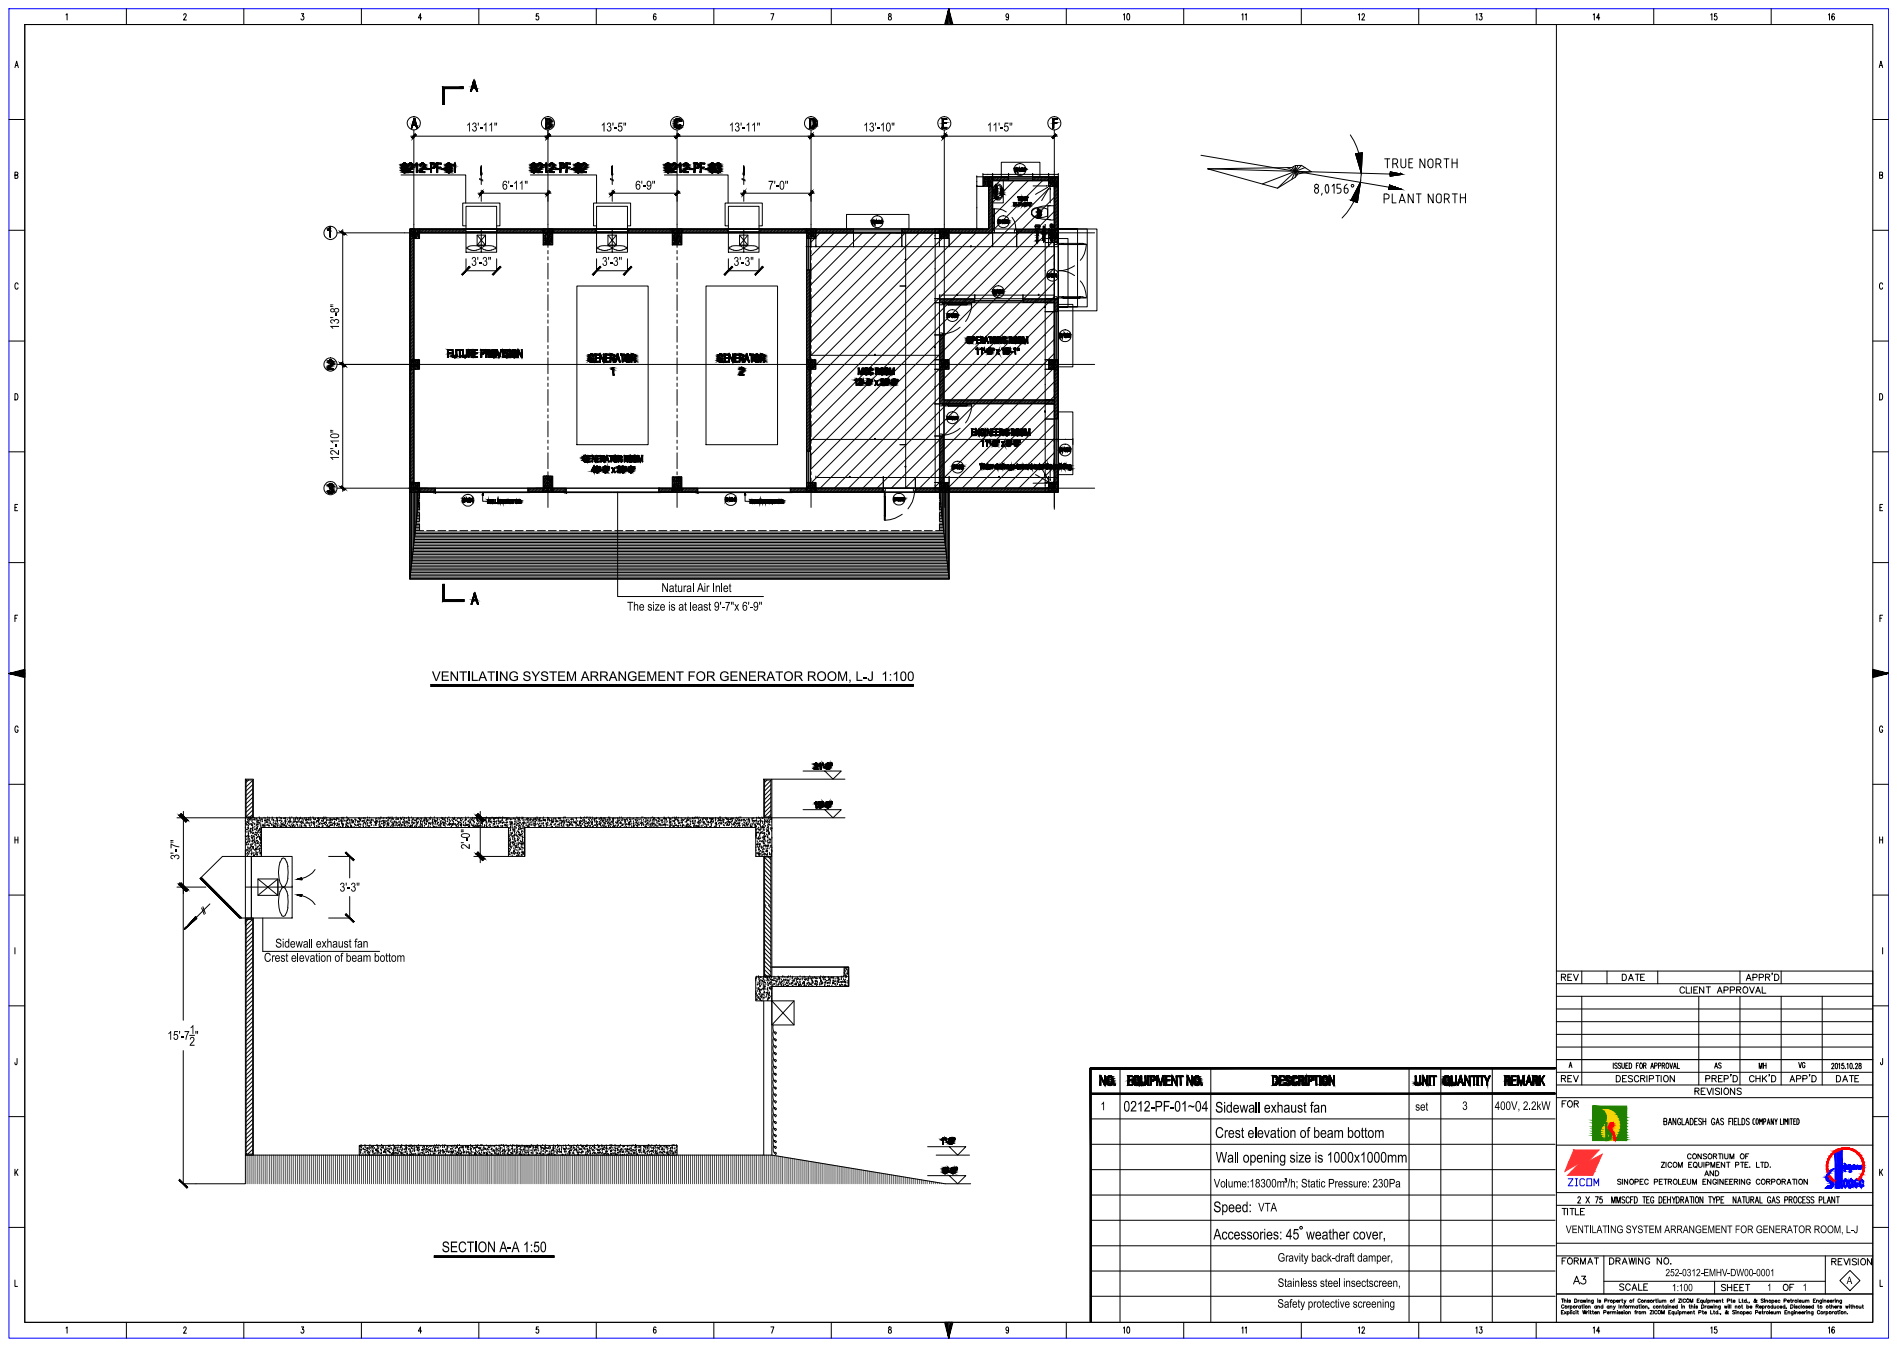
[picture p69: page 1]
