skdzicombd/P_252_Documentation/(commit log)

2015-11-22 Uploaded P_252 Documentation
    All updated drawings and datasheet
    [252-0101-EMEL-DS00-0003 Datasheet location I.xlsx, 252-0101-EMEL-DS00-0003 Datasheet location J.xlsx, 252-0201-EMEL-DW00-0001-A ELECTRICAL CABLE TRAY LAYOUT FOR LOCATION I.dwg, 252-0201-EMEL-DW00-0002-A ELECTRICAL CABLE ROUTE LAYOUT FOR LOCATION I.dwg, 252-0201-EMEL-DW00-0004-A ELECTRICAL EQUIPMENT LAYOUT FOR LIGHTING SYSTEM.dwg, 252-0201-EMEL-DW00-0006-A ELECTRICAL EARTHING LAYOUT FOR LOCATION I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]
2015-11-25 Added Design of Electrical System Drawings
    Added the Electrical system designs for all buildings in the project for
    both locations.
    [252-0212-EMEL-DW00-0009_RevA - Design of Building Electrical System, Location I.dwg, 252-0212-EMEL-DW00-0009_RevA - Electrical Wiring Diagram for Operator Building Location J.dwg, 252-0212-EMEL-DW00-0009_RevA - Electrical Wiring Diagram for Workshop Building, Location J.dwg, 252-0212-EMEL-DW00-0009_RevA - Electrical Wiring Diagram for Workshop Location I.dwg, 252-0212-EMEL-DW00-0009_RevA - Electr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]
2015-11-25 Added Datasheet and Separated them
    [252-0214-EMEL-CS00-0001 GENERATOR SIZING_LOCATION I.xlsx, 252-0214-EMEL-CS00-0008 FAULT LEVEL CALCULATION_LOCATION I.xlsx, 252-0314-EMEL-CS00-0001 GENERATOR SIZING_LOCATION J.xlsx, 252-0314-EMEL-CS00-0008 FAULT LEVEL CALCULATION_LOCATION J.xlsx, 252-0401-EMEL-DS00-0004 DATASHEET FOR LCS_Location I.xlsx, 252-0401-EMEL-DS00-0004 DATASHEET FOR LCS_Location J.xlsx, 252-0401-EMEL-DS00-0007 LIGHT DATAS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]
2015-11-25 Added BOQ for cables which was submitted to Romel Bhai
    [Cable P-252 I&J Electrical BOQ.xlsx]
2015-11-25 Generated PDF for all Drawings and Fixed The Names
    Done by Saimoon :P
    [252-0201-EMEL-DW00-0001-A ELECTRICAL CABLE TRAY LAYOUT FOR LOCATION I.dwg, 252-0201-EMEL-DW00-0001_RevA - Electrical Cable Tray Layout for Location I.dwg, 252-0201-EMEL-DW00-0002-A ELECTRICAL CABLE ROUTE LAYOUT FOR LOCATION I.dwg, 252-0201-EMEL-DW00-0002_RevA - Electrical Cable Route Layout for Location I.dwg, 252-0201-EMEL-DW00-0004-A ELECTRICAL EQUIPMENT LAYOUT FOR LIGHTING SYSTEM.dwg, 252-0201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]
2015-11-30 Generated PDFs Load Distribution
    [252-0212-EMEL-DW00-0009_RevA - Design of Building Electrical System for Operator Building Location J.dwg, 252-0212-EMEL-DW00-0009_RevA - Design of Building Electrical System for Workshop Building, Location J.dwg]
2015-12-24 Added BOQ for both I&J
    Submitted Document to Romel Bhai on 20.12.2015
    [P-252-I (E&I BOQ) 20.12.15 .xlsx, P-252-I CABLE SIZING & BOQ 17.11.15.xlsx, P-252-J (E&I BOQ) 20.12.15.xlsx, P-252-J CABLE SIZING & BOQ 17.11.15.xlsx]
2015-12-28 Corrected the drawing name and Added Building Electrical Systems design
    Fixed the name for cable route design and added the building electrical
    systems design that have been recently approved
    [252-0201-EMEL-DW00-0002_RevA - Electrical Cable Route Layout for Location I.dwg, 252-0212-EMEL-DW00-0009_RevA - Design of Building Electrical System for Operator Building Location J.dwg, 252-0212-EMEL-DW00-0009_RevA - Design of Building Electrical System for Workshop Building, Location J.dwg, 252-0212-EMEL-DW00-0009_RevA - Design of Building Electrical System, Location I.dwg, 252-0212-EMEL-DW00-0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]
2016-01-05 Added Building Fire System Details
    Added 1 autocad drawing and BOQ
    [P-252 Fire Detection and Alarm System.dwg, P252 -BOQ.xlsx]
2016-01-10 Fixed the error in the UPS SLD (Drawring Name) and Added recently send Generator and UPS Room Electrical Equipment Layout
    [252-0212-EMEL-DW00-0004_RevA - Single Line Diagram for UPS System, Location I.dwg, 252-0212-EMEL-DW00-0005_RevA - Electrical Equipment Layout for Generator Room for Location I.dwg, 252-0212-EMEL-DW00-0006_RevA - Electrical Equipment Layout for UPS Room for Location I.dwg, 252-0312-EMEL-DW00-0005_RevA - Electrical Equipment Layout for Generator Room for Location J.dwg, 252-0312-EMEL-DW00-0006_RevA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]
2016-01-12 Corrected drawing no. and names in accordance to Document Controller Recommendations
    [252-0212-EMEL-DW00-0001 & 252-0212-EMEL-DW00-0002_RevA - Single Line Diagram for MCC, Location I.dwg, 252-0212-EMEL-DW00-0003_RevA - Single Line Diagram for Plant Lighting, Location I.dwg, 252-0212-EMEL-DW00-0004_RevA - Single Line Diagram for UPS System, Location I.dwg, 252-0212-EMEL-DW00-0009_RevA - Design of Building Electrical Systems for Generator Building, Location I.dwg, 252-0212-EMEL-DW00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]
2016-01-17 Adjusted cable trench layout as par site changes
    [252-0212-EMEL-DW00-0006_RevA - Electrical Equipment Layout for UPS Room for Location I.dwg, 252-0301-EMEL-DW00-0001_RevA - Electrical Cable Tray Layout for Location J.dwg, 252-0301-EMEL-DW00-0002_RevA - Electrical Cable Route Layout for Location J.dwg, 252-0312-EMEL-DW00-0005_RevA - Electrical Equipment Layout for Generator Room for Location J.dwg, 252-0312-EMEL-DW00-0006_RevA - Electrical Equipm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]
2016-01-19 Minor changes
    [252-0312-EMEL-DW00-0005_RevA - Electrical Equipment Layout for Generator Room for Location J.dwg]
2016-01-19 Added Electrical Junction Box Layout Drawing for Location J only
    Contains an Autocad file layout for the plant Junction Box Positions for
    Location J
    [252-0301-EMEL-DW00-0009_RevA - Electrical Junction Box Layout for Location J.dwg]
2016-01-19 Cleaned Up some Backup Files
    [252-0301-EMEL-DW00-0009_RevA - Electrical Junction Box Layout for Location J.dwg]
2016-01-23 Updated Cable Trench Layout for Location I
    [252-0201-EMEL-DW00-0001_RevA - Electrical Cable Tray Layout for Location I.dwg]
2016-01-23 Updated Cable Trench for Building and Plant Layout
    [252-0201-EMEL-DW00-0001_RevA - Electrical Cable Tray Layout for Location I.dwg, 252-0212-EMEL-DW00-0005_RevA - Electrical Equipment Layout for Generator Room for Location I.dwg, 252-0212-EMEL-DW00-0006_RevA - Electrical Equipment Layout for UPS Room for Location I.dwg]
2016-01-24 Rescaled the HVAC drawings and Minor Changes
    [252-0201-EMEL-DW00-0001_RevA - Electrical Cable Tray Layout for Location I.dwg, 252-0212-EMEL-DW00-0005_RevA - Electrical Equipment Layout for Generator Room for Location I.dwg]
